sanchuanhehe/HSLink-LP/hardware/design/README.md

# HSLink-LP 硬件设计

打开 `HSLink-LP.kicad_pro`。唯一工作区基于固定 HSLink Pro 1.2.0 原图增改，参考仓库未修改；版本通过 Git 回溯。2026-11-14当前PCB全布线完成，完整DRC为0一般违规/0未连接/0parity；制造审阅数据含185个SMT位号和8个THT件，结构C已做当前模型检查。仍无生产放行或硬件验收；所选排线实际尺寸等缺项见[制造说明](../../docs/manufacturing.md)。

## 本次设计

- SW601 换为 Dailywell 2MD1T1B1M2QES-5；保留手动来源选择与第二极状态输入。
- VIO 改为 TLV75801 + MCP4726，删除第二套 TPS63811 与电感；主目标可调供电现用 TPS63810YFFR + TPS22950CDDCR。
- 仅保留K601一颗HFD2/005-S：COM接DUT、NO接来源、NC经1k及Q902放电。Vref采用DG2012EDL-T1-GE3，删除K901/Q901/D901和DUT_OUT分压/ADC连接；开关由USB供电。见[优化说明](../../docs/sense-discharge.md)。
- 删除 ADG4612 及其 12 V 升压电路；数字信号仍为四颗 FSA2466。
- 删除不再需要的 TCA9543A 及支路上拉，四个不同地址的 I2C 从设备直接共享总线；VIO DAC 使用 MCP4726A0T-E/CH。
- 本轮换用 Sunlord 三颗电感、WUSB3801、TPS7A2036、1206 输出电容及准确连接器；见 [JLC 设计检查](../../docs/jlc-design-review.md)与[物理引脚表](../../docs/jlc-pinmap.md)。
- 当前原理图204个电气位号（193采购件+11裸铜测试焊盘）；采购件沿用2026-11-07核价快照，板上材料¥124.9924/板；加配套排线¥128.8354/套、10套¥1,288.3540。见[成本](../../docs/cost.md)。
- J801改带键ARM20，nTRST第3针、nRESET第15针，删除J802；VTref/所有目标信号的隔离保留，供电走独立J602。见[接口说明](../../docs/arm20-interface.md)。
- 按用户确认采用 12 颗 SN74LVC1T45DBVR，SOT-23-6；24 颗去耦、13 颗偏置，删除旧 OE 与未用通道。40 MHz 保持待实测，见 [实施说明](../../docs/level-translation.md)。

新增供电、检测页按功能重新分组，器件位号／数值置于主体外，全局标签接短支线，检查两种字体下的实际图面。主控、晶振、启动／复位、主控电源与去耦仍沿用上游布局；34 个符号单元（33 个物理位号）位置和旋转与已记录的上游映射一致。

## 阅读顺序

| 页 | 文件 | 电路 |
|---|---|---|
| 1 | HSLink-LP | 主控、晶振、恢复接口和子页入口 |
| 2 | Power | 上游主控电源、USB 辅助 3.3/3.6 V |
| 3 | Interface | USB-C、CC、ESD、输入限流 |
| 4 | LogicTranslation | 电平转换与开漏复位 |
| 5 | Control | I2C GPIO、共享总线与默认下拉 |
| 6 | Safety | 硬件禁能与放电驱动互锁 |
| 7 | TargetPower | 内置可调输出、DAC/LDO VIO、来源选择、输出继电器 |
| 8 | Disconnect | FSA2466、调试和双串口目标接口 |
| 9 | Sense | 单通道模拟开关隔离Vref检测、受控放电 |

## 测试点

2026-11-12新增TP2～TP11，服务VIO外部校准、电源/故障和互锁时序；TP1保留。高速与目标侧敏感网络复用现有焊盘/接口，不增加长探测支线。原有连接保持，ERC 0错误/0告警；PCB已同步并手工连接10个新增点的局部端点；拆盖后D2mm探测包络无器件干涉，实际探头/装配公差仍待验证。详见[测试点规划](../../docs/test-points.md)和[板上特征表](../bom/pcb-features.csv)。

## 文件验证

2026-11-07 已原地统一为 **KiCad 10**：9 页原理图、2 个本地符号库、6 个本地封装完成原生格式检查/升级。转换前后完整网表一致，ERC 均为 **0 错误、0 告警**；九页图形、文字位置及样式不变。BOM、连接意图和上游参考未改。详见[格式转换记录](../../docs/kicad-integration.md#kicad-10-原生格式统一2026-11-07)及[验证摘要](../validation.json)。以下保留此前电路修改的检查记录；格式转换不关闭既有电气与实板验证问题。

2026-11-07：MCP最终ERC **0错误、0告警**，未增加忽略项。194物理位号、117连接网络、675连接引脚、45个独立NC与预先定义意图一致；58行BOM的位号、MPN、封装与10套阶梯金额已查。

基线8fb837e逐项变换：删除K901/Q901/D901/R55/R56/C62及ADC_VOUT/VOUT_SENSE_IN/SENSE_COIL_LO；U1.26标NC；新增U901和C901。DUT_VREF仅J801.1→U901.5，NO→整个68k/68k/1n采样；NC悬空。DUT_OUT仅J602.1/K601.4。K601/Q902、FSA、ARM20及互锁其余引脚集合完全不变，非实板验收。

双字体PDF各九页；本轮人工查看主控根页和Sense页，修正新电源符号文字与线重叠；其余七张源图与基线字节一致。摘要/哈希见[validation.json](../validation.json)，证据在忽略目录`reports/vref-only-2026-11-07/`。无DUT_OUT实测回读，输出精度、掉压和放电完成只能由外部仪器验证。

器件、连接、库和字段通过已安装 MCP 修改。标准工具对项目库封装临时放置/回读和自由文字编辑的支持缺口由一次性 MCP 适配器补齐；客户端、适配器和缓存用后删除，常驻 MCP 服务未修改。

## 尚未完成

- U501已绑定按原厂图建立的15球YFF封装，0.4mm逃线/钢网/DFM仍待完成；L4 已绑定更大的 MWSA0603S 封装；原有 MCU、FSA、连接器等仍须完整物理映射与 PCB/DFM 审查。
- 来源开关FAQ支持BBM、系列Q触点3A/28VDC覆盖需求；完整-5料号时序与首板双极转换/浪涌仍待确认。P1→P2和第二极改线是未批准建议，本轮保留型号/接线。
- 继电器微小电流、2A温升、浪涌及含续流的释放/抖动待测；Q902栅极掉电瞬态与OFF漏电未验收，50ms仅切换待测初值。MEASURE由K601 NC机械隔离放电，OFF仅MOS关断。
- U901 COM掉电保护不等于零漏电：数据表最大1µA；中间供电斜坡与20/25/30°C实际状态待测。
- 140 nA整夹具目标（20～30°C）未闭合；FSA的25°C上限和已140 nA、全温表值保守和700 nA，另有U901/线束/PCB。USB掉电而目标仍供电的FSA保护不在首版支持范围，连接目标信号期间须保持USB供电。
- VIO电流预算、精度、启动过冲及热待测；TPS63810启动3.3V需隔离编程；R42已改806Ω±0.1%低成本打样方案，典型限流约1.487A，无该档厂家保证上下限；逐板持续1A/过载/短路/温升投用前必验。
- 20cm配套排线的手册绝缘下限5MΩ不足以保证0.14µA；40MHz与漏电待实测，失败须换线束。
- 独立板型、双 CDC、WUSB3801 驱动、真实 HID、DAC 时序及 MEASURE 锁定尚未实现。

MEASURE 保持目标供电，同时断开调试、复位、双 UART 握手、Vref、采样与放电支路；默认保持共地。ERC 通过不等于允许投板。

## 许可

上游 HPM5301 及晶体缓存符号保留在 `libraries/UpstreamCache.kicad_sym`，原 Apache-2.0 许可保留为 `libraries/HSLink-upstream-LICENSE`。未修改 `hardware/reference/`。

2026-11-07边界同步：修正Power/Control/Disconnect三处旧说明，并补充连接目标信号时保持USB供电。重新导出网表/ERC及图面，电气连接未变；140nA、R42和VIO余量仍未验收。见[设计说明](../../docs/electrical-margins.md)。

VIO当前使用USB_5V→TLV75801，反馈10k/2.15k/15.4k；保持DAC和封装，逐板外部校准、±1%目标待验收。见[余量说明](../../docs/electrical-margins.md)。

## 2026-11-12布局重整

183个封装移动/旋转，保留全部逻辑焊盘网络；原生PCB/原理图一致性为0问题。完成关键电源与USB手工路径、安装孔禁布区、接口针序/极性丝印及结构装配模型。原理图ERC为0；PCB一般违规项列表为空，但另有399条未连接报告项，仍不可投板。见[布局约束](../../docs/pcb-layout.md)和[结构样件](mechanical/README.md)。

## 接口与测试点PCB继续整理

在上述布局基线上再调整96个已有封装，前沿从左至右为ARM20、UART A、UART B、DUT电源；调试和两组串口转换器按功能分组、去耦对齐。新增TP2～TP11及局部手工走线，当前211个封装（204个电气位号、4安装孔、3基准点）。一般几何违规0项、原理图parity0项，另有399条未连接，仍不可投板。该阶段源哈希和实际模型证据见`hardware/validation.json`的`layout_testpoint_continuation`，不把旧阶段记录当成当前整板通过结论。
