sanchuanhehe/HSLink-LP/docs/requirements.md

# 需求基线

更新日期：2026-11-12。来源：本项目对话中用户已选择的方案。

## 已确认

| 项目 | 要求 |
| --- | --- |
| 基础 | HSLink Pro 1.2.0 / HPM5301 |
| 形态 | 重新设计整板；用户选择结构 C：开放调试底座＋可拆透明盖。尺寸、材料及新增按键/指示灯未确认 |
| 串口 | 两路独立 CDC，均有 TX/RX、DTR/RTS |
| 电平 | 首版 1.8～3.3 V；用户为降低成本选择参考 Nordic FSA2466 |
| 电平转换实施 | 12 颗 SN74LVC1T45DBVR；按打样方案落实，40 MHz 保留为待实测验收目标 |
| 调试 | SWD/JTAG，40 MHz 为验收目标 |
| 目标调试接口 | J801 为带防反插结构的标准 ARM 20 针、配套排线；nTRST 第3针、nRESET 第15针；删除 J802，目标供电使用独立接口，保留所有目标信号断开链路 |
| VIO精度与校准 | 1.8～3.3 V 可调；优先低成本，接受逐板外部校准，精度目标 ±1%；未实测验收 |
| 内置供电 | 1.8～5.0 V，最高持续 1 A，可调压及开关 |
| 内置限流打样方案 | 用户接受保留TPS22950C、R42改806 Ω±0.1%的低成本方案；逐板持续1 A、过载、短路及温升为投用前必验项；806 Ω档无厂家直接保证的限流上下限 |
| 外部供电 | 1.8～5.5 V，最高 2 A，支持独立电源 |
| USB | 单 USB-C，供电不足时限制内置输出功率 |
| 首版支持边界 | 目标信号连接期间调试器保持 USB 供电；不支持调试器 USB 掉电而目标板仍供电的 FSA 保护工况，不为此单独增保护或换 FSA；不是电路已具备掉电保护 |
| 测量 | 外部供电测量一体仪器；具体型号未指定 |
| 断开器件 | 信号优先参考 Nordic 同款 FSA2466；Vref/采样/放电另做电压与漏电审查 |
| 漏电目标 | 25±5°C 时，测量状态的整夹具附加电流 ≤140 nA（0.14 µA），未实测验收 |
| 主机工具 | Mac 命令行工具＋Python 库 |
| 电源来源选择 | 板上手动切换；内置／外部两路均保留电脑控制输出通断 |
| 机械继电器 | 接受轻微声音与毫秒级切换；保留供电继电器K601并复用NC隔离放电，优先降低成本 |
| 检测/放电优化 | 用户确认保留Vref 1.8～3.3V检测，用模拟开关隔离完整分压；取消DUT_OUT电压回读。供电范围不缩小，内/外来源选择、电脑通断和显式放电保留；启动/复位/USB掉电不得主动放电 |
| 成本口径 | 人民币，10 套打样；元器件、PCB、贴装与其他费用分别列出 |

当前原理图仅保留K601一颗继电器；Vref由U901 DG2012EDL-T1-GE3隔离，删除K901/Q901/D901及DUT_OUT专属分压/ADC连接。供电与放电原拓扑保持。只完成资料、文件和图面检查，整夹具140nA等目标仍未验收；见 [优化说明](sense-discharge.md)。本板不提供DUT_OUT实测电压，设定值、寄存器回读与Power Good均不得冒充实测值。

## 默认假设与待确认项

- 保留共地；本项目不构成电气隔离设备。
- 两路串口连接同一目标板，默认共用 Vref。多电压域需求尚未确认。
- 原理图中所有供电、检测、保护支路均需纳入漏电检查。
- 外部仪器型号、控制接口和负载瞬态条件仍需在仪器适配阶段确定。
- PCB 当前工作尺寸110×80mm、四层、名义1.6mm；原90×60mm假设已由接口/布局工作尺寸替代，仍是待装配/布线确认的工程方案。≤10 cm 短线保留为时序基准；本轮选用的现货 ARM20 排线为 20 cm，属于打样选型，并非用户确认线长。增加该配套排线的 40 MHz 与总夹具漏电验收，未通过则重选线束；不降低指标。
- VIO 100 mA 为首版负载预算假设，热与动态负载待验证。
- 双串口同时 3 Mbaud / 8N1 是建议的首版性能验收基线。
- 40 MHz 是目标，不是已实现能力；测试目标本身必须支持该时钟。

## 指标定义

“≤140 nA（0.14 µA）”指目标板保持供电、夹具正常上电、全部信号和检测支路断开时，相比物理拔掉相应信号连接的附加电流。比较时保持相同目标端电压，记录温度、湿度、仪器量程与测量不确定度。

电源关闭漏电和高温漏电分别记录，不套用正常测量状态的指标。首版不支持目标信号仍连接且目标板仍供电时调试器 USB 掉电的 FSA 保护工况；这是用户接受的使用限制，非保护已实现。启动、复位与继电器/放电默认关闭约束仍保留。

用户确认USB支持边界、140nA目标，以及VIO优先低成本、逐板外部校准、±1%精度目标；未缩窄20～30°C温区，未同意700nA目标。VIO具体电阻选择属于工程方案，不等同于用户逐个指定料号或硬件验收；R42的806Ω低成本打样与投用前实测门槛已获用户接受，1.10～1.90A具体筛选窗口仍是工程建议。SW601识别极改线未实施。

## 第一版交付

KiCad 工程、BOM 和生产文件；独立板型的固件与 Bootloader；Mac 构建说明；CLI/Python 库；外部仪器适配接口；验收报告。当前已有基于上游布局的降本原理图审阅稿与候选 BOM，仍未进入投板、固件联调或硬件验收。

VIO精度目标±1%、逐板外部校准已确认；限流保证窗口和负载瞬态/电容条件仍待闭合。不能用校准承诺覆盖硬件调节范围不足。现状、计算候选和证据缺项见[余量与边界说明](electrical-margins.md)。

结构与工具方案见[结构 C 与 PCB](structure-and-pcb.md)。第一轮分模块SPICE结果见[功能仿真记录](spice-validation.md)，不替代40MHz、140nA、1A与VIO±1%实板验收。

## 2026-11-12 分析状态（不新增用户确认）

投板前VIO启动/异常、Vref采样保持、供电/放电时序及软件测量锁参考模型分析见[专项记录](prefab-analysis.md)。本文既有1.8～3.3V/逐板外部校准±1%、内置持续1A、40MHz和140nA/20～30°C目标均保持。10ms/100µs/5ms、ADC400µs及1ms等为工程试验初值，不是已验证要求；实际固件/HID、PCB和结构仍未完成验收。

## 2026-11-14 CAD交付状态（不新增用户确认）

PCB布线、完整DRC/网表一致性和当前结构C尺寸模型检查已完成；已生成并独立回读制造审阅数据。资料缺少CBL801实际插头外形与弯曲参数，材料/完整紧固件选型、工厂DFM/贴装方向及实板性能尚未验收。40MHz、持续1A、140nA/20～30°C、VIO±1%与使用支持边界不变；详见[制造与装配记录](manufacturing.md)。本节仅同步工程状态，不将模型/参数或包络写作用户确认或硬件验证。
