sanchuanhehe/HSLink-LP/docs/jlc-design-review.md

# 嘉立创换料设计检查

> 本文保留采购阶段的分析。当前VIO已在2026-11-07改为10k/2.15k/15.4k反馈、USB_5V输入；R42随后按用户接受的低成本打样方案改806Ω±0.1%。旧200k/P3V6_SW及R42=1.15k说明仅为历史基线，当前投用前实测门槛保持。最新选择、成本与待实测项见[余量说明](electrical-margins.md)。

2026-11-07。已落实到同一份 `hardware/design`，历史在 Git；本轮为数据手册、库映射和原理图软件检查，没有投板或性能验收。成本采用 [本次 JLC 记录](cost.md)，逐脚证据见 [jlc-pinmap.md](jlc-pinmap.md)。

## 实际采用

|位号|原方案 → 本轮型号|改动和边界|
|---|---|---|
|L1|SRN4018-4R7M → SPH4018H4R7MT，C98400|保持 4.7 µH，改用按厂家 land 建立的 SPH4018 封装|
|L2|SRN4018-2R2M → SPH4018H2R2MT，C370436|保持 2.2 µH，同系列新封装|
|L4|XFL4015-471MEC → MWSA0603S-R47MT，C408439|保持 470 nH，绑定标准 Sunlord MWSA0603S 封装，体积增大|
|U101|TUSB320LAIRWBR → WUSB3801Q-12/TR，C2931342|新符号和 QFN1616-12L land；pin5 从 GND 改接 P3V3；R9 从 900k 改为 0 Ω|
|U402|未核实可订购的 TLV75536PDBVR → TPS7A2036PDBVR，C2873626|改正为可采购 3.6 V / 300 mA 型号；五个物理脚映射一致，连接不变|
|C40/C41|未指定 47 µF / 10 V / 0805 → Samsung CL31A476MPHNNNE，C96123|改为 1206 / X5R；不能只改 BOM 名称|
|J601/J602|未指定型号的 Phoenix land → KF128-5.08-2P-AA，C474952|按 KEFA 图建立通孔封装，保持正/地脚号|
|J1/J803/J804|通用排针 → XFCN PZ254V-11-06P / -05P|标准 2.54 mm land 保留；具体针长和额定值已核对|
|J802/J801（历史）|当轮B-2100S02P-A110 / ZX-PZ1.27-2-5PZZ，现已替换|当前J802删除、J801为带键ARM20；见[接口说明](arm20-interface.md)|
|普通阻容|落实准确 MPN、容差、额定和 JLC 编号|100 nF 35 颗；普通 100k 31 颗；10k 7 颗；0.1% 反馈/采样电阻另计，未混入普通电阻|

R9 为有意元件值变更。R57 从原泛化的 0.125 W 规格落实为 0603WAF1001T5E 的实际 0.1 W：5.5 V、1% 低阻端 990 Ω 时峰值约 30.56 mW，在厂商额定功率适用温度内有余量；高温降额和异常状态仍需验证，不能继续将采购件写成 0.125 W。精密电阻仍为 ±0.1%、±25 ppm/°C，未改为普通 1%。唯一跨网的物理脚移动为 U101.5：GND→P3V3；U101.4 的自动网名从 VBUS_DET 变为 VBUSD，R9.2 与 U101.4 的物理连接不变。其余纯换料保持连接。芯片可见字段仍采用简短值与原布局，完整 MPN/LCSC/规格/验证状态放入隐藏属性。

## 电感计算与局限

[Sunlord SPH 系列](https://www.sunlordinc.com/uploads/files/20221122/SPH%C2%A0series%C2%A0of%C2%A0SMD%C2%A0Power%C2%A0Inductor.pdf) 2022/05/15，p2～3：4R7 的 DCR 最大 84 mΩ、典型 70 mΩ，表列饱和电流 2 A/典型 2.2 A，温升电流 1.7 A/典型 2.1 A；2R2 为最大 50 mΩ、典型 42 mΩ，饱和 3 A/典型 3.4 A、温升 2.2 A/典型 2.9 A。厂家表的 Max/Typ 条件不等同整机温升或故障保证。

与原 [Bourns SRN4018](https://www.bourns.com/docs/product-datasheets/srn4018.pdf) 比较，L1 的 DCR 与饱和值相当，但温升电流 1.7 A 低于原 1.9 A。HPM5300 数据表建议核心电感 2.2～10 µH、典型 4.7 µH；没有足够的核心峰值限流资料可证明全部异常工况，因此需要实测上电、最大运算/USB 负载及短路恢复电流。不得拿 DUT 的 1 A 指标当作主控电感负载。

L2 用于 [TLV62568](https://www.ti.com/lit/ds/symlink/tlv62568.pdf) 的 3.3 V / 1 A buck。按 Vin=5.5 V、Lmin=1.76 µH、典型 fs=1.5 MHz：

```
ΔIL ≈ Vout × (1−Vout/Vin)/(L×fs) ≈ 0.50 A
ILpeak ≈ 1 A + ΔIL/2 ≈ 1.25 A
PCu(1 A) ≤ I²×DCRmax ≈ 50 mW（未含热增阻及纹波项）
```

手册只给典型开关频率/限流值，因此这是选型初算，不是保证最坏值。2R2 的饱和与温升额定留有余量，仍需验证启动、限流、布局和热。SY8089AAAC 的 JLC 报价反而高于现用 TLV62568 的 ¥0.457，撤回该换料建议。

[Sunlord MWSA 资料](https://atta.szlcsc.com/upload/public/pdf/source/20250613/CEE4AE5EC9F7EB97495A767C9ECB8960.pdf) 2025/05/29，p2/p6：L4 为 470 nH±20%，DCR 最大 4.1 mΩ，表列饱和电流 16 A/典型 20 A、温升电流 16.5 A/典型 18 A；不能把这些典型/测试条件数值写成 PCB 保证。[TPS63811](https://www.ti.com/lit/ds/symlink/tps63811.pdf) 开关限流最高可达 6.5 A，选型按开关电流审查，而非只按输出 1 A。6.5 A 下仅名义 DCR 的 I²R 估算约 0.173 W，正常 1.6 A 时约 0.0105 W；尚未含磁芯 AC 损耗、DCR 热漂及实际 RMS 波形。约 2 MHz 下的磁芯损耗与启动/短路/输入下降时峰值，需波形和温升验证。

新 L4 为约 7×6.6×2.8 mm，原约 4×4×1.5；PCB 尚未设计，必须让电感靠近开关脚、缩小 LX 高 dv/dt 环路、保证地与输入/输出去耦，不能称直接贴换。

## 输出电容

[Samsung CL31A476MPHNNN 产品页](https://product.samsungsem.com/mlcc/CL31A476MPHNNN.do) 的对应型号为 CL31A476MPHNNNE：47 µF±20%、10 V、X5R、1206，额定温区 −55～85°C。TPS63811 对 >3.6 V 输出建议 2×47 µF / 10 V，最小有效输出容量要求 16 µF。

厂家 25°C 典型 DC-bias 曲线在 5 V 约下降 60.99%，两颗剩约 `2×47×0.3900732=36.67 µF`。再作容差 ×0.8、温度 ×0.85 的示例下界估算约 24.93 µF；5.5 V 点同样估算约 22.56 µF。**曲线是典型值，乘容差不是厂家的全条件保证**，老化、测量 AC 电平和温度叠加尚未闭合。首板测实际有效容量、纹波、负载阶跃、起停和全输出范围稳定性，未通过则改容值/数量后重新核价。

其余 22 µF、10 µF 从未指定的 6.3 V 器件落实为 10 V Samsung 0603；4.7 µF 为 CCTC TCC0603X7R475K100CT、10 V、±10%、X7R，依据 DRAAW108N/0（2025/01/16）命名、容量表及尺寸图。没有把 X7T 替代 X7R。各电源节点仍需要 DC 偏压有效容量校核，不能认为“耐压升级”自动证明稳定性。Y1 的 12 pF 采购候选配两颗 15 pF 时等效 7.5 pF 加寄生，匹配要求寄生约 4.5 pF；起振和频偏尚待验证，不更改晶振电容来迎合未经实测的寄生估计。

## 3.6 V 轨与 VIO

[TPS7A20](https://www.ti.com/lit/ds/symlink/tps7a20.pdf) 的 DBV 脚号 1=IN、2=GND、3=EN、4=NC、5=OUT，与此处原功能布局一致。3.6 V±1.5% 为约 3.546～3.654 V；高于 3.3 V 信号，低于 FSA2466 推荐最高供电 4.45 V。TLV758 在 500 mA 的最大压差规格约 130 mV，3.546−3.3=246 mV 的静态余量可用，但仍要纳入瞬态和走线压降。

U402 能力为 300 mA，VIO 100 mA 仍是设计假设；Vin=5.5 V、100 mA 时 U402 约 0.19 W，满 300 mA 约 0.57 W，后者不在未经热设计的 SOT23 板上默认批准。现有输入 1 µF、输出 10 µF 名义值满足手册起点，实际有效容量需大于最低稳定要求并复核 ESR。器件及 FSA/VIO 的辅助耗电始终在 USB 侧。

MCP4726 暂不换 PWM。两级各 10k/100n 的无缓冲滤波器在不加载时 `H(s)=1/(s²τ²+3sτ+1)`、τ=1 ms，100 kHz 高频抑制很好，但直流戴维宁电阻为 20k。经 R60=200k 接到约 0.55 V 的 FB 后：

```
Vinject ≈ (200k×VPWM_avg + 20k×0.55)/(220k)
```

相对原 DAC 改变增益约 9.09%，带偏置，不能用“两电阻两电容 ¥0.1438”直接替换。还需校核 PWM 电源误差/量化、启动高阻状态、缓冲运放的轨到轨/失调、纹波及建立时间，重新设计标定和故障状态。完整净收益未验证，保留 ¥6.87 DAC。现有拓扑和测量锁要求见 [cost-down.md](cost-down.md)。

## USB-C 控制与固件变化

[WUSB3801 Rev1.1](https://atta.szlcsc.com/upload/public/pdf/source/20220218/358FA27FD5CA391EB61300BD5A69029B.pdf) p3～4/p11～13：ROLE=GND 选择 Sink，ENB=GND 使能；CTRL=P3V3 选择 7 位地址 **0x68**。CTRL=GND 则为 0x60，会与 MCP4726A0 冲突，不能照搬原 TUSB 的接地地址脚。VBUSD 有高压容限且需直接检测 VBUS，原 TUSB 的 900k 串阻不适用，本轮 R9 改 0 Ω。

保留 CC1/CC2 接口和原 USB 侧保护，没有额外并联 Rd；不实现 USB PD，也不意味着默认能从任何 USB 口取 3 A。

|寄存器|适配要点|
|---|---|
|0x01 Device ID|版本位与 vendor 位组合示例 0x16；驱动须核对实际版本，而非无条件继续|
|0x02 Control|bit2:1=00 Sink；bit0 中断控制；bit7 附件支持；读改写保留保留位，不沿用 TUSB 寄存器值|
|0x03 Interruption|读/清除 attach/detach 状态；读取、清中断与再次读取状态配合，避免丢事件|
|0x04 CC Status|bit7 VBUS；bit6:5=00待机/01默认/10为1.5 A/11为3 A；bit4:2 对端状态；bit1:0 朝向|

固件必须替换 TUSB 驱动并重新建立 CC 可用电流、USB 枚举/挂起许可、板载辅助功耗和目标电源效率的联合预算；通信失败/未附着/状态不可信时禁止 DUT 供电并退回安全输入限制。继电器线圈、双 UART、VIO 和 MCU 的功耗不得漏计。CC 电流广告只表示上游能力，不能绕过 USB 的枚举和挂起限制。MEASURE 不能被 CC 更新自动解除。

这些是待实现的独立板型固件要求；本轮不冒充驱动已经实现。原理图硬件和地址说明已更新，主机仍无真实 HID 传输。

## 未采用与未关闭

- 电平转换：按用户确认落实 12 颗 SN74LVC1T45DBVR、24 颗去耦和 13 颗偏置；删除 U305/C32 与旧未用通道。40 MHz 保持待实测目标，详见 [实施说明](level-translation.md)与[上游时序依据](upstream-swd-timing.md)。
- 更廉价来源开关：无通过 DC 电流、接触电阻和 BBM 校核的准确型号，不计收益。
- 当轮FSA四颗¥8.64、继电器三颗¥17.49属于历史核价；随后利用K601常闭触点删除K902，该阶段两颗继电器¥11.86；本轮仅保留K601一颗¥5.93，Vref改DG2012E，见[检测与放电优化](sense-discharge.md)，不重复计算历史预算修正收益。
- TCA9543A 已在基线删除，本轮没有重复计算删除收益。
- 原11位号采购缺口已通过现货替代补齐：见 [采购补齐](procurement-completion.md)。U501已改TPS63810并绑定YFF，U502改DRV，U503纠正为C版；并未因此关闭实板验收。
- 手动选择、独立/内置供电、电脑通断、全部信号/检测/放电隔离均保留。40 MHz、140 nA（20～30°C）、1 A/2 A、来源转换确认、继电器释放与低负载可靠性仍待验收。首版不支持USB掉电而目标仍供电的FSA保护；不再仅为该工况加保护或换FSA，放电默认关闭约束不变。

本文前述换料为历史阶段记录；当前完整采购型号、数量和成本以BOM与 [cost.md](cost.md)为准，当前100nF共50颗、普通100k共41颗。
