sanchuanhehe/HSLink-LP/docs/arm20-interface.md

# ARM20 接口与配套排线

2026-11-07，按用户要求以带键传统 ARM 20 针替换 J801，删除 J802；目标供电继续使用独立 J602，不经调试排线。

## 定义与隔离

采用 **2×10、2.54 mm** 的传统 ARM JTAG20 接口，不是 1.27 mm Cortex Debug+ETM20。标准定义参考 [Arm CoreSight IHI0029D D3.2](https://documentation-service.arm.com/static/5f9009d5f86e16515cdc0417)，探针侧供电/保留脚兼容边界参考 [SEGGER 20-pin 接口](https://www.segger.com/products/debug-probes/j-link/technology/interface-description/)。本工程没有实现 RTCK 自适应时钟、DBGRQ/DBGACK。

- 1脚 VTref → DUT_VREF → U901.COM(5)→NO(6) → VREF_SENSE_IN → 原分压/ADC。不接 P3V3、VIO_LOCAL、DUT_OUT 或任何供电输出；NC(4)悬空，开关前没有分压/保护支路；检测仍由 SENSE_ON 控制，在 MEASURE 状态断开。VTref 是目标逻辑电压参考，1.8～3.3 V；独立DUT电源可能更高，不能将5V板端电源误当3.3V逻辑参考。
- 3脚 nTRST → DUT_NTRST → U804的3/4脚开关通道 → F_NTRST → Q702开漏；15脚 nRESET → DUT_NRST → U804的15/1脚 → F_NRST → Q701开漏。两个复位不短接，不新增目标侧上拉；低电平由开漏拉低，高电平由目标侧形成。RESET_ON断开覆盖保留。
- 5/7/9/13脚分别为TDI、TMS/SWDIO、TCK/SWCLK、TDO/SWO，仍通过U801的原FSA通道；DEBUG_ON断开覆盖保留。
- 2脚NC，不与1脚短接，也不接USB/VIO/目标电源。11脚RTCK未实现，保持NC而非接地，避免对目标输出形成负载。17脚DBGRQ与19脚DBGACK/厂商可选供电脚均NC，无下拉、ESD或供电支路。
- 4、6、8、10、12、14、16、18、20共九个GND脚接现有共地；不能用这些地脚传递独立低侧电流测量而忽略USB共地旁路。保持项目原来的共地假设。
- 不新增UART或复位控制命令。调压、打开CDC、DTR/RTS、DAP均不得解除测量锁，真实控制协议/固件仍未实现。

## J801 型号与逐脚封装映射

采用 BOOMELE `2.54-2*10P简牛`，嘉立创 [C3405](https://www.jlc-smt.com/lcsc/detail/C3405.html)，黑色护套、中心防反插键槽、直插20针。厂家图 [BX2.54-2xNA，单页，未标修订日期](https://atta.szlcsc.com/upload/public/pdf/source/20220902/F4C4645E59EE38C0F12B225613E1076A.pdf)：N=10，外长33.02±0.3、宽8.9±0.2、内长30.72±0.3、内宽6.35±0.2、键槽4.5±0.1、针距/行距2.54、方针0.64、焊脚3.0±0.2、建议孔1.0 mm。

符号 `Connector_Generic:Conn_02x10_Odd_Even`；封装 `Connector_IDC:IDC-Header_2x10_P2.54mm_Vertical`。20物理针=20符号脚=20PTH焊盘，无额外机械孔、重复焊盘或金属屏蔽。厂家图用三角标记起始端，没有逐一印出全部针号；此表按ARM20插合面定义编号，先将厂家键槽朝下、三角起始端在左的顶视图旋转90°到库坐标：键槽朝左、1脚在左上。奇数列向下、偶数列向下。不要用插头母座的正视图直接套到PCB顶视；母座插合面要镜像对合。

已通过安装的MCP查询符号与20焊盘列表，再由一次性MCP适配器逐焊盘读回、临时放置/导出检查。标准库本体33.56×8.9 mm，长于厂家标称0.54 mm；courtyard34.06×9.9 mm对厂家最大外形保留余量，最终外壳与排线插拔空间仍要DFM。电流额定值不用于证明本接口可给DUT供电。

|物理针/符号脚/焊盘|功能|局部X/Y mm|焊盘/孔径 mm|角度/层|观察方向|
|---|---|---|---|---|---|
|1/1/1|VTref / DUT_VREF|0.0/0.0|1.7×1.7 / 1.0|0.0°；*.Cu + F/B.Mask|元件顶视，键槽左、1脚左上|
|2/2/2|NC / VSupply保留|2.54/0.0|1.7×1.7 / 1.0|0.0°；*.Cu + F/B.Mask|元件顶视，键槽左、1脚左上|
|3/3/3|nTRST / DUT_NTRST|0.0/2.54|1.7×1.7 / 1.0|0.0°；*.Cu + F/B.Mask|元件顶视，键槽左、1脚左上|
|4/4/4|GND|2.54/2.54|1.7×1.7 / 1.0|0.0°；*.Cu + F/B.Mask|元件顶视，键槽左、1脚左上|
|5/5/5|TDI / DUT_TDI|0.0/5.08|1.7×1.7 / 1.0|0.0°；*.Cu + F/B.Mask|元件顶视，键槽左、1脚左上|
|6/6/6|GND|2.54/5.08|1.7×1.7 / 1.0|0.0°；*.Cu + F/B.Mask|元件顶视，键槽左、1脚左上|
|7/7/7|TMS/SWDIO / DUT_SWDIO|0.0/7.62|1.7×1.7 / 1.0|0.0°；*.Cu + F/B.Mask|元件顶视，键槽左、1脚左上|
|8/8/8|GND|2.54/7.62|1.7×1.7 / 1.0|0.0°；*.Cu + F/B.Mask|元件顶视，键槽左、1脚左上|
|9/9/9|TCK/SWCLK / DUT_TCK|0.0/10.16|1.7×1.7 / 1.0|0.0°；*.Cu + F/B.Mask|元件顶视，键槽左、1脚左上|
|10/10/10|GND|2.54/10.16|1.7×1.7 / 1.0|0.0°；*.Cu + F/B.Mask|元件顶视，键槽左、1脚左上|
|11/11/11|NC / RTCK未实现|0.0/12.7|1.7×1.7 / 1.0|0.0°；*.Cu + F/B.Mask|元件顶视，键槽左、1脚左上|
|12/12/12|GND|2.54/12.7|1.7×1.7 / 1.0|0.0°；*.Cu + F/B.Mask|元件顶视，键槽左、1脚左上|
|13/13/13|TDO/SWO / DUT_TDO|0.0/15.24|1.7×1.7 / 1.0|0.0°；*.Cu + F/B.Mask|元件顶视，键槽左、1脚左上|
|14/14/14|GND|2.54/15.24|1.7×1.7 / 1.0|0.0°；*.Cu + F/B.Mask|元件顶视，键槽左、1脚左上|
|15/15/15|nRESET / DUT_NRST|0.0/17.78|1.7×1.7 / 1.0|0.0°；*.Cu + F/B.Mask|元件顶视，键槽左、1脚左上|
|16/16/16|GND|2.54/17.78|1.7×1.7 / 1.0|0.0°；*.Cu + F/B.Mask|元件顶视，键槽左、1脚左上|
|17/17/17|NC / DBGRQ保留|0.0/20.32|1.7×1.7 / 1.0|0.0°；*.Cu + F/B.Mask|元件顶视，键槽左、1脚左上|
|18/18/18|GND|2.54/20.32|1.7×1.7 / 1.0|0.0°；*.Cu + F/B.Mask|元件顶视，键槽左、1脚左上|
|19/19/19|NC / DBGACK或厂商5V保留|0.0/22.86|1.7×1.7 / 1.0|0.0°；*.Cu + F/B.Mask|元件顶视，键槽左、1脚左上|
|20/20/20|GND|2.54/22.86|1.7×1.7 / 1.0|0.0°；*.Cu + F/B.Mask|元件顶视，键槽左、1脚左上|

## 配套排线

配件 `CBL801`：XFCN `CL2542320200BC10E`，嘉立创 [C7496759](https://www.jlc-smt.com/lcsc/detail/C7496759.html)。两端均为2.54 mm、2×10P三件式IDC母头，带极化凸键和折返压线卡扣；20芯UL2651/28AWG、导体间距1.27 mm。**母头接点间距2.54 mm与线芯间距1.27 mm不能混为一谈。** 配件单独计入 `hardware/bom/accessories.csv`，不是板上焊接位号或SMT换料项目。

[厂家图，2023-07-05，单页](https://atta.szlcsc.com/upload/public/pdf/source/20240110/976CA9EBFC80C4582DD9358FE4D13126.pdf)列出2个IDC插头和2个压线卡扣；标题“L=200mm不含插头”指线段长度不计连接器，不能解释为不带接头。尺寸200±10 mm，两端同向，红边指1号导体，P1的1～20逐根直通P2同号，无交叉/并接。图中的母座插合面1在右上、2在左上；与板端公针顶视相对插合后同号接触，防反插凸键进入J801中心槽。

规格资料接受其针数、直通关系及名义IDC插合形式；跨厂家键槽配合公差、插拔力、接触可靠性须来料实物确认。逐根1↔1至20↔20导通测试，并检查任意不同针间无短路，再接目标板。

这条现货排线为20 cm，长于此前≤10 cm的默认试验假设。保持40 MHz目标，必须增加20 cm配套排线的SWD读回/换向、JTAG、眼图/过冲/串扰实测；未证明20 cm在40 MHz下可用，不将其供货状态当时序保证。

**低功耗采购门槛：** 排线手册只承诺绝缘电阻≥5 MΩ。以3.3 V/5 MΩ作保守示例为0.66 µA，已高于整板0.14 µA目标，且实际多导体泄漏不由这一个比值完整描述。因此这条线属于打样配套、尚未通过低漏电验收，不作合格量产线束放行。必须在25±5°C、记录湿度/清洁度下，比对排线接入与物理拔线的附加电流；覆盖VTref及目标高电平到全部接地芯线，确认总夹具≤0.14 µA。若不满足，需更高绝缘规格的短线或定制线束，并重新核价，不能降低漏电要求。J801手册绝缘≥1000 MΩ同样不等于整板保证。

## 核价与待测

J801按10个用量，1+档¥0.893，页面库存46203；CBL801按10条用量，10+档¥3.843，库存623。2026-11-07读取嘉立创自营含税阶梯价，库存未预留。连接器+排线¥4.736/套，10套¥47.36。删除原J801¥0.466及J802¥0.17后，板上材料净增加¥0.257/板；加配套排线后套件材料比之前无排线基线增加¥4.10/套。不是降本收益。

2026-11-14已有当前PCB和结构C装配文件，CAD布线及制造数据检查见[制造说明](manufacturing.md)。原始配套排线图缺少插头外形尺寸；工程包络不能当作所选插头通过。此处封装映射/网表/图面检查不等于生产DFM。两种字体实际导出、ERC和新增NC/接地网络比较结果见 `hardware/validation.json`。接口上没有新增供电连接，但排线绝缘、正常上电FSA漏电及40 MHz仍须分别验证。连接目标信号期间保持调试器USB供电；USB掉电而目标仍供电的FSA保护属于首版已接受使用限制，不是已经实现保护。

- 证据 `C3405.pdf` SHA256：`ce3f2a7666262e53fa9d4739e312256712b0c50f0d5c5b11ee67a205f7b23967`。
- 证据 `C7496759.pdf` SHA256：`9b780485ebca104df799a4d33b55eb23fdf0c07f0917127e247751053e05de3b`。
- 证据 `arm20-pads.json` SHA256：`03ea52d2d2132c58507c5bd803e7168dec1cbaca00932b8f3c1c352d7dd970df`。

## 2026-11-14 排线机械资料与替代复查

用户反馈目前没有实物；这是样件可用性信息，不是同意省略装配检查、换线束或接受假设尺寸。当前CBL801与PCB/结构均保持。

|调查对象|采购资料状态|机械/完整方案缺项|采用结果|
|---|---|---|---|
|BOOMELE 2.54-2*10P压线头，C20346|公开页面显示缺货，仅预订参考价；未在浏览器确认当前现货|裸压线头，不是成品排线|未采用|
|ZHOURI FC-2.54-20P，C2977597|公开页面显示缺货，仅预订参考价；未在浏览器确认当前现货|裸压线头，不是成品排线|未采用|
|LX XDFH-0258-2*10P，C53309339|本次浏览器看到SMT库217个；1+档含税¥1.224/个，20个仍属该档|有零件尺寸图，缺成缆整体/插合总高、线规接受范围、线材与压接报价及非焊接配件交付确认|候选，未采用|

LX图A0的2×10尺寸为A30.00mm，主体A±0.20、盖/应力释放件A±0.30，B22.86±0.15、C24.13±0.15；主体深6.0、凸键伸出0.90、主体高7.0、IDC齿高2.40、压盖高3.50及应力条厚1.30mm。它给的是三个未装配零件视图，不能简单把这些尺寸相加就声称已经得到正确的压接后/插合高度，也不能将别家的尺寸套给现用XFCN成品线。1.27mm排线导体间距与2.54mm插合针距仍分别核对。

若自行压线，两端接头裸料小计¥2.448/套、¥24.48/10套；**不是完整排线成本**，不含未核齐的线材、损耗、压接、检验或交付费用，不计降本收益、不改现有BOM总价。商品页标注SMT库用途，尚未确认这些非板上焊接件是否可以作为随单配件交付；不要把目录库存当成已完成采购。接触/绝缘的手册测试条件也不能替代20～30°C整夹具140nA及40MHz验收。

来源：[C20346](https://www.jlc-smt.com/lcsc/detail/C20346.html)、[C2977597](https://www.jlc-smt.com/lcsc/detail/C2977597.html)、[C53309339](https://www.jlc-smt.com/lcsc/detail/C53309339.html)。官方商品页给出的厂家PDF、截图与时间/哈希保存于忽略的`reports/cable-mechanical-review-2026-11-14`。未对缺货件参考价作10套现货报价。本轮网页PDF下载接口没有返回可用文件，随后从已观察到的公开厂家PDF链接取得并渲染，未上传文件、联系供应商或采购。

装配检查仍缺可靠的成品排线最大外形及插合/出线参数，或可测量样件。当前34×12mm试探包络不能替代这些证据；当前结构C的孔位/模型干涉检查仍有效，完整实物插拔检查仍未完成。
