sanchuanhehe/HSLink-LP/docs/pcb-layout.md

# PCB 布局与布线约束

2026-11-14。当前PCB布线完成：一般DRC违规0、未连接0、原理图一致性错误0；759个焊盘网络保持，211个封装保留。当前CAD结果不代表生产放行或硬件性能验收。最新范围、较长Vref/控制路线及检查边界见[控制与模拟布线](control-analog-routing.md)；下文历史数量仅适用于其日期和源哈希。

2026-11-14制造数据复核：U501补SMD属性、SW601/K601补THT属性，几何/焊盘网络及约束保持；最终坐标覆盖185个SMT，另列8个THT。当前制造数据与结构检查边界见[制造审阅](manufacturing.md)。

## 分区与结构

工作板框110×80mm、四层、名义1.6mm，R2圆角；四个M3孔位为(4,4)、(106,4)、(4,76)、(106,76)mm。尺寸为当前工程方案，不是用户新增确认。底座/盖板共用相同孔位和PCB原点，源参数见`hardware/design/mechanical/parameters.json`。

- 后侧：USB-C、CC识别及输入保护；外部供电端子和手动来源开关。
- 中部：HPM5301及晶振/去耦；右上为3.3V、VIO和目标电源，电感及输入/输出电容靠近相应芯片。
- 前侧：ARM20、UART A、UART B和独立DUT供电。两组串口的转换器/去耦成组放置；FSA靠近接口侧。复位及Vref隔离仍保留。
- Vref的U901靠近接口，R53/R54/C61靠近MCU ADC；采样网络与开关电源分区。布局本身不证明140nA指标。
- 四个螺柱周围半径3.75mm为四层铜箔、走线和过孔禁布区；安装孔及其机械封装保留。插头插拔、拨杆操作和线缆弯曲仍需实物确认。

## 手工布线与规则

信号线按水平/垂直与45°转折整理，尽量合并碎线段并保持同组线条一致。2026-11-13已整理23段不规则信号斜线；不能为美观破坏关键回路、间距、参考面或连接。局部正交拐角和进焊盘方式仍随最终布线人工收尾，详见控制布线记录。

已撤销原宽范围自动布线试跑的结果，未导入其SES。本轮保留的走线为明确坐标和网络的手工路径。USB、电源、晶振、调试、双串口和模拟检测不得交给全板自动布线；若后续使用自动布线，只能显式选择普通低速Control网络，并重新做完整DRC和关键回路审查。

当前已手工连接：USB D+/D−及ESD路径，USB输入保护/5V主干，U501/L4/C39/C40/C41/C42/U503局部电源，外部/来源/DUT干线，K601 NC放电路径，U401局部开关电源，U502局部反馈/去耦，12颗转换器的本地去耦及ADC分压/滤波局部连线。清单不表示上述模块全部引脚已经布完。

- F.Cu/B.Cu用于信号及电源；In1.Cu、In2.Cu保留GND参考铜面，自定义规则禁止内层走线。通孔焊盘/过孔的反焊盘仍会占用参考面，不能把“禁止内层走线”称为绝对完整平面。
- 全局最小间距/线宽0.127mm；普通通孔过孔0.60/0.30mm，最小孔径0.30mm；铜到板边0.25mm。细间距封装逃线和厂家DFM仍需复核。
- `EXT_INPUT`、`SOURCE_POWER`、`DUT_OUT`干线自定义最小线宽1.2mm，当前主段采用1.5mm；USB_5V主干1.2mm。芯片引脚局部收窄按实际焊盘安排，不能仅凭主段宽度保证整条路径1A/2A。
- Debug/UART/Analog/SwitchPower/Crystal等分类已保存；分类不是布线验收。
- 密集处部分被动件位号隐藏于顶层丝印，以免压焊盘；所有封装保留装配层位号。接口针序、供电极性和保持USB供电的使用限制已标注。拨杆INT/EXT实际方向仍需样品导通核对，当前仅标来源选择名称。

## USB 专项

原试跑存在D+两次换层、D−不换层的不对称路径。现两条信号均为F.Cu、0个信号过孔；ESD直接置于信号路径，短接地支路设地过孔。

USB-C两种插向分别计算至MCU焊盘中心，计入重复焊盘分支。2026-11-13复查发现一种插向长度差约1.88mm，已在接口/ESD短区调整D−路径，主干保持不变：

|插向焊盘|D+路径|D−路径|差值|
|---|---:|---:|---:|
|A6/A7|29.424mm|29.428mm|约0.004mm|
|B6/B7|26.714mm|26.714mm|小于0.001mm|

这是以铜线中心线和焊盘中心定义的几何结果，微米级显示值不代表实际电气精度。两网全程F.Cu、零信号过孔；20mm平行主段线宽0.2474mm、边缘间距0.1524mm，按下述JLC04161H-7628非共面90Ω方案选择。连接器及MCU细间距焊盘仍有0.127mm短出口和不耦合区，不能把这些区域声称为恒定90Ω。主段规则改为按两端Y差筛选，避免整板平移或长线跨越范围使旧位置条件失效；不依赖USB_DP/USB_DM名称自动识别差分对。

以不大于0.1mm间隔检查两条信号中心线下方In1.Cu，638个取样点均落在GND填充铜中。这是几何覆盖检查，不是回流场、阻抗或眼图仿真。最终全板走线后重查参考铜、相邻铜和短分支，并核对制造公差及包含连接器/ESD/封装的实测信号完整性。参考[KiCad自定义规则](https://docs.kicad.org/10.0/en/pcbnew/pcbnew.html#custom-design-rules)、[TI USB布局指南](https://www.ti.com/lit/an/spraar7j/spraar7j.pdf)。

## 检查与后续门槛

- KiCad10.0.7 ERC：0错误、0警告。独立测试点提交增加10个被动引脚，其余原理图连接分组保持；后续布局未再改原理图。
- 与Git布局基线的逻辑焊盘网络比较：无连接变化；原有194个电路封装、4孔和3基准点均保留；新增10个TP后共211个封装。
- 原生PCB/原理图parity：0问题。修复旧导入遗漏的采购字段、TP1物料清单属性及3个自动网名的斜杠转义；无电路拓扑变更。
- 全走线、填充与parity检查：`violations`列表为空，但另有**399条未连接报告项**。这是未完成PCB，不是DRC全部通过；没有排除这些未连接项。
- 原生SVG布局人工检查；模型与底座、盖板、螺柱、垫圈、螺钉无体积干涉。完整型号装配公差与插头尚未闭合。
- 待完成：其余供电/去耦分配、晶振、40MHz链路、串口和低速控制布线；最终叠层/阻抗、参考面连续性、线缆模型、散热铜箔/热和DFM。140nA/20～30°C、VIO±1%、持续1A及40MHz均未硬件验收。

原布局阶段证据在忽略目录`hardware/design/reports/pcb-structure-2026-11-12`，本轮接口/测试点证据在`hardware/design/reports/layout-ux-2026-11-12`；源文件哈希及摘要见`hardware/validation.json`。临时MCP客户端/适配脚本不保留在工程。

## 前沿接口及测试点落实

J801位于(16,73)、J803位于(51,73)、J804位于(70.5,73)、J602位于(91,74)mm，依次为ARM20、UART A、UART B、DUT电源。名义器件外形间隙约5.67/6.70/6.43mm，配套插头和手指操作空间仍待实物验证。U701～U704为调试组，U705～U708为UART A，U709～U712为UART B；FSA靠近各接口，局部去耦与偏置按同组对齐，未为整齐而改变原理图连接。

新增TP局部走线和地返回均为手工指定路径；见[测试点坐标及端点表](test-points.md#pcb落实与拆盖探测2026-11-12)。USB几何与旧阶段相同，仍是0信号过孔；测试点未进入高速、FSA后或U901目标侧网络。已布走线共280段、92个过孔。R/C密集处顶层位号隐藏但装配层保留，VIO/GND校准点及底面测试点对照表可读；两处初始丝印与L2/U504重叠已移开，复查无丝印违规。

原生网表校验确认原有PCB焊盘网络分组未变、新增仅10个TP；标准MCP同步过程的自动网名解析异常已按原生XML与同步前记录修复。没有靠豁免DRC或新增ERC忽略项处理。几何及parity为0项，但399条未连接仍然存在；接下来先完成电源/地分配与晶振，再完成40MHz路径和双串口，最后完成低速控制与全板复查。

## 叠层与地返回检查点（2026-11-12，继续布线中）

本阶段采用JLC04161H-7628：名义1.6mm，F.Cu/B.Cu各35µm，In1/In2各15.2µm，外层到相邻地层各0.2104mm的7628，中央core1.065mm。铜+介质合计1.5862mm，厂家计算器显示成品1.59mm±10%；结构仍按名义1.6mm并保留厚度公差。7628介电常数4.4、core4.6；KiCad中的损耗角0.02为记录占位，不用于SI保证。ENIG为本轮制造方案，价格未重新报价。

来源：[厂家叠层](https://jlcpcb.com/impedance)、[厂家阻抗计算器](https://jlcpcb.com/pcb-impedance-calculator)，读取于2026-11-12。国内下单仍需确认同一结构和阻抗公差，不能用较旧国内网页中的不同介电常数混算。本轮选定工程叠层不表示工厂已接受订单。

USB计算输入：4层、1.6mm、外1oz/内0.5oz、非共面差分、L1信号/L2参考、90Ω、间距6mil；标准7628结果为线宽9.74mil，即0.247396mm，工程取0.2474mm；间距0.1524mm。原0.127/0.173mm主干已替换；0.127mm只用于短焊盘出口，不能当作90Ω。布线完成后对主段、焊盘收窄、不耦合区分别核查；USB_DP/USB_DM的实际配对几何还须独立检查，不仅依赖DRC的差分名称识别。

规则在`.kicad_dru`，网类在`.kicad_pro`：外层信号/电源、两内层GND禁止走线；普通线0.15mm/最小0.127mm间距；过孔0.6/0.3mm；铜到板边0.25mm；2A三条干线1.5mm、最小1.2mm；本地电源0.3mm，细间距引脚出口另外核查；晶振顶层无过孔，单网8mm布线预算；40MHz链路0.15mm且单网络最多2个过孔，必要换层必须复查回流。电源铜区颈宽1.2mm，地连接0.2mm；这些是几何约束，非电流/时序保证。实际高电流引脚、过孔并联和铜颈逐项审查，不能用统一线宽掩盖BGA/小焊盘限制。

接收工作区已有整板(+88,+61)mm平移及USB D−局部编辑，未撤销。辅助原点设为(88,61)mm；本文件旧坐标均为板局部坐标，输出装配必须减去辅助原点。发现工作区网类已被清空后按本轮授权恢复已审阅网类并更新USB/晶振参数，没有扩大DRC忽略范围。

原生API补充104处短地扇出及4个主控EP地过孔，主控14脚接EP；地扇出先作异网铜碰撞、孔距和安装孔净空检查，再原生填铜/DRC。EP过孔位于3×3锡膏开口之间，后续制造检查需核对背面盖油及焊接吸锡，不宣称热性能已验收。U501一段地线由0.15加宽至0.20mm。固定接口、开关、安装孔与TP位置已锁定。

检查：原有焊盘网络保持；KiCad原生DRC 0条一般违规、293条未连接、0条原理图一致性问题；已查看实际顶层铜/丝印图。源文件仍是未完成设计，USB加宽、电源主分配、晶振、40MHz及其余控制布线继续实施。新增均为PCB铜和过孔，采购BOM增加¥0；工艺/PCB费用尚未重新报价。40MHz、持续1A、140nA/20～30°C和VIO±1%均待实板验收。

## 主控、辅助电源与晶振检查点（2026-11-13）

在c395bfc基础上增加3.3V/VIO分配主干及12颗转换器电源、主控SOC开关节点和片内稳压/去耦连接、FSA的3.6V分配、U901与K601辅助5V。路径为手工指定坐标后通过pcbnew原生对象模型写入；没有把这些网络交给普通自动布线器。每批写入前检查异网铜碰撞，写入后再作完整DRC。主控30脚改为直接连接EP地；保留全部原器件逻辑网络。

Y1/C1/C2移近MCU右上晶振引脚，信号全在F.Cu且无过孔，XTALI总铜线7.570mm、XTALO7.592mm；负载电容地各有短返回。此长度与局部布局检查不等于起振裕量、频偏和EMI验证。C56/C58/C59为FSA去耦重新定向/落位；C56与C53、J801的courtyard留有约0.015/0.025mm正间隙，封装courtyard已有装配留量，但仍须在最终模型与厂家装配要求中复核，不能只凭DRC代替插头外形检查。

本阶段原生DRC：0条一般违规，209条未连接，原理图一致性0问题；没有新增忽略项。查看了正反面铜与丝印。现有211个封装，633段线、258个过孔；数量仅为本检查点。报告：`hardware/design/reports/full-board-2026-11-12/power-stage-drc.json`及`power-stage-geometry.json`（目录沿用本阶段起始日期）。

未完成：外围3.3V与U402输入连接、40MHz/SWD方向控制、双串口、VIO/ADC和互锁控制的跨模块连接，其余低速网络；最终铜面/回流、机械装配、制造输出。结构旁支的新底座/透明盖/标识改动予以保留，未混入本次布线提交；最终装配必须用最新PCB重新导出。只有既有器件的移动和铜连接变化，采购BOM增量¥0；PCB、过孔与表面处理费用未重新报价。

## U1 两排交错扇出检查点（2026-11-13）

已完成 27 个已用普通/调试 I/O 引脚的局部扇出，新增 U1Signal 类限定区域内 0.50/0.25 mm 信号孔；没有采用 0.45/0.20 mm，电源/地/热及回流孔保持 0.60/0.30 mm。USB/晶振维持顶层零信号过孔；两内层为连通 GND，无内层信号走线。逐引脚坐标、地返回、组合规则正反例及限制见 [U1 扇出记录](u1-fanout.md)。

同时保留并完成此前外围供电、F_TDO/F_TDI 局部连接及 MCU 的两条 SWD 收发支路到 R1/R2。本阶段完整 DRC 一般违规 0、未连接 164、原理图一致性 0；原焊盘网络不变。该数量替代上文各历史检查点的未连接数量，仍不代表整板完成。剩余跨模块高速、方向控制、双串口、模拟/互锁等连接继续布线；随后复查电源去耦回路、参考面及结构装配。采购 BOM 增量 0，孔加工费待最终报价。

## 调试链路与复位驱动检查点（2026-11-13）

U1→转换器→U801→ARM20的SWD/JTAG数据和时钟铜连接、SWD_DIR及NRST驱动侧已完成，仍不代表使能/目标复位等控制已全部接通。新增11个回流地孔；FSA周边C56/R713/TP1小范围整理。TDO保持2孔，NRST_DRIVE作为低速复位控制单独允许4孔；其余Debug上限和全局制造约束不变。见[详细连接、规则验证与参考面记录](debug-routing.md)。

最新完整DRC一般违规0、未连接146、parity0；759个原焊盘对象的逻辑连接不变，211个封装保留。两内层GND各一个连通铜区、零内层信号线；当前33个0.50/0.25mm信号孔及322个0.60/0.30mm孔，没有0.45/0.20mm。前沿接口与结构C不变，TP1新位置(44.8,46.8)mm。40MHz/1A/140nA/VIO±1%和最终实物装配仍待验收，采购BOM变化为0。

## 复位与双串口目标链路检查点（2026-11-13）

在6670e83后完成F_NRST/F_NTRST、ARM20目标复位、两组串口转换器至FSA和目标接口的四路信号，以及输入偏置和FSA使能局部连接。C59移到(43,64.8)mm；U801电源由C56直接顶层接入；P3V3局部跨接给UART A TX让路。增加19个地回流孔，U1扇出、USB/晶振、全部固定接口与测试点保持。详见[连接范围、回流及限制](reset-uart-routing.md)。

当前完整DRC一般违规0、未连接113、parity0，759个原焊盘网络不变；两内层地铜各一个连通轮廓，零内层信号线。1218段走线、408个过孔，其中33个0.50/0.25mm、375个0.60/0.30mm；未修改规则或忽略项。跨模块UART/使能/互锁/模拟/低速控制仍未完成，整板和最新3D装配待继续检查；采购BOM变化0。

## USB 控制与 I²C 检查点（2026-11-13）

在7437510后完成USB-C CC/VBUSD/中断、eFuse局部控制及主控/U101/U201/U504之间I²C。未连接113→90，一般DRC违规0、parity0；USB数据、晶振、SWD/JTAG/DIR原有铜路径及759个焊盘网络保持。C25右移0.2mm，其余布局保持；新增13个地回流孔，U1新增三颗区域限定0.50/0.25mm信号孔。两内层仍为GND且零信号走线；地铜颈缩通过调整孔距修复，没有放宽规则。具体检查、剩余支路及限制见[USB控制布线记录](usb-control-routing.md)。

## 启动、复位与模拟控制检查点（2026-11-13）

补齐TPS63810的I²C、VIO DAC、MCU侧ADC、ARM20到U901的Vref、BOOT0/1、系统复位及备用GPIO测试点。原759个焊盘网络和关键高速路径不变；U1附近五个无源器件落位及局部地出口整理。完整DRC一般违规0、未连接70、parity0；两内层连续GND、无内层信号线。详细连接边界、35个小信号孔/436个普通孔、去耦调整与剩余源端连接见[专项记录](control-analog-routing.md)。整板仍未完成，采购BOM变化0。

## 主控控制源端检查点（2026-11-13）

POWER_REQ、SPI_CS、VIO_EN 完整连接，ADC 顶层短连整理；新增地回流及一颗位置限定的 VIO_EN 小信号孔规则。完整 DRC 一般违规0、未连接47、parity0，759个焊盘网络和关键高速路径保持。详细规则反例、几何检查与剩余工作见[控制布线记录](control-analog-routing.md)。当前不是投板完成稿。

## UART A 源端检查点（2026-11-13）

完成 U1 到 UART A 转换器的 TX/RX，保留关键高速铜形状，整理 C17/C18 及局部地返回。新增 UARTSource 精确网类和 5 个标准回流孔；一般 DRC 0、未连接 45、parity 0，连接尚未清零。详见[UART 源端记录](uart-source-routing.md)。

## UART B 源端检查点（2026-11-13）

完成 U1 到 UART B 转换器的 TX/RX，整理西侧 C17/C18、OTP 连接和局部回流，消除两处实际地铜窄颈，未放宽规则。U1 31 个已用信号引脚均有连续铜到后续端点；维护口及其他多分支网络仍待接通。当前一般 DRC 0、未连接 43、parity 0；PCB/结构尚未完成验收。详情见[UART 源端记录](uart-source-routing.md)。

## 维护口与供电互锁阶段（2026-11-13）

UART B RX 维护分支、POWER_SAFE 全网、局部放电逻辑及继电器线圈连接完成；手工规划继电器回路，其他低速线经受限路径辅助和实际铜形状检查。器件、接口、板框和结构未改。当前一般 DRC 0、未连接 34、parity 0；详见[控制布线记录](control-analog-routing.md)。

## 2026-11-14 国内阻抗计算器复核

已实际操作[国内计算器](https://tools.jlc.com/jlcTools/index.html#/impedanceCalculatenew)：4层、名义1.6mm、外1oz/内0.5oz、外层非共面差分、L1/L2参考、90Ω、6mil线距。通用`JLC04161H-7628`结果为成品1.59mm±10%，两侧7628各0.2104mm、core1.065mm、外铜0.035/内铜0.0152mm，与本PCB导出的Gerber Job逐层相同。不是工厂已经接受订单。

线宽显示9.7mil；9.7和9.8mil反算分别约90.126Ω和89.916Ω。当前0.2474mm=9.74015748mil位于两者之间，因此保留现有主段，不为页面显示精度重布USB。输入精确值时页面仍显示9.7、反算仍90.126，不能把它记为精确线宽的计算结果；这里只用相邻显示值做局部敏感性检查，不作为整板或制造公差界限。动态页面没有列Er/损耗角，既有4.4/4.6/0.02记录未改，尤其不把2018年网页参数混用。

本次仅补资料及哈希，PCB/叠层/规则文件未变，当前完整DRC结果仍适用。输入、结果DOM与截图、实际Job叠层比对放在当前reports的`domestic-stack/`。下单指定同一结构、阻抗公差及工厂CAM/贴装预览仍待确认；细焊盘出口、实物线宽和USB性能均未由该计算验收。

## 2026-11-14 Vref局部简化复查（未改铜）

以`b3bd320`的磁盘PCB和当前完整DRC为准：工作树无未提交源修改，PCB哈希`d619f93146bb…`，DRC仍为0一般违规/0未连接/0原理图parity。本轮没有写PCB、移动器件、改网表、修改约束或重布其他网络，因此沿用该完整DRC，不把只读复查说成新增DRC结果。

U901.6位于板局部(10.6625,64.15)mm，R53.1位于(54.825,40.2)mm；直接距离约50.24mm。当前0.15mm线宽、82.585mm铜长、8个0.60/0.30mm换层孔，采样拓扑、无额外负载、U901断开边界保持。它仍不是全顶层短线，不因全板零未连接而关闭这一布局局限。

根据当前原生几何画出F/B局部图，再手工指定5组替代控制点，用KiCad原生形状按0.127mm铜间距做只读筛查：

|候选|检测到的碰撞数|阻挡例子|结论|
|---|---|---|---|
|R53入口全顶层|5|SYS_RESETn、POWER_REQ、VIO_LOCAL|不采用|
|R53入口提前换回顶层|4|P3V3、POWER_REQ|不采用|
|删除中段顶层跨越所用的两孔|2|VIO_EN、VIO_LOCAL|不采用|
|中段更短顶层路径|34|F_SWDIO、F_TDI、复位与UART/FSA链路|不采用|
|底层斜向捷径|20|VDD_SOC、VIO、RESET及控制/串口|不采用|

碰撞数为候选段与原有物件相交次数，不是唯一违规数或正式DRC数。扫描只覆盖这5条手工路径的焊盘/走线/过孔铜形状；未搜索所有路径，未检查候选覆铜、禁布或全部制造规则，不能声称全顶层或更少过孔在数学上不可能。所有候选已因实际铜冲突被拒绝，未写入工程；保持USB、晶振、40MHz/FSA、VIO反馈、ADC局部、器件和接口位置。

原生导出、控制点/阻挡UUID/网名、顶底层人工审图在忽略的`reports/vref-layout-review-2026-11-14`；图中不含覆铜，不用于证明连续地参考。已有整板填铜/回流与装配证据仍由未变PCB哈希关联。采样扰动、耦合、RC建立及140nA/20～30°C等目标继续待实测。若进一步优化涉及控制或模拟局部重新布局，应单独规划完整影响，不能静默扩大本轮只读局部优化范围。

## 2026-11-14 网类模式持久化修复

本轮调查期间发现`.pro`出现外部保存差异：网类按名称排序以及`1`/`1.0`变化没有改变数值/网类定义，予以保留；原PA28/PA29的4条含`{slash}`完整名称分配却变成了Debug与U1Signal各一条`slash`，分配总数146→144。外部保存的具体来源未确认，不直接归因用户或其他线程。

`slash`不是无效语法：原生查询仍把PA28/PA29解析为`Debug,U1Signal`，但还意外匹配了明确NC的U1.PB09。已将两条宽泛模式替换为Debug/U1Signal各自的`Net-(U1B-PA28*`、`Net-(U1B-PA29*`，恢复13类/146条分配。前缀在当前所有原生网名中只对应这两条连接网络，不含`{slash}`转义串，避免再次按转义词扩大范围。两条目标网络仍为`Debug,U1Signal`；比较所有网络，仅PB09 NC回到Default。没有接铜或取消其NC。

所有网类按名称比较与修复前HEAD数值完全相同，未放宽线宽、间距、板边、过孔或孔距，DRU文件未改。PCB文件SHA仍为`d619f93146bb…`，器件、铜、网表和结构几何没有变化。

实际KiCad工程管理器曾持有项目锁，独立原生SaveProject因只读而正确拒绝写入。未绕过锁；在临时的单独参数文件上完成KiCad10.0.7原生Load/Save，内容/哈希保持、四条前缀模式仍在，随后删除临时文件。关闭GUI的首次自动审批被拒绝；只读进程/窗口检查确认没有pcbnew或eeschema编辑器后，同一关闭操作获准并重新打开当前唯一工程，磁盘设置哈希保持。没有通过其他方式强制结束进程。

重新加载、重铺铜后的完整DRC（all-track-errors＋schematic-parity）为0一般违规、0未连接、0原理图parity，与此前相同的忽略检查集合，无新增忽略项。原生全部网类映射、前后差异、隔离读写、GUI重载记录及完整DRC在忽略的`reports/netclass-roundtrip-2026-11-14`。不将网类/DRC检查当作40MHz、1A、140nA或VIO±1%硬件验收。
