sanchuanhehe/HSLink-LP/docs/control-analog-routing.md

# 启动、复位及模拟控制布线记录

当前检查点（2026-11-14）：**PCB 布线完成；一般 DRC 违规 0、未连接 0、原理图一致性错误 0**。这是文件与几何检查通过，不是性能验收或生产放行。以下历史阶段只对应各自日期和源哈希。

## 2026-11-14：Vref 与剩余白名单连接完成

以磁盘工作树和完整 DRC 为准接续 `8548baa`：保留进入本轮时已经存在的来源识别和放电局部连接，没有重放旧路线或重布全板。收到的项目网类/规则回退先按 HEAD 恢复；最终 `.pro/.dru` 与该基线一致，13 个网类、146 条分配、既有局部小孔例外保持，未增加忽略项。

### VREF_SENSE_IN

实际连接为 U901.6 → R53.1，0.15mm F/B 外层走线，总铜中心线长度约 **82.585mm，8 个 0.60/0.30mm 换层孔**。从 U901 顶层向右离开，经转换器下方通道，再沿控制区右边通向 R53 的右侧输入端；最后一段在顶层。具体折点/层/过孔坐标保存在 `stage-audit.json`，坐标相对 PCB 辅助原点（绝对偏移88,61mm）。

为保持既有 USB、晶振、40MHz、VIO 反馈和 ADC RC 局部，在拥堵通道采用了受控换层；**它不是全顶层、最短路线或理想高阻布局**。未接近开关节点、电感和继电器线圈区域，未增加测试点、保护、分压或分支。R53/R54/C61 到 ADC 的局部铜几何未改，U901 前端隔离完整采样支路的拓扑保持；未恢复 DUT_OUT ADC。分压/滤波名义时间常数及既有 ADC 配置初值仍来自此前分析，不能将本次连通结果当作采样精度、建立时间、寄生电容或漏电验收。长线的噪声拾取、耦合和建立时间需实测，不能用固定等待覆盖未知寄生。

### 低速白名单与局部整理

已接通 UART_B_TX 的 J1 维护分支、UART_A/B 的 DTR/RTS、四路 DEBUG/UART_A/UART_B/DISCH 请求、DEBUG/UART_A/UART_B/RESET/SENSE/DISCH 使能、FAULTn、SOURCE_EXT、INT_EN 和 USB_TIER1/2。辅助路径只作用于明确指定的普通网络；实际铜形状碰撞预检、45°路径整理和每批完整 DRC 后保存，没有运行全板自动布线器。

- R23 仅移到(16.0,20.8)mm/180°，整理 GPIO 下拉出口；R34 移到(73.0,44.0)mm/0°，接通 UART_B_ON 并保持默认下拉。U302 位号竖排至(67.5,40.0)mm。其他封装位置、接口、安装孔和测试点不变。
- 为给 Vref 留出通道，受控调整 POWER_REQ、POWER_SAFE、SYS_RESETn、VIO_EN 的普通控制局部，以及 SIG_ARM 的 U302 公共输入接线。不是 VIO 模拟反馈或 SWDIO DIR 变更。
- SOURCE_EXT、USB_TIER1/2、FAULTn、INT_EN 在 USB 投影区使用明确选定的 **B.Cu 横向跨越**，两内层 GND 夹在它们与顶层 USB 之间；辅助路由器仍禁止进入该区。USB 差分信号本身未改。这是几何/参考层检查，不是串扰或场求解验证。
- 手工核对 DISCH_ON 的 U303.3/TP6/R37/Q902.1/R62.1；RESET_ON 的 U302.6/R35/U804.2；INT_EN 的 U201.15/R29/U501.A1/U503.1；FAULTn 的 U1.18/U102.6/R16/U503.6/U201.19/TP9，均只有一个实际铜连通分组。下拉、互锁器件和原理图功能不变；测量锁软件和真实 HID/固件实现状态未改变。
- 保留关键区域后，部分低速路线较长：DISCH_REQ 总铜长176.002mm、UART_A_RTS 177.137mm；VIO_EN 为126.196mm/17孔（包含先前出口）。这些是网络全部分支铜长，非统一端到端电长度，不能称为最优布线。较长控制线的耦合、毛刺、边沿和 EMC 需首板检查。

### 回流、平面与检查

最终2525段走线、778个过孔：65个既有0.50/0.25mm，713个0.60/0.30mm；没有0.45/0.20mm，新孔全部采用0.60/0.30mm。移除了一颗被替代的旧小信号孔及不再使用的握手源孔/短支线，没有为消除未连接强接 NC。为新控制换层补充52个标准GND孔；此前 Vref 阶段另补8孔。TX通道旁两颗无外层线/焊盘连接的地孔分别移0.4mm与约1.208mm，未移动具有外层实际接线的地孔。

新增信号孔到最近 GND **过孔**中心距0.728～2.633mm（该统计不包含可复用的GND通孔焊盘）；UART_A_ON、SOURCE_EXT、UART_A_REQ、INT_EN 的4处约2.06～2.63mm，属于低速/静态控制的拥堵局部。2mm仅是本轮筛查值，不是新增需求；未为追求该数值侵犯晶振/USB/模拟/电源区。并未据此保证低回流电感。

In1.Cu、In2.Cu 各一个连通GND填充轮廓，内层信号线为0；既有地连接最小颈宽0.2mm、主电源铜区1.2mm约束未放宽。按≤0.2mm中心线间隔检查全部非地外层走线（33865点）：三处既有线位于相邻同网过孔的局部合并避空中，分别 USB_5V 的(81.275,29.000)/(81.275,29.008)及 SPI_CS 的(48.725,38.325)mm；保留原始报告，不冒称每一点下方都有铜。USB_DP/DM、晶振和40MHz网络没有未解释的缺参考采样点。新增路线单独筛查未发现同网开窗之外的缺参考点；这仍不是电磁场/阻抗或回流阻抗分析。

从磁盘重新载入、重铺铜、完整DRC包含全部走线错误和原理图parity：**0 / 0 / 0**。759个焊盘的(位号、引脚号、UUID、网络)逐项及归一化网表完全一致，211个封装保留；USB、晶振、40MHz、SWDIO DIR、FSA调试、主电源、开关电源、VIO反馈和既有ADC局部信号铜几何与`8548baa`一致（比较几何而非UUID）。保留原理图NC，没有用铜线接NC消项。原理图及采购BOM未改。

已人工查看F.Cu、B.Cu、两内层、正面丝印、整板和控制/检测局部；DUT PWR与极性标识保留原有间距，没有为丝印移动接口。结构C使用当前PCB重新导出装配，见结构README。四类缺失标准STEP改用有出处的尺寸包络，仅修改板上3D关联，不改变封装焊盘/采购型号；不是厂家精细模型。

证据：忽略目录`hardware/design/reports/final-control-routing-2026-11-13`（目录名沿用开工日期；最终检查在11月14日），含完整DRC、前后焊盘网表、实际铜分组、回流距离、参考面采样、各层SVG/PNG、STEP/装配及探测包络。摘要和源/证据哈希在`hardware/validation.json`的`control_whitelist_routing`。

采购BOM增量 **¥0/板，¥0/10套**。过孔/制板/贴装/结构没有重新报价，不将其费用写作零。40MHz、持续1A、140nA/20～30°C和逐板校准VIO±1%仍待实板验收；当前无生产放行。尤其漏电预算原有FSA温区上限缺口仍未关闭。

## 2026-11-13：局部下拉、请求通道与 45° 整理

相对 `9ae3269`，未连接 **34→27**，一般 DRC 违规和原理图一致性错误均为 0。当前仍不能投板。

- R32/R33 对调位置，使 DEBUG_ON、UART_A_ON 的本地下拉按逻辑输出顺序直接接入；R61 移到 U901 控制脚附近，与 C901 并排，避开 ARM20 的 courtyard。器件型号和逻辑网络不变。
- 接通 U302→R36、U901→R61 的 SENSE_ON 局部支路，以及 Q902→R62 的 DISCH_ON 下拉。SENSE_ON 和 DISCH_ON 的跨区主干仍未全部完成。
- SENSE_REQ、RESET_REQ 从 U201/本地下拉接到互锁逻辑。采用普通控制线的受限通道辅助和逐段整理；在 USB 投影区只由 B.Cu 横向跨越，中间保持 In1/In2 两层 GND，USB 顶层差分线不改。绕开晶振和 VIO 反馈器件区；不是串扰/SI 验收。
- 按用户新增的美观要求，将 **23 段不规则信号斜线**改为水平、垂直或 45° 线段，UART B 接口四路按一致折线整理。包括手工处理 DUT_TDO、TDO_MCU、SWD_DIR，以及两段短电源模拟控制信号；保留原端点、层、线宽和信号孔数。三个关键调试网局部中心线增加约 0.061/0.087/0.026mm，不据此宣称时序通过。
- 复位出口的一颗 0.60/0.30mm GND 孔沿 Y 移动 0.15mm，给 45° 转折留间距；为新控制换层另补 7 个标准地孔。新增请求线孔仍按现有 Control 规则用 0.60/0.30mm，没有扩大 U1 小孔例外。

检查：759 个焊盘网络保持，211 个封装保留，仅 R32/R33/R61 移位；接口、安装孔、开关、测试点和结构 C 参数不变。现有信号线方向检查未发现水平/垂直/45° 之外的直线段（坐标容差 0.00001mm）；电源/GND 的 15 段原短斜接保留。该检查只约束直线方向，不能替代对所有拐角、进焊盘方式和最终图面美观的人工审查。

完整 DRC（重铺铜、全部走线错误、parity）为 **0 一般违规、27 未连接、0 parity**；角度整理前后未连接项数量与网络分布保持，无新增忽略项。13 个网类/146 条分配及 `.pro/.dru` 哈希保持。当前 1987 段线、579 个过孔：66 个 0.50/0.25mm、513 个 0.60/0.30mm，无 0.45/0.20mm。

In1/In2 各一个连通 GND 填充轮廓，无内层信号走线。新控制孔到最近地孔中心距 0.800～1.831mm；新线中心按 ≤0.2mm 步距检查相邻参考面，除同网孔开窗外无未解释缺地。已查看 U1/UART B/检测/控制局部、整板正反铜、两内层及丝印。DUT PWR 与极性字样的最终间距仍需收尾；最新 STEP 整机装配未在本阶段重验。

剩余：J1 TX、4 路握手、FAULTn 远端、4 路请求、各使能/放电/INT_EN、USB 档位、来源识别及 VREF_SENSE_IN 等 27 个未连接报告项；之后完成全板 SI/PDN/DFM、图面收尾及结构 C 装配。采购 BOM 增量 ¥0/板、¥0/10套；制造未重报价。40MHz、持续1A、140nA/20～30°C、校准VIO±1%仍待实板验收。

证据在忽略目录 `hardware/design/reports/u1-uart-source-2026-11-13/control-angle-*`；摘要及源哈希见 `hardware/validation.json` 的 `control_angle_routing`。

## 2026-11-13：维护口 RX、POWER_SAFE 与局部放电互锁

相对 `df60f4a`，未连接 43→34。以下为铜连接完成范围，不是控制时序或硬件互锁的实板验收：

|网络|实际完成|
|---|---|
|UART_B_RX|J1.4 维护分支接入已有 U1→U710 路径；复用连接器通孔换层，未在焊盘内重复打孔。UART_B_TX 的 J1.3 分支仍未接通。|
|POWER_SAFE|U301.6、U304.2、Q601.1、R44.1、R31.1 和 TP5 已全部连接；复用已有 R31↔TP5 路径，驱动下拉在 Q601 旁绕行接入。|
|DISCH_ARM|U302.11→U303.1 顶层短路径接通。|
|U303.1B 互锁输入|U304.4→U303.2 顶层接通，保持原理图反相/互锁关系。|
|POWER_COIL_LO|Q601.3、D601.2、K601.16 接通；手工指定 0.30mm 顶层路径，沿继电器侧边走线，无信号换层孔。|

本阶段未移动器件，759 个焊盘网络、211 个封装、USB/晶振/40MHz数据与 SWD_DIR 几何不变。控制路径辅助仅限普通控制线，经实际铜形状检查和折线整理；继电器驱动回路使用明确手工路径。未新增 SMD 焊盘内通孔，未修改原理图、BOM、结构、接口位置或低功耗断开边界。

J1 旁和新 RX 换层点旁补 2 个 0.60/0.30mm 地孔。新增信号/控制换层孔到最近地孔中心距 0.739～1.883mm。两内层各一个连通 GND 填充轮廓，无内层信号走线；新增线中心以 ≤0.2mm 步距取样，除同网过孔/PTH 开窗外无未解释缺地。没有放宽地铜颈宽、间距、孔径或板边规则。

完整 DRC（重铺铜、全部走线错误、原理图一致性）：一般违规 0、未连接 34、parity 0。全板 1905 段走线、559 个过孔，其中 66 个 0.50/0.25mm、493 个 0.60/0.30mm，没有 0.45/0.20mm。13 类/146 条分配及 `.pro/.dru` 哈希保持，无新增忽略项。

已人工查看维护口正反铜、互锁主干、继电器回路、两内层及局部丝印。尚未完成 J1 TX、FAULTn 远端、各请求/使能/握手、DISCH_ON、INT_EN、USB 档位、来源识别和 VREF_SENSE_IN 等连接；未连接项以报告为准。最终 SI/PDN、丝印、结构 C 装配与实板验收仍待完成，不能投板。

采购 BOM 增量 ¥0/板、¥0/10套；制造/贴装未重新报价。40MHz、持续1A、140nA/20～30°C、VIO±1%等性能不由本次 DRC 证明。证据在忽略目录 `hardware/design/reports/u1-uart-source-2026-11-13/peripheral-*`；源哈希与摘要见 `hardware/validation.json` 的 `peripheral_control`。

## 2026-11-13：POWER_REQ、SPI_CS、VIO_EN 完整连接

以 `429eeef` 为基线，未连接由 50 降至 47。POWER_REQ 已由 U1 接至 U301；SPI_CS 已连接 U1 的 42/25 脚；VIO_EN 已连接 U1/R8 与 U502/R63/TP10 两组。ADC_VREF 删除绕行，改为短顶层接入现有分压/滤波网络。原理图、759 个焊盘网络、211 个封装位置及采购 BOM 保持；未恢复 DUT_OUT 回读。

VIO_EN 在板局部 (54.8625,44.9)mm 需要一颗 0.50/0.25mm 孔，穿过 NRST_DRIVE 与 VIO_LOCAL 之间的空隙。新增规则仅匹配该网络、U1Signal 类和该坐标 ±0.01mm；没有扩大原 U1 区域或放宽全局制造下限。一次性诊断证明：该点正确尺寸通过；改为 GND、移出区域或改成 0.45/0.20mm 均触发孔径/直径违规。GND 反例先移除邻接 VIO 铜，避免 KiCad 连接重建将网络归回 VIO_EN；诊断副本已删除。

本阶段新增 6 个标准地回流孔，调整 3 个原地孔并补短地连接，消除铜连接窄颈。新增信号换层孔到最近地孔中心距为 0.781～2.236mm；最远为拥堵处的低速 POWER_REQ。所有地/电源/热孔保持 0.60/0.30mm。全板 1686 段走线、510 个孔，其中 36 个 0.50/0.25mm、474 个 0.60/0.30mm，没有 0.45/0.20mm 孔。

重新加载 KiCad 10 规则、重铺铜、完整 DRC：一般违规 0、未连接 47、原理图一致性错误 0。两内层各一个连续 GND 填充轮廓，内层信号线 0；新增线段相邻参考面以 ≤0.2mm 步距采样，除同网换层/PTH 开窗外无未解释缺地。USB、晶振、40MHz 数据/时钟及 SWD_DIR 几何逐对象保持。

已人工查看 U1 顶底层细节、整板顶底铜、内层 GND 及丝印导出。最终丝印仍需整理 DUT PWR/极性标记之间的间隔；当前 DRC 不等于全部文字已达到最佳可读性。UART 四个源端和其他控制连接仍未完成，不能把局部扇出视为全板布通；完整装配、SI/PDN/DFM及40MHz/1A/140nA/VIO±1%均未验收。采购 BOM 增量为 ¥0/板、¥0/10套，孔加工费用未重报价。

证据：`hardware/design/reports/u1-final-exits-2026-11-13`（忽略目录）；摘要及源哈希见 `hardware/validation.json`。

## 2026-11-13：互锁控制与出口整理

以 `2a854b9` 为基线，未连接从 70 降为 50。仅修改 PCB、复位驱动的命名规则及本记录；原理图、器件型号、采购 BOM 和 759 个焊盘对象的位号/引脚/UUID/网络保持。

| 网络或区域 | 实际完成 | 仍存在的边界 |
| --- | --- | --- |
| NTRST_DRIVE | U1 经 R50、Q702 栅极完整连接；删除南侧原未用小孔，绕开电源主干 | 复位时序和实物电平未验收 |
| SIG_ARM_REQ | U1、R6、U301.1 完整连接 | 不是固件测量锁验证 |
| VIO_EN | 补齐 U1→R8、本地 U502→R63/TP10 两组连接 | 两组间仍未布通，不代表 VIO 控制已完成 |
| U201 下拉电阻 | R23～R29 按功能出口重新排列，信号端朝芯片、地端朝外；7 个输入/下拉连接完成 | 到远端控制逻辑的连接仍待布线 |
| FAULTn | U201 旁局部换层，给 INT_EN、DISCH_REQ、SENSE_REQ 腾出通道；保留 U1↔U201 连通 | USB 保护及目标电源故障端尚未汇接 |
| SIG_ARM | U301、U302 的全部同网输入/输出、R30 和 TP11 接通；R30 移至总线旁 | 其他互锁请求、输出和执行器仍有未连接 |
| ADC_VREF | 主控末端改为短顶层走线，移除两个 0.50/0.25mm 跨接孔 | U901→R53 的 VREF_SENSE_IN 仍未接通 |
| SYS_RESETn | U301 接入点改到同网的第5脚，保留第2脚同网连接 | 未改变复位电气定义 |

NTRST_DRIVE 是开漏复位级的低速栅极驱动，使用 4 个 0.60/0.30mm 孔跨越已布网络；将其加入已有 NRST_DRIVE 专名规则的四孔上限。没有放宽整个 Debug 类。独立临时诊断板使用正式 `.pro/.dru` 原样核验：NTRST 4 孔通过、5 孔触发 `too_many_vias`，NRST 4 孔通过，TCK_MCU/SWD_DIR 各 3 孔仍触发原 2 孔限制。临时诊断板已删除。这是规则引擎检查，不是电气性能证明。

12 个网类、142 条分配、全局制造下限以及 U1 小孔适用区域保持。当前全板 1602 段线、487 个孔，其中 33 个 0.50/0.25mm 信号孔、454 个 0.60/0.30mm 孔；没有使用 0.45/0.20mm，也没有扩大局部小孔规则。电源、GND、热及回流孔保持 0.60/0.30mm。

新增 7 个邻近 GND 孔，本阶段新增换层点到最近地孔中心距 0.781～1.6441mm。In1/In2 各为一个连通 GND 填充轮廓、内层信号走线为 0；新线段相邻参考面以不大于 0.2mm 步距检查，同网通孔开窗单列，没有其他未解释的缺地采样点。USB、晶振、SWD/JTAG 数据/时钟及 SWD_DIR 的对象与几何相对基线保持。

KiCad10 从磁盘重载、重铺铜并启用全部走线错误和原理图一致性检查，最终一般违规 0、未连接 50、parity 0，无新增忽略项。已人工查看 U1 正反面、U201/互锁局部、整板正反铜、两内层及局部丝印；调整后的电阻排列和线段未见重叠。不是最新整机 STEP 装配验收，隐藏的密集被动件位号继续保留在装配层。

下一步仍包括 U1 的 UART TX/RX、VIO_EN、POWER_REQ、SPI_CS，以及 FAULTn 远端汇接、各控制请求/使能/执行器、VREF_SENSE_IN。已尝试但未通过间距预检的走线未保存，不能将局部焊盘引出判为全部信号完整布通。完成后还需 SI/PDN/DFM 和最新 PCB 的结构 C 装配核验。接口、安装孔、测试点及结构 C 参数未改。

采购物料增量 ¥0/板、¥0/10套；PCB 加工费用未重新核价。40MHz、持续1A、140nA/20～30°C、校准VIO±1%均仍待实板验收。原始证据在忽略目录 `hardware/design/reports/u1-control-routing-2026-11-13`，摘要/哈希见 `hardware/validation.json` 的 `u1_control_routing`。

## 历史阶段：2a854b9 的启动、复位及模拟连接

2026-11-13，在 `9239ef0` 后继续现有工程。状态为 **INCOMPLETE**：未连接从90降为70；只完成本阶段铜连接与几何检查，整板尚不能投板。

## 本阶段连接

| 网络 | 已完成范围 | 边界 |
| --- | --- | --- |
| I2C_SCL / I2C_SDA | 补齐U501支路，原MCU、U101、U201、U504连接保留 | 已无该网络未连接项；不是I²C实机验证 |
| VIO_DAC | U504.1到R60.1；手工指定路径 | VIO_EN尚未闭合，不代表VIO控制已完成 |
| ADC_VREF | U1出口到R54.1，保留原分压/滤波连接 | U901输出VREF_SENSE_IN到R53仍未连接 |
| DUT_VREF | ARM20第1针到U901.5，顶层直接走线 | 没有新增测试点、保护或跨断开边界支路 |
| BOOT0 / BOOT1 | 配置电阻、U1、SW1及J1相关引脚 | U1局部改为顶层直连，删除两颗无用途的0.50/0.25mm孔 |
| SYS_RESETn | U1、U2、C21、R5、SW2、J1、U201及U301两个输入 | 长跨模块走线绕开USB、晶振、L1/SOC_SW及VIO反馈区域；未验证噪声免疫 |
| SPARE_GPIO | U1到TP1 | 保留TP1位置，删除U1原未使用换层孔；在跨已布网络处用两个普通通孔 |

## U1附近布局

C17/C18在原OTP去耦区域内并排旋转，电源焊盘在同一侧，完整保留原网络，释放其下方SYS_RESETn通道。R4上移0.5mm；C11/R4地出口整理到侧边。C43地孔改到电容旁，给I²C留出通道。

PMC区域的100nF C20移到原C19近端位置；4.7µF C19移到相邻左下侧。100nF路径较原位置缩短，较大电容接入同一节点；没有通过切断VDD_SOC配电或依靠MCU内部同名电源脚互通来消除障碍。L1丝印移到焊盘之间的空白处。以上为几何调整，去耦/片内稳压器稳定性、回流及电源完整性仍须最终专项审查和实测。

BOOT0/1与SPARE_GPIO不再保留无用途的局部过孔，不能继续把历史出口表中的每个孔都视为当前有效。其余两排交错扇出和已完成的40MHz链路保持；**仍有U1相关UART、VIO_EN、SIG_ARM_REQ、FAULTn、POWER_REQ、NTRST_DRIVE和SPI_CS跨模块连接待完成**。焊盘到局部出口不等于全链路已完成。

## 规则、连接与回流检查

- 12个网类、142条分配及`.kicad_dru`哈希均保持。0.50/0.25mm仅用于已有局部U1Signal范围；外部新信号孔仍为0.60/0.30mm，没有使用0.45/0.20mm。电源、GND、热及回流孔保持0.60/0.30mm。
- 全局0.127mm线宽/间距、0.25mm板边、0.60/0.30mm普通通孔及0.254mm孔距未放宽，没有新增DRC忽略项。
- 相对9239ef0，759个原焊盘对象的位号/引脚/UUID/网络保持，211个封装保留；USB、晶振、SWD/JTAG数据/时钟及SWD_DIR几何逐对象保持。
- 最终1510段线、471个通孔：35个0.50/0.25mm信号孔、436个0.60/0.30mm孔。数量包含所有历史阶段，不是本轮新增数量。
- 两内层均仅为GND，各一个连通填充轮廓，内层信号走线0。新增线段下方相邻参考面以≤0.2mm步距采样；同网过孔/PTH开窗单独识别，没有其余未解释的缺地采样点。这不是阻抗或电磁场验证。
- 新换层孔到最近GND孔中心距0.7814～2.8435mm；最远是低速SYS_RESETn局部换层。新增/调整地孔均未占用高速铜路径；SPARE_GPIO靠TP1处另补(44,48)mm地孔。坐标为辅助原点(88,61)mm下的板局部坐标。
- KiCad10重新加载磁盘工程、重铺铜、全部走线错误及原理图一致性检查：**一般违规0，未连接70，parity0**。阶段中发现的孔距、courtyard、悬空冗余线和丝印遮挡均在最终DRC前修正。
- 已人工查看U1正反面、启动/控制、模拟局部、整板正反面及两层内铜实际导出图；没有做本阶段最新STEP整机装配验收。

## 剩余与成本

继续完成上述U1源端、复位驱动、各使能/互锁、继电器线圈及VREF_SENSE_IN；再完成全板SI/PDN/DFM与最新PCB的结构C装配检查。前沿ARM20→UART A→UART B→DUT供电、安装孔、测试点位置和开放底座/可拆透明盖不变；局部电容位置改变后仍需刷新最终装配模型。

原理图、采购BOM与器件型号未改：采购物料增量¥0/板、¥0/10套；孔/PCB加工费用未重新报价。40MHz、持续1A、140nA/20～30°C、VIO±1%仍为待实板验收目标；DUT_OUT实测回读未恢复，固件测量锁及USB供电边界不变。

报告位于忽略目录`hardware/design/reports/control-analog-routing-2026-11-13`；摘要和源文件哈希见`hardware/validation.json`。临时布线工具不作为工程源文件提交。
