sanchuanhehe/HSLink-LP/docs/structure-and-pcb.md

# 结构 C 与 PCB 设计工具

2026-11-11。用户选择 **C：开放调试底座＋可拆透明盖**。仅该形态已确认；效果图中的尺寸、材质、颜色、按钮、灯数均不构成已确认硬件需求。

## 结构与使用方式

底座固定 PCB 并提供防滑支撑，透明盖保护器件，同时允许观察状态和拆盖调试。优先采用通用紧固件、平板盖和可打印底座验证装配；透明盖可在 PC、PETG、亚克力等方案中按韧性、加工方式和成本再选，尚未选材或报价。

PCB 板框先服从接口、安装孔和插拔空间。原90×60mm只是布局假设；不能根据效果图直接定型。先用连接器厂家尺寸/STEP建立占位装配，计入配套插头、排线弯曲和手指拔插空间，再决定底座外形与盖板高度。模型精度取决于厂家资料，不把效果图当加工图。

建议的布局顺序（待机械/PCB联审）：

1. 使用者一侧放带防反插的ARM20、双UART及独立目标供电接口；不要把目标供电混入调试排线。
2. USB和外部电源入口尽量布置于另一侧。来源拨动开关保留清楚的内置/外部标识，避免排线遮挡或插拔时误碰。
3. 先放连接器、开关、安装孔，再围绕MCU、电平转换器、FSA安排最短调试信号路径。机械方便不能替代40MHz时序/信号完整性检查。
4. Vref入口、U901及断开后的高阻区域远离开关电源、线圈驱动、脏污易积聚处；螺柱/盖板不压线、不遮挡测试点。PCB清洁度和结构材料的表面漏电纳入140nA实测。
5. 为U501、电感、U503和VIO LDO留散热铜箔及测温/探测空间。底座和盖板不能妨碍这些检查；本轮完成简化尺寸模型的装配体积干涉检查；热与实物装配未验证。

## UX约束

界面必须分别显示“电源来源”“输出开关请求/控制状态”“信号连接/测量锁状态”。MEASURE时目标保持供电，信号和检测断开；不能把“断开信号”显示成“目标已断电”。

没有DUT_OUT或VIO电压ADC，显示的是设定值或校准预测值，不能显示为实际电压。无真实HID协议、无已实现测量锁固件，不以原型界面暗示功能已经完成。

新增实体MEASURE键和额外状态灯仍为建议，未修改原理图/BOM。透明盖与底座本身即可先围绕现有开关、接口及器件布局设计。

## 工具及当前状态

| 工具 | 用途 | 状态 |
| --- | --- | --- |
| KiCad 10.0.7＋现有KiCad MCP | 唯一原理图、封装、板框、布局布线、ERC/DRC、STEP与生产文件 | 已可用；已重整原有器件并增加10个测试点，当前204电气位号；关键路径手工布线；2026-11-14完整DRC为0一般违规/0未连接/0parity；当前CAD/结构包络检查见[PCB说明](pcb-layout.md)，性能与制造放行待完成 |
| KiCad自带ngspice 45.2 | 电源与模拟支路功能测试 | 本轮已实际运行；MCP负责网表/ERC，求解器经uv临时适配调用，未宣称MCP自带仿真控制 |
| CadQuery | 参数化底座、螺柱、盖板开孔；输出STEP/STL/DXF，源参数用Git管理 | 已用uv安装CadQuery 2.8.0、Python 3.12.14；建模与STEP/STL/SVG导出检查通过，见[接入记录](cadquery-integration.md) |
| FreeCAD | 查看装配、尺寸、干涉、工程图；对接PCB STEP | 已安装1.1.4，可打开本轮STEP；体积干涉检查由CadQuery完成，未实物验收 |
| 厂家STEP/封装图、PCB叠层资料 | 验证插接空间、板厚、阻抗及装配公差 | 后续逐件核对，不能用通用3D外形替代精确连接器模型 |
| 40MHz专项IBIS/互连模型及示波器 | 排线/走线/串阻/FSA的时序和信号完整性验证 | 模型与实测待补；本轮SPICE未覆盖 |

[CadQuery文档](https://cadquery.readthedocs.io/en/latest/intro.html)、[FreeCAD官方功能说明](https://freecad.github.io/Website/features/)、[KiCad SPICE说明](https://www.kicad.org/discover/spice/)。

实施顺序：原理图与仿真缺项审查 → 真实接口/螺孔占位装配 → 同一原点的PCB与结构模型 → 关键电源及调试通道布局布线 → DRC/装配复查 → 低成本结构样件和电气首板。当前采用110×80mm、四层1.6mm作为布局工作尺寸，仍需布线、叠层和装配联审；尺寸为工程暂定，不是新增用户确认。结构单件STEP/STL、盖板DXF及装配已生成，未启动生产下单。用户追加的投板前仿真优先执行，保留现有PCB工作，不把部分布线当作完整PCB。

2026-11-12布局重整、USB与布线约束见[PCB说明](pcb-layout.md)，结构源和检查边界见[结构目录](../hardware/design/mechanical/README.md)。材料和紧固件报价未取得，未计为零成本。

2026-11-12接口继续重整：前沿改为ARM20→UART A→UART B→DUT电源，与结构C的使用顺序一致；沿用当前板框/孔位/结构开口，未因本轮测试点改变结构单件尺寸。新增点需要拆透明盖探测；按D2mm竖直包络检查无器件体积干涉，具体探头/夹具和实物可达性待验收，详见[测试点规划](test-points.md)。

2026-11-14：已完成当前整板布线并用当前PCB重新导出结构C装配；四层及接口顺序保持。器件与底座/盖板/紧固件体积检查、拆盖后10个测试点D2mm竖直探针包络检查未发现模型干涉。已有单件结构尺寸未变，新增四类包络补全缺失标准STEP；详见[结构记录](../hardware/design/mechanical/README.md)。实际线缆插头/排线弯曲、螺丝刀、材料/打印/紧固件公差、温升和实板电气验收仍未完成，不作生产放行。
