sanchuanhehe/HSLink-LP/docs/u1-fanout.md

# U1 I/O 扇出与回流记录

2026-11-14。当前整板一般DRC违规0、未连接0、parity0；U1既有扇出及关键链路保持。本文表格记录`47bae55`局部扇出历史，当前759焊盘及远端连通核对见[控制与模拟布线](control-analog-routing.md)。CAD连通不代替实板40MHz/电源/漏电验收。

本轮按用户要求采用 0.50/0.25 mm（外径/钻孔）的普通信号过孔。共 27 个已用普通/调试 I/O 引脚、25 条不同网络，逐一从 U1 焊盘沿实际 F.Cu 铜形状检查到扇出过孔，全部有连续路径。TCK_MCU、SPI_CS 各占两个 MCU 引脚，不能把它们当成两个独立网络。U1.26 在原理图中为 NC，继续不布；USB 43/44 脚和晶振 35/36 脚保持原有顶层、零信号过孔路径。

## 出口与布局

- 西侧：双串口 TX/RX、BOOT0/1、SIG_ARM_REQ、VIO_EN；两列交错，列 X=36.9/37.7 mm。同侧电源/OTP 使用大孔，不套用信号孔尺寸。
- 北侧：SWD 独立收发、SWD_DIR、时钟与 SPI、POWER_REQ；USB 两条直达走线保留中间通道，I²C/CC_INTn 在 USB 左侧。调试组两排 Y=29.4/30.5 mm，避免密集反焊盘连成横向空隙。I²C 组按独立走廊处理。
- 南侧：TDI/TDO/TCK、复位驱动及故障/备用控制，两排 Y=39.65/40.60 mm。SYS_RESETn 单独从左下引出，避开 SOC_SW。两排过孔按需要留出地铜通道，不为整齐合并不同网络。
- 东侧：ADC_VREF 与 SPI_CS 走独立短出口；USB/晶振、电源反馈和开关回路没有用作普通信号通道。
- C6/C7/C11/C17/C18、C10、C19/C20及R7调整位置，让出逃线走廊；保持原焊盘网络。C19/C20下移后、左侧去耦通过外层/大孔连接的回路并非最小可能长度，后续电源完整性/布线收尾仍须复核，不能由 DRC 推导去耦性能已通过。

坐标均为板局部坐标，辅助原点为 (88,61) mm。以下为 `47bae55` 历史出口；已移动或删除的孔不能再作为当前坐标使用，最新证据见 UART 源端记录。

|U1脚|网络/用途|信号过孔中心 X,Y（mm）|邻近地孔中心 X,Y（mm）|中心距（mm）|
|---|---|---|---|---:|
|1|SIG_ARM_REQ|37.7,31.4|36,31.2|1.712|
|2|UART_A_TX|36.9,32.05|36,31.2|1.238|
|3|UART_A_RX|37.7,32.7|36,31.2|2.267|
|4|VIO_EN|36.9,33.35|36,31.2|2.331|
|7|BOOT1|37.7,35.3|36,35.65|1.736|
|8|BOOT0|36.9,35.95|36,35.65|0.949|
|11|UART_B_RX|37.7,37.9|38.3,39.2|1.432|
|12|UART_B_TX|36.9,38.55|36,39.5|1.309|
|13|SYS_RESETn|39.2,38.2|38.3,39.2|1.345|
|18|FAULTn|42.8,39.65|44.8,41.1|2.470|
|19|SPARE_GPIO|43.3,40.6|44.8,41.1|1.581|
|20|NRST_DRIVE|43.8,39.65|44.8,41.1|1.761|
|21|NTRST_DRIVE|44.3,40.6|44.8,41.1|0.707|
|22|TDI_MCU|44.8,39.65|44.8,41.1|1.450|
|23|TDO_MCU|45.3,40.6|46,40.6|0.700|
|24|TCK_MCU|45.8,39.65|46,40.6|0.971|
|25|SPI_CS|46.8,38.6|48.5,37.6|1.972|
|27|ADC_VREF|46.79,36.92|48.5,37.6|1.840|
|37|POWER_REQ|45.9,30.5|47.4,30.8|1.530|
|38|SWD_DIR|45.4,29.4|46.3,28.8|1.082|
|39|PA29 / SPI1.MOSI → R1.2|44.9,30.5|44.4,28.4|2.159|
|40|PA28 / SPI1.MISO → R2.2|44.4,29.4|44.4,28.4|1.000|
|41|TCK_MCU|43.9,30.5|44.4,28.4|2.159|
|42|SPI_CS|43.4,29.4|44.4,28.4|1.414|
|46|I2C_SCL|41.2,29.9|39.5,31|2.025|
|47|I2C_SDA|40.65,30.7|39.5,31|1.188|
|48|CC_INTn|40.1,29.9|39.5,31|1.253|

SWD 的两条独立收发支路已分别连接 R1.2/R2.2，保留原 22Ω 支路及网络，不短接 MOSI/MISO。各支路使用两个 0.50/0.25 mm 过孔；其余局部 GPIO 出口主要仍是后续跨模块布线的起点。SWD_DIR、TDI/TDO/TCK 与转换器/FSA/目标接口的完整链路尚未闭合，40 MHz 未验收。

## 规则与制造边界

`.kicad_pro` 保留 8c146c4 的 11 个网类和 117 条表达式，新增 `U1Signal` 类及 25 条精确网络表达式；总计 12 类、142 条。`.kicad_dru` 仅在 U1 局部 X=35～50、Y=27～41 mm 对该类启用 0.50/0.25 mm 通孔。Debug/Analog 等原有类别继续参与规则匹配，不因新类失效。

全局线宽/间距下限仍为 0.127 mm，板边间距 0.25 mm，通孔默认/电源/GND/热与回流孔仍为 0.60/0.30 mm；孔到孔 0.254 mm。当前全板 30 个 0.50/0.25 mm 信号孔、294 个 0.60/0.30 mm 孔，没有 0.45/0.20 mm 孔，也未为其增加常开规则。若后续确需 0.45/0.20 mm，只能单独指定拥堵点、检查孔距和参考面，再增加局部规则；不能降低全局制造下限。

用当前生产 `.pro/.dru` 原样复制到一次性诊断板进行正反例检查：25 条 U1Signal 网络在区域内均允许 0.50/0.25 mm；GND/P3V3/VDD_SOC 小孔、区域外小信号孔及 0.45/0.20 mm 均产生尺寸错误；正常地孔通过。0.14 mm 的 TCK_MCU/SWD_DIR 和 ADC_VREF 分别触发原 Debug/Analog 规则，确认组合网类仍工作。诊断板已删除，正式工程没有增加测试违规或忽略项。

## 地参考与检查结果

In1.Cu、In2.Cu 各为一个连通的 GND 填充区域，内部信号走线均为 0，没有非 GND 铜区。安装孔禁布区不是电源分割区。两排孔之间保留地铜通道，允许局部电源孔反焊盘相连，但没有把整个地层切成孤岛。新增/调整的回流地孔均为 0.60/0.30 mm，四个 EP 地/热孔保留。

检查本地 F/B I/O 走线下方相邻地层，以不超过 0.1 mm 步距取样：F.Cu 637 点、B.Cu 174 点均有 GND 铜；距离同网换层孔小于 0.5 mm 的过孔过渡区单独排除并检查邻近地孔。U1 出口到最近地孔中心距为 0.700～2.470 mm。这是几何覆盖与连通检查，不是高频回流场、阻抗或 40 MHz 时序验证；完整链路走通后还要复核全路径、参考面、串阻、探头及排线。

KiCad 10 完整 DRC（全部走线错误、重铺铜、原理图一致性）：一般违规 0，未连接 164，原理图一致性 0。与 8c146c4 比较，759 个焊盘对象的位号/引脚号/UUID/网络保持一致，211 个封装保留；原理图与采购 BOM 未修改。当前 886 段走线、324 个过孔。已人工查看顶层、底层丝印/铜层，以及两内层 GND 的实际导出图。

本阶段还收纳此前未提交的外围供电和 F_TDO/F_TDI 局部走线，未重复建立工程。检查过程保留外部删除的旧 C10 冗余线段，确认 U1.45 经新路径仍接通；没有恢复这段冗余铜。

本轮再次发现工程设置被回写为 Default-only，写入前断言阻止继续布线。已恢复到已核验的 12 类/142 条表达式及制造下限，保存前后检查项目/规则哈希。发生时间与 MCP 读入及 GUI 活跃重叠，尚未定位具体写入进程，不能归因于某个工具。GUI/服务持有旧状态时不得反向覆盖磁盘工程。

采购 BOM 增量：¥0/板、¥0/10套。0.25 mm 钻孔的加工费用/工艺确认仍需嘉立创按最终整板报价，不在这里给出未核实的价格。40 MHz、持续 1 A、140 nA/20～30°C、VIO±1% 仍待实板验收；当前板不得作为可制造完成稿。

原始证据在已忽略的 `hardware/design/reports/u1-fanout-2026-11-13`，摘要及源哈希记录于 `hardware/validation.json`。前沿接口和结构 C 的底座/可拆透明盖保持，最终装配仍须使用后续完成布线的 PCB 重新导出核验。

后续已删除原TDO(45.3,40.6)mm冗余孔，以F.Cu延伸到下游两处换层；UART_B_TX邻近的旧(36,39.5)mm地孔移到(37.5,39.2)mm。其余历史表格不作为远端已连通证明；当前逐网连通证据和过孔统计见上述调试记录。

## 后续控制出口调整（2026-11-13）

在9239ef0之后，BOOT0/1直接在F.Cu连接配置电阻，删除历史表中(36.9,35.95)/(37.7,35.3)mm两颗未用孔；SPARE_GPIO延伸顶层并删除(43.3,40.6)mm未用孔，跨已布网络后接TP1。SYS_RESETn补齐到监督器、按钮、维护接口和互锁逻辑，局部新增(38.8,38.6)mm的0.50/0.25mm孔；ADC出口增加同尺寸短换层。C17/C18和C19/C20局部整理以腾出通道，未改变焊盘网络。仍有UART、VIO_EN、SIG_ARM_REQ、FAULTn、POWER_REQ、NTRST_DRIVE和SPI_CS等跨模块未连，不能把局部扇出判为全链路完成。最新一般DRC0、未连接70、parity0；细节见[控制与模拟布线](control-analog-routing.md)。

## 最新出口变化：互锁控制阶段

在 `2a854b9` 后，NTRST_DRIVE 删除历史表中 (44.3,40.6)mm 小孔并继续顶层至外围换层，完成到 R50/Q702 的路径；SIG_ARM_REQ 已接 U301。ADC_VREF 删除前阶段新增的两个小孔，改为短顶层连接。VIO_EN 两端局部已接，远端仍未闭合。全板 33 个 0.50/0.25mm、454 个 0.60/0.30mm 孔，无 0.45/0.20mm 孔；没有扩大 U1 小孔范围。USB/晶振/40MHz数据和 SWD_DIR 几何保持。完整信号扇出及远端连接仍以未连接清零为门槛，当前 50 条不能视为任务完成。

## 最新源端连接检查点

POWER_REQ、SPI_CS 和 VIO_EN 已跨模块接通；ADC_VREF 为顶层短连接。历史表中 SPI_CS 两端出口已调整，不再采用 (46.8,38.6)/(43.4,29.4)mm 孔。当前 36 个 0.50/0.25mm 信号孔、474 个标准孔；VIO_EN 仅在局部 (54.8625,44.9)mm 新增专名坐标规则，详见[检查记录](control-analog-routing.md)。UART 四个源端仍待继续布线；当前一般 DRC 0、未连接 47、parity 0，尚未达到完整连接门槛。

## UART A 源端检查点

UART_A_TX/RX 已接通。新增四个 MCU 侧 UART 源端的精确网类，13 类/146 条分配；全局和电源地孔约束保持，未使用 0.45/0.20mm。原表 (36,31.2)mm 地孔已调整，历史距离不代表最新实际值；当前回流、检查与未完成项见[UART 源端记录](uart-source-routing.md)。一般 DRC 0、未连接 45、parity 0。

## UART B 与逐脚铜连通检查点

UART_B_TX/RX 源端已完成；当前 65 个小信号孔、487 个标准孔，未用 0.45/0.20mm。U1.12 不再使用历史表的 (36.9,38.55)mm 孔，经顶层延伸到 (33.85,38.72)mm 后换层。31 个已用普通/调试/USB/晶振引脚的原生铜接触图均到达后续端点；SPI_CS 为同芯片两脚互连。J1 维护分支、FAULTn 其他分支及外围控制仍待完成，整板一般 DRC 0、未连接 43、parity 0；不把已扇出等同于整板布完。详见[UART 源端记录](uart-source-routing.md)。
