sanchuanhehe/HSLink-LP/docs/uart-source-routing.md

# MCU 侧双串口布线检查

2026-11-13。本文 UART B 源端检查点为 **INCOMPLETE：一般 DRC 0、未连接 43、原理图一致性错误 0**。这是布线检查点，不是投板或串口性能验收；后续维护口与控制进度见[控制布线记录](control-analog-routing.md)。

## UART B 源端落实与当前状态

相对 `dcccf66`，U1.12→R709/U709 的 UART_B_TX 与 U1.11→U710 的 UART_B_RX 已完成，未连接 45→43。C17/C18 再左移 1.85mm；调整左侧 UART 出口、OTP 电容连接及 SYS_RESETn 局部绕行，保持所有引脚网络不变。B_RX 从左侧向下绕过已有关键走线，在转换器区域的主控侧通过，未跨越 FSA/U901 断开边界增加支路；其绕行、孔数及串口速度仍需后续 SI/实板检查。

新增六个走廊回流地孔并恢复 C7 邻近地孔；孔径均为 0.60/0.30mm，其他旧孔按局部通道重排。C7 的 GND 焊盘重新获得短连接，不再仅靠向左的地线返回。VDD_SOC 孔调整至 (36.15,36.70)mm，B_RX 孔调整至 (27.40,40.80)mm，消除重铺铜后发现的地铜窄颈；未降低 0.20mm 地连接宽度规则。调整后的 OTP 电容距离和负载回路仍需 PDN/启动实测复核。

新增或调整的信号换层孔距最近 GND 孔中心 0.716～2.125mm；包含电源/OTP 孔后最大 2.607mm。两内层各一个连通 GND 填充轮廓、内层信号走线 0。新增线中心按 ≤0.2mm 步距检查相邻地层，除同网换层/PTH 开窗外无未解释缺地。已人工查看 U1/双串口 F/B 铜层、两内层实际填充及局部丝印，未观察到该阶段的新文字重叠；最终整板丝印和装配仍待收尾。

全板当前 1856 段走线、552 个过孔：65 个 0.50/0.25mm、487 个 0.60/0.30mm，没有 0.45/0.20mm。759 个焊盘网络对象、211 个封装及 USB/晶振/SWD/JTAG/SWD_DIR 铜形状保持。13 个网类、146 条分配和全局制造下限未改。

另以 KiCad 原生铜形状接触图逐脚检查 27 个普通/调试 I/O 加 4 个 USB/晶振引脚，31/31 均已连接到规划的后续端点；SPI_CS 是 U1.25↔U1.42 同芯片互连，不误计为外接器件。U1.26 仍为 NC。此项证明出口有连续铜，**不表示每个多分支网络已经全部闭合**：J1 的 UART B 两个维护分支、FAULTn 其他分支、外围互锁等仍在 43 条未连接中。

KiCad 10 完整 DRC：一般违规 0、未连接 43、parity 0。原始证据为本目录报告中的 `b-final-drc.json`、`b-routing-audit.json`、`b-u1-copper.json` 及 `b-final-*.png`。结构 C、接口位置和测试点未改；本阶段采购 BOM 增量 ¥0/板、¥0/10套。尚不可投板，40MHz、持续1A、140nA/20～30°C、VIO±1%与串口性能未验收。

## UART A 源端落实（历史检查点）

相对 `f94d2d7`，接通 U1→R705/U705 的 UART_A_TX，以及 U1→U706 的 UART_A_RX，未连接 47→45。保留西侧 U1 两排交错出口，沿去耦区域外侧向下引出；与 SWD_DIR 交叉处换层，未移动或切断高速走线。规划辅助程序仅用于普通 UART 通道的障碍可达性调查，最终分段路径经逐段原生铜形状检查；未将 USB、晶振、反馈、开关电源或 40MHz 信号交给自动布线。

C17/C18 各左移 0.35mm，保留方位和焊盘网络。R3/R4 地焊盘改接相邻 C6/C11 地铜，补齐 C11→C6 地孔连接；R8 地接已有回流孔。原 (36,31.2)mm 独立地孔移至 (39.3,31.8)mm。VIO_EN 在 U705 附近局部换层，让出 UART 交叉位置，其余功能与原理图保持。布局仍需在全部连接完成后复查去耦回路；本阶段 DRC 不能证明 PDN 性能。

## 小信号孔的明确范围

新增 `UARTSource` 网类，仅精确分配 UART_A_TX、UART_A_RX、UART_B_TX、UART_B_RX；共 13 个网类、146 条分配，原 12 类/142 条未删除。该类允许 0.50/0.25mm，保留已审查的 0.60/0.30mm 孔，新增优先小孔。它是有意扩展 MCU 侧普通串口路径的专用规则，不包括目标侧、握手线、电源或 GND，也不是 Default-only 约束回退。

全局最小线宽/间距 0.127mm、板边 0.25mm、普通通孔 0.60/0.30mm、孔间距 0.254mm 保持。没有启用或使用 0.45/0.20mm。一次性诊断板验证 `hasNetclass('UARTSource')`：指定源端信号的 0.50/0.25mm 通过；同位置改 GND、改未列入的 UART_A_DTR 均触发默认孔径/直径违规；0.45/0.20mm 触发新规则下限。诊断网络切换产生的悬空仅属于反例夹具，未写入正式工程。诊断副本已删除。

## 地参考与完整检查

本阶段另补 5 个 0.60/0.30mm 地回流孔。新增/调整信号换层处最近地孔中心距 0.781～2.690mm；最远两处为 U1 左侧拥堵区域的 UART A，不能把中心距当作高频回流保证。两内层各一个连通 GND 填充轮廓、内层信号走线 0；新增线中心以 ≤0.2mm 步距检查相邻参考面，除同网换层/PTH 开窗外无未解释缺地。局部孔开窗存在，未形成跨区地平面分割。

当前 1758 段走线、530 个过孔：48 个 0.50/0.25mm、482 个 0.60/0.30mm。759 个焊盘网络对象不变，211 个封装保留，USB/晶振/SWD/JTAG/SWD_DIR 几何逐对象不变。KiCad 10 重新加载、重铺铜及完整 DRC 结果为 0 一般违规、45 未连接、0 parity。已人工查看 UART/U1 顶底铜、两内层局部实际地铜及整板丝印。DUT PWR/极性丝印间隔仍列最终整理项。

在该历史检查点，UART B 两条源端、维护接口分支及其他控制网络仍待完成；最新进度以上文 UART B 检查点为准。最新结构装配尚未重新验收。40MHz、持续1A、140nA/20～30°C、VIO±1%及双串口实际速度均待实板验证。

采购 BOM 增量 ¥0/板、¥0/10套；加工费用需整板完成后实际报价。原始证据位于忽略目录 `hardware/design/reports/u1-uart-source-2026-11-13`，摘要和源哈希见 `hardware/validation.json`。
