sanchuanhehe/HSLink-LP/docs/electrical-margins.md

# 使用边界与电气余量

2026-11-11补充：发现当前图中四颗电阻和VIO输入回退后，已恢复下文已采用方案；完成首轮分模块SPICE，新增瞬态与模型限制见[仿真记录](spice-validation.md)。下文2026-11-07结果保留历史日期，不等同新硬件验收。

2026-11-07。VIO修改基线Git `cad895d`，R42落地基线Git `4a619c1`，以[需求基线](requirements.md)为准。VIO反馈电阻及LDO输入已修改，用户已确认低成本、逐板外部校准与±1%目标。资料分析、文件检查和实板验收分开记录；计算不构成硬件保证。VIO证据位于已忽略的 `hardware/design/reports/margins-2026-11-07/`，R42落地检查位于 `hardware/design/reports/r42-2026-11-07/`，摘要和源文件哈希见[validation.json](../hardware/validation.json)。

2026-11-12新增：[投板前专项分析](prefab-analysis.md)补充了总VIO去耦、启动顺序、ADC采样保持、供电/放电异常和1A预算；原先的标称宏模型不得作为动态调压保证。

## 已确认的边界

- 整夹具附加电流目标为 **≤140 nA（0.14 µA），20～30°C**。保持目标供电、夹具正常上电、全部信号与检测支路断开，与物理断开相同信号连接作差；目标端电压保持一致。不是FSA单独预算，不是实测结果，也未同意700 nA或仅25°C。
- 首版不支持调试器USB掉电而目标仍供电时的FSA保护。目标信号连接期间须保持USB供电；不单为此工况加保护或换FSA。关闭FSA控制脚并不能证明掉电保护；移除USB前应先断开目标信号连接。启动/复位默认关闭、不得主动放电和测量锁约束仍保留。
- 内置1.8～5.0V、最高1A和外部1.8～5.5V、最高2A保持；VIO设置范围保持1.8～3.3V。U901保留Vref检测，DUT_OUT回读、K901/K902均不恢复。

## 断开状态与漏电预算

网表核对了实际隔离边界，而不是按器件个数直接承诺总电流：

| 路径 | 正常测量状态 | 电压/预算依据与剩余缺项 |
| --- | --- | --- |
| U801～U804，14条使用通道 | 目标接B1；SEL=0时A接悬空B0，目标B1被隔离。调试4路、UART A/B各4路、复位2路；U804另2路未用 | P3V6_SW由USB侧TPS7A2036提供，静态±1.5%示例为3.546～3.654V；目标端可能为0/1.8/3.3V，夹具A端随VIO、DIR和默认偏置改变 |
| U901 | IN=SENSE_ON=0，COM(5)=DUT_VREF转到浮置NC(4)，NO(6)后的整个68k/68k/1n/ADC支路断开 | DUT_VREF仅J801.1/U901.5；V+=USB_5V，源自夹具。20～30°C、实际COM电平及浮置NC状态仍需测试 |
| 放电 | K601吸合供电，NC机械隔开R57/Q902；Q902默认关 | DUT_OUT仅J602.1/K601.4；不把OFF时MOS关断电流混入MEASURE，也不能把触点/PCB绝缘视为零漏电 |
| 线束/连接器/PCB | 保留共同地，信号仍物理连接 | 20cm线束最低绝缘5MΩ；3.3V/5MΩ=660nA只是单路径示例，非实际线束电流。J801的1GΩ对应3.3nA/路径的示例也不是多导体总保证。湿度/焊剂/清洁度/爬电路径待核 |

[FSA2466原厂手册](https://www.onsemi.com/download/data-sheet/pdf/fsa2466-d.pdf) Rev.3第5页规定条件下，B0/B1关断电流25°C最大±10nA，−40～85°C最大±50nA；14路绝对值简单相加分别为140nA和700nA。后者覆盖需求温区，只作为保守筛选，不意味着每块板都会超标。25°C上限已经占满目标，没有给其他支路留下预算。

该表测试端电压是0.3V或VCC−0.3V等组合，并非所有真实逻辑电平的独立保证。这里实际VCC−0.3V约3.246～3.354V，目标端0/1.8/3.3V、A端高低/浮置和VIO关闭都须逐项核对，不能把“模拟范围覆盖”推导为“漏电上限已覆盖每个状态”。

[DG2012E原厂手册](https://www.vishay.com/docs/75834/dg2012e.pdf)的5V表在规定测试点下给出25°C 5nA、全温20nA等级；现设计对COM/未选NO暂留40nA，只是工程预留，不是厂家对实际COM=1.8～3.3V且NC浮置状态的合计保证。与FSA筛选值相加为180/740nA，仍未含连接器、线束、PCB；**这不是新的验收阈值，也不是实测值**。USB=0时U901单器件最大1µA特性另记，不代表整板/FSA具有掉电保护。

样机必须覆盖20/25/30°C、1.8/2.5/3.3V目标域、目标输出高/低/高阻、复位高低、夹具A端默认及允许状态、USB/P3V6容差；分别测单支路与完整夹具，再与物理拔线比较。记录湿度、清洁工艺、样板/线束批次、仪器量程与不确定度。若失败，重新分配支路预算/改器件或线束后复测；本轮未获准进一步放宽目标。

## 来源开关

SW601仍为Dailywell **2MD1T1B1M2QES-5**，不换料、不改线。

| 证据层级 | 能支持的判断 | 不能推出的结论 |
| --- | --- | --- |
| [Dailywell官方FAQ](https://www.dailywell.com.tw/en/faq/Dailywell-FAQ-09.html) | SPDT说明为break-before-make，DPDT为两组SPDT，支持BBM判断 | 不是完整-5料号的专门时序保证 |
| [2M系列页面](https://www.dailywell.com.tw/en/product/Sub-miniature-toggle-switches_2M-Series.html)及[厂家系列手册镜像，第6页](https://lv.mouser.com/datasheet/2/979/dailywell_10012019_2M_Series-1660477.pdf) | Q银触点3A/28VDC、阻性负载，在电压/电流额定上覆盖5.5V/2A | 不保证容性浪涌、热插拔、两极同步或长期接触表现 |
| [完整-5厂家图纸，DWG 2MDP0428 Rev.A第1页](https://www.thonk.co.uk/wp-content/uploads/2017/05/DW3-DPDT-ON-ON-2MD1T1B1M2QES.pdf) | 两个稳定档位、DPDT、接点图与外形；银触点交流额定 | 未单列转换时序/DC额定；ON-NONE-ON中的NONE不是BBM证明 |

助手建议把原P1调整为P2“完整料号资料与样品确认”，依据是新增FAQ和系列额定。该建议未作为用户确认或已实施优先级调整；当前审查保留P1并单列建议P2。不能因缺项直接认定开关短接电源。首板需测两极转换、接触重叠/抖动、带电来源差压与浪涌；先关闭K601输出再切来源仍需遵守，但不能代替主电源触点确认。

第二极当前SW601.4=GND、.5=SOURCE_EXT、.6=P3V3，R45下拉。可选改法为：.4继续接地、.6悬空、R45改上拉到P3V3；内置为低、外部为高的极性保持。这样识别支路即便有短暂重叠，也只经上拉电阻取电，不在该极直接桥接P3V3/GND。此方案**未实施/未批准**，不改善主电源极的转换保证；还需核对GPIO输入门限、漏电及上电读取时机。

## R42：已采用的低成本打样方案与条件

U503继续采用TPS22950CDDCR（嘉立创C7587833，10颗档¥3.22）。R42已从1.15kΩ替换为**RT0603BRD07806RL，806Ω±0.1%、25ppm/°C、0603，[C861567](https://www.jlc-smt.com/lcsc/detail/C861567.html)**。2026-11-07 14:01:50（UTC+8）详情读取现货1731颗，10颗使用1+档¥0.213；原C22834同日本地日期快照¥0.0311，差额+¥0.1819/板、+¥1.819/10套。用户已接受该低成本打样方案及投用前实测门槛，现已写入原理图/BOM，0603封装及连接不变；持续1A要求保持。库存和价格沿用所列本轮读取快照，未预留/锁价。通过样机测试只代表被测样板与条件下验收，不能转化为该阻值的厂家保证窗口。新旧均扩展库SMT，种类与焊点不变；换料费情景增量¥0，额外10%备损增加¥0.1819/订单，材料加该备损共增加¥2.0009/10套。

[TI TPS22950 Rev.B](https://www.ti.com/lit/ds/symlink/tps22950.pdf)第6/16页：1.15kΩ表列0.75/1.00/1.25A，不能保证正常1A。典型公式 `I[A]=1.18×R[kΩ]^(-1.072)` 下，806Ω约1.48693A；假设±25%包络，加电阻0.1%和25ppm×5°C，得到**1.11385～1.86091A筛选范围**。±25%不是厂家对806Ω档的保证，温漂只计20～30°C环境示例，结温/电阻自热另查。精密电阻不能消除芯片阈值误差。正常1A相对筛选下限约11.4%余量，但不据此关闭持续电流或短路风险。

| 路线 | 判断 | 状态 |
| --- | --- | --- |
| 保留U503，806Ω精密电阻 | 成本/面积最小；正常1A、过载窗口及浪涌需逐板验收 | 用户已接受并落实打样；投用前逐板实测，尚未验收 |
| 610Ω表列档 | 1.54/2.00/2.46A（电阻误差另计），静态故障电流较高 | 不采用；不能仅用较高下限决定 |
| TPS2553、GLF231x、JW7112等USB开关 | 最低输入分别2.5V、2.5V、2.8V，无法保持1.8V范围 | 不采用；不以便宜替代降低需求 |
| FPF2123 | 有1.8V能力，导通损耗较高；查到的嘉立创C457650为停产/零库存参考页 | 不作为现货低成本替代，不计节省 |
| 独立电流检测/锁存保护 | 可研究更明确窗口，但需新增器件、故障复位逻辑和成本 | 尚未选型、未核齐完整方案，不伪造价差 |

GLF最低输入依据[厂家选型表](https://glfipower.com/currentlimitpowerswitch.html)。未找出同时满足1.8V输入、明确限流窗口、现货和低成本的直接替换。

**保护协调仍待验收：**

- 外部2A支路绕过U503。U503只保护内置支路，不提升外部源保护能力。
- 重新读[宏发HFD2厂家资料](https://source.hongfa.com/Uploads/Product/PDF/HFD2_en.pdf)发现系列列出2A/30VDC、3A/30VDC及最大切换3A，电气寿命示例为2A。撤回“610Ω必然超过整个系列最大切换电流”的过强判断；但完整HFD2/005-S实际采购变体的额定/寿命、容性浪涌和触点温升仍须确认，不能据系列3A直接批准2.46A自动重试。
- 假设USB_5V=4.5V、效率85%、板载辅助0.25A，5V/1A约需1.557A输入；1.861A故障输出约需2.683A。这些是预算例，不是效率保证。U102输入eFuse、CC/枚举许可、MCU/VIO/线圈耗电和线缆压降必须联合管理；供电不足按既有需求限制功率，不降低最高1A能力。
- U503全温RON上限1.8V为116mΩ、5V为54mΩ；1A时约0.116/0.054W。短路按压差×限流估算，不能用I²RON；5V×1.861A约9.3W为瞬时线性耗散示例，必须依赖并验证热保护/重试，不能作为连续可耗散值。约5µs响应是典型值，不是浪涌峰值上界。
- U501/L4峰值与RMS、电源转换效率、USB输入保护、接点在短路时的开断能力、目标电容热接入均待实测。增加R42余量不能保证DUT端电压：U503、SW601、K601、线缆会产生压降；没有DUT_OUT ADC，不能软件冒充闭环补偿或输出确认。

用户接受的投用前必验项为逐板持续1A、过载、短路及温升。具体测试矩阵如下（工程制定，非已执行结果）：每板在20/25/30°C、内置1.8/3.3/5.0V与批准USB条件下，1A持续至热稳态且不进入限流；记录DUT实际电压和所有热点。逐板扫过载、测硬短路与目标电容插入波形。推荐把1.10～1.90A作为**样机静态限流筛选窗口**，它不是用户确认的新规格、也不是微秒浪涌上限；超出窗口或热/恢复不通过则改保护方案，不能降低1A要求。

## VIO：已落地的反馈与输入余量修改

保留U504 MCP4726A0T-E/CH及U502 TLV75801PDRVR。采用下表阻值，均0603、0.1%、25ppm/°C；不增加元件或焊点。U502.6与输入电容C43.1从P3V6_SW改接**受U102保护的USB_5V**。P3V6_SW继续独立供FSA；两轨均来自夹具USB，VIO不会从DUT_VREF取电。C43仍4.7µF/10V，电压额定覆盖5.5V，实际直流偏压下有效容量及布线瞬态还需核对。

| 位号 | 旧值/旧金额 | 新型号、嘉立创编号 | 新值 | 10套单价 | 详情库存 |
| --- | --- | --- | --- | ---: | ---: |
| R58 | 100k / ¥0.167 | RT0603BRD0710KL，[C95204](https://www.jlc-smt.com/lcsc/detail/C95204.html) | 10k | ¥0.184 | 1947210 |
| R59 | 21.5k / ¥0.112 | RT0603BRD072K15L，[C861292](https://www.jlc-smt.com/lcsc/detail/C861292.html) | 2.15k | ¥0.359 | 6301 |
| R60 | 200k / ¥0.342 | RT0603BRD0715K4L，[C861142](https://www.jlc-smt.com/lcsc/detail/C861142.html) | 15.4k | ¥0.359 | 1464 |

新合计¥0.902，旧¥0.621，**增加¥0.281/板、¥2.81/10套**。新旧均3种扩展库SMT电阻，换料种类、0603占地和焊点不变；无券¥20/种/订单情景的增量为0。额外10%备损示例增加¥0.281/订单；校准工时/仪器成本待实际流程报价，不按0元处理。新3种及旧R58/R59详情本轮复核；旧R60重读触发访问验证，沿用原同日已记录¥0.342，不冒充刷新库存。原R59仅19颗，不利于追加批次，新料库存较充足但未锁库。

设Rt=R58、Rb=R59、Ri=R60，IFB正向为流入芯片：

```text
VIO = VFB × (1 + Rt/Rb + Rt/Ri) − (Rt/Ri) × VDAC + IFB × Rt
标称：VIO = 3.465282 − 0.649351 × VDAC
VDAC ≈ P3V3 × code / 4096
1.8V 标称码3183；3.3V 标称码316；约0.523mV/码
```

相较原3930/206码，低端有明显的继续降压空间；软件仍只提供1.8～3.3V，不开放硬件全部可达范围。反馈输入电流0.1µA造成的Rt压差由10mV降至1mV；反馈上臂在1.8V时约125µA，3.3V约275µA，来自USB侧。相对旧方案增加约112.5～247.5µA稳态VIO负担，最坏电阻耗散远低于100mW。DAC支路负载为15.4k量级、最大约0.19mA，重于旧200k但轻于手册5k测试负载；负载方向/动态仍实测。

**容差筛选**：TLV62568参考0.588～0.612V及450k/100k±1%给P3V3静态3.181604～3.421636V；VFB取±1.5%覆盖TLV758规定结温范围，反馈电阻取0.1%+25ppm×5°C，IFB取±0.1µA，线性调整率额外取±7.5mV。DAC取增益±2%、失调±0.75%FSR、INL±14.5LSB进行条件筛选，未双算满量程误差。

| 网络 | code100输出范围 | code4000输出范围 | 可达范围筛选 |
| --- | --- | --- | --- |
| 原100k/21.5k/200k | 3.24728～3.43733V | 1.58622～1.95236V | 部分角点不能达到两端 |
| 新10k/2.15k/15.4k | 3.31867～3.50575V | 1.16145～1.57722V | 条件模型高端约18.7mV、低端约222.8mV调节余量 |

VDAC=0的静态模型为3.39835～3.53243V，低于P3V6_SW静态低端3.546V，差约13.6mV。**这不是故障钳位或启动过冲保证**；不作为允许零码连接目标的理由。若DAC高阻，Ri不再形成下拉，VIO静态趋向0.55×(1+10/2.15)≈3.108V；掉电模式的不同输出电阻和EEPROM召回值均须测。故障默认先隔离、关闭VIO，不尝试沿用校准码继续通信。

**模型限制及电源条件**：

- [MCP4726 DS22272C](https://ww1.microchip.com/downloads/aemDocuments/documents/OTH/ProductDocuments/DataSheets/22272C.pdf)的±14.5LSB INL脚注在5.5V参考下，不能当本板约3.3V的保证。新模型证明设计方向和名义余量，不能宣称全生产容差已保证或校准后±1%必然成立。
- [TLV758P Rev.D](https://www.ti.com/lit/ds/symlink/tlv758p.pdf)精度条件要求VIN≥VOUT+0.5V。改USB_5V后，以该轨4.5V示例，3.3V端有1.2V压差；相比原3.546V低端仅246mV，改善了压差。实际USB_5V不是理想5V，必须在负载/线损/输入eFuse压降后仍满足≥VIO+0.5V，跌破时不承诺±1%。
- LDO100mA预算下，VIN5.5V/VIO1.8V约0.37W；按WSON厂家测试板80.3°C/W约升温29.7°C，仅供布局筛选。新板EP/铜箔/热过孔未设计；串联两级LDO的总体理想损耗基本不变，但热量从U402转移到U502。VIO100mA仍是预算假设，不能把500mA芯片规格当整板能力。
- 负载调整率0.030V/A仅典型；P3V3纹波/温漂、LDO动态、地偏移、电阻温升、C43/C44偏压后有效容量/ESR均未闭合。C44稳定有效容量须满足手册≥0.47µF；输入有效电容按厂家建议和实际瞬态复核。±1%仍需逐板验证，不能仅用这张范围表验收。

### 外部校准与安全过程（设计约束，尚未实现）

1. K601按测试目的保持隔离，所有FSA、复位和U901断开；目标不参与VIO校准负载。外部校准优先探测TP2/VIO_LOCAL与TP3/GND，启动/调压波形仍可在C44.1/2就地探测，TP10记录EN顺序；位置与探头可达性尚待PCB阶段核验。外部仪器记录不确定度，见[测试点规划](test-points.md)。确认样板序列号、BOM和软件版本。
2. 在25°C、实际USB供电和明确负载下，用外部仪器逐点求校准码。建议1.8～3.3V每0.1V一结点（16点），保存单调分段校准表、CRC和温度/供电/负载条件；两点直线不足以自动覆盖DAC非线性。细扫码或加密中间点证明插值误差，不能只测16点就保证连续范围。
3. 复验20/25/30°C、USB_5V实测低/标称/高、VIO静态及调试/双串口动态负载。建议将`|平均电压−设定值| + 纹波峰峰值/2 + 仪器不确定度 ≤ 1%×设定值`作为稳态验收门槛；连接瞬态/过冲另记录，不能把±1%目标偷换成单一室温空载读数。100mA预算与实际12路负载取较严条件，最终测试负载需实测确定。
4. 上电R63保持EN低，停止通信并保持隔离；校验校准表，配置DAC为VDD参考/1x/正常模式，写入并回读后使能VIO，按实测等待再显式恢复端口。缺失/损坏校准记录、I²C异常、USB不足或码值越界时保持隔离。不得以默认标称公式输出冒充已校准±1%。
5. MEASURE锁不能被调压、校准、读取Vref、串口/DTR/RTS或DAP隐式解除。没有VIO ADC或DUT_OUT ADC；数值只可标为设定值/校准预测值，不能生成虚构实测字段。寄存器回读不等于模拟电压验证。

## VIO阶段检查状态（4a619c1）

原理图由标准KiCad MCP修改，TargetPower局部排版沿用上游；分开R60位号/数值，反馈回线改用同页VIO_FB标签，避免穿过VIO_LOCAL标签和C44接地符号。其他页、器件封装及上游参考不变。文件检查见hardware/validation.json；完整连接变化应仅为U502.6与C43.1从P3V6_SW移到USB_5V，反馈电阻只是值/物料变化，其他引脚网络不变。无新增硬件测试记录；140nA、40MHz、持续1A、VIO±1%、启动和温升继续作为验收任务。

最终文件检查：ERC 0错误/0告警；194物理位号、117连接网络、675连接引脚、45独立NC。实际网表与连接意图的引脚分组相符，只有U502.6/C43.1两引脚换电源网，其余连接不变。改动页无悬空标签、孤立线段和穿越符号的导线；人工查看KiCad Stroke与Arial Unicode MS最终图，另外8页原生渲染像素不变。原理图仍为KiCad10，封装及上游未变；这些不是实板验收。

## R42落地检查

仅R42数值/采购字段及U503的限流说明更新，同时同步项目符号库和嵌入缓存中的旧1A描述；器件数量、0603封装、引脚和导线不变。以4a619c1为基线比较实际导出的全工程网表：117网、675连接引脚、45独立NC全部不变，194个物理位号与BOM/连接意图相符。完整9页ERC为0错误/0告警；人工查看KiCad Stroke与Arial Unicode MS的R42/U503区域，没有新增文字/连线重叠，其余8页原生渲染像素不变。修改页无孤立线段、悬空标签或穿越符号的导线；证据与哈希见hardware/validation.json。硬件测试尚未执行；内置持续1A、过载/短路、热保护重试及上下游保护协调仍是投用前必验项。外部2A支路不经过U503；没有恢复DUT_OUT回读。
