sanchuanhehe/HSLink-LP/docs/prefab-analysis.md

# 投板前功能与电气专项分析

2026-11-11开始、2026-11-12完成本轮分析。基线Git `8da89cd`，需求以 [requirements.md](requirements.md) 为准。**结论 INCOMPLETE：可继续工程设计，不能据此投板放行或宣称硬件指标通过。** 本轮没有改器件、电气连接、封装或用户需求。保留正在进行的PCB布局/布线，不覆盖上游或其他线程文件。

## 范围与证据

沿用上一轮20个用例和已完成的容差/上游采样相位审查，没有把它们重复计为本轮新增结果。新建3份可复用测试台，新增27份场景/复查波形：VIO13份、ADC6份、放电8份。初次两个极轻载22ms测试在19.0008ms关机附近数值停滞；保留失败日志，截到18ms只评估调压，**关机段没有通过**。成功积分也不等于模型适用性通过，尤其VIO动态模型存在下述限制。

KiCad MCP重新导出正式XML并运行ERC：0错误、0告警。194物理器件、117连接网络和45独立NC分组，与上次 `spice-2026-11-11/final.xml` 逐引脚网络分区及名称相同。本轮原理图源文件未变，沿用上次有效图面检查；不声称重新修改了排版。检查摘要、模型/源文件SHA256在 `hardware/validation.json`；原始输入、波形、数值失败和图表在忽略目录 `hardware/design/reports/prefab-2026-11-11`。

软件增加的是**离线参考状态机**，不是固件板型、真实HID协议或设备控制。12项单元测试通过，其中一项执行固定种子的10000步事件序列；不能据此声称实板测量锁已实现。

## 1. VIO：启动、调压与异常

### 真实网络和模型边界

- U502为TLV75801PDRVR；原厂TLV75801P_TRANS Final1.00端口EN/FB/GND/VIN/VOUT映射4/2/3+7/6/1，5不接。VIN为受U102保护的USB_5V。模型文件未改；出处 [TI SBVM926](https://www.ti.com/lit/zip/SBVM926)。
- R58/R59/R60=10k/2.15k/15.4k，0.1%/25ppm，R63下拉EN。U504为MCP4726A0T-E/CH：OUT1、GND2、VDD3=P3V3、SDA4、SCL5、VREF6接地，必须选择VDD参考，不能错误选择外部VREF。
- 除C44=4.7µF外，VIO还有C49/51/53/55、C702/704/706/708/710/712/714/716，共12×100nF。此前只看C44的测试不是完整输出电容。标称总量5.9µF；本轮补充了这些电容的低频集中等效，不包含PCB分布ESL。
- C44准确料号TCC0603X7R475K100CT。现有资料没有该料号可据以保证的DC-bias/ESR曲线。[TLV758手册](https://www.ti.com/lit/ds/symlink/tlv758p.pdf)要求有效输出容量至少0.47µF，推荐陶瓷；没有提供可直接套用的完整ESR稳定边界。0.47/2.2/5.17/5.9455µF、5/20/200mΩ属于参数筛选，不能当作C44已合格，也不能借远端去耦替代LDO引脚附近的有效电容要求。C43在5～5.5V下的容量/输入阻抗也待测。

12颗转换器、复位上拉、反馈网络均由USB侧VIO供电，不能从目标Vref取电。全部FSA断开时仍有芯片静态/内部翻转负载；100mA是预算压力点，不是已测最大值。例如9路都按50pF、40MHz、3.3V充放电约59.4mA，仅为外部电容项，尚缺内部动态功耗、实际活动率和负载；两UART不能无依据按40MHz连续翻转。反馈支路约125～275µA，两个10k复位上拉同时拉低另约0.36～0.66mA。

### 发现：动态反馈注入超出了当前宏模型可信范围

常规模型在1.8↔3.3V跳变时给出微秒级建立，但检查输出电流后发现：加入12颗去耦的用例出现约−1.18A吸收电流；EN分段配置且大容量用例出现约7.73A瞬时正电流、−0.32A吸收电流，明显不适合拿来给实际器件定界。宏模型内部由受控源和 `0.55×VOUT/FB` 推算输出目标，没有证明支持这种宽范围外部DAC动态反馈调节。

零码启动峰值在reltol=1e-4/0.5µs时约3.669V，细化到1e-5/0.25µs变为4.037V；稳态仍约3.463V。这些峰值**不被采纳为真实过冲或保护上界**。常规调压峰值细化差约30µV虽然数值稳定，仍不能消除非物理吸收路径；数值收敛与电路模型适用性是两件事。原厂模型没有温度、噪声和完整生产误差，因此本轮不提供环路相位裕量结论。

本轮保留的确定分析是直流关系、异常方向和被动放电估算：

`VIO = VFB × (1 + Rt/Rb + Rt/Ri) − Rt/Ri × VDAC + IFB×Rt`。

零码标称约3.465V；DAC输出开路时约3.108V，均不是1.8V安全默认值。MCP4726上电恢复EEPROM；出厂零码不能代表经使用后的EEPROM内容。PD模式也不是开路：命令定义为1k/100k/500k下拉，资料另有125k/640k典型物理电阻，均不能视作精密电阻。1k等效时VIO约3.44V；POR/BOR、错误参考、错误PD、未初始化/总线失败均需保持EN低。数字回读正常也不能发现DAC模拟输出开路等故障。

无额外负载、假定LDO关闭源电流且不吸收电流，降压阶段反馈网络等效约11.887kΩ、0.314V。3.3V降至1.818V，在总5.9µF时约48.1ms，按7.4635µF筛选约60.85ms；这是简化被动路径计算，不是完整调节过程或保证等待。它足以说明不能照搬宏模型的约10µs降压值。

### 建议控制流程和等待初值

以下是工程建议，不是新需求或硬件合格时序；参考状态机要求调用者提供验证后的时间，没有内置这些默认数：

1. 停止DAP/UART事务，FSA各组和U901保持断开；保留测量锁，不保存任何自动恢复连接的待执行动作。
2. VIO_EN拉低。重调时先等输出放电；以手册95Ω典型和额外200Ω压力假设、总7.4635µF算，降到0.1V约2.48/5.22ms。可用**10ms作为首板试验初值**，包括初始电压、注入残余、电容及温度复测；无VIO ADC，不能据计时声称已经降到0.1V。
3. USB与P3V3稳定后，确认DAC ACK、POR/RDY状态；写VDD参考、正常工作、已校准码，读回完整配置。不要在日常调压中反复写EEPROM。读回失败、校准表CRC/板号错误或复位则保持EN低及隔离。MCP资料启动约60µs、建立约6µs均是典型，可先留**100µs试验间隔**，不是最大值保证。
4. VIO_EN拉高，首板可先留**5ms试验观察窗**；手册启动到95%为500µs典型而非全条件最大。必须以20/25/30°C、输入压降、真实开关负载和两端电压波形确定最终等待。超时仅表示流程等待结束，不表示已测±1%。
5. 只有专门的显式连接请求、测量锁已退出、目标接口电压已匹配，才按组接通。调压完成、串口打开、DTR/RTS、DAP、读取Vref都不解锁。

USB下降时即便LDO尚未UVLO，3.3V输出也可能已失去精度余量。资料精度条件要求输入至少高于输出约0.5V；不能等1.3V量级LDO UVLO才认为电平不可靠。复位/USB恢复必须重新配置和外部校准策略校验，不能自动复用旧连接。

±1%仍是20～30°C、逐板外部校准后的稳态验收目标。上一轮反馈/参考/DAC容差计算保留为条件筛选；100mA负载变化、参考漂移、DAC在3.3V下未完全保证的INL、实际温升和线调整率不能由单点校准全部消除。按已约定的多点校准表，另测中间点、两端、输入/负载/温度，记录仪器不确定度；暂不增BOM。

## 2. 供电/放电异常

正式网表确认K601 COM4=DUT_OUT、NO8=SOURCE_POWER、NC6=DISCH_FEED；R57=1k串接Q902漏极3，源极2=GND，栅极1=DISCH_ON；体二极管阳极在GND、阴极在漏极，正目标电压不会经体二极管主动放电。R62与Safety页R37都是100k下拉，直流等效50k。仿真别名DISCH_DRAIN对应自动网络 `Net-(Q902-D)`，未为了命名改线。

硬件稳定逻辑为 `DISCH_ON = DISCH_REQ & SIG_ARM_REQ & SYS_RESETn & !POWER_SAFE`。软件必须另外保证时间顺序：先关MOS并清除旧请求，再等保护间隔再合闸；先断电并等待接点释放/抖动稳定，再显式放电。供电后再次关电不得恢复旧DISCH_REQ。

[HFD2官方资料](https://source.hongfa.com/Uploads/Product/PDF/HFD2_en.pdf)2026Rev1.00，005-S线圈167Ω±10%，额定5V，吸合4.0V max，释放0.5V min；系列动作/释放4.5/3.5ms是在列出的额定条件下。不能把3.5ms直接用于带D601续流的实际释放上限。线圈电感、磁滞和抖动范围未取得；本轮触点电导0.1Ω、1µs转换、7ms释放、2ms抖动及延迟到54ms的压力例均显式假设。

|场景|本轮观察/分析|适用边界|
|---|---|---|
|放电中复位|100µF由5.5V放电约30ms后取消，仍约4.075V；关MOS后保持残压|控制电平按场景正确撤销；不是放电完成|
|旧放电请求尚高时恢复供电|POWER_SAFE上升后MOS栅极有短暂RC尾巴，但假设NO/NC先断后通且毫秒级合闸时，没有电源经NO、NC同时接入放电支路|逻辑与MOS不是零延迟；实测触点重叠/驱动欠压仍必需|
|其他来源持续5.5V|串10Ω外部源用例中DUT约5.4456V，仍持续耗电约5.45mA|不是100ms或任何固定时长能完成的放电；必须先移除持续能源|
|释放/抖动跨越50ms|同一100µF电压高于正常延迟例，实际有效放电窗变短|50ms只可作为待测初值，不能证明接点稳定|
|USB下降/恢复|正常撤销与假设驱动高阻两类用例均停止放电；恢复不自动授权|LVC在低于工作电压期间的输出状态、MCU复位门限不由理想逻辑模型保证|

假设掉电驱动真正高阻，50k与1～3nF栅电容的关断为几十到数百µs量级，仍须实测米勒耦合、门输出和VGS；不能把此参数扫描视为AO3400A掉电保证。GPIO内部复位不应假定外部SYS_RESETn也被拉低；启动保持ARM=0，先写TCA9539输出锁存0、再改方向、最后才允许ARM，防止扩展器旧锁存/默认输出值恢复放电。

R57最小990Ω时，5.5V连续放电功耗约30.56mW，低于其0.1W标称额定；1000µF、5.5V储能15.125mJ。1/100/1000µF仅是试验电容范围，不是用户确认的最大目标电容。正常供电/测量时NO接通、NC机械隔离放电支路；关闭供电但不放电时Q902关。无DUT_OUT采样、无触点反馈，软件只报告“计时结束，残余电压未知”，不自动声称目标已断电/放电完成。

## 3. Vref与ADC

[HPM5300 DS Rev0.11](https://www.hpmicro.com/Public/Uploads/uploadfile/files/20250205/HPM5300DSV011.pdf)表35/PDF58给出Cs=4pF、Ron=300Ω，只有典型值，没有独立可保证的最大源阻抗或Cs/Ron上限。按[官方ADC设计指南](https://www.hpmicro.com/Public/Uploads/uploadfile/files/20240620/HPMxilieMCUgaojingduADCzhiwuchafenxiheshejizhinan.pdf)§3.2，应联合源阻抗、外部电容和采样时间计算，不能直接使用2MSPS宣传指标。

当前U901 NO后的68k/68k与1nF完整分压保留。U901 Ron用5Ω典型等效，Rth约34.001kΩ、初始τ约34µs。ADC采样电容每次按0V或3.3V前通道残留重新预充是压力激励，不是对真实SAR内部重置方式的断言。

|测试|ADC端采样末误差（相对同一分压的理想值）|
|---|---:|
|Cs4pF/Ron300Ω，采样0.2µs、1ksps|约−6.54mV|
|Cs4pF，前通道3.3V，5µs、10ksps|约+5.99mV最大残留|
|Cs4pF/Ron300Ω，400µs、1ksps|约−0.054µV|
|Cs16pF/Ron2kΩ/C61=1.265nF压力点，400µs|约−2.119µV|
|同压力点步长0.5→0.25µs、reltol1e-6→1e-7|约−2.120µV，差约0.00065µV|

短窗时即使接通后已等1ms，采样瞬间的电荷共享仍能重新拉低ADC节点；“先等RC稳定”不能代替足够的采样窗。4pF与1nF共享1.65V满幅差，跳变量约6.57mV，与仿真量级一致，排除把ADC复位激励直接接到滤波电容的测试台伪影。长窗结果只说明给定RC模型可恢复，不代表16位整机精度。

建议首板配置：U901显式接通后等待**1ms**，ADC初始化执行SDK校准，16位单端；每次采样窗至少**400µs**，转换间隔至少1ms，通道切换/首次接通先丢弃2次，再取8点平均。示例实际ADC时钟10MHz时，`sample_cycle=256, sample_cycle_shift=4`对应409.6µs；必须先读回时钟/分频和寄存器确认，不能照抄200MHz母时钟当采样时钟。锁定SDK的SAMPLE_CFG为9bit周期、3bit移位；16位转换21个ADC周期。该建议未加入真实固件。

误差预算还包括：两颗0.1%电阻最坏比例约±0.1%，25ppm/°C反向漂移按距25°C±5°C另约±0.0125%；开关Ron及温漂；ADC输入漏电每1nA约造成目标端68µV误差；参考源P3V3未校准可达此前筛选的3.1816～3.4216V；ADC偏移/增益/INL、参考噪声/通道串扰只有部分典型数据。量化步长在3.3V参考下约50.35µV/ADC码，目标端翻倍，不能当作准确度。未取得ADC输入最大漏电和Cs/Ron上限，因此不报告全容差总误差保证；需外部校准并扫真实输入及采样率。

U901接通时分压从目标取13.235～24.264µA，测量锁期间不接通，返回不可用/带时间戳的过期值。1ms和400µs均不会改变这条锁约束。

## 4. 40MHz与初步布局

沿用已复核的 [上游实际时序](upstream-swd-timing.md)：SWD SPI Mode0连续读回按下一上升沿取上一位、周期25ns；JTAG TDO通常只有12.5ns半周期。首ACK前有turnaround，但DIR的目标端释放与MCU端接管都需单独检查，不能用源码行数估计纳秒间隔。读结束提前DIR=1、WAIT/FAULT和重新写出路径仍需编译后/示波器证据。

资料上界已在未加目标输出/FSA/线缆时出现缺口：LVC1T45在1.8V的SWD时钟+返回+HPM建立为33.8ns，大于25ns；3.3V约21.6ns只余3.4ns。JTAG1.8V约30.9ns大于12.5ns。此为保守筛选失败，不等于实板必然失败，不降低40MHz验收目标。

本轮初步布局时钟路径经U1.24→U701.3/4→U801.4/3→J801.9，曼哈顿分段尺度约58mm，属于布局走线通道估算，未包含最终绕线/过孔，不是实际铜线长度。20cm排线在假设传播速度1.5～2.0×10^8m/s时单程约1～1.33ns，双程2～2.67ns；FR4板上每60mm按150mm/ns假设另约0.4ns/程。剩余时间还需目标tCO和开关/负载，不能由这个估算宣布40MHz可行。

**实际串阻位置**：R1/R2各22Ω在MCU的SWD MOSI/MISO分支；TCK、TDI、TDO到FSA/接口没有独立源端串阻。不能把22Ω错误套到所有通道，也不能把两个SWD电阻当单个44Ω。按Rdriver=20Ω、FSA=5Ω假设，30/60/100pF及0/22/47Ω扫描，RC到70%阈值约0.9～8.7ns；只是负载敏感性，不与手册已包含15pF负载的传播延迟直接相加，以免重复计算。没有使用最高Mbps证明时序。

后续须在完成布线/实际叠层后提取走线、过孔、连接器与20cm排线模型，使用准确LVC1T45 DBVR的IBIS/阈值和FSA寄生；缺模型时测TDR/边沿/负载后定界。串阻是否增配要依波形和完整成本决定，本轮未增加。必须选本身支持40MHz的目标分别验收SWD/JTAG、三电压、DIR、OK/WAIT/FAULT，自动降速不是40MHz通过。

## 5. 内置持续1A与保护协调

保留TPS63810YFFR、MWSA0603S-R47MT、TPS22950CDDCR/R42=806Ω，不用TPS63811或旧TPS22950/YBH模型替代。TPS22950C阈值1.114～1.861A仍是先前±25%假设筛选，不是806Ω厂家保证，逐板1A/过载/短路/温升门槛不变。

TPS63810准确手册的buck测试条件限流最小3.8A、最大5.2A，boost列最大6.5A；不能把这些不同条件的表值当作任意输入下输出电流保证。L4 0.47µH±20%、DCRmax4.1mΩ、表列饱和16A/典型20A，6.5A×1.2=7.8A低于表列16A，支持静态选型余量；磁芯损耗、热降额、浪涌和实际布局不由此保证。

下表是VIN=4.5V、η=85%、USB侧辅助电流0.25A、L=0.376µH、f=2MHz的工程筛选，效率/频率均不是保证下限。1A栏不含DUT端接点/线缆损耗补偿：

|输出|USB总输入估算|L4峰值估算|转换器损耗估算|
|---|---:|---:|---:|
|1.8V/1A|0.721A|1.718A|0.318W|
|3.3V/1A|1.113A|1.585A|0.582W|
|5V/1A|1.557A|1.606A|0.882W|
|5V/1.861A筛选故障点|2.683A|2.732A|1.642W|

5V/1A不能在上述条件下靠1.5A USB预算保证，应在获准3A来源和验证后的预算下验收最高能力；不改变1A目标。U102的R11/R12/R14控制档位按TI公式 `ILIM≈2000/R+0.04` 得默认约0.441A、只开T1约1.346A、只开T2约1.774A、两者约2.679A，均未计器差/电阻/NMOS。满功率与U503故障上沿相近时U102可能先限流，不能声称选择性保护已配合。R11=4.99k±1%的高角5039.9Ω还略超U102推荐5000Ω上沿，作为采购/边界待办记录；本轮未在缺少核价时换成4.87k。

U102 FLT在资料中**不报告普通限流、欠压及过压钳位的全部事件**，不能只靠FAULTn实现电源状态确认；本板仍没有USB_5V/DUT_OUT/VIO连续电压回读。USB下降及自动恢复过程中需验证CC预算、MCU复位、I/O扩展器和继电器，欠压高阻门行为尚未硬件闭合。

U503正常1A按1.8/5V条件RONmax116/54mΩ，损耗约0.116/0.054W；短路必须按压差×电流，5V×1.861A约9.3W瞬时，不能套I²RON或依赖无限自动重试。TPS63810按80.5°C/W测试板热阻，0.882W约71°C温升、1.642W约132°C，只是筛选，不能代替本PCB/透明盖环境温升。外部2A不经U503，应由外部源另行限流。

K601闭合到已带电电源时，DUT电容热接入不受U501最初软启动的自动保护。1000µF充到5V需5mC；若同时拉1A、仅余约0.114A筛选限流余量，理想充电已约44ms，且USB可能先限流。C40/C41的DC偏压有效容量、C39输入至少5µF有效值、U102 dVdt、触点抖动与所有辅助负载必须联合实测。无DUT_OUT采样，不能用设定5V证明端子在1A时仍5V；接点/限流开关/线缆压降分别记录。

## 6. 实施、成本与投板门槛

本轮落实了测试台、可执行安全策略及接口/审查说明；未改变原理图或BOM，材料差额 **¥0/板、¥0/10套**，未刷新或假称锁定嘉立创库存。完整材料快照仍见 [成本说明](cost.md)，实测/校准工时及仪器不按0元计算。

软件参考模型修复了“连接中收到配置失败时，仅关闭VIO却未隔离信号”的策略漏洞：现先隔离，并有专门测试。该修复仅作用于本次新增参考模型，不表示此前已发布固件存在该实现。复位/掉电清旧请求、旧异步回调代号校验、定时结束电压未知等均已有测试。

未解决、不能从仿真删除的门槛：

- VIO全容差动态、真正关机/启动过冲、DAC异常、有效容量/ESR、外部校准±1%；缺可信模型时以示波器和外部表实测。
- USB慢降/反复恢复、SYS_RESETn与内部复位差异、LVC欠压输出、Q902栅极、继电器带续流释放/抖动与插入电容。
- ADC最大Cs/Ron/输入漏电、内部参考关联与通道切换、板上噪声；400µs方案为首板建议。
- 40MHz联合时序/信号完整性、持续1A/过载/短路热、实际线束及机械装配。
- ≤140nA、20～30°C整夹具附加电流仍未闭合；14路FSA的25°C上限和已占满140nA，覆盖温区的筛选700nA再加U901/线束/PCB，均不是实测值或放宽后的目标。USB掉电而目标仍供电的FSA保护仍在支持范围之外。
- PCB当前仍有未布线和DRC问题，结构件未完成，不能生成“已可下单”的制造包。

本轮不需要用户新增需求取舍，保持既有低成本打样/外部校准/实测门槛。若后续要求无外部仪器也能确认VIO稳定、输出正确或放电完成，则必须另立检测硬件/接口方案，核价和隔离预算后再决定；本轮没有偷偷恢复已删除的DUT_OUT采样。
