sanchuanhehe/HSLink-LP/docs/procurement-completion.md

# 缺价物料补齐与现货替代设计说明

> 本文保留采购阶段的分析。当前VIO已在2026-11-07改为10k/2.15k/15.4k反馈、USB_5V输入；R42随后按用户接受的低成本打样方案改806Ω±0.1%。旧200k/P3V6_SW及R42=1.15k说明仅为历史基线，当前投用前实测门槛保持。最新选择、成本与待实测项见[余量说明](electrical-margins.md)。

2026-11-07，基线Git `a75267e9c664a8c5521df49eb9d99e4ea88dc895`。沿用唯一 `hardware/design`，上游参考未修改。价格、资料分析、软件检查和硬件验收分别记录；本轮没有板卡、真实设备控制或实测性能结果。

## U501：TPS63810YFFR

[TI SLVSEK4C](https://www.ti.com/lit/ds/symlink/tps63810.pdf) p2～3、p13～17、p22～24：63810与63811为相同15球YFF脚图，输入2.2～5.5V、可调输出1.8～5.2V、25mV步进、7位I²C地址0x75。工程仍限制内置输出1.8～5.0V，并受USB预算限制；没有用产品最大电流替代整板1A验收。

关键差别是63810上电寄存器ENABLE默认为1、VSEL=0默认3.3V；63811默认为禁用输出。硬件EN低仍关闭63810。现有R29=100k将INT_EN拉低，TCA9539复位高阻；K601为独立的常开输出继电器，POWER_REQ与SYS_RESETn互锁保留。U501、U503共享INT_EN，不能声称两者可分别使能。

独立板型固件必须采用以下顺序（**尚未实现**）：

1. 复位/上电先保持POWER_REQ=0、SIG_ARM=0、DISCH_REQ=0；设置GPIO输出寄存器为安全值后再切输出方向。测量锁状态不能由调压或I²C初始化解除。
2. 在K601保持断开时置INT_EN=1；允许内部INT_RAW先到默认3.3V，此时不得给DUT接通。
3. 根据手册配置Control/VOUT1（VSEL硬接GND），必要时先以寄存器ENABLE=0关闭转换输出，再写RANGE和目标码、读回核对后使能。不要假设硬件EN低时可以完成所有I²C操作。1.8～4.975V用RANGE=0；5.0V需RANGE=1、码119。不能全范围沿用同一RANGE。
4. 等待软启动/调压斜坡结束，检查寄存器状态及Power Good。没有在K601前新增独立ADC，因此寄存器回读/PG不等同独立的输出精度测量；首板必须用仪器验证全部启动、负载和调压条件。
5. 只有显式供电命令、测量锁允许、USB预算满足并完成检查时才置POWER_REQ；任何通信错误、欠压/复位恢复均保持断开，不沿用掉电前缓存电压自动恢复。

I²C配置恢复或运行中掉电可能回到默认3.3V，必须纳入故障测试。FSA信号先断开、VIO匹配并稳定后才允许显式恢复信号；串口打开/DTR/RTS/DAP均不得解除测量锁。

电感L4=470nH、输入/输出电容沿用同系列手册起点，数据手册与名义计算不替代损耗、有效电容、稳定性和温升验证。新增YFF封装按厂家顶视图15球、0.4mm间距，详见[逐脚记录](procurement-pinmap.md)。

## U502：同系列DRV封装

[TLV758P SBVS351D](https://www.ti.com/lit/ds/symlink/tlv758p.pdf) p3：DBV的IN1/GND2/EN3/FB4/OUT5分别映射到DRV的6/3/4/2/1；新5为DNC、新7为EP并接GND。使用KiCad标准DRV符号，EP与GND符号脚堆叠，实际网表检查两者均接地。WSON标准land与TI建议的尺寸差异已明列，生产DFM仍未完成。

电路及DAC反馈不变：VIO≈0.55×(1+100/21.5+100/200)−(100/200)×VDAC，即3.38314−0.5×VDAC。R58/R59/R60保持0.1%；VIO继续由USB侧3.6V轨供电，外部测量路径不承担其电流。3.6V轨最小约3.546V，至3.3V有246mV静态余量；仍需检查瞬态、线损、温升和有效输出电容。100mA只是VIO设计预算假设。

## U503：纠正可订购型号

[TI TPS22950x SLVSFJ2B](https://www.ti.com/lit/ds/symlink/tps22950.pdf)器件比较表、p4及订购表支持`TPS22950CDDCR`六脚DDC；此前`TPS22950DDCR`未在表中列出。C版与普通版同为自动重试、具有反向电流阻断；L版才是锁存关断。不能依据JLC商品参数里混杂的“锁存保护”标签推断故障行为。

1=ON、2=VIN、3=GND、4=ILIM、5=VOUT、6=FLTn，与当前工程功能映射一致。C版限流可调范围0.5～3.5A。保留R42=1.15k时，公式ILIM≈1.18×R[kΩ]^−1.072约1.016A；手册表列典型1A、0.75～1.25A（另考虑电阻误差）。**这不能保证向1A负载持续供电，是既有电路待关闭问题，不降低1A需求。** 更改阈值还要同时检查USB预算、启动浪涌及热，未在本次采购核价中擅自调高。

输出短路时可限流而FLT仍为高阻；FLT主要报告热关断/反向电压故障。不能声称现有FAULTn能够直接报告每次过流。过流、热循环、反向阈值/延迟和输出放电均待实测；U503处于内部支路，最终测量隔离仍由来源选择和K601完成。

## ESD、按钮、二极管与反馈

- D101/D102采用[同系列TPD2E2U06DRLR](https://www.ti.com/lit/ds/symlink/tpd2e2u06.pdf)，5.5V VRWM、1.5pF典型、10nA器件漏电上限；不是把典型电容/器件漏电写成整板USB眼图或低功耗保证。原DCK 1/2/3→DRL 3/5/4，两个新增NC保持不接。USB侧保护位置不变，保留数据对与VBUS保护；ESD、USB480Mbps信号完整性待板测。
- SW1/SW2采用XKB TS-1187A-B-A-B，160gf/1.5mm；A/B同电气节点、C/D同节点，使用匹配四land封装，电气仍为两脚常开按钮。功能不变，手感和外壳配合待实测。
- 该阶段D601/D901/D902采用先科/ST 1N4148W（后续已删D902，保留D601/D901），原同类SOD123；1K/2A，75V、150mA，承受USB侧5V继电器线圈约30mA。按5.5V与167Ω−10%示例为36.6mA，低温电阻和动态条件另验。常开触点隔离路径未改变；续流压降影响释放时间，不能沿用未经实测的固定等待时间当保证。
- R38改为300k/1%，新增R401=150k/1%串联；标称和=450k，最坏相关容差仍±1%。R39仍100k，TLV62568标称0.6V基准下输出仍3.3V。仅电阻比带来的输出示例范围约3.2465～3.3545V，另叠加基准、温漂和负载误差；不得说串联组合提升了精度。保持反馈取样点在两颗串联电阻之后，没有分压中点误接。

## 本轮有意网表变化与检查范围

1. 新增R401和BUCK3_RTOP_MID一个网络；原上臂450k拆为300k+150k。
2. ESD与VIO LDO按物理封装重编号，增加4个ESD NC、1个LDO DNC和1个接地EP。
3. U501/U503、按钮、续流二极管仅型号/封装变化，原电气节点关系保留；12颗电平转换器、FSA、Vref/采样/放电/复位/双串口与握手隔离未改。

最终软件检查、实际图面检查及源文件哈希以[validation.json](../hardware/validation.json)为准。硬件仍未验证，PCB未设计，固件/主机真实传输仍未实现。完整材料价仅说明采购位号已核齐，不关闭40MHz、0.14µA、内置1A/外部2A、源开关DC/BBM和其他验收目标。

## 同轮 ARM20 变更

J801换带键ARM20，nTRST移至3、nRESET移至15，删除独立J802；2/11/17/19不接。逐针定义、连接器/排线型号与物理映射见 [ARM20接口说明](arm20-interface.md)。连接器变化属于明确的网表重分配，七路目标信号仍只连接原隔离器件，其他网络按基线变换后比较。该采购补齐/ARM20阶段为200位号、57行BOM；之后[检测/放电优化](sense-discharge.md)删除K902/D902，当时198位号、57行；本轮单Vref修改后为194位号、58行，配件单列。

2026-11-07复核：3.3V VIO距3.6V前级的压差虽大于表列dropout上限，但小于TLV758精度测试的0.5V条件，不能直接套用其精度界限。该采购阶段未改物料或金额；后续R42及VIO已修改，最新状态见[余量说明](electrical-margins.md)。
