sanchuanhehe/HSLink-LP/docs/costdown-pinmap.md

# 降本器件物理引脚核对

日期：2026-11-07。范围仅为原理图符号与封装引脚映射；不代表 PCB、额定负载、寿命或漏电验证通过。

通过 MCP 创建／查询符号和封装，临时工程放置后回读全部焊盘并导出原理图与 PCB 图面检查。项目库查询存在缓存缺陷，验证时临时注册全局库，完成后删除；正式工程仅引用项目库。坐标为元件面顶视图，X 向右、Y 向下，以封装原点为基准。定制封装以方形 1 脚焊盘和其外侧丝印短条标记方向，主体在 F.Fab，院落留 ≥0.25 mm。

## HFD2/005-S

来源：[宏发 HFD2 2026 Rev.1.00](https://source.hongfa.com/Uploads/Product/PDF/HFD2_en.pdf)，PDF 第 4 页；底视图沿水平中轴翻转为顶视图，定位标记在左，顶视 1 脚左下。

符号 `HSLinkLP:HFD2_005_S`；封装 `HSLinkLP:Relay_Hongfa_HFD2`。引脚／符号脚／电气焊盘均为 8，无重复焊盘、散热焊盘或机械孔。映射核对：通过；非整板硬件签核。

| 实物端子 | 功能 | 符号脚／类型 | 焊盘 | 顶视 X / Y（mm） | 孔径 / 尺寸（mm） |
|---|---|---|---|---|---|
| 1 | COIL+ | 1 / passive | 1 | -8.8900 / 3.8100 | 1 / 1.8×1.8 |
| 4 | COM1 | 4 / passive | 4 | -1.2700 / 3.8100 | 1 / 1.8×1.8 |
| 6 | NC1 | 6 / passive | 6 | 3.8100 / 3.8100 | 1 / 1.8×1.8 |
| 8 | NO1 | 8 / passive | 8 | 8.8900 / 3.8100 | 1 / 1.8×1.8 |
| 16 | COIL− | 16 / passive | 16 | -8.8900 / -3.8100 | 1 / 1.8×1.8 |
| 13 | COM2 | 13 / passive | 13 | -1.2700 / -3.8100 | 1 / 1.8×1.8 |
| 11 | NC2 | 11 / passive | 11 | 3.8100 / -3.8100 | 1 / 1.8×1.8 |
| 9 | NO2 | 9 / passive | 9 | 8.8900 / -3.8100 | 1 / 1.8×1.8 |

## 2MD1T1B1M2QES-5

来源：[Dailywell 图号 2MDP0428 Rev.A](https://www.thonk.co.uk/wp-content/uploads/2017/05/DW3-DPDT-ON-ON-2MD1T1B1M2QES.pdf)，第 1 页 PC MOUNTING 元件面，与端子视图左右镜像；1 脚左下。

符号 `HSLinkLP:Dailywell_2MD1T1B1M2QES_5`；封装 `HSLinkLP:SW_Dailywell_2MD1T1B1M2QES_5`。引脚／符号脚／电气焊盘均为 6，无重复焊盘、散热焊盘或机械孔。映射核对：通过；非整板硬件签核。

| 实物端子 | 功能 | 符号脚／类型 | 焊盘 | 顶视 X / Y（mm） | 孔径 / 尺寸（mm） |
|---|---|---|---|---|---|
| 1 | INT | 1 / passive | 1 | -2.5400 / 2.5400 | 1.1 / 1.9×1.9 |
| 2 | COM | 2 / passive | 2 | -2.5400 / 0.0000 | 1.1 / 1.9×1.9 |
| 3 | EXT | 3 / passive | 3 | -2.5400 / -2.5400 | 1.1 / 1.9×1.9 |
| 4 | INT_ID | 4 / passive | 4 | 2.5400 / 2.5400 | 1.1 / 1.9×1.9 |
| 5 | ID_COM | 5 / passive | 5 | 2.5400 / 0.0000 | 1.1 / 1.9×1.9 |
| 6 | EXT_ID | 6 / passive | 6 | 2.5400 / -2.5400 | 1.1 / 1.9×1.9 |

## TLV75801PDBVR

来源：[TI SBVS351D](https://www.ti.com/lit/ds/symlink/tlv758p.pdf)，第 3 页图 4-2，DBV 顶视图，1 脚左上，左列向下编号。

符号 `Regulator_Linear:TLV75801PDBV`；封装 `Package_TO_SOT_SMD:SOT-23-5`。引脚／符号脚／电气焊盘均为 5，无重复焊盘、散热焊盘或机械孔。映射核对：通过；非整板硬件签核。

| 实物端子 | 功能 | 符号脚／类型 | 焊盘 | 顶视 X / Y（mm） | 孔径 / 尺寸（mm） |
|---|---|---|---|---|---|
| 1 | IN | 1 / power_in | 1 | -1.1375 / -0.9500 | None / 1.325×0.6 |
| 2 | GND | 2 / power_in | 2 | -1.1375 / 0.0000 | None / 1.325×0.6 |
| 3 | EN | 3 / input | 3 | -1.1375 / 0.9500 | None / 1.325×0.6 |
| 4 | FB | 4 / input | 4 | 1.1375 / 0.9500 | None / 1.325×0.6 |
| 5 | OUT | 5 / power_out | 5 | 1.1375 / -0.9500 | None / 1.325×0.6 |

## MCP4726A0T-E/CH

来源：[Microchip DS22272C](https://ww1.microchip.com/downloads/aemDocuments/documents/OTH/ProductDocuments/DataSheets/22272C.pdf)，第 1 页 CH/SOT-23-6 引脚图、第 33 页表 3-1、第 76～77 页封装及推荐焊盘；器件面顶视，定位点所在 1 脚左上，左列向下为 1/2/3，右列向上为 4/5/6。不是 DFN 图，第 6 脚为 VREF，不是旧 MCP4725 的 A0。

符号 `HSLinkLP:MCP4726A0T_E_CH`；标准封装 `Package_TO_SOT_SMD:SOT-23-6`。数据手册实物脚、符号电气脚和封装电气焊盘均为 6，无重复、散热或机械焊盘。已通过 MCP 查询及临时工程放置、焊盘回读和实际渲染检查；未代表 PCB/硬件验收。标准封装有 1 脚外侧三角丝印及 F.Fab 倒角，六个焊盘均为顶层 SMD roundrect、无孔，验证时器件置于 F.Cu、旋转 0°；库查询包含 F.Cu/F.Paste/F.Mask。院落中心线尺寸 4.1×3.4 mm。MCP 焊盘接口未返回逐焊盘层集及旋转字段，不将这些字段记为已独立回读通过。

| 实物端子 | 功能 | 符号脚／类型 | 焊盘 | 顶视 X / Y（mm） | 孔径 / 尺寸（mm） | 图示依据 |
|---|---|---|---|---|---|---|
| 1 | VOUT | 1 / output | 1 | -1.1375 / -0.9500 | 无孔 / 1.325×0.6 | p.1/33，顶视左上 |
| 2 | VSS | 2 / power_in | 2 | -1.1375 / 0.0000 | 无孔 / 1.325×0.6 | p.1/33，顶视左中 |
| 3 | VDD | 3 / power_in | 3 | -1.1375 / 0.9500 | 无孔 / 1.325×0.6 | p.1/33，顶视左下 |
| 4 | SDA | 4 / bidirectional | 4 | 1.1375 / 0.9500 | 无孔 / 1.325×0.6 | p.1/33，顶视右下 |
| 5 | SCL | 5 / input | 5 | 1.1375 / 0.0000 | 无孔 / 1.325×0.6 | p.1/33，顶视右中 |
| 6 | VREF | 6 / input | 6 | 1.1375 / -0.9500 | 无孔 / 1.325×0.6 | p.1/33，顶视右上 |

采用 KiCad 通用 SOT-23-6 焊盘：0.95 mm 节距、左右焊盘中心距 2.275 mm、单焊盘 1.325×0.6 mm。原厂第 77 页推荐中心距为 2.8 mm、单焊盘 1.1×0.6 mm；本工程没有逐尺寸复制原厂推荐图。引脚顺序和节距已核对，最终焊盘可制造性仍须结合装配工艺进行 DFM。

VREF 接 GND；使用 VDD 参考（VREF1:VREF0=00）、1x 增益和正常模式。内部参考选 VDD 时，第 6 脚与内部电阻梯隔离（手册第 34 页）。地址 A0 订货版本为固定 0x60，不能再将第 6 脚视作地址设置。初始化和错误处理要求见 [降本设计](cost-down.md)。

## AO3400A

来源：[AOS AO3400A Rev.3.1](https://www.aosmd.com/sites/default/files/res/datasheets/AO3400A.pdf)，第 1 页 SOT-23 Top View，点标所在 G 端为 1；旋转到库顶视图为左上 G、左下 S、右侧 D。

符号 `Transistor_FET:AO3400A`；封装 `Package_TO_SOT_SMD:SOT-23`。引脚／符号脚／电气焊盘均为 3，无重复焊盘、散热焊盘或机械孔。映射核对：通过；非整板硬件签核。

| 实物端子 | 功能 | 符号脚／类型 | 焊盘 | 顶视 X / Y（mm） | 孔径 / 尺寸（mm） |
|---|---|---|---|---|---|
| 1 | G | 1 / input | 1 | -0.9375 / -0.9500 | None / 1.475×0.6 |
| 2 | S | 2 / passive | 2 | -0.9375 / 0.9500 | None / 1.475×0.6 |
| 3 | D | 3 / passive | 3 | 0.9375 / 0.0000 | None / 1.475×0.6 |

## 1N4148W-7-F

来源：[Diodes DS30086 Rev.32-2](https://www.diodes.com/assets/Datasheets/ds30086.pdf)，第 1 页 SOD123 顶视及阴极条纹，第 4 页封装；厂家未标数字，工程明确规定条纹 K 为焊盘 1，A 为焊盘 2。

符号 `Device:D`；封装 `Diode_SMD:D_SOD-123`。引脚／符号脚／电气焊盘均为 2，无重复焊盘、散热焊盘或机械孔。映射核对：通过；非整板硬件签核。

| 实物端子 | 功能 | 符号脚／类型 | 焊盘 | 顶视 X / Y（mm） | 孔径 / 尺寸（mm） |
|---|---|---|---|---|---|
| 1 | K | 1 / passive | 1 | -1.6500 / 0.0000 | None / 0.9×1.2 |
| 2 | A | 2 / passive | 2 | 1.6500 / 0.0000 | None / 0.9×1.2 |

## 需实板／供应商确认

- 来源开关Q银触点的3A/28VDC来自2M系列手册，官方FAQ另支持SPDT先断后通/DPDT两组SPDT；准确-5图纸未专列转换保证。保留型号/接线，首板测双极转换和浪涌；不能由ON-NONE-ON的NONE推导BBM，也不因资料缺项认定会短接。详见[原厂依据与待确认建议](electrical-margins.md#来源开关)。
- HFD2 的最小负载 10 mV / 10 µA 为厂家参考值，需按实际负载确认。检测分压改为 68k + 68k；供电触点低电流接触可靠性、2 A 压降、寿命、浪涌与温升均待测。
- 元件封装已提供，PCB 尚未设计，焊盘可制造性与板级间距仍需 DRC／DFM。
