sanchuanhehe/HSLink-LP/docs/level-translation.md

# 电平转换：12 颗 SN74LVC1T45DBVR

2026-11-07，按用户确认落实到唯一的 `hardware/design` 工作区。U701～U712 采用 **SN74LVC1T45DBVR / C7843 / SOT-23-6**；40 MHz SWD/JTAG 保留为验收目标，**待实测，未通过硬件验收**。采用的是打样电路方案，不是全条件时序保证。基线为 Git `996f6b8`，原理图、BOM、采购快照与成本摘要同步更新。

上游固件的 SWD 连续读回是上升沿到下一上升沿、接近一个周期的窗口；先前误用半周期排除 LVC 的理由已经撤回。源码、换向及 HPM 输入建立时间见 [上游时序复核](upstream-swd-timing.md)。独立改版固件与真实 HID 控制协议仍未实现。

## 通道和电压

|位号|A 端（主控侧）|B 端（FSA 夹具侧）|DIR|
|---|---|---|---|
|U701|TCK_MCU|F_TCK|P3V3，A→B|
|U702|SWD_MCU|F_SWDIO|SWD_DIR 动态控制|
|U703|TDI_MCU|F_TDI|P3V3，A→B|
|U704|TDO_MCU|F_TDO|GND，B→A|
|U705|UART_A_TX|F_UART_A_TX|P3V3，A→B|
|U706|UART_A_RX|F_UART_A_RX|GND，B→A|
|U707|UART_A_DTR|F_UART_A_DTR|P3V3，A→B|
|U708|UART_A_RTS|F_UART_A_RTS|P3V3，A→B|
|U709|UART_B_TX|F_UART_B_TX|P3V3，A→B|
|U710|UART_B_RX|F_UART_B_RX|GND，B→A|
|U711|UART_B_DTR|F_UART_B_DTR|P3V3，A→B|
|U712|UART_B_RTS|F_UART_B_RTS|P3V3，A→B|

全部物理脚号固定为 1=VCCA/P3V3、2=GND、3=A、4=B、5=DIR、6=VCCB/VIO_LOCAL。DIR 只控制方向，没有 I²C 地址、寄存器或独立 OE。VIO_LOCAL 由 USB 辅助供电域独立生成，调节范围仍为 1.8～3.3 V；不从 DUT 或外部仪器的电流测量路径取电。

VIO 电源 U502 TLV75801＋U504 MCP4726 保留。外部 DUT 电源接入不代表数字接口电压已经匹配；DUT 可用 5 V 供电，但本板数字接口仍只接受 1.8～3.3 V。nRESET/nTRST 继续使用 Q701/Q702 开漏电路及 U804 FSA 通道，不混入这 12 路计数。四颗FSA与接口、复位、Vref和放电断开链路保留；后续用户确认取消DUT_OUT回读，Vref改U901，供电范围不变。

## 实际电路变更与默认状态

- 原 U701 LXC8 与 U702～U704 LXC2 改成 12 颗单路；原双路未用通道及 R46/R47/R48 删除。
- 每颗分别对 VCCA/VCCB 放置 100 nF。保留 C48～C55，增加 C701～C716，共 24 颗；采购仍为 50 V X7R 0603 C14663，图面简写 100n。
- 删除原八路芯片专用的 U305 /OE 反相器、C32 及 XLAT_OEn 网络；**U304 放电互锁反相器保留**。SIG_ARM 及分组硬件互锁仍控制 FSA，不能再把 SIG_ARM=0 描述为关闭转换器输出。
- R701/R703 将 TCK/TDI 的主控侧输入以 100k 下拉。R705/R707/R708/R709/R711/R712 将 UART TX/DTR/RTS 的主控侧输入以 100k 上拉，给出物理高电平默认值；DTR/RTS 的逻辑有效极性需在独立固件协议中明确，不能假定开串口即可连接目标。
- R702/R704/R706/R710 将四个返回通道的 B 端以 100k 上拉到 VIO_LOCAL，全部位于 FSA **夹具侧**。断开后给接收输入确定电平；闭合并由目标拉低时会增加 18～33 µA 的通信态负担，不把这一状态混入测量断开漏电验收。
- R713 将 SWD_DIR 以 100k 下拉，复位默认 B→A。MCU 必须先把共享 SWD 输入支路设为安全状态，再切换 DIR、启用 SPI/MOSI；原 R1/R2 的 22 Ω 支路保留。弱偏置和 Ioff 不等于无争用或整板掉电隔离证明。

无 OE 的 LVC1 输入级始终活动。调压流程须先停传输、断开所有 FSA（含复位）、把 MCU 输出和 SWD_DIR 置为已定义状态，再调整 VIO；不能继续调用并不存在的 XLAT_OEn 来禁能。数据手册的隔离条件是某电源脚达到 GND，不能推导悬浮或斜坡电压下也已高阻。

正常恢复连接前，在允许检测的显式流程里读取目标 Vref、配置 VIO 并等待稳定。当前没有独立 VIO ADC，DAC 写入/读回正确不等于模拟电压正确；稳定等待时间、精度、过冲和降压残余电压必须实测定界。MEASURE 锁定时可拒绝调压，或保持断开后执行；完成后不得自动解除锁，也不能为了读取 Vref 暗中置高SENSE_ON接通U901。串口打开、DTR/RTS、DAP 命令均无隐式解锁权限。

## 符号、封装与排版

采用 KiCad 标准符号 `Logic_LevelTranslator:SN74LVC1T45DBV` 和 `Package_TO_SOT_SMD:SOT-23-6`；按 TI SCES515N 的 DBV **顶视图**逐脚比对，不能混用上游 DCK/SC70。暂存测试工程中已放置符号和封装、回读 6 个焊盘并查看导出图，记录见 [物理引脚检查](jlc-pinmap.md)。正式板尚无 PCB，因此这里只完成封装分配，不宣称 PCB 布局、DRC 或生产 DFM 通过。

电平转换页改为 A3，按调试、串口 A、串口 B 三行四列分组，底部保留开漏复位与 DIR 默认状态。沿用上游短引线、全局标签和电源符号风格；实际查看默认字体和 Arial 导出图，电源、位号、数值与标签分开放置。

## 1.8 V 最坏时序

依据 TI 原厂数据手册：

- [SN74LVC8T245](https://www.ti.com/lit/ds/symlink/sn74lvc8t245.pdf)，SCES584D，May 2026，p4 脚号、p11 §5.9、p12 测试负载图。
- [SN74LVC1T45](https://www.ti.com/lit/ds/symlink/sn74lvc1t45.pdf)，SCES515N，June 2024，p2 DBV 顶视脚号、p8 §5.8、p12 测试图及 Enable Times 计算说明。
- [SN74LXC8T245-Q1](https://www.ti.com/lit/ds/symlink/sn74lxc8t245-q1.pdf)，SCES920B，March 2023，p13。
- [SN74LXC2T45](https://www.ti.com/lit/ds/symlink/sn74lxc2t45.pdf)，SCES938B，May 2022，p14。

LVC 表为 VCCA=3.3±0.3 V、VCCB=1.8±0.15 V、推荐工作温度范围和数据手册规定负载；不是 25°C 典型数值。LXC 下表采用 −40～85°C 列，125°C 列更慢。没有把产品首页的 Mbps 换算成 SWD 频率。

|通路|最大延迟 ns|影响|
|---|---:|---|
|LVC8 A→B|21.2|固定输出 TCK 的最坏传播延迟|
|LVC1 A→B|15.5（低→高）；12.6（高→低）|SWDIO 写出或全单路方案的时钟|
|LVC1 B→A|8.3 / 7.1|SWDIO、TDO 读回|
|LVC1 DIR→B 关闭|20.5|主控放弃总线后，目标开始驱动前需要保证释放|
|LVC1 DIR→A 开启|27.6|读方向建立；该开启时间为手册计算值，不能忽略|
|LVC1 DIR→B 开启|21.1|恢复写方向|
|LVC8 /OE→B 关闭 / 开启|29 / 27.7|只用于分组启停，不是在每个数据位切 OE|
|原 LXC8 A→B|15（125°C 为 16）|原时钟路径|
|原 LXC2 B→A|16（125°C 为 17）|原返回路径|
|原 LXC2 A→B|17（125°C 为 18）|把时钟挪到空余双路并不能直接解决延迟|
|原 LXC2 DIR→A 开启|37（125°C 为 39）|原方案换向本身也需要时序验证|

40 MHz 周期为 25 ns。上游 SPI 的 CPOL=0、CPHA=0，SWD 目标在上升沿更新、探针在下一上升沿采样；因此连续 SWD 返回应按整周期核算。此前“目标下降沿更新→主控上升沿”的 12.5 ns 模型误用于 SWD，现予纠正；该半周期关系适用于通常的 JTAG TDO，须分开评估。

仅转换器部分：混合候选最坏和为 29.5 ns，全单路为 23.8 ns。但 HPM5300 Rev0.11 表 39 另要求 SPI 主模式输入建立时间 10 ns；加上后分别为 39.5 ns 和 33.8 ns，尚未含目标、FSA、线缆、负载及抖动。原 LXC 对应 41 ns，也没有最坏时序证明。全 LVC1 在 3.3 V 的两转换器＋HPM 建立时间为 21.6 ns，剩余 3.4 ns 仍要覆盖其余通路。这些是手册上界筛选，不是实物失败判定，也没有把手册全温条件添加为用户已确认验收要求。

DIR→A 的 27.6 ns 不能直接与 25 ns 比较并据此否定换向。源码在请求段结束后才改 DIR，随后配置接收，并丢弃 n 个 turnaround 采样；首个有效 ACK 约在 DIR 改变后的 `g+nT`。B 端关闭、目标开始驱动、MCU MOSI 接管和返回输出须分别检查；段间的软件等待不能增加连续 32 位数据段内的采样预算。详见 [逐段源码与计算](upstream-swd-timing.md)。

## FSA、串阻和负载

FSA 通信期间保持导通；其开合时间不是每位传播延迟。导通电阻、器件电容、22 Ω 的 SWD 分支、双 MCU 引脚负载、走线、连接器、线缆和目标延迟都要计入波形预算。≤10 cm 短线只是初版假设，不是已实测的允许线长。不得引用产品最高 Mbps 直接证明 40 MHz SWD/JTAG。

LVC1 的 µA 级 Ioff 不是 ≤0.14 µA 的夹具保证。低功耗隔离由FSA、U901与K601常闭触点分别承担。14路FSA在25°C的上限和140 nA已占满新目标，覆盖20～30°C的全温表值和为700 nA，尚未含其他支路，问题仍开放。连接目标信号期间保持USB供电；USB掉电而目标仍供电的FSA保护不在首版支持范围。

## 十套同平台费用

嘉立创 SMT 自营、人民币含税，2026-11-07 本次重新读取 C7843、C14663、C25803、C2868232、C5217891、C7827 的渲染页面。其余物料沿用同日已记录快照，非订单锁价。C7843 库存快照 254,502，120 颗档单价 **¥0.408**（此前 ¥0.410），12 颗 **¥4.896/板，十套 ¥48.96**。

|受影响物料组（按全板合并用量）|旧方案/板|新方案/板|变化|
|---|---:|---:|---|
|转换器|¥19.1900|¥4.8960|4 颗 LXC → 12 颗 DBVR|
|全板 100nF C14663|35×¥0.0566 = ¥1.9810|50×¥0.044 = ¥2.2000|增加 16 颗去耦、删除 C32；十套从 350 跨到 500 颗档|
|普通 100k C25803|31×¥0.0176 = ¥0.5456|41×¥0.0176 = ¥0.7216|删除 3 颗未用通道偏置，增加 13 颗默认偏置|
|SN74LVC1G04 C7827|2×¥0.395 = ¥0.7900|1×¥0.395 = ¥0.3950|删除 U305；保留 U304，所以该种换料费不减少|
|上述物料合计|¥22.5066|¥8.2126|**材料省 ¥14.294/板、十套 ¥142.94**|

转换芯片种类由 2 种变 1 种。按 ¥20/种/订单、无券情景，另省 ¥20/十套；材料＋该换料费情景合计省 **¥162.94/十套**。若各 MPN 额外备 10%（DBVR 132 颗仍在 50+ 档），相同口径的材料差额加换料费为 ¥177.234/十套；这不是平台实际备损要求。

原已核价整板子集 ¥127.0051/板，经本次价格刷新重算旧设计为 ¥126.9666/板，价格变动 ¥0.0385/板单列，不能算换料收益。该轮新设计已核价子集 **¥112.6726/板、十套 ¥1,126.726**，当时另有11个位号缺价。后续采购补齐与ARM20升级已完成，当前完整金额见成本文档；此处保留历史同口径降本计算，不作为当前整板总价。全部拆分见 [成本](cost.md)与 [机器摘要](../hardware/bom/cost-summary.json)。

本次变更相关 SMT 焊点：旧转换器 48＋去耦 16＋未用偏置 6＋U305 5＋C32 2 = 77；新转换器 72＋去耦 48＋偏置 26 = 146，净增 **69 焊点/板**。PCB 面积、布线、真实备损/MOQ、焊点费用及实际换料优惠尚未定价，**整板最终净节省未知**。12 个 SOT-23-6 的 courtyard 简单面积和约 167.28 mm²，仅芯片占位量级，不含去耦、间距和布线，不作为板面积增量。

未采用混合 LVC8＋4×LVC1：用户选定全单路，且 LVC8 在 1.8 V 的时钟最大延迟更大。未采用上游 DCKR：封装较小但此前同平台 120 颗报价 ¥1.10/颗更高；本轮没有刷新该候选报价，不计其收益。原 LXC 组合只作同口径成本/时序基线，不能当作已经满足 40 MHz。

报价：[C7843](https://www.jlc-smt.com/lcsc/detail/C7843.html)、[C14663](https://www.jlc-smt.com/lcsc/detail/C14663.html)、[C25803](https://www.jlc-smt.com/lcsc/detail/C25803.html)、[C2868232](https://www.jlc-smt.com/lcsc/detail/C2868232.html)、[C5217891](https://www.jlc-smt.com/lcsc/detail/C5217891.html)、[C7827](https://www.jlc-smt.com/lcsc/detail/C7827.html)。

## 检查状态与实测门槛

资料与软件层：逐脚/封装核对、MCP 换料、独立意图网表比较、原有其他引脚连接比较、ERC 和真实导出图检查，结果及源文件哈希记入 [validation.json](../hardware/validation.json)。这些检查不证明时序和漏电。

硬件层全部待实测：1.8/2.5/3.3 V 的 SWD/JTAG 40 MHz（包括长连续移位）；双 UART 并发和 DTR/RTS；DIR 交接、OK/WAIT/FAULT、读写切换与复位；VIO 上下电/调压/恢复；FSA断开、USB保持供电时的目标连接及≤0.14 µA指标。USB掉电而目标仍供电的FSA保护不列为首版必须通过项；复位/启动默认断开和禁止自动解锁仍须验证。实测需记录实际目标允许频率、芯片批次、固件提交、温度、线缆、负载、示波器探头、采样建立/保持余量和错误计数。

若 1.8 V 或 JTAG 不通过，保留 40 MHz 验收目标，评估有依据的采样相位调整或必要的调试通道器件升级；不得用隐式自动降速记作通过。真实控制协议和测量锁未实现前，不把原理图硬件写成已可由主机完整控制。

VIO硬件双端可调余量、精度条件缺口和启动顺序详见[电源余量](electrical-margins.md#vio调节余量)。软件设置仍限制1.8～3.3V，计算候选不进入现行固件常数。
