sanchuanhehe/HSLink-LP/docs/sense-discharge.md

# Vref检测与受控放电：仅保留一颗继电器

2026-11-07；本轮基线Git `8fb837e`。按用户确认：**保留Vref 1.8～3.3V检测，取消DUT_OUT实测电压回读；供电范围及内/外手动选择、电脑通断、放电不变。** 当前原理图仅K601一颗继电器。采用U901 DG2012EDL-T1-GE3单通道SPDT作可断开的Vref采样开关，删除K901/Q901/D901、R55/R56/C62及ADC_VOUT连接。不是整板漏电或实板验收通过。

## 器件与完整成本比较

嘉立创国内SMT，人民币含税、10套总用量，非单买一套价格，库存未预留。新开关[DG2012EDL-T1-GE3 / C2673178](https://www.jlc-smt.com/lcsc/detail/C2673178.html)扩展库，SC-70-6，库存117，10颗档¥3.80。HFD2/005-S [C42415145](https://www.jlc-smt.com/lcsc/detail/C42415145.html)库存109、10/20颗均¥5.93；AO3400A [C20917](https://www.jlc-smt.com/lcsc/detail/C20917.html)库存1074072、20/30颗均¥0.543；该页报价显示后再次出现验证，证据保留。1N4148W [C81598](https://www.jlc-smt.com/lcsc/detail/C81598.html)沿用同日有效快照，10/20颗均1+档¥0.0754。

|完整检测支路物料|旧两路检测/板|新Vref单路/板|
|---|---:|---:|
|K901+Q901+D901|¥6.5484|删除|
|U901+新增C901|无|¥3.8478|
|R61默认下拉（复用）|¥0.0176|¥0.0176|
|68k/0.1% R53～R56 → R53/R54|¥0.8520|¥0.4260|
|1nF C61/C62 → C61|¥0.1000|¥0.0500|
|完整支路合计|¥7.5180|¥4.3414|

现有USB_5V供电，无新增辅助稳压或目标侧保护支路；公共互锁/U1 ADC保持，不重复计费。R53/R54用[RT0603BRD0768KL / C705793](https://www.jlc-smt.com/lcsc/detail/C705793.html)，20颗1+档¥0.213；C61用[C1588](https://www.jlc-smt.com/lcsc/detail/C1588.html)，10颗¥0.05。C901与全板100nF合并51颗/板、510颗，采用[C14663](https://www.jlc-smt.com/lcsc/detail/C14663.html)的500+档¥0.0478；较旧¥0.044刷新上涨，旧50颗/板基线调整+¥0.1900。R61不增加采购数量；普通下拉与精密分压不混用。

- 同一批价格下的设计节省：**¥3.1766/板、10套¥31.7660**；包括取消DUT采样的功能取舍，不能说完全相同检测功能的无损替换。
- 新增一种扩展库SMT，¥20/种/订单无券情景：10套材料＋换料净省**¥11.7660**（每板分摊¥1.1766）。加入额外10%备损情景后净省¥14.9426/订单。
- 旧完整快照¥127.5161 → 同平台刷新基线¥127.7061 → 当前¥124.5295。直接对旧快照差¥2.9866/板，含价格刷新，不等于纯设计收益。
- 每板删除8个通孔焊点，SMT净少3个焊点；减少约206mm²继电器本体投影但增加小开关/去耦，实际PCB面积与装配费尚不能报价。检测开启时节省约30mA的USB侧线圈电流，非目标电流。

|完整成本|单板/套或分摊|10套|
|---|---:|---:|
|193采购位号＋1测试焊盘，58行板上BOM|¥124.5295|¥1245.2950|
|ARM20配套排线|¥3.8430|¥38.4300|
|实用材料合计|¥128.3725|¥1283.7250|
|板上额外10%备损情景|¥12.45295|¥124.5295|
|额外1条排线|¥0.3843|¥3.8430|
|材料含上述备损|¥141.20975|¥1412.0975|
|32种扩展库SMT×¥20换料情景|¥64.00|¥640.00|
|上述情景小计|¥205.20975|¥2052.0975|
|MOQ余料、PCB、SMT贴装、通孔焊接、钢网/工艺、运输|分别待订单|分别待订单|

未含未知费用的情景小计不是成品总价，制造后完整净节省未知。全板其他物料沿用同日已记录报价；备损按加入后数量重选档，相关档位不变。见[成本](cost.md)及BOM/quotes JSON。

## 选型、连接与电气边界

依据[Vishay DG2012E 75834 RevB](https://www.vishay.com/docs/75834/dg2012e.pdf) p1～3；[逐脚映射](vref-pinmap.md)已完成资料、MCP实例和临时图面检查。不是沿用旧继电器脚号。

`J801.1 DUT_VREF → U901.COM(5) → NO(6) → R53(68k) → ADC_VREF → U1.27`；R54(68k)和C61(1nF)均在开关后接地。U901.NC(4)悬空并标NC；IN(1)=SENSE_ON，V+(2)=USB_5V，GND(3)=GND，C901=100nF去耦。IN低时COM只接悬空NC，NO与整个分压隔离。**NC绝不能接地；目标必须接COM，而不是调换COM/NO。** COM前没有分压、电源取样或额外钳位。J801/PCB/线缆绝缘仍算目标负担。

供电由USB辅助域提供，不接DUT_OUT/Vref/VIO。工作范围1.65～5.5V、模拟输入0～V+；正常5V±10%即4.5～5.5V覆盖Vref最高3.3V。USB最低电压、走线压降和纹波需实测；低于数据表5V表适用范围不能直接沿用其界限。正常采样必须在USB与P3V3稳定后显式允许。P3V3不选作开关电源，因为其负容差无法覆盖3.3V Vref。

5V表控制VIH≥2.4V、VIL≤0.8V；3.3V逻辑U302输出有正常供电余量（量产前还须核对完整VOH/VOL和供电容差）。R61与R36均100k，等效50k下拉；输入漏电最大1µA的简单估算压升0.05V，支持默认低设计意图，不覆盖失电逻辑异常驱动。`SENSE_ON=SENSE_REQ & SIG_ARM`，SIG_ARM受SYS_RESETn约束；MEASURE锁在独立固件中待实现，读Vref/串口/DAP不准自行使能。

USB=0时器件明确提供COM→V+掉电保护；p2在V+=0、COM=4.5V、IN=GND、全温下ICOM(PD)最大±1µA。这说明保护功能，不是零电流，也不对USB掉电套用正常MEASURE的140nA指标。模拟端绝对额定为-0.3～6V而不是V++0.3V，3.3V稳态目标不越限。**USB下降中间区间、反灌实际值、复位和电源斜坡仍待测**；稳态0V规格不能证明整个掉电瞬态。FSA数字信号的既有掉电风险没有因此消失；用户已将USB掉电而目标仍供电的FSA保护排除在首版支持范围。U901器件特性及放电默认关闭要求仍分别保留，不承诺整板掉电隔离。

导通时标称目标负载1.8/136k=13.24µA、3.3/136k=24.26µA；ADC范围约0.9～1.65V。表列4.5V供电的RON最大2Ω（规定COM点与10mA条件），对136k是约15ppm量级估算，不能当整路精度保证。两电阻0.1%最坏分压比例约0.4995～0.5005；34k等效源阻、1nF形成约34µs标称RC，0.1%RC稳定约235µs只是估算，ADC采样电容/输入偏置、误差、开关注入及温度需加入，未定义已验收的固定等待。

## 漏电预算与未闭合项

需求0.14µA适用于夹具正常上电、目标仍供电、MEASURE、25±5°C；USB掉电/OFF/高温另记，绝不以此放宽正常测量指标。

|路径/状态|可引用的边界与缺项|
|---|---|
|U901正常断开NO，NC悬空|5V表NO/NC/COM关断和COM导通电流分别列25°C±5nA、-40～85°C±20nA；测试模拟端为0.5/4.5V。20～30°C审查不能套25°C单点5nA。对实际COM=1.8～3.3V、NC浮置，暂为COM/未选NO合计预留40nA设计预算，**这不是厂家对该状态的总漏电保证**，需测量/厂家确认。|
|FSA2466十四条数字线|25°C的14×10nA=140nA已占满总目标；覆盖20～30°C的−40～85°C表值为14×50nA=700nA。两者是规定测试条件下的预算筛选，不是实测；实际端口/电压组合仍须验证。|
|ARM20线束、连接器、PCB表面|排线最低绝缘5MΩ在3.3V下举例0.66µA，不能支持140nA保证；湿度/污染/焊剂/表面路径必须实测和改进。|
|分压、ADC保护及新增去耦|分压/滤波/ADC在NO之后，去耦由USB供电；没有直接跨到目标前端。器件内部泄漏、耦合和PCB仍须计入。|
|放电与供电|MEASURE中K601吸合，NC机械隔离R57/Q902；接点绝缘不是整板零漏电。OFF时Q902漏电另测，不套MEASURE界限。|
|USB=0|DG2012E表列最大1µA，单列且不套用MEASURE指标；FSA掉电保护属已接受的首版使用限制，不能写成已具备保护。|

用户已将整夹具目标从100nA调整为140nA，20～30°C与测量定义不变。FSA加U901暂定40nA预留的筛选合计为25°C约180nA、覆盖温区约740nA，尚未含PCB/线束；这不是保证值或实测值。因此本次**没有证明满足整板漏电要求**，没有批准700nA或允许投板。只落实用户确认的单Vref打样结构；数字开关、线束、实际供电及PCB预算仍需收敛，失败则继续换料/改连接，而不是用典型值验收。

## 未采用的器件

- TMUX1101/1112：极低漏电，但数字控制fail-safe不等于模拟端掉电保护，目标仍上电时不能仅由USB5V直接供电后宣称满足隔离；若加保护应重新核完整成本，本次不采用。
- TS5A3166：虽然列有powered-down leakage，[TI SCDS186E](https://www.ti.com/lit/ds/symlink/ts5a3166.pdf)修订记录明确移除了掉电隔离特性，模拟端绝对额定受V+限制；不能凭漏电表一行采用。
- TMUX1511：四通道，正常关断全温最大值及器件规模不优于当前单路目标；0V时小漏电单点也不足以保证3.3V/全温。本次不作为已核价替代，不计假设收益。
- 先前为双路5.5V检测筛选的高压方案与K901保留理由属于8fb837e历史；用户已取消DUT采样后不继续要求检测开关承担5.5V或2A。DUT供电本身仍保留外部5.5V/2A、内部5V/1A目标。

## K601触点与Q902连接核对

依据 [宏发HFD2 2026 Rev1.00](https://source.hongfa.com/Uploads/Product/PDF/HFD2_en.pdf) p4 **底视**单稳态图：1/16为线圈，4/13为COM，6/11为NC，8/9为NO。准确型号005-S为5V单稳态敏感线圈，不是自保持。

|引脚|8fb837e之前连接|当前连接（本轮保持）|
|---|---|---|
|K601.4 COM1|SOURCE_POWER|DUT_OUT|
|K601.8 NO1|DUT_OUT|SOURCE_POWER|
|K601.6 NC1|不接|DISCH_FEED → R57.1|
|R57.2|GND|DISCH_DRAIN → Q902.3 D|
|Q902.1 G / .2 S|DISCH_ON / GND|不变；R62=100k栅源下拉保留|
|K601.1 / .16|USB_5V / POWER_COIL_LO|不变，Q601/D601保留|
|K601.13/.11/.9|不接|不接，不并联宣称更高电流|
|K902、D902|独立放电继电器及续流|删除；DISCH_COIL_LO与DISCH_RES网络删除|

[AOS AO3400A Rev3.1](https://www.aosmd.com/sites/default/files/res/datasheets/AO3400A.pdf) p1–2：SOT-23顶视1=G、2=S、3=D。源极接地，体二极管阳极S、阴极D；正电压目标在MOS关闭时不会经体二极管正向放电。负电压可能经体二极管及R57导通，不支持反接；外部持续给DUT供电时，显式放电只形成约5.5mA负载，不能确保把仍在驱动的电源拉到0V。

R57仍为1kΩ±1%、0.1W。5.5V和990Ω时初始电流5.556mA、电阻功耗30.56mW；仅在额定功率适用温度及正确供电范围内有余量，PCB温升/异常条件待测。VGS=2.5V、25°C下48mΩ最大导通电阻对此毫安支路可忽略，MOS/逻辑低电压瞬态仍需测量。关断漏电表在VDS=30V为1µA最大（25°C）、5µA（55°C），不能据此推导5.5V下的实际关断电流；OFF状态单列，不套MEASURE的140nA目标。

放电时间由目标总电容及残余供电决定：`t=R×C×ln(Vstart/Vend)`，储能`E=0.5×C×Vstart²`。例如标称470µF、1k、5.5→0.1V约1.88秒，尚未含触点等待、容差和外部供电；**50ms是待测切换等待初值，不是放电完成时间**。

## 状态、互锁与掉电

|稳定状态|K601|Q902|实际连接|
|---|---|---|---|
|正常供电|吸合|关|NO供电，NC机械隔开放电支路|
|MEASURE|保持吸合|关|供电保留；NC隔离，U901采样NO通道/全部FSA关闭，测量锁保留|
|关闭供电、不放电|释放|关|NC接R57，MOS关断；无主动放电，但存在MOS漏电|
|显式放电|释放并稳定|开|DUT_OUT→NC→1k→NMOS→GND|
|USB掉电后的稳定状态/未初始化|释放|下拉关|不请求主动放电；掉电瞬态仍须验证|
|吸合时Q902异常开（单故障模型）|吸合|开|稳定NO状态下NC仍隔离；不替代触点故障分析|

原硬件逻辑不变：`POWER_SAFE=POWER_REQ & SYS_RESETn`；`SIG_ARM=SIG_ARM_REQ & SYS_RESETn`；`DISCH_ARM=DISCH_REQ & SIG_ARM`；`POWER_OFF=!POWER_SAFE`；`DISCH_ON=DISCH_ARM & POWER_OFF`。U301/U302/U303/U304与R37/R62均保留。16种稳定输入组合检查未出现供电和放电命令同时有效，复位低时两者关；该真值表不是门延时、供电斜坡或机械动作证明。

必须实施且尚未实现的固件顺序：

1. 显式退出测量/进入放电流程；停止DAP/UART，全部数字、复位及检测REQ清零。不得由读Vref、串口/DTR/RTS/DAP自动解除MEASURE锁。
2. POWER_REQ清零，保持DISCH_REQ=0；等待K601实际释放及转换抖动稳定。50ms仅待测初值。
3. 仅为显式放电置SIG_ARM_REQ与DISCH_REQ；其他REQ必须保持0，避免总ARM同时恢复信号。超时/复位关闭放电，不自动重放命令。
4. 恢复供电先清DISCH_REQ，确认Q902栅极放电完成，再吸合K601；先配置/回读内置电源寄存器并按实测界限等待；本板无DUT_OUT回读，不能自行确认模拟电压稳定。接通调试/串口另需VIO匹配和显式连接流程。

HFD2标注额定电压下吸合≤4.5ms、释放≤3.5ms；不能套作本板带D601续流、实际电压/温度、触点抖动的最坏界限。低边MOS改作放电后不需要D902线圈续流，D601继续存在。USB下降时逻辑电源失效区、MOS栅电荷、米勒耦合及继电器先后动作均需示波器验证：启动/复位/未初始化不应形成未经请求的主动放电；R62硬件下拉只支持默认设计意图，并非瞬态已验收。

## 验证状态

本轮导出的网表核对Vref目标网络仅J801.1/U901.5、完整分压在NO后；DUT_OUT仅J602.1/K601.4，ADC_VOUT/VOUT_SENSE_IN/SENSE_COIL_LO消失，U1.26与U901.4独立NC。K601/Q902、所有FSA/复位/双串口及互锁保持。全量意图、基线逐项变换、ERC和图面最终结果记录在[validation.json](../hardware/validation.json)，不以ERC代替硬件验证。

硬件仍待：20/25/30°C与实际端口电平扫描的整夹具漏电；U901单支路电源斜坡特性（仅诊断，不是新增FSA掉电验收）；ADC误差/校准与稳定时间；VIO匹配与40MHz；K601释放/抖动、Q902掉电默认态、放电时间与电阻温升；1A/2A供电、来源BBM与热。DUT_OUT模拟电压/掉压/放电结束只能由外部仪器验证，当前无真实设备协议或仪器适配。见[控制接口约束](control-interface.md)。

文件证据放忽略目录 `hardware/design/reports/vref-only-2026-11-07/`；源文件与资料哈希记入validation.json；上游参考不修改，正式PCB未建立，无DRC/DFM或实板PASS。
