sanchuanhehe/HSLink-LP/docs/vref-pinmap.md

# Vref 开关物理引脚接受记录

2026-11-07。器件 Vishay DG2012EDL-T1-GE3，DL=SC-70-6；[原厂文档75834 RevB](https://www.vishay.com/docs/75834/dg2012e.pdf) p1顶视引脚图、p2电气表，合订PDF p11为外形71154/5550 RevB。符号 `HSLinkLP:DG2012EDL-T1-GE3`，封装 `Package_TO_SOT_SMD:SOT-363_SC-70-6`。

|实物脚|功能/符号脚/类型|封装焊盘|局部坐标mm|视图与证据|
|---|---|---|---|---|
|1|1 IN input|1|-0.8375,-0.65|顶视，p1圆点侧左上起，沿左侧向下1→2→3|
|2|2 V+ power_in|2|-0.8375,0|同上|
|3|3 GND power_in|3|-0.8375,0.65|同上|
|4|4 NC passive|4|0.8375,0.65|顶视右侧向上4→5→6|
|5|5 COM passive|5|0.8375,0|同上；目标必须接此掉电保护端|
|6|6 NO passive|6|0.8375,-0.65|同上|

封装外形图与p1顶视旋转90°后吻合，不做镜像。6实物引脚=6符号脚=6电气焊盘，无重复、EP或机械焊盘。所有焊盘1.025×0.35mm、无孔、F.Cu/F.Paste/F.Mask，间距0.65mm；引脚宽0.15～0.30mm、器件跨脚宽1.8～2.4mm，标准封装院落2.9×2.2mm。1脚丝印三角与F.Fab倒角位于左上。

已通过MCP创建/回读符号，临时原理图和PCB实际放置、读取实例和六焊盘并渲染核对；初始字段碰撞已在临时图中移到器件上方。标准服务库缓存未及时刷新，使用新的MCP进程回读成功，不把旧进程“找不到符号”视为已查。证据存于忽略目录 `hardware/design/reports/vref-only-2026-11-07`；接受范围为资料与映射，正式PCB/可焊性/DFM/实板未验收。

连接意图：5→DUT_VREF，6→完整分压前端，4悬空且标NC，1→SENSE_ON，2→USB_5V，3→GND。输入低时COM接浮置NC，采样NO断开；不得把NC接地。电源/分压/保护不得放在目标侧开关前。
