sanchuanhehe/HSLink-LP/docs/procurement-pinmap.md

# 缺价物料补齐：引脚与封装接受记录

2026-11-07。本轮已对照下列原厂图纸并经 MCP 回读、临时符号/PCB 放置及实际导出图检查。接受范围仅为资料与库映射；不是PCB、可焊性、性能或生产DFM验收。报告位于忽略目录 `hardware/design/reports/bom-completion-2026-11-07`。

## U501：TI TPS63810YFFR / YFF0015

资料：[SLVSEK4C Feb2020 p3、p40～42；机械图4219378/B May2020](https://www.ti.com/lit/ds/symlink/tps63810.pdf)。符号 `HSLinkLP:TPS63810YFFR`；封装 `Texas_YFF0015_1.344x2.255mm_P0.4mm`。

15物理球/15符号脚/15焊盘，无EP。p3/p41顶视，A1左上；行A→E向下、列1→3向右。p40底面图上下翻转对应顶视。

下列坐标均为器件顶视、封装局部，单位mm；每一行对应实际物理焊盘。

|物理端子/焊盘|功能及符号脚|X|Y|宽×高|角度|层/钻孔|
|---|---|---:|---:|---|---:|---|
|A1 → A1|A1: EN|-0.4|-0.8|0.23×0.23|0.0|F.Cu,F.Mask,F.Paste；无钻孔|
|A2 → A2|A2: VIN|0.0|-0.8|0.23×0.23|0.0|F.Cu,F.Mask,F.Paste；无钻孔|
|A3 → A3|A3: VIN|0.4|-0.8|0.23×0.23|0.0|F.Cu,F.Mask,F.Paste；无钻孔|
|B1 → B1|B1: VSEL|-0.4|-0.4|0.23×0.23|0.0|F.Cu,F.Mask,F.Paste；无钻孔|
|B2 → B2|B2: LX1|0.0|-0.4|0.23×0.23|0.0|F.Cu,F.Mask,F.Paste；无钻孔|
|B3 → B3|B3: LX1|0.4|-0.4|0.23×0.23|0.0|F.Cu,F.Mask,F.Paste；无钻孔|
|C1 → C1|C1: AGND|-0.4|0.0|0.23×0.23|0.0|F.Cu,F.Mask,F.Paste；无钻孔|
|C2 → C2|C2: PGND|0.0|0.0|0.23×0.23|0.0|F.Cu,F.Mask,F.Paste；无钻孔|
|C3 → C3|C3: PGND|0.4|0.0|0.23×0.23|0.0|F.Cu,F.Mask,F.Paste；无钻孔|
|D1 → D1|D1: SCL|-0.4|0.4|0.23×0.23|0.0|F.Cu,F.Mask,F.Paste；无钻孔|
|D2 → D2|D2: LX2|0.0|0.4|0.23×0.23|0.0|F.Cu,F.Mask,F.Paste；无钻孔|
|D3 → D3|D3: LX2|0.4|0.4|0.23×0.23|0.0|F.Cu,F.Mask,F.Paste；无钻孔|
|E1 → E1|E1: SDA|-0.4|0.8|0.23×0.23|0.0|F.Cu,F.Mask,F.Paste；无钻孔|
|E2 → E2|E2: VOUT|0.0|0.8|0.23×0.23|0.0|F.Cu,F.Mask,F.Paste；无钻孔|
|E3 → E3|E3: VOUT|0.4|0.8|0.23×0.23|0.0|F.Cu,F.Mask,F.Paste；无钻孔|

## U502：TI TLV75801PDRVR / DRV0006A

资料：[SBVS351D Oct2023 p3、p34～36](https://www.ti.com/lit/ds/symlink/tlv758p.pdf)。符号 `Regulator_Linear:TLV75801PDRV`；封装 `WSON-6-1EP_2x2mm_P0.65mm_EP1x1.6mm`。

6物理周边端子+EP/7符号脚/7铜焊盘，另有2个无电气编号、仅F.Paste层的EP钢网分窗（不是额外引脚）；EP工程编号7。顶视1左上，左侧1/2/3向下，右侧4/5/6向上。符号3/7堆叠接GND，5为无连接类型且隐藏，不把EP当可悬空NC。

下列坐标均为器件顶视、封装局部，单位mm；每一行对应实际物理焊盘。

|物理端子/焊盘|功能及符号脚|X|Y|宽×高|角度|层/钻孔|
|---|---|---:|---:|---|---:|---|
|无编号钢网窗|EP钢网分窗(无电气号)|0.0|-0.4|0.81×0.64|0.0|F.Paste；无钻孔|
|无编号钢网窗|EP钢网分窗(无电气号)|0.0|0.4|0.81×0.64|0.0|F.Paste；无钻孔|
|1 → 1|1: OUT|-0.8875|-0.65|0.375×0.4|0.0|F.Cu,F.Mask,F.Paste；无钻孔|
|2 → 2|2: FB|-0.8875|0.0|0.375×0.4|0.0|F.Cu,F.Mask,F.Paste；无钻孔|
|3 → 3|3: GND|-0.8875|0.65|0.375×0.4|0.0|F.Cu,F.Mask,F.Paste；无钻孔|
|4 → 4|4: EN|0.8875|0.65|0.375×0.4|0.0|F.Cu,F.Mask,F.Paste；无钻孔|
|5 → 5|5: DNC|0.8875|0.0|0.375×0.4|0.0|F.Cu,F.Mask,F.Paste；无钻孔|
|6 → 6|6: IN|0.8875|-0.65|0.375×0.4|0.0|F.Cu,F.Mask,F.Paste；无钻孔|
|EP → 7|7: GND(EP)|0.0|0.0|1.0×1.6|0.0|F.Cu,F.Mask；无钻孔|

## U503：TI TPS22950CDDCR / DDC0006A

资料：[SLVSFJ2B Feb2023 p4、p28～30](https://www.ti.com/lit/ds/symlink/tps22950.pdf)。符号 `HSLinkLP:TPS22950CDDCR`；封装 `SOT-23-6`。

6物理端子/6符号脚/6焊盘。顶视1左上，1/2/3向下，4/5/6沿右侧向上。

下列坐标均为器件顶视、封装局部，单位mm；每一行对应实际物理焊盘。

|物理端子/焊盘|功能及符号脚|X|Y|宽×高|角度|层/钻孔|
|---|---|---:|---:|---|---:|---|
|1 → 1|1: ON|-1.1375|-0.95|1.325×0.6|0.0|F.Cu,F.Mask,F.Paste；无钻孔|
|2 → 2|2: VIN|-1.1375|0.0|1.325×0.6|0.0|F.Cu,F.Mask,F.Paste；无钻孔|
|3 → 3|3: GND|-1.1375|0.95|1.325×0.6|0.0|F.Cu,F.Mask,F.Paste；无钻孔|
|4 → 4|4: ILIM|1.1375|0.95|1.325×0.6|0.0|F.Cu,F.Mask,F.Paste；无钻孔|
|5 → 5|5: VOUT|1.1375|0.0|1.325×0.6|0.0|F.Cu,F.Mask,F.Paste；无钻孔|
|6 → 6|6: FLTn|1.1375|-0.95|1.325×0.6|0.0|F.Cu,F.Mask,F.Paste；无钻孔|

## D101：TI TPD2E2U06DRLR / DRL0005A；D102同件

资料：[SLLSEG9C Dec2019 p3、p17～19](https://www.ti.com/lit/ds/symlink/tpd2e2u06.pdf)。符号 `HSLinkLP:TPD2E2U06DRLR`；封装 `SOT-553`。

5物理端子/5符号脚/5焊盘。顶视1左上，左侧1/2/3，右下4、右上5。1/2不接；D101另将未用IO2(5)标NC。原DCK的1/2/3映射至DRL的3/5/4，不能原脚号直换。

下列坐标均为器件顶视、封装局部，单位mm；每一行对应实际物理焊盘。

|物理端子/焊盘|功能及符号脚|X|Y|宽×高|角度|层/钻孔|
|---|---|---:|---:|---|---:|---|
|1 → 1|1: NC|-0.7125|-0.5|0.675×0.35|0.0|F.Cu,F.Mask,F.Paste；无钻孔|
|2 → 2|2: NC|-0.7125|0.0|0.675×0.35|0.0|F.Cu,F.Mask,F.Paste；无钻孔|
|3 → 3|3: IO1|-0.7125|0.5|0.675×0.35|0.0|F.Cu,F.Mask,F.Paste；无钻孔|
|4 → 4|4: GND|0.7125|0.5|0.675×0.35|0.0|F.Cu,F.Mask,F.Paste；无钻孔|
|5 → 5|5: IO2|0.7125|-0.5|0.675×0.35|0.0|F.Cu,F.Mask,F.Paste；无钻孔|

## SW1：XKB TS-1187A-B-A-B；SW2同件

资料：[TS-1187A-X-X-X RevA0 p1，TOP VIEW及内部接点图](https://atta.szlcsc.com/upload/public/pdf/source/20200227/C318890_053E50208A88A7BA1965D8746000774E.pdf)。符号 `Switch:SW_Push`；封装 `SW_Push_1P1T_XKB_TS-1187A`。

4物理端子/2电气符号脚/4物理焊盘、2重复电气编号。顶视A左上/B右上→1；C左下/D右下→2。每行内部相连，按下连接两行。

下列坐标均为器件顶视、封装局部，单位mm；每一行对应实际物理焊盘。

|物理端子/焊盘|功能及符号脚|X|Y|宽×高|角度|层/钻孔|
|---|---|---:|---:|---|---:|---|
|A → 1|1: A/B公共节点|-3.0|-1.875|1.0×0.75|0.0|F.Cu,F.Mask,F.Paste；无钻孔|
|B → 1|1: A/B公共节点|3.0|-1.875|1.0×0.75|0.0|F.Cu,F.Mask,F.Paste；无钻孔|
|C → 2|2: C/D公共节点|-3.0|1.875|1.0×0.75|0.0|F.Cu,F.Mask,F.Paste；无钻孔|
|D → 2|2: C/D公共节点|3.0|1.875|1.0×0.75|0.0|F.Cu,F.Mask,F.Paste；无钻孔|

## D601：先科/ST (SEMTECH ELECTRONICS LTD.) 1N4148W；D901同件

原D902也用此映射，随后检测/放电优化已删除，见 [优化说明](sense-discharge.md)。

资料：[1N4148W Rev05 2016-09-20 p1、p3](https://atta.szlcsc.com/upload/public/pdf/source/20161024/1477288446905.pdf)。符号 `Device:D`；封装 `D_SOD-123`。

2物理端子/2符号脚/2焊盘。数据手册顶视带色条端为左侧1/K，右侧2/A。不是STMicroelectronics的料号承诺。

下列坐标均为器件顶视、封装局部，单位mm；每一行对应实际物理焊盘。

|物理端子/焊盘|功能及符号脚|X|Y|宽×高|角度|层/钻孔|
|---|---|---:|---:|---|---:|---|
|1 → 1|1: K|-1.65|0.0|0.9×1.2|0.0|F.Cu,F.Mask,F.Paste；无钻孔|
|2 → 2|2: A|1.65|0.0|0.9×1.2|0.0|F.Cu,F.Mask,F.Paste；无钻孔|

## 尺寸和检查边界

- YFF新建封装：本体标称1.344×2.255mm，最大1.374×2.285mm；球距0.4mm、15颗直径0.23mm铜盘；NSMD单边阻焊扩展0.035mm、开窗直径0.30mm。A1标记左上。钢网开口、阻焊桥、逃线和加工能力仍需生产DFM，未宣称普通低价板工艺必然可做。
- DRV采用标准2×2mm WSON，EP=1×1.6mm；引脚/EP位置匹配，标准周边land为0.375×0.4mm、中心±0.8875mm，与TI示例0.45×0.3mm、中心±0.975mm不同：前者长度较短、宽度较大，覆盖器件端子但不能宣称是TI原图。EP必须接地；现有两个0.81×0.64mm钢网分窗和周边land均待生产DFM，必要时按贴装厂意见调整。
- DRL标准SOT-553焊盘0.675×0.35mm、列中心±0.7125mm，比TI示例0.67×0.30mm略宽；0.5mm脚距匹配。属于工程land选择，需钢网/DFM确认。
- DDC使用SOT23-6标准land，脚距0.95mm。现有焊盘比TI最小推荐更长，不声称完全同图；最终装配DFM待办。
- XKB四land中心x=±3mm、y=±1.875mm，尺寸1×0.75mm，与厂家7/5mm和4.5/3mm推荐外/内间距对应。B=160gf、A=1.5mm、末尾B=Brass；原260gf按钮手感改变，BOOT/RESET电气功能不变。
- 先科SOD123极性及本体对应；线圈最大初算电流5.5V/(167Ω×0.9)=36.6mA（按25°C线圈阻差示例），低于150mA额定；低温电阻、释放时间和热仍待验证。

## 源数据哈希

- `tps63810.pdf`: `0f96fceae24087f6c6c696aeab27876c0479d3bf968b813d998d6a8ab5271559`
- `tlv758p.pdf`: `4a86306d6734f1f4212e897c29787a93b56724c06adf87d926cc7b603a694d12`
- `tps22950.pdf`: `e0f4f5766ba30309af96287e20345b34b38986da59bb0e644bf5401e009c0c66`
- `tpd2e2u06.pdf`: `a133b86ea3d3c3d34667339b92d3b5e98d541d10e9775d63e7cdfa153794f4ed`
- `ts1187.pdf`: `64b75233cadaceb75ab3f3e33b532af8d04de98821c910ea13eb76c5fd1eed34`
- `1n4148w.pdf`: `54de8e4089bb8221cf6cf191ee3acc2bdb20c9933cf59e7b5de3ef4ee291ce3f`
