sanchuanhehe/HSLink-LP/docs/jlc-pinmap.md

# 本轮换料的物理引脚与封装核对

2026-11-07。此记录在实际原理图替换前完成；接受范围为资料/库映射，不是 PCB 装配、可焊性或实板验证。所有 CAD 改动经过 MCP。已安装 MCP 的项目库封装放置和引脚枚举有支持缺口，使用一次性 MCP 适配器调用 KiCad pcbnew/CLI 补齐；未改装常驻服务，脚本用后删除。

焊盘坐标为封装局部、器件顶视，单位 mm。SMD 层集为 F.Cu/F.Mask/F.Paste；通孔为全部铜层及 F.Mask/B.Mask，钻孔为成品设计名义孔径，工艺补偿待厂家 DFM。以下数字从 MCP 回读结果生成；符号功能另外与厂家脚号逐个核对。自定义三种封装与标准七种封装均已实际放入临时 PCB，导出并查看几何/方向；真实工程尚无 PCB。

## U101：WUSB3801Q-12/TR

来源：WillSemi WUSB3801Q-12/TR，QFN1616-12L；Rev1.1 Jul2016，p3 顶视编号、p15 底视机械图、p16 焊盘。[资料](https://atta.szlcsc.com//upload/public/pdf/source/20220218/358FA27FD5CA391EB61300BD5A69029B.pdf)。

符号 `HSLinkLP:WUSB3801Q_12_TR`；封装 `HSLinkLP:WillSemi_QFN1616_12L`。

物理端子／符号电气脚／封装电气焊盘：12/12/12；无重复焊盘、EP 或机械孔。

|物理脚|功能 / 符号脚名 / 类型|焊盘号|X / Y|宽 × 高|钻孔|旋转|层|视图与证据|
|---|---|---|---|---|---|---|---|---|
|1|CC1 / 1:CC1 / bidirectional|1|-0.7 / -0.2|0.8 × 0.2|[0.0, 0.0]|0.0°|F.Cu/F.Mask/F.Paste|p15 底视沿水平轴镜像为器件顶视；1 脚左上，沿左边向下；上述页图|
|2|CC2 / 2:CC2 / bidirectional|2|-0.7 / 0.2|0.8 × 0.2|[0.0, 0.0]|0.0°|F.Cu/F.Mask/F.Paste|p15 底视沿水平轴镜像为器件顶视；1 脚左上，沿左边向下；上述页图|
|3|ROLE / 3:ROLE / input|3|-0.6 / 0.8|0.2 × 0.6|[0.0, 0.0]|0.0°|F.Cu/F.Mask/F.Paste|p15 底视沿水平轴镜像为器件顶视；1 脚左上，沿左边向下；上述页图|
|4|VBUSD / 4:VBUSD / input|4|-0.2 / 0.8|0.2 × 0.6|[0.0, 0.0]|0.0°|F.Cu/F.Mask/F.Paste|p15 底视沿水平轴镜像为器件顶视；1 脚左上，沿左边向下；上述页图|
|5|CTRL / 5:CTRL / input|5|0.2 / 0.8|0.2 × 0.6|[0.0, 0.0]|0.0°|F.Cu/F.Mask/F.Paste|p15 底视沿水平轴镜像为器件顶视；1 脚左上，沿左边向下；上述页图|
|6|INTB / 6:INTB / open_collector|6|0.6 / 0.8|0.2 × 0.6|[0.0, 0.0]|0.0°|F.Cu/F.Mask/F.Paste|p15 底视沿水平轴镜像为器件顶视；1 脚左上，沿左边向下；上述页图|
|7|SDA / 7:SDA / bidirectional|7|0.7 / 0.2|0.8 × 0.2|[0.0, 0.0]|0.0°|F.Cu/F.Mask/F.Paste|p15 底视沿水平轴镜像为器件顶视；1 脚左上，沿左边向下；上述页图|
|8|SCL / 8:SCL / input|8|0.7 / -0.2|0.8 × 0.2|[0.0, 0.0]|0.0°|F.Cu/F.Mask/F.Paste|p15 底视沿水平轴镜像为器件顶视；1 脚左上，沿左边向下；上述页图|
|9|ID / 9:ID / open_collector|9|0.6 / -0.8|0.2 × 0.6|[0.0, 0.0]|0.0°|F.Cu/F.Mask/F.Paste|p15 底视沿水平轴镜像为器件顶视；1 脚左上，沿左边向下；上述页图|
|10|GND / 10:GND / power_in|10|0.2 / -0.8|0.2 × 0.6|[0.0, 0.0]|0.0°|F.Cu/F.Mask/F.Paste|p15 底视沿水平轴镜像为器件顶视；1 脚左上，沿左边向下；上述页图|
|11|ENB / 11:ENB / input|11|-0.2 / -0.8|0.2 × 0.6|[0.0, 0.0]|0.0°|F.Cu/F.Mask/F.Paste|p15 底视沿水平轴镜像为器件顶视；1 脚左上，沿左边向下；上述页图|
|12|VDD / 12:VDD / power_in|12|-0.6 / -0.8|0.2 × 0.6|[0.0, 0.0]|0.0°|F.Cu/F.Mask/F.Paste|p15 底视沿水平轴镜像为器件顶视；1 脚左上，沿左边向下；上述页图|

## U402：TPS7A2036PDBVR

来源：TI TPS7A2036PDBVR，DBV；SBVS338H Jul2024，p4 顶视编号及末尾 DBV0005A 包装图。[资料](https://www.ti.com/cn/lit/ds/symlink/tps7a20.pdf)。

符号 `HSLinkLP:TPS7A2036PDBVR`；封装 `Package_TO_SOT_SMD:SOT-23-5`。

物理端子／符号电气脚／封装电气焊盘：5/5/5；无重复焊盘、EP 或机械孔。

|物理脚|功能 / 符号脚名 / 类型|焊盘号|X / Y|宽 × 高|钻孔|旋转|层|视图与证据|
|---|---|---|---|---|---|---|---|---|
|1|IN / 1:IN / power_in|1|-1.1375 / -0.95|1.325 × 0.6|[0.0, 0.0]|0.0°|F.Cu/F.Mask/F.Paste|器件顶视，1 脚左上，左侧向下至 3，再右下 4、右上 5；上述页图|
|2|GND / 2:GND / power_in|2|-1.1375 / 0.0|1.325 × 0.6|[0.0, 0.0]|0.0°|F.Cu/F.Mask/F.Paste|器件顶视，1 脚左上，左侧向下至 3，再右下 4、右上 5；上述页图|
|3|EN / 3:EN / input|3|-1.1375 / 0.95|1.325 × 0.6|[0.0, 0.0]|0.0°|F.Cu/F.Mask/F.Paste|器件顶视，1 脚左上，左侧向下至 3，再右下 4、右上 5；上述页图|
|4|NC / 4:NC / no_connect|4|1.1375 / 0.95|1.325 × 0.6|[0.0, 0.0]|0.0°|F.Cu/F.Mask/F.Paste|器件顶视，1 脚左上，左侧向下至 3，再右下 4、右上 5；上述页图|
|5|OUT / 5:OUT / power_out|5|1.1375 / -0.95|1.325 × 0.6|[0.0, 0.0]|0.0°|F.Cu/F.Mask/F.Paste|器件顶视，1 脚左上，左侧向下至 3，再右下 4、右上 5；上述页图|

## L1：SPH4018H4R7MT

来源：Sunlord SPH4018H4R7MT / SPH4018H2R2MT；SPH series 2022/05/15，p2 Fig3、p3 参数表。[资料](https://atta.szlcsc.com//upload/public/pdf/source/20250613/ACB2314ED53D2527A89366A49163B0F0.pdf)。

符号 `Device:L`；封装 `HSLinkLP:L_Sunlord_SPH4018`。

物理端子／符号电气脚／封装电气焊盘：2/2/2；无重复焊盘、EP 或机械孔。

|物理脚|功能 / 符号脚名 / 类型|焊盘号|X / Y|宽 × 高|钻孔|旋转|层|视图与证据|
|---|---|---|---|---|---|---|---|---|
|1|VDD_SOC / 1:VDD_SOC / passive|1|-1.5 / 0.0|1.1 × 3.7|[0.0, 0.0]|0.0°|F.Cu/F.Mask/F.Paste|底面无极性端子，映射到 PCB 顶视：工程编号 1 左、2 右；上述页图|
|2|SOC_SW / 2:SOC_SW / passive|2|1.5 / 0.0|1.1 × 3.7|[0.0, 0.0]|0.0°|F.Cu/F.Mask/F.Paste|底面无极性端子，映射到 PCB 顶视：工程编号 1 左、2 右；上述页图|

## L4：MWSA0603S-R47MT

来源：Sunlord MWSA0603S-R47MT；MWSA series 2025/05/29，p2 机械/焊盘、p6 参数表。[资料](https://atta.szlcsc.com//upload/public/pdf/source/20250613/CEE4AE5EC9F7EB97495A767C9ECB8960.pdf)。

符号 `Device:L`；封装 `Inductor_SMD:L_Sunlord_MWSA0603S`。

物理端子／符号电气脚／封装电气焊盘：2/2/2；无重复焊盘、EP 或机械孔。

|物理脚|功能 / 符号脚名 / 类型|焊盘号|X / Y|宽 × 高|钻孔|旋转|层|视图与证据|
|---|---|---|---|---|---|---|---|---|
|1|INT_LX1 / 1:INT_LX1 / passive|1|-3.025 / 0.0|2.35 × 3.5|[0.0, 0.0]|0.0°|F.Cu/F.Mask/F.Paste|无极性；PCB 顶视工程编号 1 左、2 右；上述页图|
|2|INT_LX2 / 2:INT_LX2 / passive|2|3.025 / 0.0|2.35 × 3.5|[0.0, 0.0]|0.0°|F.Cu/F.Mask/F.Paste|无极性；PCB 顶视工程编号 1 左、2 右；上述页图|

## C40：CL31A476MPHNNNE

来源：Samsung CL31A476MPHNNNE；CL31 产品尺寸图：3216；两端无极性，C41 同件。[资料](https://atta.szlcsc.com//upload/public/pdf/source/20160218/1457707763339.pdf)。

符号 `Device:C`；封装 `Capacitor_SMD:C_1206_3216Metric`。

物理端子／符号电气脚／封装电气焊盘：2/2/2；无重复焊盘、EP 或机械孔。

|物理脚|功能 / 符号脚名 / 类型|焊盘号|X / Y|宽 × 高|钻孔|旋转|层|视图与证据|
|---|---|---|---|---|---|---|---|---|
|1|INT_RAW / 1:INT_RAW / passive|1|-1.475 / 0.0|1.15 × 1.8|[0.0, 0.0]|0.0°|F.Cu/F.Mask/F.Paste|无极性；PCB 顶视工程编号 1 左、2 右；上述页图|
|2|GND / 2:GND / passive|2|1.475 / 0.0|1.15 × 1.8|[0.0, 0.0]|0.0°|F.Cu/F.Mask/F.Paste|无极性；PCB 顶视工程编号 1 左、2 右；上述页图|

## J601：KF128-5.08-2P-AA

来源：KEFA KF128-5.08-2P-AA；Rev A 21.03.13，p1 尺寸/建议孔图；J602 同件。[资料](https://atta.szlcsc.com//upload/public/pdf/source/20240821/65781D2669BFD48A107CF288CD3FBA7A.pdf)。

符号 `Connector_Generic:Conn_01x02`；封装 `HSLinkLP:TerminalBlock_KEFA_KF128_5.08_1x02`。

物理端子／符号电气脚／封装电气焊盘：2/2/2；无重复焊盘、EP 或机械孔。

|物理脚|功能 / 符号脚名 / 类型|焊盘号|X / Y|宽 × 高|钻孔|旋转|层|视图与证据|
|---|---|---|---|---|---|---|---|---|
|1|EXT_INPUT / 1:EXT_INPUT / passive|1|0.0 / 0.0|2.4 × 2.4|[1.4, 1.4]|0.0°|*.Cu + F/B.Mask|器件顶视，工程定义左 1 右 2，进线 +Y；底视需镜像；上述页图|
|2|GND / 2:GND / passive|2|5.08 / 0.0|2.4 × 2.4|[1.4, 1.4]|0.0°|*.Cu + F/B.Mask|器件顶视，工程定义左 1 右 2，进线 +Y；底视需镜像；上述页图|

## J1：PZ254V-11-06P

来源：XFCN PZ254V-11-06P，p1 部件图/建议孔图。[资料](https://atta.szlcsc.com//upload/public/pdf/source/20260728/FCDE680580DD89D896389311C7AED201.pdf)。

符号 `Connector_Generic:Conn_01x06`；封装 `Connector_PinHeader_2.54mm:PinHeader_1x06_P2.54mm_Vertical`。

物理端子／符号电气脚／封装电气焊盘：6/6/6；无重复焊盘、EP 或机械孔。

|物理脚|功能 / 符号脚名 / 类型|焊盘号|X / Y|宽 × 高|钻孔|旋转|层|视图与证据|
|---|---|---|---|---|---|---|---|---|
|1|P3V3 / 1:P3V3 / passive|1|0.0 / 0.0|1.7 × 1.7|[1.0, 1.0]|0.0°|*.Cu + F/B.Mask|器件顶视；图中横向端子行旋转 90°，1 脚起沿 +Y；上述页图|
|2|GND / 2:GND / passive|2|0.0 / 2.54|1.7 × 1.7|[1.0, 1.0]|0.0°|*.Cu + F/B.Mask|器件顶视；图中横向端子行旋转 90°，1 脚起沿 +Y；上述页图|
|3|UART_B_TX / 3:UART_B_TX / passive|3|0.0 / 5.08|1.7 × 1.7|[1.0, 1.0]|0.0°|*.Cu + F/B.Mask|器件顶视；图中横向端子行旋转 90°，1 脚起沿 +Y；上述页图|
|4|UART_B_RX / 4:UART_B_RX / passive|4|0.0 / 7.62|1.7 × 1.7|[1.0, 1.0]|0.0°|*.Cu + F/B.Mask|器件顶视；图中横向端子行旋转 90°，1 脚起沿 +Y；上述页图|
|5|BOOT1 / 5:BOOT1 / passive|5|0.0 / 10.16|1.7 × 1.7|[1.0, 1.0]|0.0°|*.Cu + F/B.Mask|器件顶视；图中横向端子行旋转 90°，1 脚起沿 +Y；上述页图|
|6|SYS_RESETn / 6:SYS_RESETn / passive|6|0.0 / 12.7|1.7 × 1.7|[1.0, 1.0]|0.0°|*.Cu + F/B.Mask|器件顶视；图中横向端子行旋转 90°，1 脚起沿 +Y；上述页图|

## J803：PZ254V-11-05P

来源：XFCN PZ254V-11-05P，p1 部件图/建议孔图；J804 同件。[资料](https://atta.szlcsc.com//upload/public/pdf/source/20260728/FCDE680580DD89D896389311C7AED201.pdf)。

符号 `Connector_Generic:Conn_01x05`；封装 `Connector_PinHeader_2.54mm:PinHeader_1x05_P2.54mm_Vertical`。

物理端子／符号电气脚／封装电气焊盘：5/5/5；无重复焊盘、EP 或机械孔。

|物理脚|功能 / 符号脚名 / 类型|焊盘号|X / Y|宽 × 高|钻孔|旋转|层|视图与证据|
|---|---|---|---|---|---|---|---|---|
|1|DUT_UART_A_TX / 1:DUT_UART_A_TX / passive|1|0.0 / 0.0|1.7 × 1.7|[1.0, 1.0]|0.0°|*.Cu + F/B.Mask|器件顶视；图中横向端子行旋转 90°，1 脚起沿 +Y；上述页图|
|2|DUT_UART_A_RX / 2:DUT_UART_A_RX / passive|2|0.0 / 2.54|1.7 × 1.7|[1.0, 1.0]|0.0°|*.Cu + F/B.Mask|器件顶视；图中横向端子行旋转 90°，1 脚起沿 +Y；上述页图|
|3|DUT_UART_A_DTR / 3:DUT_UART_A_DTR / passive|3|0.0 / 5.08|1.7 × 1.7|[1.0, 1.0]|0.0°|*.Cu + F/B.Mask|器件顶视；图中横向端子行旋转 90°，1 脚起沿 +Y；上述页图|
|4|DUT_UART_A_RTS / 4:DUT_UART_A_RTS / passive|4|0.0 / 7.62|1.7 × 1.7|[1.0, 1.0]|0.0°|*.Cu + F/B.Mask|器件顶视；图中横向端子行旋转 90°，1 脚起沿 +Y；上述页图|
|5|GND / 5:GND / passive|5|0.0 / 10.16|1.7 × 1.7|[1.0, 1.0]|0.0°|*.Cu + F/B.Mask|器件顶视；图中横向端子行旋转 90°，1 脚起沿 +Y；上述页图|

## J802：B-2100S02P-A110（历史，现已删除）

来源：Ckmtw B-2100S02P-A110，p1 部件图/建议孔图。[资料](https://atta.szlcsc.com//upload/public/pdf/source/20221019/2EE72DAC61CAA62C0A53546E211F9C15.pdf)。

符号 `Connector_Generic:Conn_01x02`；封装 `Connector_PinHeader_2.54mm:PinHeader_1x02_P2.54mm_Vertical`。

物理端子／符号电气脚／封装电气焊盘：2/2/2；无重复焊盘、EP 或机械孔。

|物理脚|功能 / 符号脚名 / 类型|焊盘号|X / Y|宽 × 高|钻孔|旋转|层|视图与证据|
|---|---|---|---|---|---|---|---|---|
|1|DUT_NTRST / 1:DUT_NTRST / passive|1|0.0 / 0.0|1.7 × 1.7|[1.0, 1.0]|0.0°|*.Cu + F/B.Mask|器件顶视，工程编号 1 起沿 +Y；裸排针无键；上述页图|
|2|GND / 2:GND / passive|2|0.0 / 2.54|1.7 × 1.7|[1.0, 1.0]|0.0°|*.Cu + F/B.Mask|器件顶视，工程编号 1 起沿 +Y；裸排针无键；上述页图|

## J801：ZX-PZ1.27-2-5PZZ（历史，现已换ARM20）

来源：ZX ZX-PZ1.27-2-5PZZ，p1 部件图/建议孔图。[资料](https://atta.szlcsc.com//upload/public/pdf/source/20231122/F17CBFE608F16BCCADFE6957B6D7BD2D.pdf)。

符号 `Connector_Generic:Conn_02x05_Odd_Even`；封装 `Connector_PinHeader_1.27mm:PinHeader_2x05_P1.27mm_Vertical`。

物理端子／符号电气脚／封装电气焊盘：10/10/10；无重复焊盘、EP 或机械孔。

|物理脚|功能 / 符号脚名 / 类型|焊盘号|X / Y|宽 × 高|钻孔|旋转|层|视图与证据|
|---|---|---|---|---|---|---|---|---|
|1|DUT_VREF / 1:DUT_VREF / passive|1|0.0 / 0.0|1.0 × 1.0|[0.65, 0.65]|0.0°|*.Cu + F/B.Mask|器件顶视，1 左上、2 右上；两列沿 +Y；对插视图相对镜像；上述页图|
|2|DUT_SWDIO / 2:DUT_SWDIO / passive|2|1.27 / 0.0|1.0 × 1.0|[0.65, 0.65]|0.0°|*.Cu + F/B.Mask|器件顶视，1 左上、2 右上；两列沿 +Y；对插视图相对镜像；上述页图|
|3|GND / 3:GND / passive|3|0.0 / 1.27|1.0 × 1.0|[0.65, 0.65]|0.0°|*.Cu + F/B.Mask|器件顶视，1 左上、2 右上；两列沿 +Y；对插视图相对镜像；上述页图|
|4|DUT_TCK / 4:DUT_TCK / passive|4|1.27 / 1.27|1.0 × 1.0|[0.65, 0.65]|0.0°|*.Cu + F/B.Mask|器件顶视，1 左上、2 右上；两列沿 +Y；对插视图相对镜像；上述页图|
|5|GND / 5:GND / passive|5|0.0 / 2.54|1.0 × 1.0|[0.65, 0.65]|0.0°|*.Cu + F/B.Mask|器件顶视，1 左上、2 右上；两列沿 +Y；对插视图相对镜像；上述页图|
|6|DUT_TDO / 6:DUT_TDO / passive|6|1.27 / 2.54|1.0 × 1.0|[0.65, 0.65]|0.0°|*.Cu + F/B.Mask|器件顶视，1 左上、2 右上；两列沿 +Y；对插视图相对镜像；上述页图|
|7|None / 7:None / passive|7|0.0 / 3.81|1.0 × 1.0|[0.65, 0.65]|0.0°|*.Cu + F/B.Mask|器件顶视，1 左上、2 右上；两列沿 +Y；对插视图相对镜像；上述页图|
|8|DUT_TDI / 8:DUT_TDI / passive|8|1.27 / 3.81|1.0 × 1.0|[0.65, 0.65]|0.0°|*.Cu + F/B.Mask|器件顶视，1 左上、2 右上；两列沿 +Y；对插视图相对镜像；上述页图|
|9|GND / 9:GND / passive|9|0.0 / 5.08|1.0 × 1.0|[0.65, 0.65]|0.0°|*.Cu + F/B.Mask|器件顶视，1 左上、2 右上；两列沿 +Y；对插视图相对镜像；上述页图|
|10|DUT_NRST / 10:DUT_NRST / passive|10|1.27 / 5.08|1.0 × 1.0|[0.65, 0.65]|0.0°|*.Cu + F/B.Mask|器件顶视，1 左上、2 右上；两列沿 +Y；对插视图相对镜像；上述页图|

## 尺寸、插接与接受边界

- WUSB 顶面本体 1.6×1.6，建议铜焊盘外包络 2.2×2.2，院界 2.8×2.8。外侧左上标记对应 1 脚；无中心裸露焊盘，不能借用 TI 封装而假设兼容。
- SPH 推荐 land 间隙 1.9，单 pad 1.1×3.7；本体 4×4，高 1.8。L1/L2 同一封装、无极性。
- MWSA 本体 7.0±0.3×6.6±0.2，高 2.8±0.2；pad 2.35×3.5，内间隙 3.7。较原 XFL4015 显著变大，需要重新布局，没有承诺整板面积不变。
- TPS7A20 的 SOT-23-5 标准焊盘比 TI 最小推荐示例更长，脚位/间距匹配；量产钢网及装配工艺须 DFM 确认，不能等同原厂推荐 land 完全相同。
- C40/C41 从 0805 改为 1206，名义本体 3.2×1.6，最大尺寸及焊端长度已对照三星尺寸图。通用 KiCad land 是装配选择，不是电容量保证。
- KF128 本体 10.16×10.70，高 14.1；5.08 pitch，1.4 孔，2.4 pad，端子 0.9×0.8；侧面拼接突起计入院界。不是可拔插插头，线入口置于 +Y。工程指定 1 为正、2 为地，PCB 必须标极性；原厂未标极性的螺钉端子不存在厂家端子号依赖。
- PZ254 0.64 方针、1 mm 孔、额定 3 A；1×5/1×6 针距 2.54，针端 6.1/焊脚 3 mm。B-2100 0.64 方针、1 mm 孔，针端 6/焊脚 3 mm，额定 3 A。额定值不代表系统 2 A 热验收。
- 历史J801（当前已替换，见[ARM20](arm20-interface.md)）两列行距/列距均 1.27，0.4 方针、0.65 孔，本体 6.35×3.4，针端 3.3/焊脚 2.3 mm，额定 1 A。为无护套、无防反插键裸排针；检查实际排线插头配合及 1 脚朝向，不能声称是有键 ARM 插座。本接口仅信号和地，不承担 2 A DUT 电源。
- Y1 与 SW1/SW2 仅落实采购候选；按钮力/高度和晶体负载匹配尚待签核，未计为本文件的已接受替换。

回读和临时放置证据存放于忽略目录 `hardware/design/reports/jlc-2026-11-07/`，总摘要和文件哈希见 `hardware/validation.json`。

## U701～U712：SN74LVC1T45DBVR（本次新增接受）

来源：[TI SCES515N，June 2024](https://www.ti.com/lit/ds/symlink/sn74lvc1t45.pdf)，p2 Figure 4-1 DBV SOT-23-6 **Top View**，附录 DBV0006A 外形及推荐 land（本地快照 PDF 第 31、32 页）。完整采购后缀 DBVR，嘉立创 C7843；不能套用 DCK/SC70 或 YZP 底视图。下列映射在正式放置前用临时工程放置/回读及渲染确认，后续正式导出网表再次逐脚匹配。

标准符号 `Logic_LevelTranslator:SN74LVC1T45DBV`；标准封装 `Package_TO_SOT_SMD:SOT-23-6`。6 个物理端子、6 个符号电气脚、6 个唯一电气焊盘，无 EP、机械脚或重复焊盘。器件顶视：1 左上、2 左中、3 左下、4 右下、5 右中、6 右上；无需镜像。

|物理脚 / 焊盘号|功能 / 符号电气类型|局部 X / Y (mm)|尺寸 mm|旋转 / 钻孔|层|
|---|---|---|---|---|---|
|1|VCCA / power_in|-1.1375 / -0.95|1.325 × 0.6|0° / 无|F.Cu/F.Mask/F.Paste|
|2|GND / power_in|-1.1375 / 0|1.325 × 0.6|0° / 无|F.Cu/F.Mask/F.Paste|
|3|A / bidirectional|-1.1375 / 0.95|1.325 × 0.6|0° / 无|F.Cu/F.Mask/F.Paste|
|4|B / bidirectional|1.1375 / 0.95|1.325 × 0.6|0° / 无|F.Cu/F.Mask/F.Paste|
|5|DIR / input|1.1375 / 0|1.325 × 0.6|0° / 无|F.Cu/F.Mask/F.Paste|
|6|VCCB / power_in|1.1375 / -0.95|1.325 × 0.6|0° / 无|F.Cu/F.Mask/F.Paste|

MCP 暂放器件原点为 (50,50)，上表已减去原点；均为 SMD roundrect，courtyard 4.1×3.4 mm。标准库按 JEDEC MO-178 AB 定义；与 TI 示例 1.1×0.6 mm、横向中心距 2.6 mm 的 land 并非逐尺寸相同。本库横向中心距 2.275 mm、外沿跨度 3.6 mm，覆盖 DBV 2.6～3.0 mm 引脚跨度及 0.95 mm 节距；焊盘更向内延伸。接受作为当前 SOT-23-6 分配，钢网、焊膏与最终工艺仍须 PCB/DFM 签核，未把示例 land 当成唯一合法焊盘。

证据：`hardware/design/reports/lvc12-2026-11-07/` 下的 DBV 顶视页图、封装几何图、符号图、MCP pin/pad 回读及标准库文件哈希。正式项目没有 PCB，本次没有虚构 12 个 PCB 实例或 DRC 结果。
