sanchuanhehe/HSLink-LP/docs/control-interface.md

# 控制接口与电压语义约束

2026-11-07。此处是固件/主机共同实现前的设计约束，不是已实现报文协议。host仅本地info骨架，改版固件尚无板型，不新增虚构传输成功结果。

- 能力应明确 `dut_voltage_readback_supported=false`、`target_vref_sensing_supported=true`。实际报文格式、版本及操作码仍待共同冻结。
- `output_voltage_setpoint_v`仅表示内置电源要求值；寄存器回读仅说明数字配置，不是实测。外部来源的电压由外部仪器决定，不伪造对应本板设定值。
- `target_vref_measured_v`仅对应J801.1的1.8～3.3V逻辑参考，经U901/R53/R54/C61/U1.27采样；与DUT供电电压、VIO实际电压分别处理。应带有效标志、时间戳与状态，断开时返回不可用或标记过期的历史值。
- 不提供 `dut_voltage_measured_v` 数字。输出通断状态只可表示控制命令/时序阶段，本板无接点反馈，不能表示目标必然有电或已为0V。PG或I²C读回不能代替DUT电压。
- 不承诺基于DUT_ADC的输出确认、掉压检测、放电到阈值自动停止。保护仍有既有硬件限流/故障输入；电源实际值和放电完成需外部仪器，适配未实现。未接仪器时只能报告“放电定时结束、残余电压未知”，不得报告“放电完成已验证”。

默认上电、复位、FAULT：SIG_ARM_REQ/SENSE_REQ/所有信号REQ=0，R61及R36下拉SENSE_ON；U901.IN低→COM接浮置NC，NO分压断开。主控空闲U1.26配置为无上下拉高阻；不得重新命名ADC_VOUT并继续发送模拟数值。

MEASURE保持K601供电、Q902关闭、所有FSA与U901断开。串口打开、DTR/RTS、DAP、Vref读命令和调压均不能解除锁；需专用显式退出操作。连接流程：停止事务→保持隔离→显式允许Vref采样→等待稳定/ADC校准采样→设置独立VIO→按实测界限等待→核对方向→按组连接。不得从目标Vref供给VIO电源。

内置供电恢复：K601断开、Q902关闭→配置/回读TPS63810寄存器及状态→按验证后的稳定时间等待→显式接通K601。此过程不能由本板确认输出模拟电压正确。放电：显式请求→信号/检测REQ清零→POWER_REQ清零→等待释放及抖动稳定→只启用DISCH_REQ所需ARM→打开Q902→有界定时/取消/故障关闭。恢复先关MOS再吸合K601。50ms仅既有待测转换初值；不能当作残余电压验收。实际USB掉电、栅极和继电器动态仍待实测。

首版使用边界：在目标信号连接前保持调试器USB供电，移除USB前先断开目标信号连接；不能把FSA软件断开理解为掉电保护。掉电恢复仍默认关闭，不复用旧测量锁/电压缓存自动连接。当前VIO无独立ADC，电压匹配、校准精度和等待时间须外部测量定界；VIO已采用10k/2.15k/15.4k反馈和USB_5V输入，逐板外部校准，±1%目标待验收；不新增已实现协议或实测电压字段。校准表须绑定板号/硬件版本并校验CRC，缺失/损坏时保持隔离，不得使用标称公式冒充已校准输出。详见[余量与校准说明](electrical-margins.md)。

## 启动与异常顺序增补（2026-11-12）

- MCU启动/复位保持SIG_ARM_REQ、POWER_REQ、VIO_EN为低；先把TCA9539输出锁存写0，再配置输出方向，最后才允许显式ARM。内部MCU复位不应假定会把外部SYS_RESETn拉低，须验证GPIO恢复高阻和下拉以及I/O扩展器复位/旧锁存值。禁止先恢复ARM再清除旧DISCH_REQ。
- VIO调整先取消当前事务、关闭所有FSA/U901并保持测量锁值；EN低时配置DAC的VDD参考、正常模式、码值，核对ACK/POR/RDY及数字回读，校准表校验通过后再EN高。任何失败保持隔离；等待结束也不自动恢复信号。详见[专项分析](prefab-analysis.md)的待测10ms/100µs/5ms流程预算，非硬件保证。
- 复位、USB失效/恢复、FAULT清除放电及待执行的供电请求，生成新的操作代号；旧异步完成回调作废。恢复供电先清DISCH_REQ并关MOS，过保护间隔再吸合K601；之后再次断电也不能复用旧放电请求。
- `host/src/hslink_lp/safety_model.py`和单元测试实现了离线参考状态机；不表示固件/传输协议已实现。所有硬件等待值必须由样机验证，模型无默认等待常数。超时只表示定时结束/电压未知。
- U102的FLT不报告所有欠压、过流和钳位事件，不能只靠FAULTn确认USB或DUT电压正常。1A功率许可须独立核对CC状态、有效预算和器件/板温；现有无实测电压回读语义保持。
