sanchuanhehe/HSLink-LP/docs/cost.md

# 嘉立创 BOM 核价与降本

文档更新：2026-11-12；价格快照：2026-11-07；人民币含税、10套打样。单板金额按10套采购用量选阶梯后分摊，**不是单独买1套的价格**。[完整板上BOM](../hardware/bom/candidates.csv)、[配件BOM](../hardware/bom/accessories.csv)、[逐料阶梯/库存/时间](../hardware/bom/jlc-quotes.json)、[机器摘要](../hardware/bom/cost-summary.json)。

**完整板上BOM为 ¥124.9924/板，10套 ¥1,249.9240；加配套排线为 ¥128.8354/套，10套 ¥1,288.3540。** 当前原理图共204个板上电气位号：193个采购件、11个裸铜测试焊盘（不含PCB机械孔/基准点）。采购BOM为57个合并行；测试焊盘单列[板上特征清单](../hardware/bom/pcb-features.csv)，不作为采购器件或贴装点。所有采购行均有既有嘉立创含税阶梯报价快照，本轮没有刷新价格或库存。排线为单独配件CBL801，不计入板上位号或SMT费用。原11个缺价位号已补齐，新增R401以保持450k反馈值；J801换ARM20并删除J802；随后删除放电继电器K902/D902，利用K601常闭触点与Q902，此前已删除K901/Q901/D901及DUT_OUT采样，Vref采用U901 DG2012E，实际仅K601一颗继电器。

本轮VIO/R42核价已取得三种VIO新电阻、R42新料及旧R58/R59的详情快照；R42采用2026-11-07 14:01:50（UTC+8）读取的C861567快照，本次落地未重新查询。旧R60重读触发访问验证，保持原同日已记录报价。其他现用物料沿用2026-11-07本地日期的既有快照。库存未预留、价格未锁单，完整核价不等于硬件验证。

## 完整成本拆分

|项目|单板/套或分摊金额|10套|性质|
|---|---:|---:|---|
|板上实用元器件完整BOM|¥124.9924|¥1,249.9240|193个采购位号，既有现货阶梯快照|
|配套排线CBL801|¥3.8430|¥38.4300|1条/套；打样配套、未通过漏电与时序验收|
|实用材料合计|¥128.8354|¥1,288.3540|板上与配件合计，不含备损|
|板上额外10%备损情景|¥12.49924|¥124.9924|逐MPN合并10套用量后加10%并向上取整，非平台规定|
|排线备损情景|¥0.3843分摊|¥3.8430|十套额外1条|
|材料加上述备损|¥141.71894|¥1,417.1894|按加入备损后的数量重选档，本轮档位未变|
|最低采购量/采购增量余料|待订单|待订单|阶梯起点不是MOQ；未按0补齐|
|换料费情景|¥64.00分摊|¥640.00|32种扩展库SMT×¥20/种/订单、无券；不是正式订单价|
|PCB|待定|待定|工作板框110×80mm四层；未布完，尚无制造报价|
|SMT贴装|待定|待定|焊点、单双面、工艺和可贴性未确认|
|通孔焊接|待定|待定|继电器、来源开关、端子及连接器单列|
|钢网/其他工艺|待定|待定|含YFF 0.4mm与WSON工艺核对|
|运输|待定|待定|未形成采购/制造订单|
|材料＋10%备损＋换料费情景小计|¥205.71894|¥2,057.1894|**未含MOQ余料、PCB、贴装、通孔、其他工艺及运输；不是成品总成本**|

现用SMT为19种基础库、32种扩展库；通孔件不按贴片机换料费直接计数。基础库不等于所有装配服务免费，USB-C混合工序仍待厂家订单确认。未下单、未付款，没有向厂家承诺库存。

## 采购补齐阶段与替代（历史快照）

以下记录Git `0f89de3`阶段，尚含D902；当前已删除D902并减少一颗继电器，以顶部完整成本与下文检测/放电增量为准。

|位号|实际采用|嘉立创编号|10套用量|单价|每板金额|查询库存|
|---|---|---|---:|---:|---:|---:|
|SW1 SW2|TS-1187A-B-A-B|[C318884](https://www.jlc-smt.com/lcsc/detail/C318884.html)|20|¥0.126|¥0.252|967759|
|D101 D102|TPD2E2U06DRLR|[C1972959](https://www.jlc-smt.com/lcsc/detail/C1972959.html)|20|¥1.984|¥3.968|7498|
|R38|0603WAF3003T5E|[C23024](https://www.jlc-smt.com/lcsc/detail/C23024.html)|10|¥0.0229|¥0.0229|493912|
|R401|0603WAF1503T5E|[C22807](https://www.jlc-smt.com/lcsc/detail/C22807.html)|10|¥0.0098|¥0.0098|716498|
|U501|TPS63810YFFR|[C1852139](https://www.jlc-smt.com/lcsc/detail/C1852139.html)|10|¥10.82|¥10.82|253|
|U502|TLV75801PDRVR|[C2876308](https://www.jlc-smt.com/lcsc/detail/C2876308.html)|10|¥1.773|¥1.773|3075|
|U503|TPS22950CDDCR|[C7587833](https://www.jlc-smt.com/lcsc/detail/C7587833.html)|10|¥3.22|¥3.22|1931|
|D601 D901 D902|1N4148W|[C81598](https://www.jlc-smt.com/lcsc/detail/C81598.html)|30|¥0.0754|¥0.2262|3564092|

这部分合计 **¥20.2919/板、10套 ¥202.919**。加到此前的部分小计¥112.6726后得到ARM20变更前的完整板上材料快照¥132.9645，**不能将补齐前后之差说成涨价，也不能把缺货预订价当作替换前现货基线计算降本**。

- SW1/SW2：TL3342F260QG → TS-1187A-B-A-B。改用XKB准确封装；1.5mm、160gf，手感不同，BOOT/RESET功能保留。
- D101/D102：TPD2E2U06DCKR → TPD2E2U06DRLR。同系列不同封装，原3脚映射为3/5/4；新增1/2脚不接，USB保护和5.5V工作范围保留。车规DCK版虽显示库存63，也只有预订参考，未采用。
- R38：原450k未落实准确商品，改300k+新增R401的150k串联，均1%、0603，保持450k标称值及上臂1%最坏容差。
- U501：TPS63811YFFR → TPS63810YFFR，补齐15球0.4mm YFF封装；启动默认为3.3V，必须保持K601断开，设置并回读配置寄存器、按实测界限等待后再显式接通DUT；本板无DUT_OUT实测回读。
- U502：TLV75801PDBVR → TLV75801PDRVR。同系列WSON变体，脚号全部重映射、EP接地；VIO调压反馈不变。
- U503：`TPS22950DDCR`未列于TI可订购表，纠正为`TPS22950CDDCR`。C版同样为自动重试，原先“故障行为不同不能替换”的说明撤回；保持1.15k电阻时只是典型1A限流，不能保证1A连续负载。
- D601/D901/D902：DIODES 1N4148W-7-F → 先科/ST 1N4148W基础库，SOD123极性和线圈续流功能不变；释放时间待实测。

详细资料分析、启动约束和未通过项目见[采购补齐设计说明](procurement-completion.md)，逐脚与封装读回见[映射记录](procurement-pinmap.md)。

## 没有采用的原件与候选

|器件|原因|如何计价|
|---|---|---|
|TPS63811YFFR|库存0，仅预订参考¥22.21|不计现货、不用其与新件差额宣称节省|
|TPD2E2U06DCKR|库存0，仅预订参考¥0.733|同上|
|TPD2E2U06QDCKRQ1|显示库存63，但仅预订参考¥0.94|未采用|
|TLV75801PDBVR|显示库存57，但仅预订参考¥0.297|改用有明确阶梯价的DRV|
|TL3342F260QG|显示库存28，但仅预订参考¥3.11|改用基础库按钮|
|1N4148W-7-F|显示库存3214，但仅预订参考¥0.0936|改用基础库先科件|
|TPS22950DDCR|准确可订购料号不存在于所查TI订购表|不填其他后缀价格冒充|
|450k通用电阻|没有落实准确可采购MPN|采用准确串联组合，未近似为453k|

## 原预算修正与同口径节省

旧¥254.78/板混合预算以及旁支¥80.50部分合计均不能作为整板报价。主控C49451864按JLC十件档¥17.71，其他渠道¥11.90不沿用。C40/C41、连接器的通用预算下降只属于预算修正。TCA9543A早已删除，不重复计收益。

|此前已落实换料|同一JLC口径材料节省/板|10套|边界|
|---|---:|---:|---|
|L1/L2/L4/U101四种替换|¥29.9692|¥299.692|原/新均有同平台报价|
|扣除新增R9=0Ω且不计原R9价值|¥29.9562|¥299.562|原R9基线未齐，非整板最终净节省|
|12颗单路LVC方案及相关去耦/偏置/OE电路变更|¥14.2940|¥142.940|基线996f6b8，已将价格刷新与设计节省分开|
|K601常闭触点替代K902，删D902并重选继电器档位|¥5.7054|¥57.0540|基线0f89de3，同平台完整材料净节省；制造费待定|
|本次11位号补齐的完整同口径净节省|无法计算|无法计算|原11位号没有完整有效现货基线|
|整板制造后最终净节省|待定|待定|MOQ、备损、面积、贴装与订单费用未齐|

电平转换旧已核价子集¥127.0051，按当轮页面刷新为¥126.9666，价格刷新差¥0.0385；新12颗方案子集¥112.6726。当轮转换芯片¥4.896/板，去耦35→50颗/板触发500颗档；13颗偏置替换旧3颗未用通道下拉，删除U305/C32。已知材料节省¥14.294不等同仅芯片差额。原77焊点→146焊点，新增69点/板；换料费仅情景减少1种/¥20。U304保留，所以删除U305不另减一种换料费。该历史计算不被本轮补齐数据改写。

## 当前费用较高的项目

|物料|每板数量|每板金额|
|---|---:|---:|
|HPM5301IEG1|1|¥17.710|
|HFD2/005-S|2|¥11.860|
|TPS63810YFFR|1|¥10.820|
|SN74LVC08APWR|3|¥8.859|
|来源开关2MD1T1B1M2QES-5|1|¥8.720|
|FSA2466UMX|4|¥8.640|
|MCP4726A0T-E/CH|1|¥6.870|
|TCA9539PWR|1|¥6.260|

PWM替代DAC的完整净收益、廉价来源开关的DC额定/先断后通均未闭合，继续保留。SY8089AAAC比TLV62568贵，撤回替换建议。12颗SN74LVC1T45DBVR已采用，40MHz仍待实测。

## 数据方法与采购余项

每个MPN合并整板用量后乘10选阶梯，普通100k共410颗、100nF共500颗、DBVR共120颗；0.1%精密电阻单独计数。使用商品主页面渲染后的库存与“阶梯价格(含税价)”，不把初始SSR的stockNum=0或“预订参考价”当现货结论。嵌入式PDF的访问验证文字与主商品的正常报价分开识别。

剩余采购工作是实际BOM订单中的MOQ/备损、库存锁定、可贴性和制造报价，**没有仍缺价的采购位号**。工程工作仍包括晶体负载、来源开关BBM/DC确认、0.4mm BGA与WSON的DFM、1A限流容差、40MHz/低功耗/调压/热等实板验证；没有因此降低需求基线。

## ARM20 与配套排线增量

|项目|采用型号/编号|10套数量|含税单价|10套材料|
|---|---|---:|---:|---:|
|J801带键简牛|BOOMELE 2.54-2*10P简牛 / [C3405](https://www.jlc-smt.com/lcsc/detail/C3405.html)|10|¥0.893|¥8.93|
|CBL801两端IDC母头排线|XFCN CL2542320200BC10E / [C7496759](https://www.jlc-smt.com/lcsc/detail/C7496759.html)|10|¥3.843|¥38.43|

连接器与线共¥4.736/套。去掉原J801 ¥0.466和J802 ¥0.17后，板上增量为¥0.257/板；含排线比原无排线材料快照增加¥4.10/套、10套¥41.00。此为用户要求的接口升级费用，不是降本收益。J801库存46203、排线623，均为查询快照。另一排线候选C7465815未取得有效嘉立创SMT商品价，未采用其他平台报价补齐。

针脚及防反插核对见 [ARM20接口说明](arm20-interface.md)。20cm排线的40MHz性能与整夹具0.14µA均未实测；手册绝缘下限5MΩ不足以保证漏电目标，当前是可报价的打样附件，不是通过性能验收的量产线束。

## 检测与放电优化增量

历史8fb837e阶段保留K601/K901两颗继电器，删除K902/D902；Q902改作低边放电MOS，R57/R62及互锁不变。继电器30颗×¥5.83→20颗×¥5.93，连同少一颗¥0.0754续流二极管，净省¥5.7054/板、¥57.0540/10套。PCB/贴装/通孔成本尚未报价，不计假设节省。半导体检测候选未闭合5.5V/掉电/成本条件，未计入实际BOM。完整器件、辅助电路、制造边界与拒绝原因见 [检测与放电优化](sense-discharge.md)。

## 本轮：单Vref检测，取消DUT_OUT回读

基线Git `8fb837e`；K901/Q901/D901/R55/R56/C62删除，新增U901 DG2012EDL-T1-GE3（C2673178，10颗档¥3.80）与C901 100nF，R61复用。58行全部194物理位号（含1测试焊盘）已核齐。供电范围、K601/Q902、内/外手动来源与电脑通断均保留。

|比较|单板|10套|
|---|---:|---:|
|上轮价格快照基线|¥127.5161|¥1275.1610|
|50颗100nF旧价¥0.044→本轮¥0.0478的价格刷新|+¥0.1900|+¥1.9000|
|同平台同批报价重新计价基线|¥127.7061|¥1277.0610|
|该阶段实用BOM|¥124.5295|¥1245.2950|
|设计净材料节省（含删除DUT回读功能）|¥3.1766|¥31.7660|
|新增1种扩展库换料情景分摊|¥2.00|¥20.00|
|材料＋换料情景净节省|¥1.1766|¥11.7660|

直接与旧快照相差¥2.9866/板，其中混有价格刷新，不作为纯设计收益。加入额外10%备损后材料＋换料情景净省¥14.9426/订单；MOQ、贴装、少8个通孔/净少3个SMT焊点、PCB面积和运输的真实差额未知，不冒充制造后净节省。完整支路成本、原厂条件和拒绝的候选见[检测/放电设计](sense-discharge.md)。整板140nA（20～30°C）、放电默认态及ADC误差仍未验证；USB掉电而目标仍供电的FSA保护已排除在首版支持范围。

## 支持边界同步（历史 cad895d）

Git cad895d阶段仅同步确认的140nA目标/USB使用限制并修正图面文字，没有换料、改数量或刷新报价。板上¥124.5295/板、¥1,245.2950/10套及配套线金额沿用上述报价快照；该阶段材料增减为¥0/板、¥0/10套；当时R42、VIO和SW601第二极改线仅为候选，未计入节省、采购或新性能承诺，选定后按嘉立创10套总用量重新核价。

## VIO余量与校准改版增量（cad895d→4a619c1，仍采用）

保留MCP4726和TLV758，R58/R59/R60从100k/21.5k/200k改为10k/2.15k/15.4k，全部0603、0.1%、25ppm；U502输入改USB_5V。新料C95204/C861292/C861142分别¥0.184/0.359/0.359（10套每种10颗，均1+档），新反馈网络¥0.902，对应旧¥0.621，**增加¥0.281/板、¥2.81/10套**。这是为余量和校准误差作的小幅成本增加，不写作降本收益。

元件个数、封装、3种扩展SMT料、焊点均不变，换料费情景增量¥0。每种多备1颗的10%示例增量¥0.281/订单，材料含该备损共增加¥3.091/10套。逐板外部校准工时、测试治具/仪器、实际MOQ、PCB及贴装增量未报价；不能把上述¥3.091说成制造总成本变化。

## R42打样方案增量（4a619c1之后，已采用）

用户接受保留TPS22950C、R42改806Ω±0.1%，并保留投用前逐板持续1A、过载、短路、温升必验门槛。采用RT0603BRD07806RL，[C861567](https://www.jlc-smt.com/lcsc/detail/C861567.html)，10套用10颗，1+档¥0.213/颗；详情快照现货1731颗。原C22834为¥0.0311，**增加¥0.1819/板、¥1.819/10套**，已计入顶部完整BOM；不是降本收益，也没有采购付款。

新旧均0603扩展库SMT电阻，换料种类、焊点和占地不变，换料费情景增量¥0；10%示例多备1颗，增量¥0.1819/订单，材料含该备损共增加¥2.0009/10套。实际MOQ、贴装和测试工时未报价。与cad895d相比，VIO及R42材料累计增加¥0.4629/板、¥4.629/10套，含10%备损示例增加¥5.0919/订单。

约1.49A是典型计算，约1.11～1.86A仅筛选估算，未成为厂家保证或整板规格。连续1A、限流窗口、VIO±1%与热/时序均未硬件验收，详见[余量说明](electrical-margins.md)。

## 2026-11-12 功能分析增补

本轮仅新增功能测试台、离线安全策略参考及文档，未换器件或改变BOM，材料增量¥0/板、¥0/10套；报价时间仍沿用原快照，未刷新库存。VIO校准、仪器及样机验收工时未核价，不能按0元计入完整制造成本。详见[专项分析](prefab-analysis.md)。

## 2026-11-12布局与结构增补

本轮未改变板上器件MPN或数量，电子BOM材料差额为¥0；没有重新核实时价或锁定库存，以上仍为2026-11-07报价快照。新增[结构件数量表](../hardware/bom/mechanical.csv)单列底座、盖板和紧固件，单板与10套价格均待核定。PCB扩大至当前110×80mm工作尺寸的制造差额、结构加工、安装和运输未报价，不能把电子材料合计称为整机成本。

## 2026-11-12 测试点增量

新增TP2～TP11，共10个D1.5mm裸铜点，保留TP1/D1.0mm；无采购测试环、连接器或贴装元件。采购材料、备损、SMT贴装点数与换料种类增量均为0，材料增量 **¥0/板、¥0/10套**。板上采购材料仍为¥124.9924/板、¥1249.924/10套，价格日期不变；PCB铜面/工艺、探针治具、校准工时和仪器成本未报价，不能记作零。详见[测试点规划](test-points.md)。
