sanchuanhehe/HSLink-LP/hardware/bom/pcb-features.csv

reference | net | symbol | footprint | qty_per_board | qty_10_boards | procurement | smt_placement | pcb_status
TP1 | SPARE_GPIO | Connector:TestPoint | TestPoint:TestPoint_Pad_D1.0mm | 1 | 10 | PCB裸铜焊盘，无独立采购 | 排除贴装坐标 | 已有焊盘，完整走线及实物可达性待验收
TP2 | VIO_LOCAL | Connector:TestPoint | TestPoint:TestPoint_Pad_D1.5mm | 1 | 10 | PCB裸铜焊盘，无独立采购 | 排除贴装坐标 | 已布置并连通局部节点；拆盖D2mm探测包络检查通过，实物探头待验收
TP3 | GND | Connector:TestPoint | TestPoint:TestPoint_Pad_D1.5mm | 1 | 10 | PCB裸铜焊盘，无独立采购 | 排除贴装坐标 | 已布置并连通局部节点；拆盖D2mm探测包络检查通过，实物探头待验收
TP4 | P3V6_SW | Connector:TestPoint | TestPoint:TestPoint_Pad_D1.5mm | 1 | 10 | PCB裸铜焊盘，无独立采购 | 排除贴装坐标 | 已布置并连通局部节点；拆盖D2mm探测包络检查通过，实物探头待验收
TP5 | POWER_SAFE | Connector:TestPoint | TestPoint:TestPoint_Pad_D1.5mm | 1 | 10 | PCB裸铜焊盘，无独立采购 | 排除贴装坐标 | 已布置并连通局部节点；拆盖D2mm探测包络检查通过，实物探头待验收
TP6 | DISCH_ON | Connector:TestPoint | TestPoint:TestPoint_Pad_D1.5mm | 1 | 10 | PCB裸铜焊盘，无独立采购 | 排除贴装坐标 | 已布置并连通局部节点；拆盖D2mm探测包络检查通过，实物探头待验收
TP7 | SENSE_ON | Connector:TestPoint | TestPoint:TestPoint_Pad_D1.5mm | 1 | 10 | PCB裸铜焊盘，无独立采购 | 排除贴装坐标 | 已布置并连通局部节点；拆盖D2mm探测包络检查通过，实物探头待验收
TP8 | SIG_ARM | Connector:TestPoint | TestPoint:TestPoint_Pad_D1.5mm | 1 | 10 | PCB裸铜焊盘，无独立采购 | 排除贴装坐标 | 已布置并连通局部节点；拆盖D2mm探测包络检查通过，实物探头待验收
TP9 | FAULTn | Connector:TestPoint | TestPoint:TestPoint_Pad_D1.5mm | 1 | 10 | PCB裸铜焊盘，无独立采购 | 排除贴装坐标 | 已布置并连通局部节点；拆盖D2mm探测包络检查通过，实物探头待验收
TP10 | VIO_EN | Connector:TestPoint | TestPoint:TestPoint_Pad_D1.5mm | 1 | 10 | PCB裸铜焊盘，无独立采购 | 排除贴装坐标 | 已布置并连通局部节点；拆盖D2mm探测包络检查通过，实物探头待验收
TP11 | GND | Connector:TestPoint | TestPoint:TestPoint_Pad_D1.5mm | 1 | 10 | PCB裸铜焊盘，无独立采购 | 排除贴装坐标 | 已布置并连通局部节点；拆盖D2mm探测包络检查通过，实物探头待验收
