sanchuanhehe/HSLink-LP/hardware/bom/candidates.csv

references | mpn | lcsc | specification | footprint | qty_per_board | qty_10_boards | unit_price_cny | board_material_cny | batch_material_cny | price_status | stock_snapshot | library | mounting | spares_scenario_qty | moq | purchase_increment | moq_leftover_qty | source_url | retrieved_at | engineering_status
U1 | HPM5301IEG1 | C49451864 | HPM5301IEG1 | Package_DFN_QFN:QFN-48-1EP_6x6mm_P0.4mm_EP4.2x4.2mm | 1 | 10 | 17.71 | 17.71 | 177.10 | 现货阶梯含税价 | 528 | expand | SMT | 1 |  |  |  | https://www.jlc-smt.com/lcsc/detail/C49451864.html | 2026-11-06T19:35:19.456Z | 资料选型/价格核对；未硬件验证
Y1 | X322524MOB4SI | C70590 | 24MHz / CL待配 | Crystal:Crystal_SMD_3225-4Pin_3.2x2.5mm | 1 | 10 | 0.578 | 0.578 | 5.780 | 现货阶梯含税价 | 194283 | expand | SMT | 1 |  |  |  | https://www.jlc-smt.com/lcsc/detail/C70590.html | 2026-11-06T19:42:57.021Z | 采购候选；12pF 负载与现有 15pF 电容及寄生的匹配、起振和频偏待实测
C1 C2 | CL10C150JB8NNNC | C1644 | 容值:15pF,温度系数:C0G,精度:±5%,额定电压:50V | Capacitor_SMD:C_0603_1608Metric | 2 | 20 | 0.0675 | 0.1350 | 1.3500 | 现货阶梯含税价 | 908352 | base | SMT | 2 |  |  |  | https://www.jlc-smt.com/lcsc/detail/C1644.html | 2026-11-06T19:42:29.081Z | 资料选型/价格核对；未硬件验证
R1 R2 | 0603WAF220JT5E | C23345 | 功率:0.1W,工作温度:-55℃~+155℃,工作电压:75V,温度系数:±100ppm/℃,电阻类型:厚膜电阻,精度:±1%,阻值:22000mΩ | Resistor_SMD:R_0603_1608Metric | 2 | 20 | 0.0101 | 0.0202 | 0.2020 | 现货阶梯含税价 | 6065059 | base | SMT | 2 |  |  |  | https://www.jlc-smt.com/lcsc/detail/C23345.html | 2026-11-06T19:42:37.727Z | 资料选型/价格核对；未硬件验证
R3 R4 R5 R10 R16 R51 R52 | 0603WAF1002T5E | C25804 | 功率:0.1W,工作温度:-55℃~+155℃,工作电压:75V,温度系数:±100ppm/℃,电阻类型:厚膜电阻,精度:±1%,阻值:10000Ω | Resistor_SMD:R_0603_1608Metric | 7 | 70 | 0.0142 | 0.0994 | 0.9940 | 现货阶梯含税价 | 42901571 | base | SMT | 7 |  |  |  | https://www.jlc-smt.com/lcsc/detail/C25804.html | 2026-11-06T19:35:56.173Z | 资料选型/价格核对；未硬件验证
SW1 SW2 | TS-1187A-B-A-B | C318884 | 12V/50mA SPST-NO; H=1.5mm; 160gf | Button_Switch_SMD:SW_Push_1P1T_XKB_TS-1187A | 2 | 20 | 0.126 | 0.252 | 2.520 | 现货阶梯含税价 | 967759 | base | SMT | 2 |  |  |  | https://www.jlc-smt.com/lcsc/detail/C318884.html | 2026-11-07T03:43:18.562Z | 功能及四端子/两电气节点映射已核对；操作力/整机机构待实测
J1 | PZ254V-11-06P | C492405 | 服务接口 / ISP | Connector_PinHeader_2.54mm:PinHeader_1x06_P2.54mm_Vertical | 1 | 10 | 0.25 | 0.25 | 2.50 | 现货阶梯含税价 | 97077 | expand | THT | 1 |  |  |  | https://www.jlc-smt.com/lcsc/detail/C492405.html | 2026-11-06T19:35:48.110Z | 资料选型/价格核对；未硬件验证
L1 | SPH4018H4R7MT | C98400 | SPH4018H4R7MT / 4.7uH | HSLinkLP:L_Sunlord_SPH4018 | 1 | 10 | 0.474 | 0.474 | 4.740 | 现货阶梯含税价 | 6025 | expand | SMT | 1 |  |  |  | https://www.jlc-smt.com/lcsc/detail/C98400.html | 2026-11-06T19:35:38.390Z | 资料选型已落实；与原件相同 2A 饱和表值，温升电流较原件低，主控启动/温升待验证
C3 C4 C25 C34 | CL10A226MP8NUNE | C86295 | 容值:22uF,温度系数:X5R,精度:±20%,额定电压:10V | Capacitor_SMD:C_0603_1608Metric | 4 | 40 | 0.199 | 0.796 | 7.960 | 现货阶梯含税价 | 643687 | expand | SMT | 4 |  |  |  | https://www.jlc-smt.com/lcsc/detail/C86295.html | 2026-11-06T19:42:27.249Z | 资料选型/价格核对；未硬件验证
C5 C33 C36 C39 | CL10A106KP8NNNC | C19702 | 容值:10uF,温度系数:X5R,精度:±10%,额定电压:10V | Capacitor_SMD:C_0603_1608Metric | 4 | 40 | 0.124 | 0.496 | 4.960 | 现货阶梯含税价 | 10462071 | base | SMT | 4 |  |  |  | https://www.jlc-smt.com/lcsc/detail/C19702.html | 2026-11-06T19:42:25.439Z | 资料选型/价格核对；未硬件验证
C6 C7 C8 C9 C10 C11 C12 C13 C14 C15 C16 C18 C20 C21 C22 C26 C28 C29 C30 C31 C42 C46 C56 C57 C58 C59 C48 C49 C50 C51 C52 C53 C54 C55 C701 C702 C703 C704 C705 C706 C707 C708 C709 C710 C711 C712 C713 C714 C715 C716 C901 | CC0603KRX7R9BB104 | C14663 | 容值:100nF,温度系数:X7R,精度:±10%,额定电压:50V | Capacitor_SMD:C_0603_1608Metric | 51 | 510 | 0.0478 | 2.4378 | 24.3780 | 现货阶梯含税价 | 34559856 | base | SMT | 51 |  |  |  | https://www.jlc-smt.com/lcsc/detail/C14663.html | 2026-11-07T04:45:39.276Z | 资料选型/价格核对；未硬件验证
C17 C19 C43 C44 | TCC0603X7R475K100CT | C18185770 | 容值:4.7uF,温度系数:X7R,精度:±10%,额定电压:10V | Capacitor_SMD:C_0603_1608Metric | 4 | 40 | 0.106 | 0.424 | 4.240 | 现货阶梯含税价 | 331813 | expand | SMT | 4 |  |  |  | https://www.jlc-smt.com/lcsc/detail/C18185770.html | 2026-11-06T19:50:00.191Z | 资料选型/价格核对；未硬件验证
U2 | TLV803EA30DBZR | C5218924 | TLV803EA30DBZR | Package_TO_SOT_SMD:SOT-23 | 1 | 10 | 1.94 | 1.94 | 19.40 | 现货阶梯含税价 | 7245 | expand | SMT | 1 |  |  |  | https://www.jlc-smt.com/lcsc/detail/C5218924.html | 2026-11-06T19:42:09.745Z | 资料选型/价格核对；未硬件验证
R6 R7 R8 R13 R15 R23 R24 R25 R26 R27 R28 R29 R30 R31 R32 R33 R34 R35 R36 R37 R39 R44 R45 R49 R50 R63 R61 R62 R701 R702 R703 R704 R705 R706 R707 R708 R709 R710 R711 R712 R713 | 0603WAF1003T5E | C25803 | 功率:0.1W,工作温度:-55℃~+155℃,工作电压:75V,温度系数:±100ppm/℃,电阻类型:厚膜电阻,精度:±1%,阻值:100000Ω | Resistor_SMD:R_0603_1608Metric | 41 | 410 | 0.0176 | 0.7216 | 7.2160 | 现货阶梯含税价 | 16259040 | base | SMT | 41 |  |  |  | https://www.jlc-smt.com/lcsc/detail/C25803.html | 2026-11-07T03:23:06.690979+00:00 | 资料选型/价格核对；未硬件验证
J101 | USB4105-GF-A | C3020560 | USB4105-GF-A | Connector_USB:USB_C_Receptacle_GCT_USB4105-xx-A_16P_TopMnt_Horizontal | 1 | 10 | 5.06 | 5.06 | 50.60 | 现货阶梯含税价 | 19437 | expand | SMT | 1 |  |  |  | https://www.jlc-smt.com/lcsc/detail/C3020560.html | 2026-11-06T19:42:16.893Z | 资料选型/价格核对；未硬件验证
U101 | WUSB3801Q-12/TR | C2931342 | WUSB3801Q-12/TR | HSLinkLP:WillSemi_QFN1616_12L | 1 | 10 | 2.0968 | 2.0968 | 20.9680 | 现货阶梯含税价 | 1760 | expand | SMT | 1 |  |  |  | https://www.jlc-smt.com/lcsc/detail/C2931342.html | 2026-11-06T19:35:41.660Z | 硬件资料选型已落实；I2C 地址 0x68，驱动/CC 预算/USB 掛起联调未实现
R9 | 0603WAF0000T5E | C21189 | 功率:0.1W,工作温度:-55℃~+155℃,工作电压:75V,温度系数:-,电阻类型:厚膜电阻,精度:±1%,阻值:0Ω | Resistor_SMD:R_0603_1608Metric | 1 | 10 | 0.013 | 0.013 | 0.130 | 现货阶梯含税价 | 19226181 | base | SMT | 1 |  |  |  | https://www.jlc-smt.com/lcsc/detail/C21189.html | 2026-11-06T19:43:00.428Z | 资料选型/价格核对；未硬件验证
U102 | TPS259531DSGR | C2155674 | TPS259531DSGR | Package_SON:Texas_DSG0008A_WSON-8-1EP_2x2mm_P0.5mm_EP0.9x1.6mm | 1 | 10 | 4.37 | 4.37 | 43.70 | 现货阶梯含税价 | 1273 | expand | SMT | 1 |  |  |  | https://www.jlc-smt.com/lcsc/detail/C2155674.html | 2026-11-06T19:42:08.049Z | 资料选型/价格核对；未硬件验证
C23 | CL10B472KB8NNNC | C1621 | 容值:4.7nF,温度系数:X7R,精度:±10%,额定电压:50V | Capacitor_SMD:C_0603_1608Metric | 1 | 10 | 0.0588 | 0.0588 | 0.5880 | 现货阶梯含税价 | 366687 | expand | SMT | 1 |  |  |  | https://www.jlc-smt.com/lcsc/detail/C1621.html | 2026-11-06T19:42:32.698Z | 资料选型/价格核对；未硬件验证
C24 C35 C47 | CL10B105KP8NNNC | C95843 | 容值:1uF,温度系数:X7R,精度:±10%,额定电压:10V | Capacitor_SMD:C_0603_1608Metric | 3 | 30 | 0.109 | 0.327 | 3.270 | 现货阶梯含税价 | 454134 | expand | SMT | 3 |  |  |  | https://www.jlc-smt.com/lcsc/detail/C95843.html | 2026-11-06T19:42:30.917Z | 资料选型/价格核对；未硬件验证
R11 | 0603WAF4991T5E | C23046 | 功率:0.1W,工作温度:-55℃~+155℃,工作电压:75V,温度系数:±100ppm/℃,电阻类型:厚膜电阻,精度:±1%,阻值:4990Ω | Resistor_SMD:R_0603_1608Metric | 1 | 10 | 0.0125 | 0.0125 | 0.1250 | 现货阶梯含税价 | 1640996 | base | SMT | 1 |  |  |  | https://www.jlc-smt.com/lcsc/detail/C23046.html | 2026-11-06T19:42:41.269Z | 资料选型/价格核对；未硬件验证
R12 | 0603WAF2211T5E | C22903 | 功率:0.1W,工作温度:-55℃~+155℃,工作电压:75V,温度系数:±100ppm/℃,电阻类型:厚膜电阻,精度:±1%,阻值:2210Ω | Resistor_SMD:R_0603_1608Metric | 1 | 10 | 0.0172 | 0.0172 | 0.1720 | 现货阶梯含税价 | 10826 | expand | SMT | 1 |  |  |  | https://www.jlc-smt.com/lcsc/detail/C22903.html | 2026-11-06T19:42:43.121Z | 资料选型/价格核对；未硬件验证
Q101 Q102 Q701 Q702 | 2N7002 | C8545 | 2N7002 | Package_TO_SOT_SMD:SOT-23 | 4 | 40 | 0.104 | 0.416 | 4.160 | 现货阶梯含税价 | 4182194 | base | SMT | 4 |  |  |  | https://www.jlc-smt.com/lcsc/detail/C8545.html | 2026-11-06T19:42:20.414Z | 资料选型/价格核对；未硬件验证
R14 | 0603WAF1501T5E | C22843 | 功率:0.1W,工作温度:-55℃~+155℃,工作电压:75V,温度系数:±100ppm/℃,电阻类型:厚膜电阻,精度:±1%,阻值:1500Ω | Resistor_SMD:R_0603_1608Metric | 1 | 10 | 0.0117 | 0.0117 | 0.1170 | 现货阶梯含税价 | 3282944 | base | SMT | 1 |  |  |  | https://www.jlc-smt.com/lcsc/detail/C22843.html | 2026-11-06T19:42:45.056Z | 资料选型/价格核对；未硬件验证
D101 D102 | TPD2E2U06DRLR | C1972959 | 双路ESD; 5.5V VRWM; 1.5pF典型 | Package_TO_SOT_SMD:SOT-553 | 2 | 20 | 1.984 | 3.968 | 39.680 | 现货阶梯含税价 | 7498 | expand | SMT | 2 |  |  |  | https://www.jlc-smt.com/lcsc/detail/C1972959.html | 2026-11-07T03:48:48.211Z | 同系列DRL封装替换；3=IO1/5=IO2/4=GND/1,2=NC；USB眼图与ESD待实测
U201 | TCA9539PWR | C131972 | TCA9539PWR / 0x74 | Package_SO:TSSOP-24_4.4x7.8mm_P0.65mm | 1 | 10 | 6.26 | 6.26 | 62.60 | 现货阶梯含税价 | 7419 | expand | SMT | 1 |  |  |  | https://www.jlc-smt.com/lcsc/detail/C131972.html | 2026-11-06T19:36:02.878Z | 资料选型/价格核对；未硬件验证
R17 R18 | 0603WAF4701T5E | C23162 | 功率:0.1W,工作温度:-55℃~+155℃,工作电压:75V,温度系数:±100ppm/℃,电阻类型:厚膜电阻,精度:±1%,阻值:4700Ω | Resistor_SMD:R_0603_1608Metric | 2 | 20 | 0.0169 | 0.0338 | 0.3380 | 现货阶梯含税价 | 16199126 | base | SMT | 2 |  |  |  | https://www.jlc-smt.com/lcsc/detail/C23162.html | 2026-11-06T19:42:39.452Z | 资料选型/价格核对；未硬件验证
U301 U302 U303 | SN74LVC08APWR | C465737 | SN74LVC08APWR | Package_SO:TSSOP-14_4.4x5mm_P0.65mm | 3 | 30 | 2.953 | 8.859 | 88.590 | 现货阶梯含税价 | 376 | expand | SMT | 3 |  |  |  | https://www.jlc-smt.com/lcsc/detail/C465737.html | 2026-11-06T19:42:13.363Z | 资料选型/价格核对；未硬件验证
U304 | SN74LVC1G04DBVR | C7827 | SN74LVC1G04DBVR | Package_TO_SOT_SMD:SOT-23-5 | 1 | 10 | 0.395 | 0.395 | 3.950 | 现货阶梯含税价 | 70043 | expand | SMT | 1 |  |  |  | https://www.jlc-smt.com/lcsc/detail/C7827.html | 2026-11-07T03:23:45.826020+00:00 | 资料选型/价格核对；未硬件验证
U401 | TLV62568DBVR | C163219 | TLV62568DBVR | Package_TO_SOT_SMD:SOT-23-5 | 1 | 10 | 0.457 | 0.457 | 4.570 | 现货阶梯含税价 | 51255 | expand | SMT | 1 |  |  |  | https://www.jlc-smt.com/lcsc/detail/C163219.html | 2026-11-06T19:35:28.375Z | 资料选型/价格核对；未硬件验证
L2 | SPH4018H2R2MT | C370436 | SPH4018H2R2MT / 2.2uH | HSLinkLP:L_Sunlord_SPH4018 | 1 | 10 | 0.488 | 0.488 | 4.880 | 现货阶梯含税价 | 22557 | expand | SMT | 1 |  |  |  | https://www.jlc-smt.com/lcsc/detail/C370436.html | 2026-11-06T19:35:40.163Z | 资料选型已落实；1A buck 假设下电流余量可用，异常限流与温升待验证
R38 | 0603WAF3003T5E | C23024 | 300k/1%/100mW; 与R401串联构成450k | Resistor_SMD:R_0603_1608Metric | 1 | 10 | 0.0229 | 0.0229 | 0.2290 | 现货阶梯含税价 | 493912 | base | SMT | 1 |  |  |  | https://www.jlc-smt.com/lcsc/detail/C23024.html | 2026-11-07T03:48:40.868Z | 串联300k+150k维持450k标称值及1%最坏容差；电源精度/稳定性待实测
R401 | 0603WAF1503T5E | C22807 | 150k/1%/100mW; 与R38串联构成450k | Resistor_SMD:R_0603_1608Metric | 1 | 10 | 0.0098 | 0.0098 | 0.0980 | 现货阶梯含税价 | 716498 | base | SMT | 1 |  |  |  | https://www.jlc-smt.com/lcsc/detail/C22807.html | 2026-11-07T03:48:33.501Z | 串联反馈新增；同R38技术边界
U402 | TPS7A2036PDBVR | C2873626 | TPS7A2036PDBVR | Package_TO_SOT_SMD:SOT-23-5 | 1 | 10 | 1.779 | 1.779 | 17.790 | 现货阶梯含税价 | 2792 | expand | SMT | 1 |  |  |  | https://www.jlc-smt.com/lcsc/detail/C2873626.html | 2026-11-06T19:42:18.662Z | 纠正不可确认料号；3.6V/300mA，100mA VIO 预算和热待验证
U501 | TPS63810YFFR | C1852139 | I2C升降压; 1.8-5.2V器件范围，工程限制1.8-5.0V | HSLinkLP:Texas_YFF0015_1.344x2.255mm_P0.4mm | 1 | 10 | 10.82 | 10.82 | 108.20 | 现货阶梯含税价 | 253 | expand | SMT | 1 |  |  |  | https://www.jlc-smt.com/lcsc/detail/C1852139.html | 2026-11-07T03:41:11.015Z | 启动默认3.3V；INT_EN下拉和K601常开保持；先隔离/编程/回读/稳定再闭合；固件及实板待验证
L4 | MWSA0603S-R47MT | C408439 | MWSA0603S-R47MT / 470nH | Inductor_SMD:L_Sunlord_MWSA0603S | 1 | 10 | 0.852 | 0.852 | 8.520 | 现货阶梯含税价 | 2408 | expand | SMT | 1 |  |  |  | https://www.jlc-smt.com/lcsc/detail/C408439.html | 2026-11-06T19:35:17.416Z | 资料选型已落实；封装增大，AC 损耗、开关波形与热待实测
C40 C41 | CL31A476MPHNNNE | C96123 | 容值:47uF,温度系数:X5R,精度:±20%,额定电压:10V | Capacitor_SMD:C_1206_3216Metric | 2 | 20 | 1.0442 | 2.0884 | 20.8840 | 现货阶梯含税价 | 468799 | base | SMT | 2 |  |  |  | https://www.jlc-smt.com/lcsc/detail/C96123.html | 2026-11-06T19:35:43.158Z | 1206 已绑定；DC bias 典型曲线初算通过，最小有效容量/纹波/稳定性待验证
U502 | TLV75801PDRVR | C2876308 | 可调LDO 0.55V参考; WSON-6+EP | Package_SON:WSON-6-1EP_2x2mm_P0.65mm_EP1x1.6mm | 1 | 10 | 1.773 | 1.773 | 17.730 | 现货阶梯含税价 | 3075 | expand | SMT | 1 |  |  |  | https://www.jlc-smt.com/lcsc/detail/C2876308.html | 2026-11-07T03:48:26.149Z | 同系列DRV换封装；功能映射及EP接地核对；VIO反馈/调压功能保留；实测待办
U503 | TPS22950CDDCR | C7587833 | SOT23-6限流开关; 自动重试/反向阻断 | Package_TO_SOT_SMD:SOT-23-6 | 1 | 10 | 3.22 | 3.22 | 32.20 | 现货阶梯含税价 | 1931 | expand | SMT | 1 |  |  |  | https://www.jlc-smt.com/lcsc/detail/C7587833.html | 2026-11-07T03:48:18.833Z | R42=806Ω±0.1%打样方案；无该档厂家限流窗口保证；逐板持续1A/过载/短路/温升投用前必验；外部2A支路不经过U503
R42 | RT0603BRD07806RL | C861567 | 806Ω;±0.1%;±25ppm/°C;100mW;75V;薄膜;0603 | Resistor_SMD:R_0603_1608Metric | 1 | 10 | 0.213 | 0.213 | 2.130 | 现货阶梯含税价 | 1731 | expand | SMT | 1 |  |  |  | https://www.jlc-smt.com/lcsc/detail/C861567.html | 2026-11-07T06:01:50.207Z | 用户接受低成本打样；典型限流约1.487A；806Ω档无厂家保证上下限；逐板持续1A/过载/短路/温升投用前必验
J601 J602 | KF128-5.08-2P-AA | C474952 | EXT 1.8-5.5V; DUT POWER | HSLinkLP:TerminalBlock_KEFA_KF128_5.08_1x02 | 2 | 20 | 1.177 | 2.354 | 23.540 | 现货阶梯含税价 | 74200 | expand | THT | 2 |  |  |  | https://www.jlc-smt.com/lcsc/detail/C474952.html | 2026-11-06T19:35:44.656Z | 资料选型/价格核对；未硬件验证
SW601 | 2MD1T1B1M2QES-5 | C908282 | 2MD1T1B1M2QES-5 | HSLinkLP:SW_Dailywell_2MD1T1B1M2QES_5 | 1 | 10 | 8.72 | 8.72 | 87.20 | 现货阶梯含税价 | 36 | expand | THT | 1 |  |  |  | https://www.jlc-smt.com/lcsc/detail/C908282.html | 2026-11-06T19:35:31.372Z | 现有选型保留；精确后缀 DC 额定与 BBM 待厂商确认
Q601 Q902 | AO3400A | C20917 | AO3400A | Package_TO_SOT_SMD:SOT-23 | 2 | 20 | 0.543 | 1.086 | 10.860 | 现货阶梯含税价 | 1074072 | base | SMT | 2 |  |  |  | https://www.jlc-smt.com/lcsc/detail/C20917.html | 2026-11-07T04:45:53.451Z | Q601线圈驱动；Q902改作低边放电开关，G1/S2/D3；正向体二极管方向已核对，OFF泄漏及USB掉电栅极瞬态待测
U801 U802 U803 U804 | FSA2466UMX | C457657 | FSA2466UMX | Package_DFN_QFN:UQFN-16_1.8x2.6mm_P0.4mm | 4 | 40 | 2.16 | 8.64 | 86.40 | 现货阶梯含税价 | 8469 | expand | SMT | 4 |  |  |  | https://www.jlc-smt.com/lcsc/detail/C457657.html | 2026-11-06T19:35:23.010Z | 资料选型/价格核对；未硬件验证
J801 | 2.54-2*10P简牛 | C3405 | ARM20 2x10 2.54mm keyed shrouded header; no target supply | Connector_IDC:IDC-Header_2x10_P2.54mm_Vertical | 1 | 10 | 0.893 | 0.893 | 8.930 | 现货阶梯含税价 | 46203 | expand | THT | 1 |  |  |  | https://www.jlc-smt.com/lcsc/detail/C3405.html | 2026-11-07T04:01:59.717Z | 逐脚/隔离映射核对；40MHz与配套排线漏电待实测
J803 J804 | PZ254V-11-05P | C492404 | UART_A / TX RX DTR RTS GND; UART_B / TX RX DTR RTS GND | Connector_PinHeader_2.54mm:PinHeader_1x05_P2.54mm_Vertical | 2 | 20 | 0.192 | 0.384 | 3.840 | 现货阶梯含税价 | 226460 | expand | THT | 2 |  |  |  | https://www.jlc-smt.com/lcsc/detail/C492404.html | 2026-11-06T19:35:46.431Z | 资料选型/价格核对；未硬件验证
R53 R54 | RT0603BRD0768KL | C705793 | 功率:100mW,工作温度:-55℃~+155℃,工作电压:75V,温度系数:±25ppm/℃,电阻类型:薄膜电阻,精度:±0.1%,阻值:68kΩ | Resistor_SMD:R_0603_1608Metric | 2 | 20 | 0.213 | 0.426 | 4.260 | 现货阶梯含税价 | 14790 | expand | SMT | 2 |  |  |  | https://www.jlc-smt.com/lcsc/detail/C705793.html | 2026-11-07T04:45:25.171Z | 资料选型/价格核对；未硬件验证
C61 | CL10B102KB8NNNC | C1588 | 容值:1nF,工作温度:-55℃~+125℃,温度系数:X7R,精度:±10%,额定电压:50V | Capacitor_SMD:C_0603_1608Metric | 1 | 10 | 0.05 | 0.05 | 0.50 | 现货阶梯含税价 | 5390142 | base | SMT | 1 |  |  |  | https://www.jlc-smt.com/lcsc/detail/C1588.html | 2026-11-07T04:45:32.225Z | 资料选型/价格核对；未硬件验证
R57 | 0603WAF1001T5E | C21190 | 功率:0.1W,工作温度:-55℃~+155℃,工作电压:75V,温度系数:±100ppm/℃,电阻类型:厚膜电阻,精度:±1%,阻值:1000Ω | Resistor_SMD:R_0603_1608Metric | 1 | 10 | 0.0101 | 0.0101 | 0.1010 | 现货阶梯含税价 | 27639359 | base | SMT | 1 |  |  |  | https://www.jlc-smt.com/lcsc/detail/C21190.html | 2026-11-06T19:42:48.276Z | 0.1W 精确料号；5.5V、1%低阻端时放电峰值约30.56mW，额定温度内有余量；热/异常工况待实测
U504 | MCP4726A0T-E/CH | C191581 | MCP4726A0T-E/CH | Package_TO_SOT_SMD:SOT-23-6 | 1 | 10 | 6.87 | 6.87 | 68.70 | 现货阶梯含税价 | 4812 | expand | SMT | 1 |  |  |  | https://www.jlc-smt.com/lcsc/detail/C191581.html | 2026-11-06T19:35:29.873Z | 资料选型/价格核对；未硬件验证
R58 | RT0603BRD0710KL | C95204 | 功率:100mW,工作温度:-55℃~+155℃,工作电压:75V,温度系数:±25ppm/℃,电阻类型:薄膜电阻,精度:±0.1%,阻值:10kΩ | Resistor_SMD:R_0603_1608Metric | 1 | 10 | 0.184 | 0.184 | 1.8400 | 现货阶梯含税价 | 1947210 | expand | SMT | 1 |  |  |  | https://www.jlc-smt.com/lcsc/detail/C95204.html | 2026-11-07T06:01:44.241Z | VIO反馈余量调整；逐板外部校准，±1%目标待实测
R59 | RT0603BRD072K15L | C861292 | 功率:100mW,工作温度:-55℃~+155℃,工作电压:75V,温度系数:±25ppm/℃,电阻类型:薄膜电阻,精度:±0.1%,阻值:2.15kΩ | Resistor_SMD:R_0603_1608Metric | 1 | 10 | 0.359 | 0.359 | 3.5900 | 现货阶梯含税价 | 6301 | expand | SMT | 1 |  |  |  | https://www.jlc-smt.com/lcsc/detail/C861292.html | 2026-11-07T06:01:46.214Z | VIO反馈余量调整；逐板外部校准，±1%目标待实测
R60 | RT0603BRD0715K4L | C861142 | 功率:0.1W,工作温度:-55℃~+155℃,工作电压:75V,温度系数:±25ppm/℃,电阻类型:薄膜电阻,精度:±0.1%,阻值:15.4kΩ | Resistor_SMD:R_0603_1608Metric | 1 | 10 | 0.359 | 0.359 | 3.5900 | 现货阶梯含税价 | 1464 | expand | SMT | 1 |  |  |  | https://www.jlc-smt.com/lcsc/detail/C861142.html | 2026-11-07T06:01:48.214Z | VIO反馈余量调整；逐板外部校准，±1%目标待实测
K601 | HFD2/005-S | C42415145 | HFD2/005-S | HSLinkLP:Relay_Hongfa_HFD2 | 1 | 10 | 5.93 | 5.93 | 59.30 | 现货阶梯含税价 | 109 | expand | THT | 1 |  |  |  | https://www.jlc-smt.com/lcsc/detail/C42415145.html | 2026-11-07T04:45:46.330Z | K601 COM4=DUT、NO8=SOURCE、NC6=放电；Vref改U901，DUT_OUT不再采样；转换抖动、释放与漏电/温升待实测
D601 | 1N4148W | C81598 | 先科/ST; SOD123; 75V/150mA | Diode_SMD:D_SOD-123 | 1 | 10 | 0.0754 | 0.0754 | 0.7540 | 现货阶梯含税价 | 3562382 | base | SMT | 1 |  |  |  | https://www.jlc-smt.com/lcsc/detail/C81598.html | 2026-11-07T04:16:05.783Z | K=1/A=2，USB侧继电器续流；线圈电流余量核对，释放/抖动时间待实测
U701 U702 U703 U704 U705 U706 U707 U708 U709 U710 U711 U712 | SN74LVC1T45DBVR | C7843 | 元件数:1,功能特性:断电保护,功能特性:输出使能高阻,工作温度:-40℃~+85℃,工作电压(VCCA):1.65V~5.5V,工作电压(VCCB):1.65V~5.5V,拉电流(IOH):-,接口类型:-,数据速率:420Mbps,每个电路通道数:1,灌电流(IOL):-,芯片类型:电平转换器,输入信号:-,输出信号:-,输出类型:非反相,输出类型:三态,通道类型:双向 | Package_TO_SOT_SMD:SOT-23-6 | 12 | 120 | 0.408 | 4.896 | 48.960 | 现货阶梯含税价 | 254502 | expand | SMT | 12 |  |  |  | https://www.jlc-smt.com/lcsc/detail/C7843.html | 2026-11-07T03:22:56.006846+00:00 | 用户选定打样；脚号/封装资料核对；40MHz、换向及漏电待实测
U901 | DG2012EDL-T1-GE3 | C2673178 | 单SPDT/SC-70-6；COM掉电保护；NC不接；USB_5V供电；Vref仅1.8～3.3V | Package_TO_SOT_SMD:SOT-363_SC-70-6 | 1 | 10 | 3.8 | 3.8 | 38.0 | 现货阶梯含税价 | 117 | expand | SMT | 1 |  |  |  | https://www.jlc-smt.com/lcsc/detail/C2673178.html | 2026-11-07T04:45:17.800Z | 资料/引脚核对；20～30°C整夹具140nA及ADC误差待实测；FSA带电目标下USB掉电保护不在首版支持范围
