sanchuanhehe/HSLink-LP/hardware/bom/accessories.csv

reference | mpn | lcsc | specification | qty_per_kit | qty_10_kits | unit_price_cny | kit_material_cny | batch_material_cny | price_status | stock_snapshot | mounting | spares_scenario_qty | moq | purchase_increment | source_url | retrieved_at | engineering_status
CBL801 | CL2542320200BC10E | C7496759 | IDC 2.54mm 2x10 female keyed both ends; 20-core 28AWG; 200mm excluding heads; 1:1 | 1 | 10 | 3.843 | 3.843 | 38.430 | 现货阶梯含税价 | 623 | ACCESSORY | 1 |  |  | https://www.jlc-smt.com/lcsc/detail/C7496759.html | 2026-11-07T04:02:38.818Z | 打样配套：≥5MΩ绝缘规格不能保证0.14µA夹具指标；20cm/40MHz及机械插合待测；非量产合格线束
