sanchuanhehe/HSLink-LP/hardware/design/mechanical/hslink_lp_lid.step

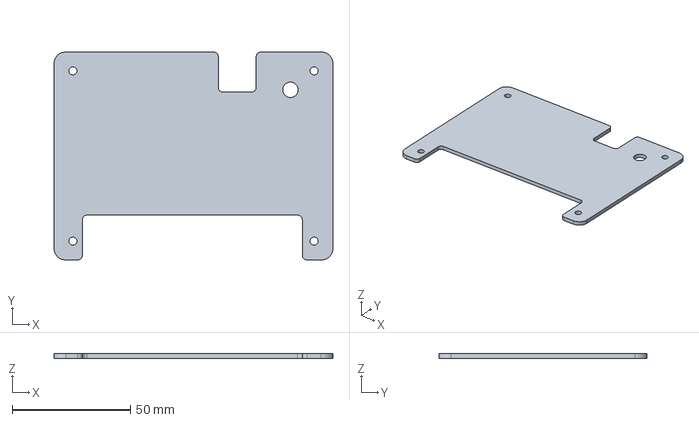
[picture p1: CAD file, 2026-11-12]
hardware/design/mechanical/hslink_lp_lid.step
118.0 x 88.0 x 2.00 mm
