sanchuanhehe/HSLink-LP/hardware/design/mechanical/hslink_lp_base.step

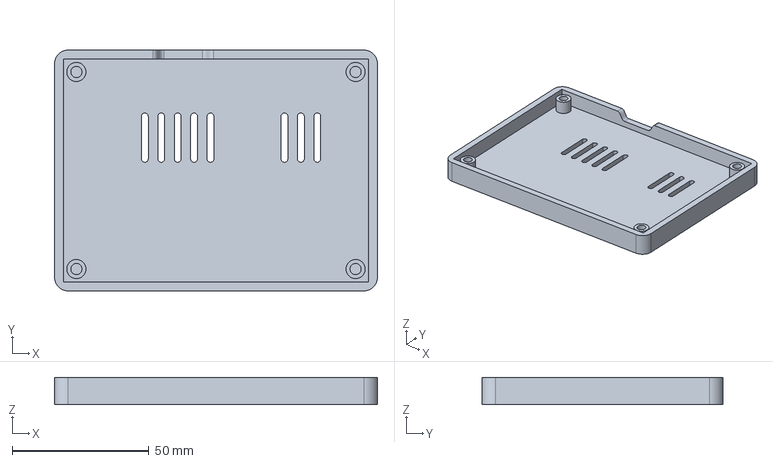
[picture p2: CAD file, 2026-11-12]
hardware/design/mechanical/hslink_lp_base.step
118.0 x 88.0 x 10.0 mm
