sanchuanhehe/HSLink-LP/(list of files, cad)

Other CAD files:
hardware/design/mechanical/hslink_lp_base.stl
hardware/design/mechanical/hslink_lp_lid.dxf
hardware/design/mechanical/hslink_lp_lid.stl
