sanchuanhehe/HSLink-LP/docs/test-points.md

# 首板测试点与外部校准规划

2026-11-12。以当前需求基线和实际网表为准。以下为工程规划；原理图符号、封装选择、PCB 可达性和实板性能分别验收。当前任务不改变电路功能、140 nA／20～30°C、VIO 1.8～3.3 V／逐板外部校准±1%和40 MHz目标。

## 规划表

| 网络 / 位号或复用位置 | 测量目的 | 形态与邻近地 | PCB位置与探测约束 | 本轮处理 |
|---|---|---|---|---|
| VIO_LOCAL / TP2 | 逐板外部校准、启动、1.8↔3.3 V 调压 | D1.5 mm裸铜；TP3 GND | 靠C44输出端，远离FB和开关节点；TP2/TP3中心距暂定3.81 mm，校准夹具和探头确认后冻结；就近引出，不能接到目标侧Vref | 原理图与PCB已落实；实物探测待验收 |
| GND / TP3 | VIO仪器回线 | D1.5 mm裸铜 | 与TP2成对；先接地再接信号；不作1 A负载电流返回点 | 原理图与PCB已落实；实物探测待验收 |
| P3V6_SW / TP4 | 核对FSA供电、启动和负载波形 | D1.5 mm裸铜；就近C36.2或FSA去耦地 | 放在FSA供电分配侧，仍属调试器侧；保留地弹簧接触位置 | 原理图与PCB已落实；实物探测待验收 |
| POWER_SAFE / TP5 | 复位门控、继电器线圈请求时序 | D1.5 mm裸铜；TP11 GND | 靠U301输出至Q601的路径，就近接入既有控制节点，不穿过敏感检测区；实际低速路径见下表 | 原理图与PCB已落实；实物探测待验收 |
| DISCH_ON / TP6 | 放电默认关闭、供电/放电互锁 | D1.5 mm裸铜；TP11或Q902.S GND | 靠U303输出至Q902栅极；这是控制电压，不是触点状态或放电完成反馈 | 原理图与PCB已落实；实物探测待验收 |
| SENSE_ON / TP7 | U901默认断开与测量锁状态 | D1.5 mm裸铜；TP11 GND | 置于控制侧，远离DUT_VREF和U901模拟端；不得跨隔离边界引线 | 原理图与PCB已落实；实物探测待验收 |
| SIG_ARM / TP8 | 总使能及复位撤销使能时序 | D1.5 mm裸铜；TP11 GND | 靠U301、与TP5/6/7按功能成组，避免长探头回路 | 原理图与PCB已落实；实物探测待验收 |
| FAULTn / TP9 | 输入eFuse/内置限流异常诊断 | D1.5 mm裸铜；就近地 | 共享故障网，只能确认有故障，不能单靠此点判断是哪个芯片；高阻探头，禁止外加拉高电压 | 原理图与PCB已落实；实物探测待验收 |
| VIO_EN / TP10 | DAC先配置、LDO后开启及异常关闭顺序 | D1.5 mm裸铜；TP3 GND | 靠U502/R63，与VIO波形同时采集；不可让探头驱动EN | 原理图与PCB已落实；实物探测待验收 |
| GND / TP11 | 控制区探头返回 | D1.5 mm裸铜 | 靠TP5～8，不能以远处鳄鱼夹代替就近短地；多探头实际接地距离待布局复核 | 原理图与PCB已落实；实物探测待验收 |
| P3V3 / J1.1、C34.1 | 主控电源/复位监控 | 复用接口/电容，J1.2、C34.2为GND | 不加重复TP；电源噪声在电容端用短地测，接口处适合直流检查 | 复用 |
| VBUS_RAW / C24.1；USB_5V / C25.1 | 输入保护前后压降、启动及掉电 | 复用电容各自的2脚GND | 首板保留探针接近空间；不用USB-C密集引脚直接夹探头 | 复用 |
| INT_RAW / C40.1或C41.1 | 升降压输出纹波、负载瞬态 | 复用1206电容及其2脚GND | 优先在输出电容两端探测；不在电感SW节点加普通TP | 复用 |
| INT_PROTECTED / C47.1或SW601.1 | U503保护前后压降/限流排查 | 复用电容/开关焊盘，C47.2 GND | SW601下方访问可能需拆底座；不是带电拔插测试夹的承诺 | 复用 |
| SOURCE_POWER / SW601.2或K601.8 | 区分来源选择与继电器输出故障 | 复用通孔焊盘；就近地 | 不增加跨内外电源的负载；底面可达性待机械检查 | 复用 |
| DUT_OUT / J602.1 | 外部电压、负载与放电波形 | 复用端子；J602.2 GND | 目标侧敏感点；不恢复板载电压采样，不提供实测遥测；漏电验收移除电压探头 | 复用 |
| SYS_RESETn / J1.6 | 上电/复位及互锁故障定位 | 复用J1，J1.2 GND | 高阻输入，禁止主动注入电压；与POWER_SAFE/SIG_ARM同时采集 | 复用 |
| ADC_VREF / C61.1 | 建立、采样扰动、转换误差诊断 | 仅复用C61.1/2；不加独立焊盘 | 高阻且在U901之后；只在明确测试模式显式接通，测量锁时不能自动接通 | 复用，受负载影响 |
| SPARE_GPIO / TP1 | 已有备用调试/时序标记 | 保留D1.0 mm裸铜；邻地待PCB复核 | 固件尚未分配时序标记功能，不宣称已实现 | 保留 |

所有新增点均选标准 `Connector:TestPoint`（单一被动引脚1）及 `TestPoint:TestPoint_Pad_D1.5mm`（圆形SMD铜1.5 mm，F.Cu/F.Mask，无F.Paste、无孔，排除BOM和坐标贴装文件）。不采购测试环或排针。当前尺寸为手动探针/打样夹具的工程选择，不冒充嘉立创测试厂探针规范。相邻测试点中心距优先≥2.54 mm，VIO成对点先按3.81 mm；外露铜到板边优先≥2 mm、避开螺柱/插头/盖板支架，最终位置须在PCB/结构阶段逐点检查。

## 高速与低漏电边界

- SWDIO转换器前复用R1.1/R2.1（SWD_MCU）；R1.2/R2.2是MCU两条独立收发路径，不能当成两个相同网络。必要时探测U702的A/B焊盘，B侧仍在FSA之前。
- SWCLK/TCK转换器前后可对照U701的A/B焊盘；TDO可对照U704。小封装焊盘只适合微探针/受控焊接探头，不等于普通夹子可达。具体接触点和邻地由PCB阶段确认。
- FSA之后优先从ARM20现有接点测：7=SWDIO/TMS、9=TCK、13=TDO；邻近8/10/14为GND。SWDIO/TMS、TCK、TDO均不增大裸铜TP、不加排针、不引出长支线，不要求所有中间位置常驻探头。
- 示波器探头输入电容及地线电感会改变波形，应使用低电容主动探头或合适的短地弹簧探测方式；主动探头≤1 pF为选型目标而非现有仪器参数，最终按实物探头规格和实际边沿评估。一次测一个关键位置，必要的同时采样应计入所有探头负载。不能以40 MHz时钟频率或芯片最高Mbps代替边沿、换向、排线验收。[Tektronix探头负载说明](https://www.tek.com/en/documents/application-note/how-oscilloscope-probes-affect-your-measurement)、[Keysight探头选型](https://www.keysight.com/gb/content/lib/resources/selection-guides/oscilloscope-probes.html)。
- 不增加DUT_VREF的目标侧铜点。J801.1为目标Vref入口，U901后C61为检测节点；它们不允许用飞线跨接。FSA输出、DUT_VREF、DUT_OUT及连接器表面均属低漏电敏感区域。
- 漏电验收前移除示波器、电压表、逻辑分析仪、临时负载、飞线、探针夹具及任何跨断开边界的连接；仅保留测试定义所需的外部供电/电流仪器与线束。清洗助焊剂，记录温湿度、污染和接线。3.3 V上的10 MΩ电压表本身约取330 nA，已大于140 nA目标，不能常接后仍声称测得夹具本征附加电流。
- 新增点都在调试器供电/控制侧；不新增目标侧电阻、保护或指示灯。FSA14通道在25°C上限求和140 nA、覆盖20～30°C的全温筛选和700 nA，另有U901、PCB、线束等，预算依旧未闭合。新增测试点不使问题自动关闭。

## ADC探测负载计算

名义R53=R54=68 kΩ、C61=1 nF，忽略开关电阻和ADC动态输入时，等效源阻抗34 kΩ，RC时间常数34 µs。仪器输入电阻Rp并在ADC节点后，相对原分压的增益比为Rp/(Rp+34 kΩ)：10 MΩ约−0.3388%，1 MΩ约−3.2882%，100 MΩ约−0.0340%。不是ADC总误差保证。

探头电容并入C61；例如10 pF只是在这个理想RC模型中把电容量增加1%，实际采样保持、切换残留和接地仍需实测。优先不接探头读ADC基线，再显式接通U901进行受控对照，记录Rp/Cp/仪器误差并去嵌负载，不能用带载表读数直接校正成“无负载真实Vref”。沿用专项文档的接通等待/采样试验初值，不因探测降低实测门槛。

## 校准与互锁测试顺序

1. USB供电，确认所有目标信号/检测断开；校准VIO时目标板不作校准负载。K601按测试目的保持安全状态。
2. TP3接地，TP2接外部高阻电压表，TP10用于EN时序，必要时在C44就地测启动/调压波形。记录仪器量程、输入电阻、校准有效期、精度及环境。测量扩展不确定度建议≤0.2%，属于工程预算，仪器未指定时不能称已满足。
3. 沿用逐板1.8～3.3 V多点校准与插值复核、负载/输入/温度检查；校准数据必须标注板号与CRC。没有VIO/DUT_OUT板载ADC，设定值、预测值、Power Good和FAULTn均不冒充实测电压。
4. 用TP5/6/8、J1.6核对复位、供电与放电互锁；用TP7核对U901控制。控制脚电压不证明继电器触点已经转换，也不证明DUT已经放电完成；DUT波形用J602外部仪器另测。
5. 调压先断开信号，完成DAC配置/电压稳定检查后仅能显式恢复。校准、Vref读取、串口/DTR/RTS或DAP均不得隐式解除测量锁；当前协议/固件实现状态沿用需求记录。

## 成本与验收状态

本轮已新增10个裸铜点、保留TP1；独立采购器件、贴装点、换料种类增量为0，材料增量¥0/板、¥0/10套。PCB面积、夹具、探针、校准工时、表面处理与实际生产报价另算，未报价不记零。采购BOM与板上特征表分开，不能把铜点称作已获得嘉立创现货报价。

已通过MCP添加并回读10个测试点，TP1保留；11点均排除采购BOM与贴装坐标。完整网表对比确认原有194个器件全部引脚连接分组及值/封装/符号不变，仅新增10个被动引脚连接到既有网络。现有117个连接网络、685个连接引脚、45个独立NC；ERC为0错误/0告警，未新增忽略项。人工查看Safety与TargetPower全页导出图，测试点标签与短线分离、未观察到新增文字重叠。摘要及源文件哈希见`hardware/validation.json`。上述为独立原理图提交的检查记录；后续PCB落实状态如下。探针型号/间距、污染漏电、40 MHz及实际校准精度仍需实板验收。

## PCB落实与拆盖探测（2026-11-12）

PCB原点为板框左上角，单位mm，全部新增点在顶面。TP2/TP3中心距3.81mm；TP8/TP11中心距3.81mm。所有新增点保持D1.5mm无焊膏焊盘，11个TP均排除采购BOM/贴装坐标。PCB上增加VIO/GND及底面网络对照丝印。

| 位号 | 坐标X/Y | 已布通的局部端点 | 新增局部铜线长度约mm |
|---|---|---|---:|
| TP2 | 56 / 24.2 | C44.1、U502.1、R58.1 | 3.02 |
| TP3 | 52.19 / 24.2 | 地过孔→内层GND | 1.60 |
| TP4 | 81.5 / 32 | C36.1 | 3.82 |
| TP5 | 62 / 33 | R31.1 | 9.81 |
| TP6 | 88.5 / 35 | U303.3 | 11.72 |
| TP7 | 78 / 35 | U302.8 | 8.92 |
| TP8 | 66 / 33 | U301.13 | 7.40 |
| TP9 | 99.5 / 36 | U503.6 | 12.23 |
| TP10 | 69 / 27 | R63.1 | 9.32 |
| TP11 | 69.81 / 33 | 地过孔→内层GND | 1.61 |

这些是低速控制/电源探测路径，不是40MHz信号支线。初稿“控制支线≤5mm”属于未验证布局建议，本轮为可达性与绕开器件采用上表实际路径；没有放宽高速或低漏电需求。局部端点连通不表示整条控制网已经布完：当前PCB仍有399条未连接报告项，TP1也仍待完整接通。

基于当前真实PCB STEP和结构C模型，10个新增点的直径2mm、竖直向上35mm探针包络均未与器件模型相交，但均被透明盖板覆盖，必须拆盖后测试。该包络是工程假设，不是实物探头验收；探头尖端、绝缘套、夹头、测试针行程与侧向接近尚未选定。上盖仍保持可拆结构，不新增开孔或测试排针。模型不覆盖完整器件公差，夹具生产前必须用选定探头和实物首板复核。

TP3/TP11已接地平面；其余控制点应按实际回路选最近的器件地焊盘或短地弹簧，TP11不能替代所有高频探测的就近地。来源开关/继电器底部焊盘若用于故障检查需拆底座；ARM20微探头和螺丝端子的真实插接、螺丝刀操作空间仍待实物确认。漏电验收前必须移除临时探测连接并清洗。

## 调试布线后的TP1调整（2026-11-13）

为主控复位驱动跨过供电主干留出位置，TP1从(46.8,43.3)移到(44.8,46.8)mm，顶层位号放在(44.8,48.3)mm。裸铜尺寸、SPARE_GPIO网络及排除采购BOM属性不变；原理图未改，TP1到MCU仍待完整连接。其余测试点保持。当前未连接146条，替代历史399条计数；实物探针与透明盖拆卸后的可达性尚未验收。
