sanchuanhehe/HSLink-LP/docs/spice-validation.md

# SPICE功能仿真记录

2026-11-11。以当前原理图和[需求基线](requirements.md)为准。结论：**分模块功能仿真已执行；整板验证 INCOMPLETE，不能投板验收或宣称硬件指标通过。**

2026-11-12增补：新增启动/调压、异常放电、ADC采样保持和软件锁审查见 [投板前专项分析](prefab-analysis.md)。特别是动态反馈注入时TI宏模型出现非物理吸收电流及数值敏感过冲，不能把本页标称模型结果外推为动态等待、容差或硬件保证。下文为第一轮记录。

## 电路核对及修复

开始时Git为`24e5309`，根原理图已有未提交排线改动，另有用户`.history/`目录。本轮保留其他改动和该目录，没有恢复整份旧工程，也没有新建版本副本。

实际导出网表发现R42退回1.15k，R58/R59/R60退回100k/21.5k/200k，U502.6/C43.1退回P3V6_SW，与已接受的余量方案及BOM不一致。经对话澄清，恢复已确定的方案：806Ω、10k/2.15k/15.4k，以及USB_5V输入；同步采购字段。原BOM已是这些型号，**本轮相对已采用BOM无新增物料或价差**，未重新刷新嘉立创报价。

根原理图SWD_MCU标签与R1/R2连接断开，本轮只补标签至现有导线的1.27mm连接段。U503嵌入符号同步现有项目库，R60位号/数值改为水平分行。所有原理图修改通过已安装KiCad MCP执行。

最终9页ERC为0错误/0告警；原有忽略项中含simulation_model_issue，故ERC不用于判断仿真模型是否齐全。最终194物理器件、117连接网络、675连接引脚及45独立NC，与此前已采用余量方案的网表逐引脚分组、数值和封装一致。对本轮开始网表的有意变化仅为SWD_MCU重接、VIO输入两引脚换轨及四颗电阻恢复；没有新增DUT_OUT采样，也没有恢复K901/K902。

根页和TargetPower的悬空标签、孤立导线、穿过器件线条检查均无发现；人工查看导出图的SWD、R42和VIO区域。其他七页源码未动，未冒称重新人工逐项检查其全部排版。

## 求解器与模型

KiCad10.0.7自带ngspice45.2共享库实际执行，MCP导出网表并运行ERC。全板原始SPICE导出仍有大量无模型IC占位，不能直接运行并声称全板通过。测试输入位于`hardware/design/simulation`，原始波形、每个测试用例、日志、PDF在忽略的`hardware/design/reports/spice-2026-11-11`；源码与模型哈希记录于`hardware/validation.json`及`models.json`。

U502采用[TI SBVM926](https://www.ti.com/lit/zip/SBVM926)中**未修改**的TLV75801P_TRANS Final1.00。宏模型端口EN/FB/GND/VIN/VOUT分别对应实物4/2/3+7/6/1；5为DNC。模型头明确不模拟静态电流、噪声或温度效应。DAC用理想电压源`3.3×code/4096`，不包含MCP4726误差、EEPROM、I²C、校准、启动或异常。输入电源也为理想源，不包含上游USB/eFuse/稳压器动态。

Vref开关、逻辑门、继电器触点及Q902均为**显式假设的功能模型**，不是厂家模型。关断电阻取极大值只为验证隔离位置；不能据此计算整板真实漏电。放电接点延迟、先断后通与1µs电导变化均为刺激假设，不能证明真实触点行为。

## 已运行的20个用例

| 模块 | 覆盖 | 结果与限制 |
| --- | --- | --- |
| VIO常规9例 | USB_5V=4.5/5/5.5V；设定1.8/2.5/3.3V；DAC码3183/1845/316；C44理想4.7µF；10→100mA负载阶跃；EN启停 | 全部算到12ms；名义稳态读数在设定±1%内，仅限此模型/理想DAC/标称阻容，不构成校准后精度保证 |
| VIO异常1例＋数值复核2例 | DAC零码；3.3V/5.5V与零码以更严格容差和更小步长重算 | 零码稳态约3.46V，不能当作安全默认工作码；正常3.3V峰值复核约3.313V。零码启动峰值约3.54～3.56V且有数值敏感性，不拿它做上界或保护保证 |
| Vref4例 | 输入1.8/3.3V；完整68k/68k/1n采样开/关；人为注入0/40nA关断电流 | ADC接通约0.89997/1.64994V，1% RC建立约157µs；ADC采样保持负载未建模，该数值不能直接成为固件等待值 |
| 放电3例 | 5.5V目标源，1/100/1000µF目标电容；供电时错误放电请求、关电不放电、显式放电、再供电 | 给定行为模型下互锁正确；100ms放电后100µF约2.024V、1000µF约4.977V；需用目标电容和实测决定时间，不能固定100ms宣称完成 |
| Safety1例 | 从实际引脚连接构建512组稳定输入组合 | 512/512与期望逻辑一致；复位或SIG_ARM=0时端口禁止、POWER_SAFE=1时禁止放电。未模拟真实门延迟、控制器启动或软件锁 |

VIO在USB_5V=5V时的模型输出：

| 设定 | 10mA稳态 | 100mA稳态 | 10→100mA瞬态最低 |
| --- | ---: | ---: | ---: |
| 1.8V | 1.79884V | 1.78943V | 1.77603V |
| 2.5V | 2.49804V | 2.49127V | 2.47927V |
| 3.3V | 3.29746V | 3.29234V | 3.28179V |

1.8V的此负载阶跃短暂超过±1%范围；启动/负载瞬态不能混同稳态校准目标。实际转换器负载是否达到此阶跃、C44直流偏压后容量/ESR及供电线阻均需补测，不因这一假设刺激擅自降低要求或增加硬件。

Vref接通时分压从目标取电约13.235/24.264µA，断开后分压不再直接接目标。人为注入40nA时ADC稳态残留约2.72mV，这是注入电流×68k的结果，**不是DG2012E漏电测量或保证**。关断读数不能冒充有效Vref。

R57在5.5V开始放电时理论功率约30.25mW；电容能量、器件容差、异常电压和真实MOS/触点行为仍需实测。到0.3V的理想RC时间约为2.91RC，100µF需约291ms、1000µF需约2.91s；还需另加触点释放等待，0.3V只是计算示例而非用户确认阈值。图中的50ms等待是既有待测初值。

## 仿真可信度和未覆盖项

TI模型在初始严格求解设置下出现内部锁存器收敛失败；加载所需XSPICE模型、使用Gear与明确最大步长后运行完成，未改厂商模型。波形检查发现理想恒流负载会在LDO尚未建立输出时强拉负压，已给测试负载加入0.5V低压顺从区并重跑；此前负压/较大过冲属于测试台问题，不作为电路结论。两组细化复查已保留日志；零码启动仍对容差设置敏感。

- TPS63810没有取得适用于当前电路的可运行模型，升降压环路、纹波、电感峰值、USB功率预算和持续1A/热未完成SPICE验证。
- [TI SLVMDI3](https://www.ti.com/lit/zip/SLVMDI3)模型标为TPS22950，2020年版、YBH库，未明确支持TPS22950C，ILIM表也非本次C版保证。没有用它替代当前C版验证。R42=806Ω仍是用户接受的逐板实测打样方案。
- 40MHz SWD/JTAG未做合格IBIS/传输线联合验证；FSA、12颗电平转换器、串阻、板上寄生、20cm排线和固件实际采样均不能被这些低速功能仿真覆盖。
- 140nA/20～30°C整夹具目标仍未闭合：14条FSA在25°C规定测试条件的上限求和已140nA，覆盖温区的保守筛选为700nA，还要计U901、线束、PCB。没有放宽要求或声称通过。
- 真实继电器释放/抖动/焊接、续流影响、短路温升、MOS反向异常、上电/掉电、电气保护以及USB外供边界未验收。
- Safety是组合逻辑验证，不包含MCU/主机协议和测量锁状态机。固件须显式维持锁；调压、串口、DAP不得解锁。尚无真实HID控制实现。

后续优先验证：外部校准和VIO动态 → 实际触点释放/放电 → 内置1A及过载热协调 → 漏电与40MHz。当前可以开始接口与结构占位、规划PCB，但不能将此次仿真当作生产放行。
