sanchuanhehe/HSLink-LP/docs/debug-routing.md

# 调试链路布线检查点

2026-11-13，基于 `47bae55` 的后续布线。本检查点为146条未连接报告项，不是投板稿；后续最新状态与U801电源短线调整见[复位与双串口布线](reset-uart-routing.md)。40MHz、持续1A、140nA/20～30°C及VIO±1%均未实板验收。

## 本阶段连接

采用明确坐标的受控路径，经pcbnew原生几何预检查后写入，不使用普通自动布线器处理调试网络。主控已有27个已用普通/调试I/O出口保留；U1.26为NC，USB与晶振维持原顶层路径。

|网络段|连接检查|信号过孔数|铜线长度合计 mm|
|---|---|---:|---:|
|SWD_MCU|R1/R2共用端→U702.3|2|38.471|
|TCK_MCU|U1.24/41→U701.3及R701|2|50.986|
|SWD_DIR|U1.38→U702.5/R713|2|46.391|
|TDI_MCU|U1.22→U703.3/R703|2|51.570|
|TDO_MCU|U1.23→U704.3|2|39.853|
|F_SWDIO|U702/R702→U801.16|2|28.445|
|F_TCK|U701→U801.4|2|27.669|
|F_TDI|U703→U801.8|2|13.863|
|F_TDO|U704/R704→U801.12|0|5.233|
|DUT_SWDIO|U801.15→ARM20第7针|0|9.417|
|DUT_TCK|U801.3→ARM20第9针|0|8.343|
|DUT_TDI|U801.7→ARM20第5针|1|19.337|
|DUT_TDO|U801.11→ARM20第13针|2|23.912|

表中是各网络全部铜段总和，含分支，不是端到端飞行时间或时序余量。SWD的独立MOSI/MISO仍经原22Ω电阻汇合，不短接不同网络。FSA使能、目标复位/复位断开等控制尚未全部接通，不能称整个调试接口已经可用。

NRST_DRIVE已从U1.20连到R49/Q701栅极；FAULTn仅完成U1与U201之间，U102、R16和U503/TP9所在分组仍待互连。NRST_DRIVE绕开供电主干、高速线及器件，需要4孔；只为这个低速开漏驱动控制网增加明确的4孔规则，保留Debug线宽。其他Debug网络仍为2孔上限，全部制造下限不变。临时诊断板的NRST第5孔、TCK第3孔分别触发对应规则；诊断板已删除，正式工程未增加违规或忽略项。

## 局部布局与供电

- TDO在主控侧直接沿F.Cu引出，移除原(45.3,40.6)mm的冗余扇出过孔；在(46.4,45.2)/(46.4,50.7)mm两处换层。其余原U1交错出口保留，新增局部过桥孔仍用0.50/0.25mm。
- R713移到(34.8,50.5)mm；C56移到(23.6,66.025)mm，给FSA信号留出走廊。C53/C56回流孔及U703固定DIR的P3V3接入位置同步整理，所有焊盘网络保持。
- U801电源脚由(27.3,65.0)mm的0.60/0.30mm孔接P3V6_SW，C56经该电源的短底层连接供给。该孔在器件体下、非焊盘内，原生API确认正反面均盖油；仍需工厂核对阻焊覆盖、焊接与完整去耦回路，不能由间距通过推导动态性能。
- P3V3主控局部改用明确顶层跨接，为TCK/SWD_DIR的底层路径让出空间；电源和地孔仍为0.60/0.30mm。此前移动后的C19/C20等去耦回路仍需最终电源完整性复核。
- TP1备用测试点从(46.8,43.3)移到(44.8,46.8)mm，保留原裸铜点、网络和排除采购BOM属性；丝印移到下方。该网仍待接通，实物探针可达性待最终装配确认。
- ARM20→UART A→UART B→DUT电源顺序、USB/端子/来源开关和安装孔未移动；结构C开放底座与可拆透明盖保持。本阶段未更新或宣称最终3D装配通过。

## 回流及检查

新增11个0.60/0.30mm地回流孔；调试数据、时钟和DIR的实际信号过孔到最近地孔中心距离为0.763～2.250mm。F_SWDIO的FSA端为2.250mm，TCK主控北侧为2.159mm，需在最终SI复核中重点检查；距离只是几何指标，不能充当回流阻抗保证。未在目标侧增加测试支线、常接电阻或指示灯；新增地铜/阻焊邻近敏感端口仍须纳入清洁、湿度和整夹具漏电实测。

In1/In2均只有GND铜区，各为一个连通填充轮廓，内层信号走线为0。按不大于0.1mm步距检查已布网络中心线下方地铜，排除同网过孔中心0.6mm内的换层区后：MCU、转换器/FSA之间、DIR、NRST和USB/晶振路径未发现无参考铜取样点；四条目标信号各有10点落在自身ARM20通孔反焊盘内，原始坐标保留。它们属于连接器过渡，不能写成针脚下仍有连续GND；偶数排地针提供连接器返回，连接器/20cm排线及目标板时序仍待验证。

与47bae55逐项比较，759个焊盘对象的位号、引脚号、UUID及网络保持；211个封装保留。当前1041段走线、355个过孔，其中33个0.50/0.25mm、322个0.60/0.30mm，没有0.45/0.20mm。12个网类、142条分配保留，全局线宽/间距0.127mm、板边0.25mm、普通通孔0.60/0.30mm未回退。

当前生产工程由KiCad CLI重新加载，重铺铜并执行全部走线检查和原理图parity：一般违规0，未连接146，parity0；没有新增忽略项。人工查看当前顶层、底层、FSA/ARM20局部及两内层导出图，TP1丝印与焊盘分离、未发现本阶段新增文字遮挡。初次移动C56时发现与旧地孔短接，已移开地孔并通过最终检查。

原始证据位于忽略目录`hardware/design/reports/debug-routing-2026-11-13`，摘要与源哈希见`hardware/validation.json`。资料、文件连通性、DRC和图面检查不代替实板验收。采购BOM增量¥0/板、¥0/10套；PCB工艺费用尚未重新报价。

后续：完成FSA使能/复位目标侧、双串口、ADC/VIO/互锁、FAULTn其余分组及其他低速网络；继续检查去耦、回流、探针可达性；未连接清零后再作整板DRC、最新PCB结构装配和制造输出。
