sanchuanhehe/HSLink-LP/hardware/design/HSLink-LP.kicad_pcb

## KiCad design hardware/design/HSLink-LP.kicad_pcb (2026-11-13)

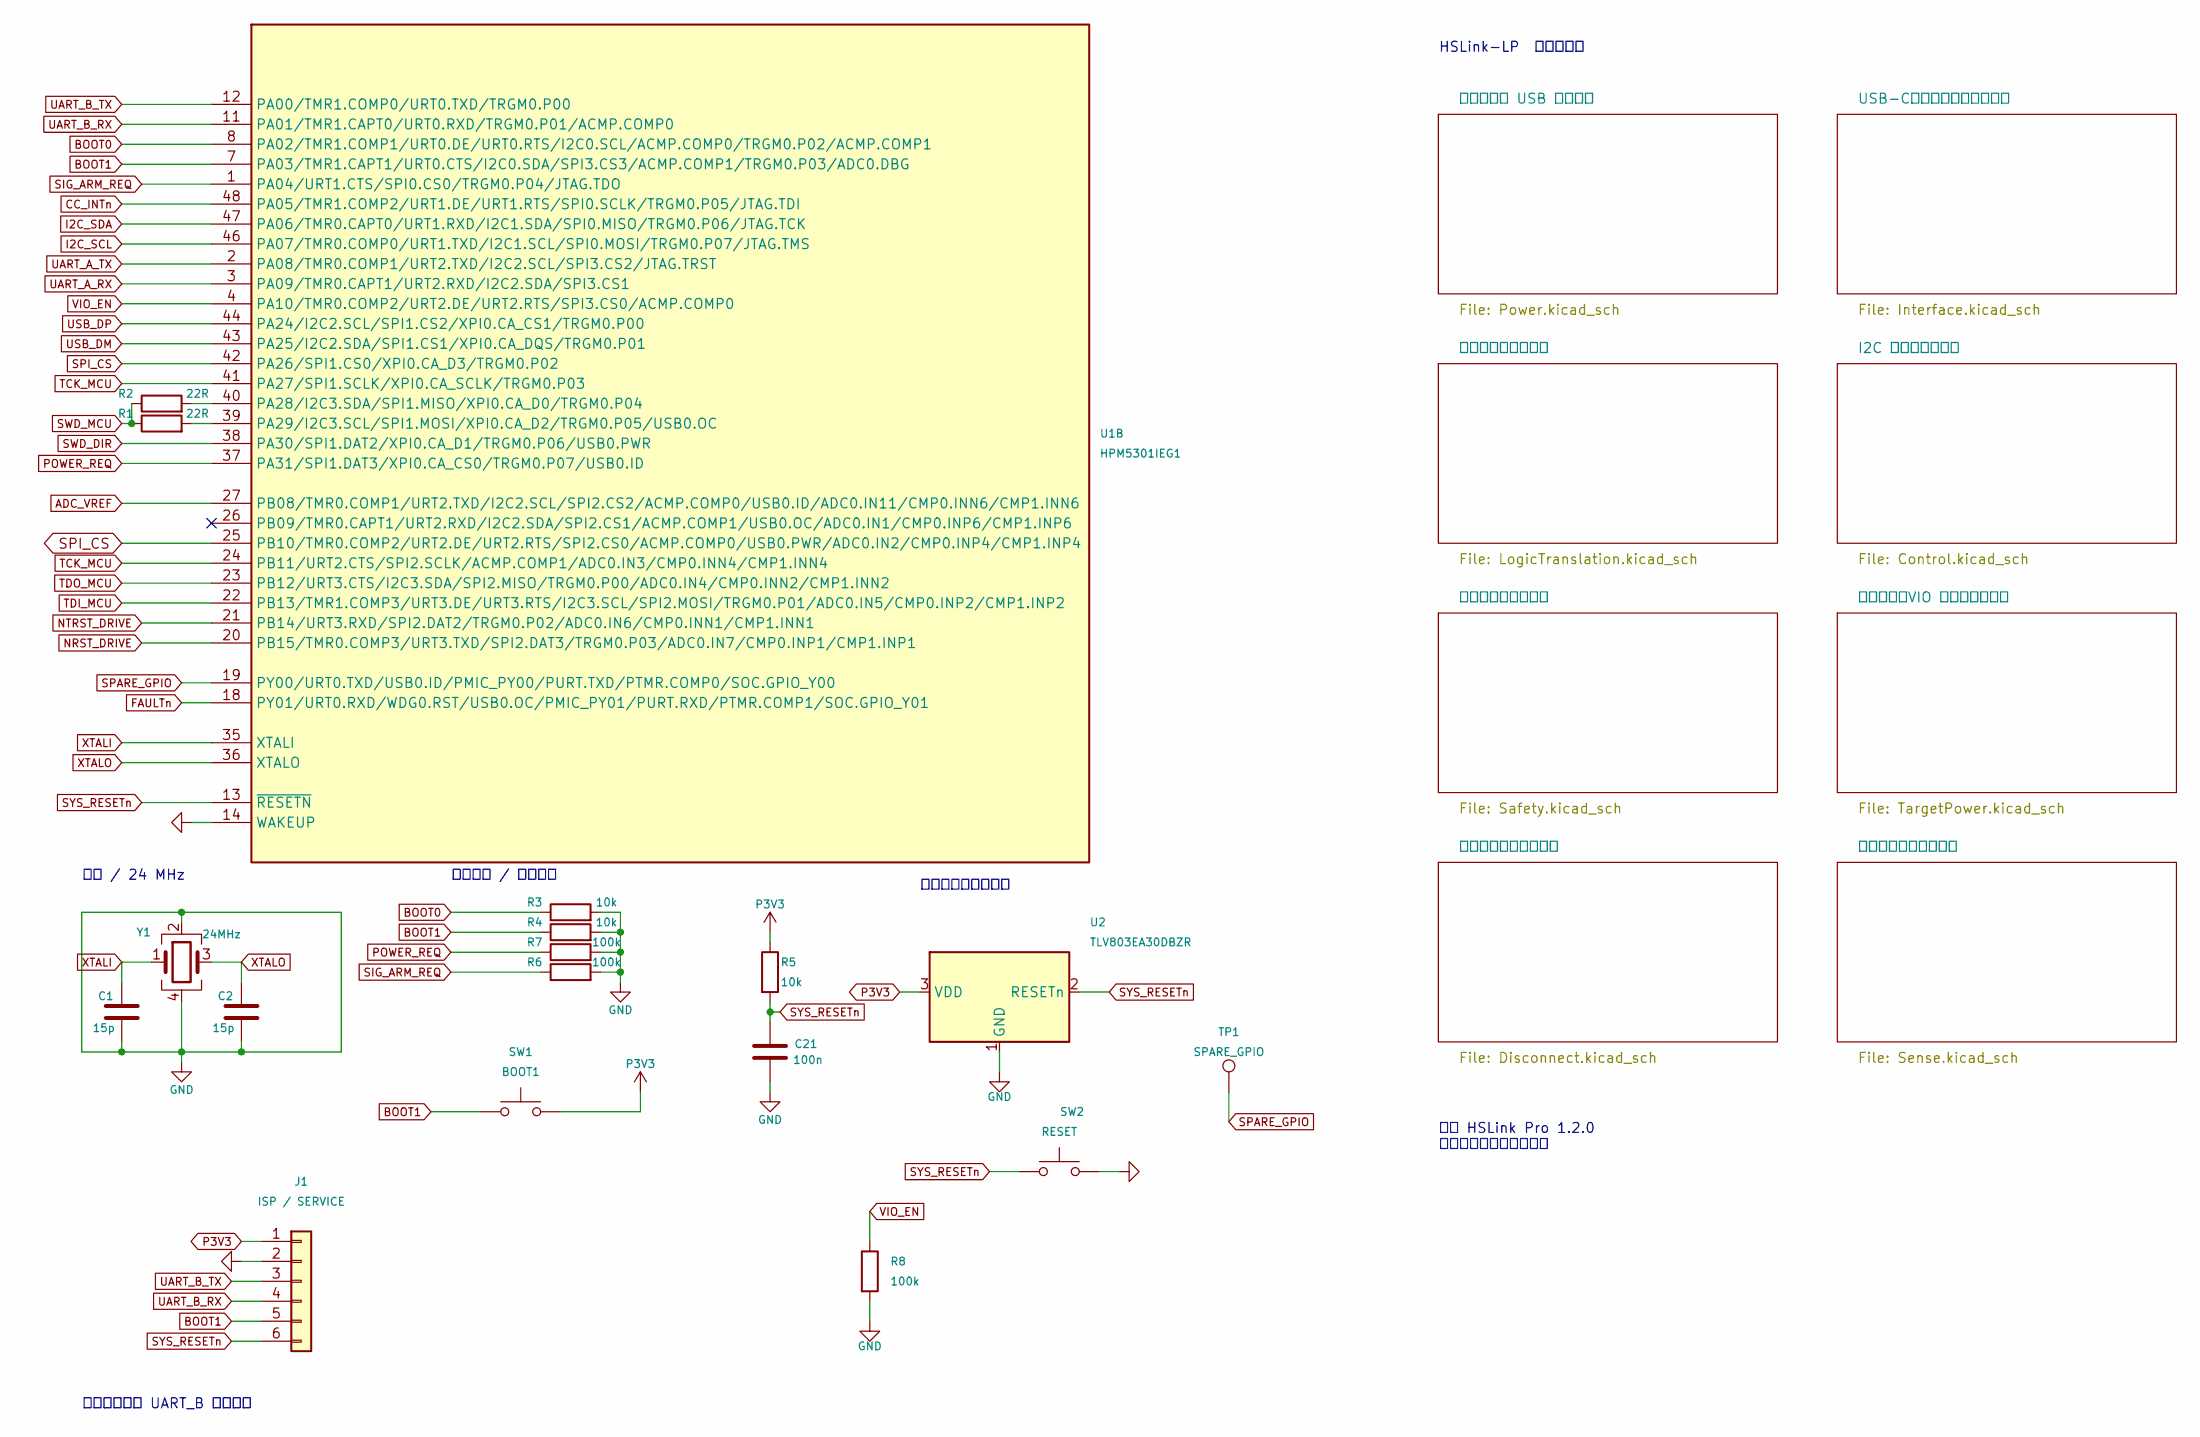
[picture p3: schematic HSLink-LP.kicad_sch, 主控与恢复接口]

Parts:
C1, C2: 15p; C_0603_1608Metric; MPN CL10C150JB8NNNC; LCSC C1644
C21: 100n; C_0603_1608Metric; MPN CC0603KRX7R9BB104; LCSC C14663
J1: ISP / SERVICE; PinHeader_1x06_P2.54mm_Vertical; MPN PZ254V-11-06P; LCSC C492405
R1, R2: 22R; R_0603_1608Metric; MPN 0603WAF220JT5E; LCSC C23345
R3, R4, R5: 10k; R_0603_1608Metric; MPN 0603WAF1002T5E; LCSC C25804
R6, R7, R8: 100k; R_0603_1608Metric; MPN 0603WAF1003T5E; LCSC C25803
SW1: BOOT1; SW_Push_1P1T_XKB_TS-1187A; MPN TS-1187A-B-A-B; LCSC C318884
SW2: RESET; SW_Push_1P1T_XKB_TS-1187A; MPN TS-1187A-B-A-B; LCSC C318884
TP1: SPARE_GPIO; TestPoint_Pad_D1.0mm; MPN PCB test pad
U1: HPM5301IEG1; QFN-48-1EP_6x6mm_P0.4mm_EP4.2x4.2mm
U2: TLV803EA30DBZR; SOT-23; MPN TLV803EA30DBZR; LCSC C5218924
Y1: 24MHz; Crystal_SMD_3225-4Pin_3.2x2.5mm; MPN X322524MOB4SI; LCSC C70590

Connections:
ADC_VREF: U1.27 (PB08/TMR0.COMP1/URT2.TXD/I2C2.SCL/SPI2.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); also elsewhere on the board
BOOT0: R3.1, U1.8 (PA02/TMR1.COMP1/URT0.DE/URT0.RTS/I2C0.S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)
BOOT1: J1.5, R4.1, SW1.1, U1.7 (PA03/TMR1.CAPT1/URT0.CTS/I2C0.SDA/SPI3.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)
CC_INTn: U1.48 (PA05/TMR1.COMP2/URT1.DE/URT1.RTS/SPI0.S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); also elsewhere on the board
FAULTn: U1.18 (PY01/URT0.RXD/WDG0.RST/USB0.OC/PMIC_PY0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); also elsewhere on the board
GND: C1.2, C2.2, C21.2, J1.2, R3.2, R4.2, R6.2, R7.2, R8.2, SW2.2, U1.14 (WAKEUP), U2.1 (GND), Y1.2, Y1.4; also elsewhere on the board
I2C_SCL: U1.46 (PA07/TMR0.COMP0/URT1.TXD/I2C1.SCL/SPI0.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); also elsewhere on the board
I2C_SDA: U1.47 (PA06/TMR0.CAPT0/URT1.RXD/I2C1.SDA/SPI0.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); also elsewhere on the board
NRST_DRIVE: U1.20 (PB15/TMR0.COMP3/URT3.TXD/SPI2.DAT3/TRGM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); also elsewhere on the board
NTRST_DRIVE: U1.21 (PB14/URT3.RXD/SPI2.DAT2/TRGM0.P02/ADC0.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); also elsewhere on the board
unnamed: R2.2, U1.40 (PA28/I2C3.SDA/SPI1.MISO/XPI0.CA_D0/TRGM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)
unnamed: R1.2, U1.39 (PA29/I2C3.SCL/SPI1.MOSI/XPI0.CA_D2/TRGM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)
P3V3: J1.1, R5.1, SW1.2, U2.3 (VDD); also elsewhere on the board
POWER_REQ: R7.1, U1.37 (PA31/SPI1.DAT3/XPI0.CA_CS0/TRGM0.P07/US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); also elsewhere on the board
SIG_ARM_REQ: R6.1, U1.1 (PA04/URT1.CTS/SPI0.CS0/TRGM0.P04/JTAG.T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); also elsewhere on the board
SPARE_GPIO: TP1.1, U1.19 (PY00/URT0.TXD/USB0.ID/PMIC_PY00/PURT.TX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)
SPI_CS: U1.25 (PB10/TMR0.COMP2/URT2.DE/URT2.RTS/SPI2.C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), U1.42 (PA26/SPI1.CS0/XPI0.CA_D3/TRGM0.P02)
SWD_DIR: U1.38 (PA30/SPI1.DAT2/XPI0.CA_D1/TRGM0.P06/USB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); also elsewhere on the board
SWD_MCU: R1.1, R2.1; also elsewhere on the board
SYS_RESETn: C21.1, J1.6, R5.2, SW2.1, U1.13 (~RESETN), U2.2 (RESETn); also elsewhere on the board
TCK_MCU: U1.24 (PB11/URT2.CTS/SPI2.SCLK/ACMP.COMP1/ADC0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), U1.41 (PA27/SPI1.SCLK/XPI0.CA_SCLK/TRGM0.P03); also elsewhere on the board
TDI_MCU: U1.22 (PB13/TMR1.COMP3/URT3.DE/URT3.RTS/I2C3.S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); also elsewhere on the board
TDO_MCU: U1.23 (PB12/URT3.CTS/I2C3.SDA/SPI2.MISO/TRGM0.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); also elsewhere on the board
UART_A_RX: U1.3 (PA09/TMR0.CAPT1/URT2.RXD/I2C2.SDA/SPI3.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); also elsewhere on the board
UART_A_TX: U1.2 (PA08/TMR0.COMP1/URT2.TXD/I2C2.SCL/SPI3.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); also elsewhere on the board
UART_B_RX: J1.4, U1.11 (PA01/TMR1.CAPT0/URT0.RXD/TRGM0.P01/ACMP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); also elsewhere on the board
UART_B_TX: J1.3, U1.12 (PA00/TMR1.COMP0/URT0.TXD/TRGM0.P00); also elsewhere on the board
USB_DM: U1.43 (PA25/I2C2.SDA/SPI1.CS1/XPI0.CA_DQS/TRGM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); also elsewhere on the board
USB_DP: U1.44 (PA24/I2C2.SCL/SPI1.CS2/XPI0.CA_CS1/TRGM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); also elsewhere on the board
VIO_EN: R8.1, U1.4 (PA10/TMR0.COMP2/URT2.DE/URT2.RTS/SPI3.C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); also elsewhere on the board
XTALI: C1.1, U1.35 (XTALI), Y1.1
XTALO: C2.1, U1.36 (XTALO), Y1.3

Notes on the sheet:
启动配置 / 默认关闭
HSLink-LP 设计审阅稿
基于 HSLink Pro 1.2.0 审阅稿；未完成硬件验证
复位监控与手动复位
晶振 / 24 MHz
服务口：禁止 UART_B 日志输出

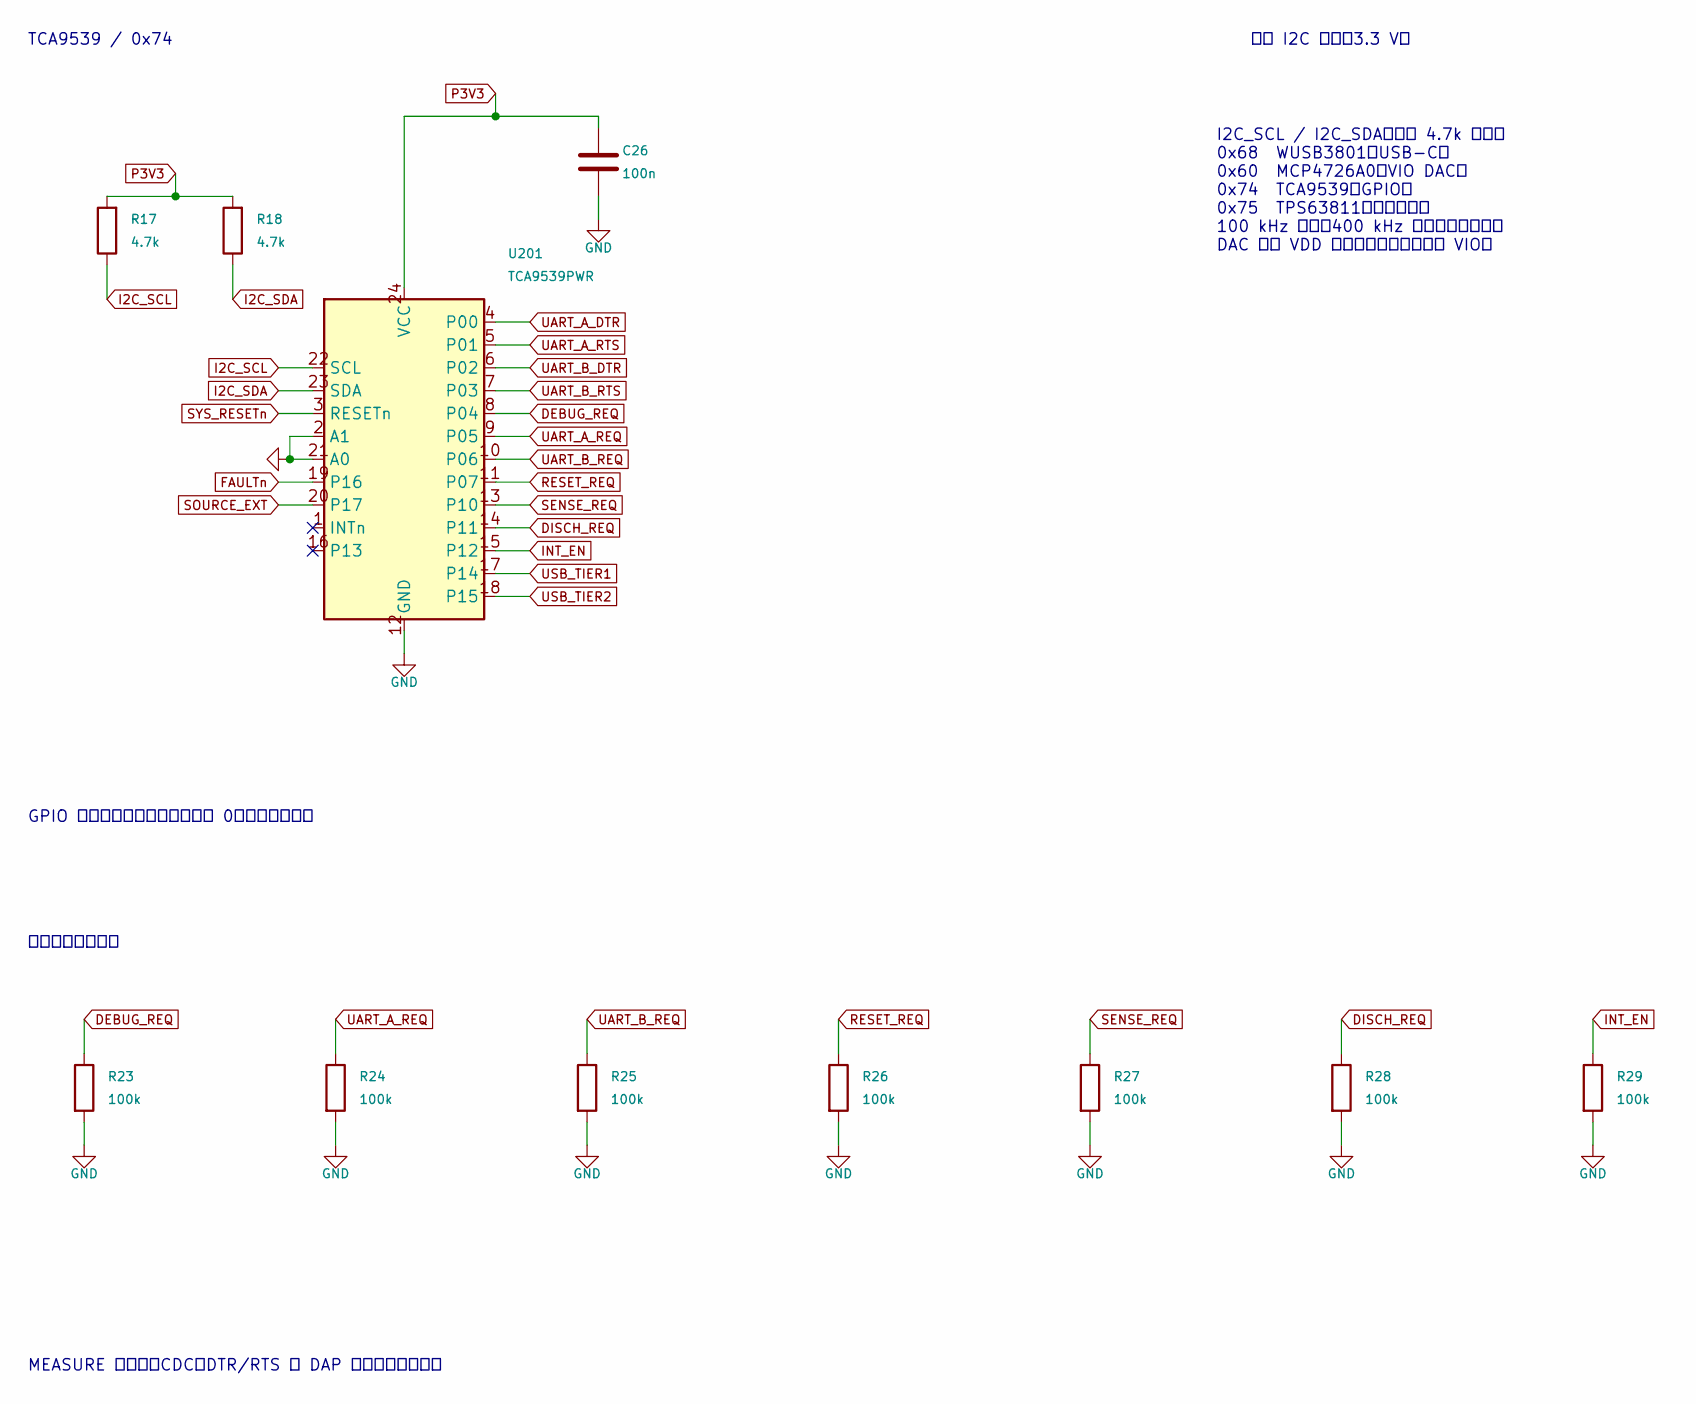
[picture p4: schematic Control.kicad_sch, I2C 扩展与电源配置]

Parts:
C26: 100n; C_0603_1608Metric; MPN CC0603KRX7R9BB104; LCSC C14663
R17, R18: 4.7k; R_0603_1608Metric; MPN 0603WAF4701T5E; LCSC C23162
R23, R24, R25, R26, R27, R28, R29: 100k; R_0603_1608Metric; MPN 0603WAF1003T5E; LCSC C25803
U201: TCA9539PWR; TSSOP-24_4.4x7.8mm_P0.65mm; MPN TCA9539PWR; LCSC C131972

Connections:
DEBUG_REQ: R23.1, U201.8 (P04); also elsewhere on the board
DISCH_REQ: R28.1, U201.14 (P11); also elsewhere on the board
FAULTn: U201.19 (P16); also elsewhere on the board
GND: C26.2, R23.2, R24.2, R25.2, R26.2, R27.2, R28.2, R29.2, U201.2 (A1), U201.12 (GND), U201.21 (A0); also elsewhere on the board
I2C_SCL: R17.1, U201.22 (SCL); also elsewhere on the board
I2C_SDA: R18.1, U201.23 (SDA); also elsewhere on the board
INT_EN: R29.1, U201.15 (P12); also elsewhere on the board
P3V3: C26.1, R17.2, R18.2, U201.24 (VCC); also elsewhere on the board
RESET_REQ: R26.1, U201.11 (P07); also elsewhere on the board
SENSE_REQ: R27.1, U201.13 (P10); also elsewhere on the board
SOURCE_EXT: U201.20 (P17); also elsewhere on the board
SYS_RESETn: U201.3 (RESETn); also elsewhere on the board
UART_A_DTR: U201.4 (P00); also elsewhere on the board
UART_A_REQ: R24.1, U201.9 (P05); also elsewhere on the board
UART_A_RTS: U201.5 (P01); also elsewhere on the board
UART_B_DTR: U201.6 (P02); also elsewhere on the board
UART_B_REQ: R25.1, U201.10 (P06); also elsewhere on the board
UART_B_RTS: U201.7 (P03); also elsewhere on the board
USB_TIER1: U201.17 (P14); also elsewhere on the board
USB_TIER2: U201.18 (P15); also elsewhere on the board

Notes on the sheet:
MEASURE 锁定后，CDC、DTR/RTS 与 DAP 均不得隐式重连。
共享 I2C 总线（3.3 V）
GPIO 默认输入：先写输出寄存器 0，再配置方向。
TCA9539 / 0x74
分组请求默认下拉
I2C_SCL / I2C_SDA：共用 4.7k 上拉。 0x68 WUSB3801（USB-C） 0x60 MCP4726A0（VIO DAC） 0x74 TCA9539（GPIO） 0x75 TPS63811（目标供电） 100 kHz 起步，400 kHz 须验证上升时间。 DAC 使用 VDD 参考，初始化后再使能 VIO。

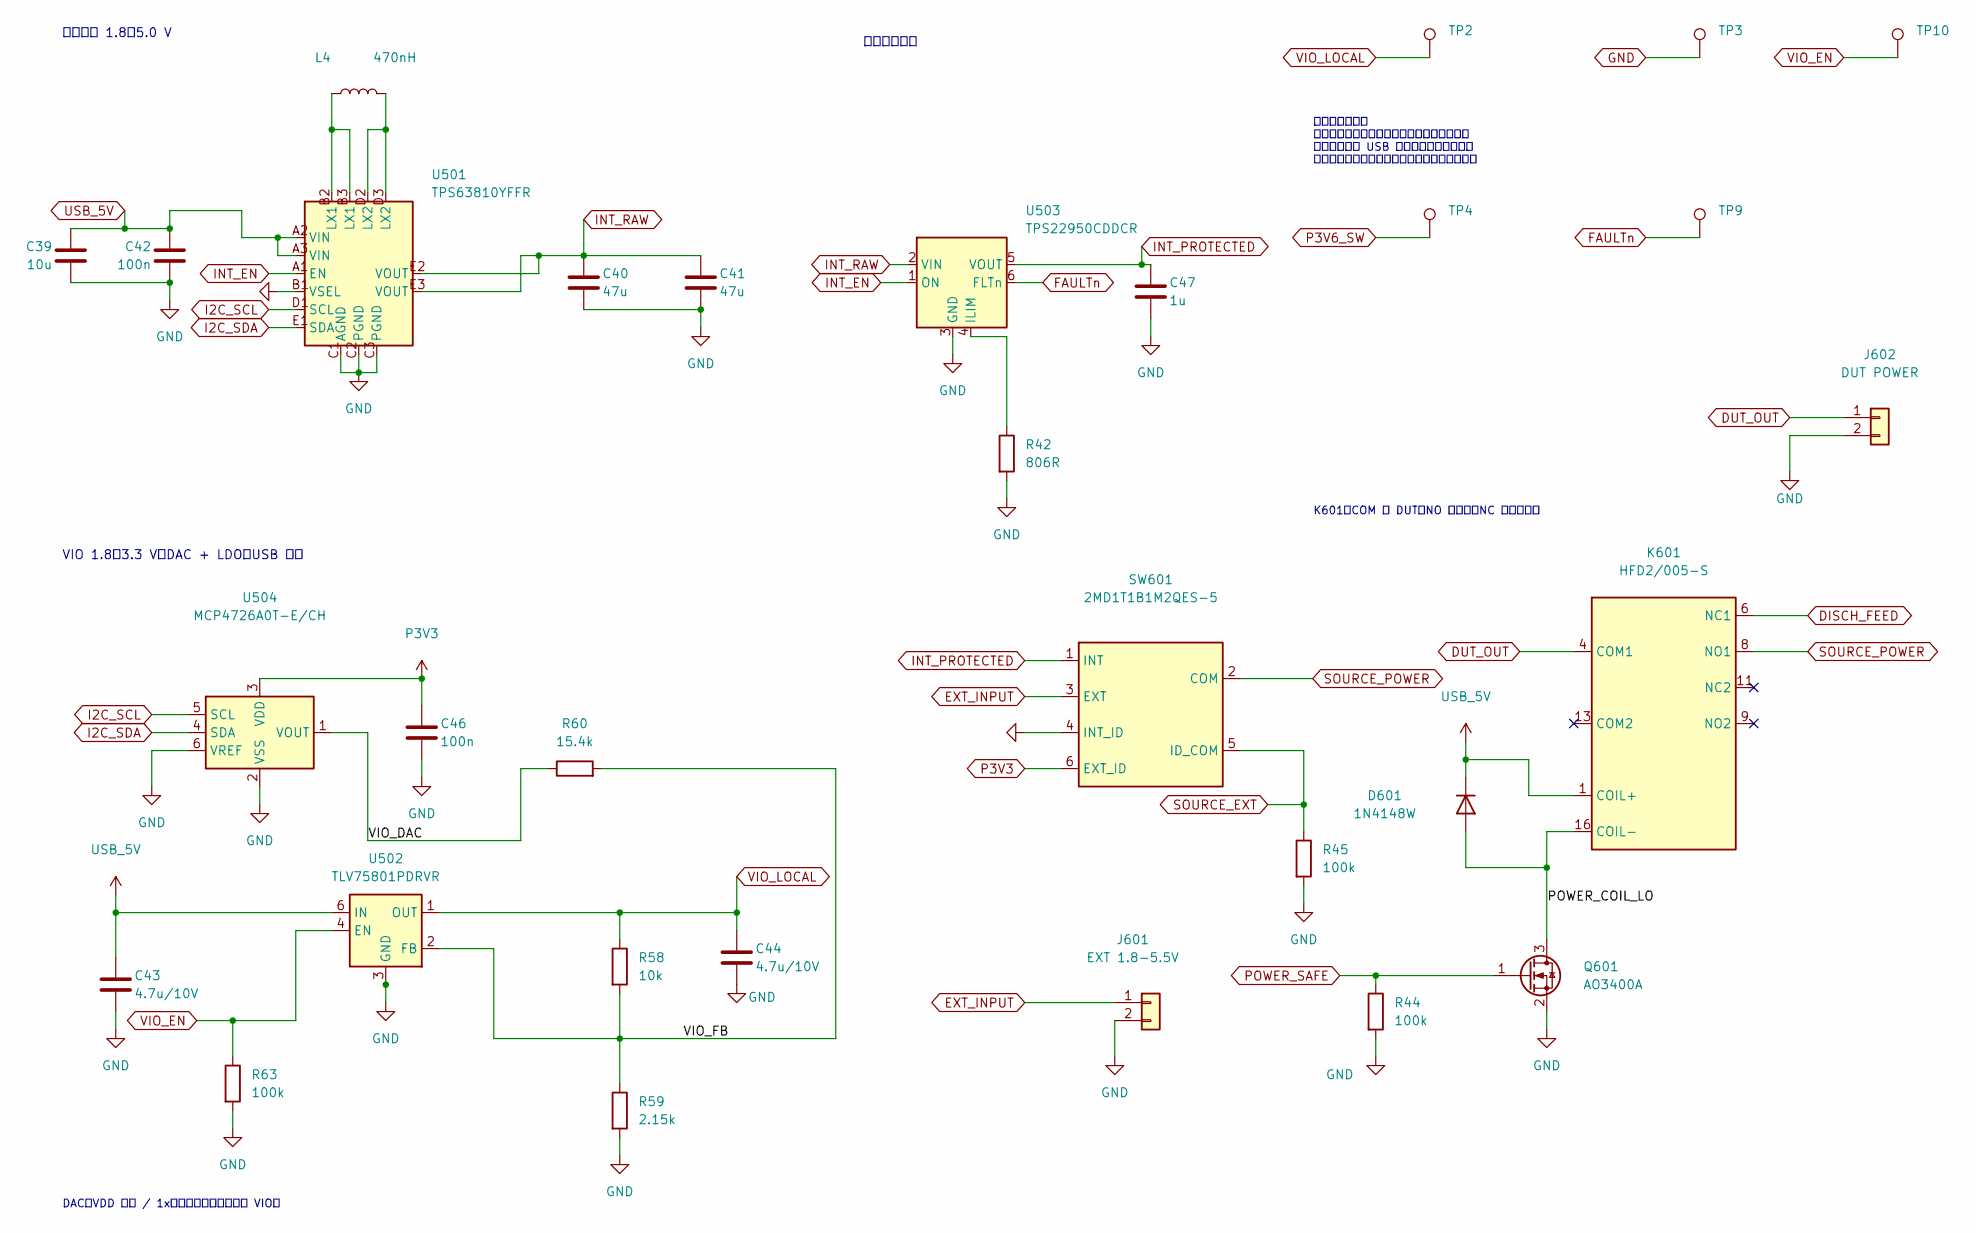
[picture p5: schematic TargetPower.kicad_sch, 可调输出、VIO 与电源选择]

Parts:
C39: 10u; C_0603_1608Metric; MPN CL10A106KP8NNNC; LCSC C19702
C40, C41: 47u; C_1206_3216Metric; MPN CL31A476MPHNNNE; LCSC C96123
C42, C46: 100n; C_0603_1608Metric; MPN CC0603KRX7R9BB104; LCSC C14663
C43, C44: 4.7u/10V; C_0603_1608Metric; MPN TCC0603X7R475K100CT; LCSC C18185770
C47: 1u; C_0603_1608Metric; MPN CL10B105KP8NNNC; LCSC C95843
D601: 1N4148W; D_SOD-123; MPN 1N4148W; LCSC C81598
J601: EXT 1.8-5.5V; TerminalBlock_KEFA_KF128_5.08_1x02; MPN KF128-5.08-2P-AA; LCSC C474952
J602: DUT POWER; TerminalBlock_KEFA_KF128_5.08_1x02; MPN KF128-5.08-2P-AA; LCSC C474952
K601: HFD2/005-S; Relay_Hongfa_HFD2; MPN HFD2/005-S; LCSC C42415145
L4: 470nH; L_Sunlord_MWSA0603S; MPN MWSA0603S-R47MT; LCSC C408439
Q601: AO3400A; SOT-23; MPN AO3400A; LCSC C20917
R42: 806R; R_0603_1608Metric; MPN RT0603BRD07806RL; LCSC C861567
R44, R45, R63: 100k; R_0603_1608Metric; MPN 0603WAF1003T5E; LCSC C25803
R58: 10k; R_0603_1608Metric; Tolerance 0.1%; MPN RT0603BRD0710KL; LCSC C95204
R59: 2.15k; R_0603_1608Metric; Tolerance 0.1%; MPN RT0603BRD072K15L; LCSC C861292
R60: 15.4k; R_0603_1608Metric; Tolerance 0.1%; MPN RT0603BRD0715K4L; LCSC C861142
SW601: 2MD1T1B1M2QES-5; SW_Dailywell_2MD1T1B1M2QES_5; MPN 2MD1T1B1M2QES-5; LCSC C908282
TP2: VIO_LOCAL; TestPoint_Pad_D1.5mm; MPN PCB test pad
TP3: GND; TestPoint_Pad_D1.5mm; MPN PCB test pad
TP4: P3V6_SW; TestPoint_Pad_D1.5mm; MPN PCB test pad
TP9: FAULTn; TestPoint_Pad_D1.5mm; MPN PCB test pad
TP10: VIO_EN; TestPoint_Pad_D1.5mm; MPN PCB test pad
U501: TPS63810YFFR; Texas_YFF0015_1.344x2.255mm_P0.4mm; MPN TPS63810YFFR; LCSC C1852139
U502: TLV75801PDRVR; WSON-6-1EP_2x2mm_P0.65mm_EP1x1.6mm; MPN TLV75801PDRVR; LCSC C2876308
U503: TPS22950CDDCR; SOT-23-6; MPN TPS22950CDDCR; LCSC C7587833
U504: MCP4726A0T-E/CH; SOT-23-6; MPN MCP4726A0T-E/CH; LCSC C191581

Connections:
/内置电源、VIO 与输出来源选择/POWER_COIL_LO: D601.2 (A), K601.16 (COIL-), Q601.3 (D)
/内置电源、VIO 与输出来源选择/VIO_DAC: R60.1, U504.1 (VOUT)
/内置电源、VIO 与输出来源选择/VIO_FB: R58.2, R59.1, R60.2, U502.2 (FB)
DISCH_FEED: K601.6 (NC1); also elsewhere on the board
DUT_OUT: J602.1, K601.4 (COM1)
EXT_INPUT: J601.1, SW601.3 (EXT)
FAULTn: TP9.1, U503.6 (FLTn); also elsewhere on the board
GND: C39.2, C40.2, C41.2, C42.2, C43.2, C44.2, C46.2, C47.2, J601.2, J602.2, Q601.2 (S), R42.2, R44.2, R45.2, R59.2, R63.2, SW601.4 (INT_ID), TP3.1, U501.B1 (VSEL), U501.C1 (AGND), U501.C2 (PGND), U501.C3 (PGND), U502.3 (GND), U502.7 (GND), U503.3 (GND), U504.2 (VSS), U504.6 (VREF); also elsewhere on the board
I2C_SCL: U501.D1 (SCL), U504.5 (SCL); also elsewhere on the board
I2C_SDA: U501.E1 (SDA), U504.4 (SDA); also elsewhere on the board
INT_EN: U501.A1 (EN), U503.1 (ON); also elsewhere on the board
INT_PROTECTED: C47.1, SW601.1 (INT), U503.5 (VOUT)
INT_RAW: C40.1, C41.1, U501.E2 (VOUT), U501.E3 (VOUT), U503.2 (VIN)
unnamed: L4.1, U501.B2 (LX1), U501.B3 (LX1)
unnamed: L4.2, U501.D2 (LX2), U501.D3 (LX2)
unnamed: R42.1, U503.4 (ILIM)
P3V3: C46.1, SW601.6 (EXT_ID), U504.3 (VDD); also elsewhere on the board
P3V6_SW: TP4.1; also elsewhere on the board
POWER_SAFE: Q601.1 (G), R44.1; also elsewhere on the board
SOURCE_EXT: R45.1, SW601.5 (ID_COM); also elsewhere on the board
SOURCE_POWER: K601.8 (NO1), SW601.2 (COM)
USB_5V: C39.1, C42.1, C43.1, D601.1 (K), K601.1 (COIL+), U501.A2 (VIN), U501.A3 (VIN), U502.6 (IN); also elsewhere on the board
VIO_EN: R63.1, TP10.1, U502.4 (EN); also elsewhere on the board
VIO_LOCAL: C44.1, R58.1, TP2.1, U502.1 (OUT); also elsewhere on the board

Notes on the sheet:
内置支路限流
内置输出 1.8～5.0 V
电源操作与验证 先关输出，再切来源；外部限流由仪器承担。 继电器线圈由 USB 供电，测量保持共地。 电流能力、触点压降及微小电流可靠性待实测。
DAC：VDD 参考 / 1x；写入并回读后再使能 VIO。
VIO 1.8～3.3 V：DAC + LDO（USB 侧）
K601：COM 接 DUT；NO 接来源；NC 接放电支路

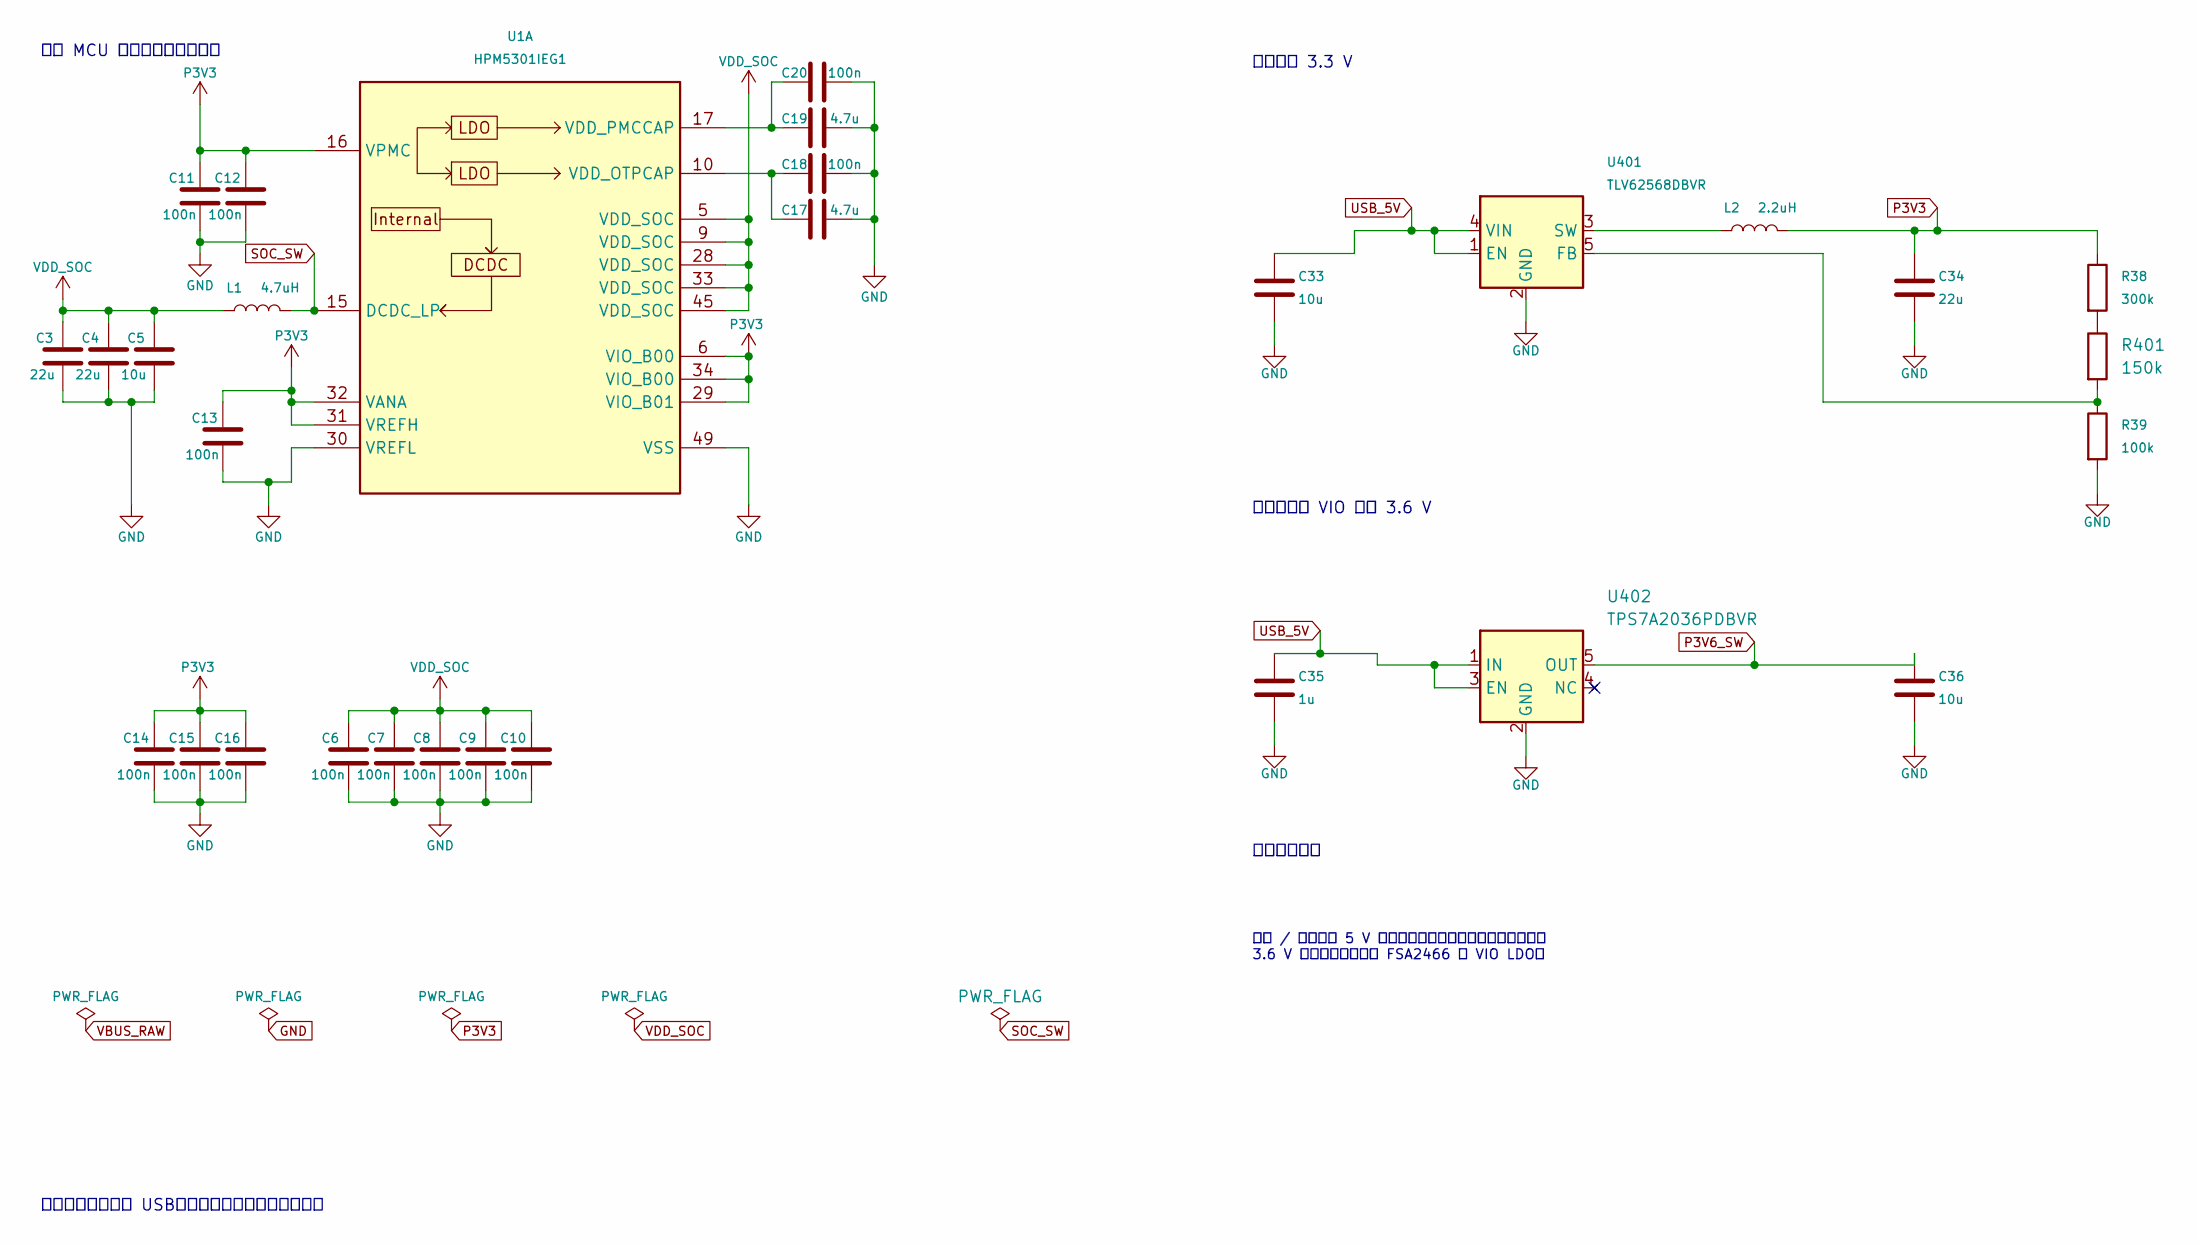
[picture p6: schematic Power.kicad_sch, 主控与 USB 辅助电源]

Parts:
C3, C4, C34: 22u; C_0603_1608Metric; MPN CL10A226MP8NUNE; LCSC C86295
C5, C33, C36: 10u; C_0603_1608Metric; MPN CL10A106KP8NNNC; LCSC C19702
C6, C7, C8, C9, C10, C11, C12, C13, C14, C15, C16, C18, C20: 100n; C_0603_1608Metric; MPN CC0603KRX7R9BB104; LCSC C14663
C17, C19: 4.7u; C_0603_1608Metric; MPN TCC0603X7R475K100CT; LCSC C18185770
C35: 1u; C_0603_1608Metric; MPN CL10B105KP8NNNC; LCSC C95843
L1: 4.7uH; L_Sunlord_SPH4018; MPN SPH4018H4R7MT; LCSC C98400
L2: 2.2uH; L_Sunlord_SPH4018; MPN SPH4018H2R2MT; LCSC C370436
R38: 300k; R_0603_1608Metric; MPN 0603WAF3003T5E; LCSC C23024
R39: 100k; R_0603_1608Metric; MPN 0603WAF1003T5E; LCSC C25803
R401: 150k; R_0603_1608Metric; MPN 0603WAF1503T5E; LCSC C22807
U1: HPM5301IEG1; QFN-48-1EP_6x6mm_P0.4mm_EP4.2x4.2mm; MPN HPM5301IEG1; LCSC C49451864
U401: TLV62568DBVR; SOT-23-5; MPN TLV62568DBVR; LCSC C163219
U402: TPS7A2036PDBVR; SOT-23-5; MPN TPS7A2036PDBVR; LCSC C2873626

Connections:
GND: C3.2, C4.2, C5.2, C6.2, C7.2, C8.2, C9.2, C10.2, C11.2, C12.2, C13.2, C14.2, C15.2, C16.2, C17.2, C18.2, C19.2, C20.2, C33.2, C34.2, C35.2, C36.2, R39.2, U1.30 (VREFL), U1.49 (VSS), U401.2 (GND), U402.2 (GND); also elsewhere on the board
unnamed: R38.2, R401.1
unnamed: C17.1, C18.1, U1.10 (VDD_OTPCAP)
unnamed: C19.1, C20.1, U1.17 (VDD_PMCCAP)
unnamed: R39.1, R401.2, U401.5 (FB)
unnamed: L2.1, U401.3 (SW)
P3V3: C11.1, C12.1, C13.1, C14.1, C15.1, C16.1, C34.1, L2.2, R38.1, U1.6 (VIO_B00), U1.16 (VPMC), U1.29 (VIO_B01), U1.31 (VREFH), U1.32 (VANA), U1.34 (VIO_B00); also elsewhere on the board
P3V6_SW: C36.1, U402.5 (OUT); also elsewhere on the board
SOC_SW: L1.2, U1.15 (DCDC_LP)
USB_5V: C33.1, C35.1, U401.1 (EN), U401.4 (VIN), U402.1 (IN), U402.3 (EN); also elsewhere on the board
VDD_SOC: C3.1, C4.1, C5.1, C6.1, C7.1, C8.1, C9.1, C10.1, L1.1, U1.5 (VDD_SOC), U1.9 (VDD_SOC), U1.28 (VDD_SOC), U1.33 (VDD_SOC), U1.45 (VDD_SOC)

Notes on the sheet:
上游 MCU 电源单元与去耦布局
控制电源 3.3 V
检测 / 放电改为 5 V 机械继电器，已删除本分区升压电路。 3.6 V 辅助电源同时供给 FSA2466 与 VIO LDO。
所有辅助电流取自 USB；不进入外部仪器测量路径。
辅助电源说明
信号开关与 VIO 前级 3.6 V

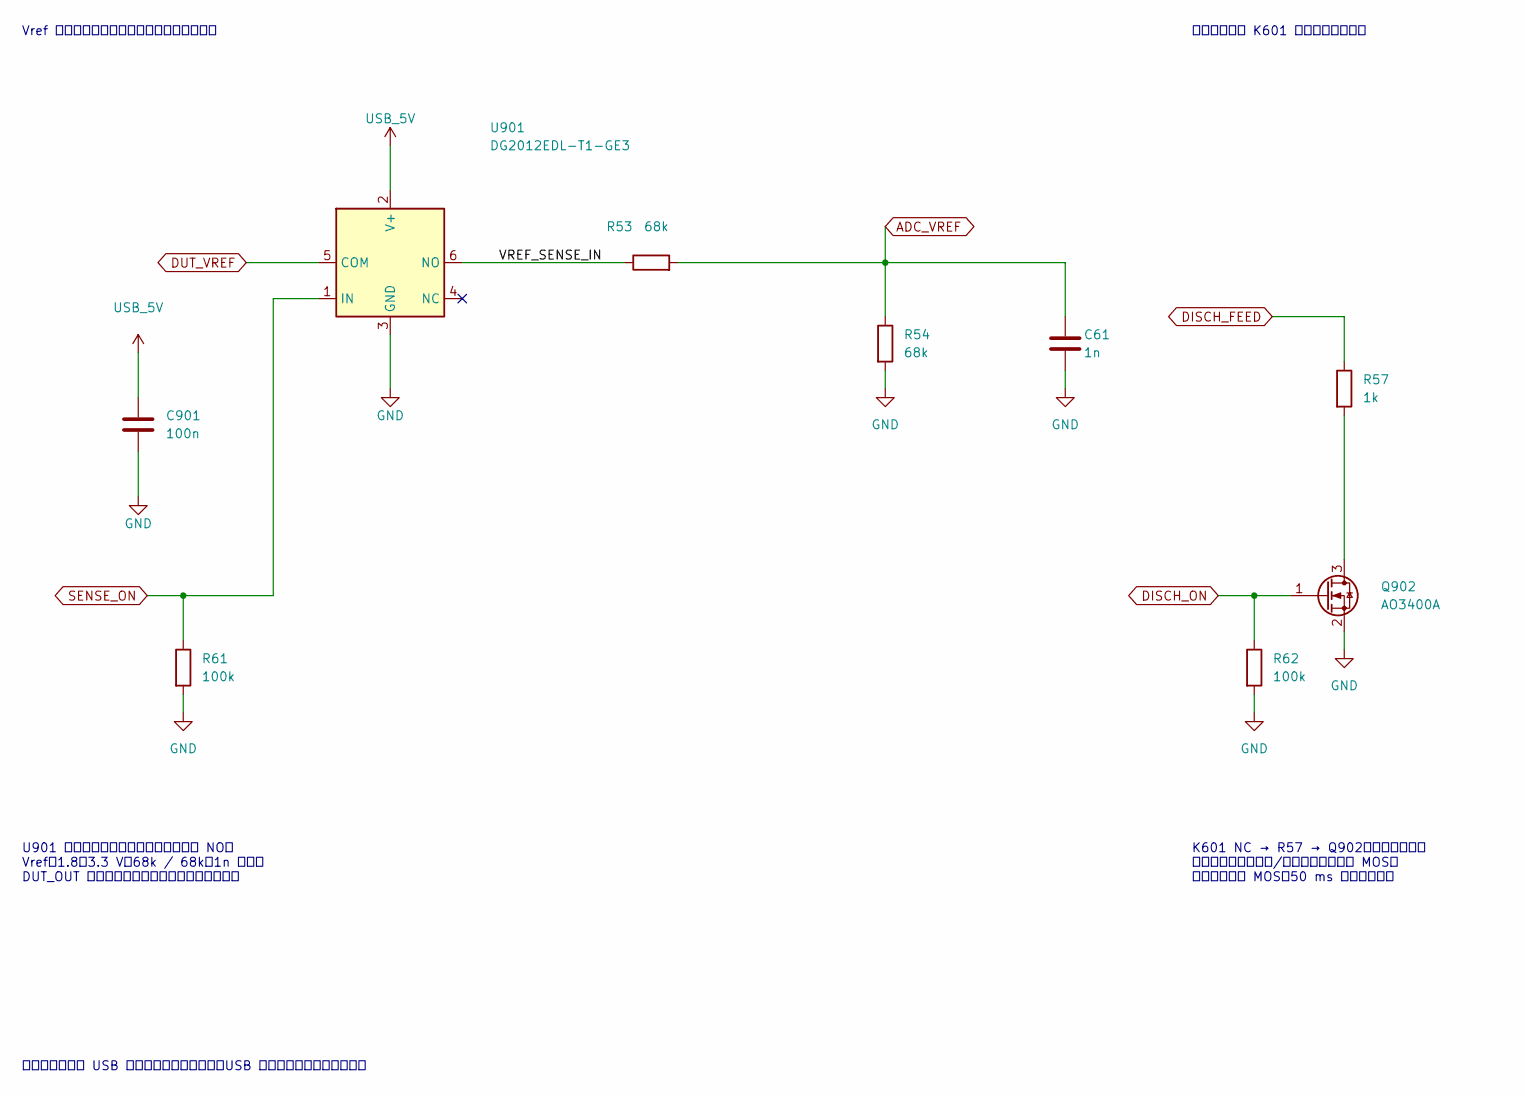
[picture p7: schematic Sense.kicad_sch, Vref 检测与受控放电]

Parts:
C61: 1n; C_0603_1608Metric; MPN CL10B102KB8NNNC; LCSC C1588
C901: 100n; C_0603_1608Metric; MPN CC0603KRX7R9BB104; LCSC C14663
Q902: AO3400A; SOT-23; MPN AO3400A; LCSC C20917
R53, R54: 68k; R_0603_1608Metric; Tolerance 0.1%; MPN RT0603BRD0768KL; LCSC C705793
R57: 1k; R_0603_1608Metric; MPN 0603WAF1001T5E; LCSC C21190
R61, R62: 100k; R_0603_1608Metric; MPN 0603WAF1003T5E; LCSC C25803
U901: DG2012EDL-T1-GE3; SOT-363_SC-70-6; MPN DG2012EDL-T1-GE3; LCSC C2673178

Connections:
/可断开检测与目标放电/VREF_SENSE_IN: R53.1, U901.6 (NO)
ADC_VREF: C61.1, R53.2, R54.1; also elsewhere on the board
DISCH_FEED: R57.1; also elsewhere on the board
DISCH_ON: Q902.1 (G), R62.1; also elsewhere on the board
DUT_VREF: U901.5 (COM); also elsewhere on the board
GND: C61.2, C901.2, Q902.2 (S), R54.2, R61.2, R62.2, U901.3 (GND); also elsewhere on the board
unnamed: Q902.3 (D), R57.2
SENSE_ON: R61.1, U901.1 (IN); also elsewhere on the board
USB_5V: C901.1, U901.2 (V+); also elsewhere on the board

Notes on the sheet:
Vref 检测：单通道模拟开关隔离完整采样支路
U901 默认断开；仅显式允许检测时接通 NO。 Vref：1.8～3.3 V；68k / 68k，1n 滤波。 DUT_OUT 电压回读已取消；设定值不是实测值。
开关与继电器由 USB 侧供电；地线保持共地。USB 掉电与整板漏电均待实测。
受控放电：由 K601 常闭触点机械隔离
K601 NC → R57 → Q902：仅显式放电。 先断供电，等待释放/抖动稳定，再使能 MOS。 恢复供电先关 MOS；50 ms 为待测初值。
