sanchuanhehe/HSLink-LP/(commit log)

2026-11-04 chore: initialize HSLink-LP project
    [candidates.csv]
2026-11-05 chore: preserve initial schematic draft in git history
    [01_mcu.kicad_sch, 02_mcu_power.kicad_sch, 03_usb.kicad_sch, 04_control.kicad_sch, 05_safety.kicad_sch, 06_aux_power.kicad_sch, 07_adjustable.kicad_sch, 08_target_power.kicad_sch]
2026-11-05 chore: consolidate KiCad project and clean workspace
    统一当前 KiCad 工程路径，旧版通过 Git 历史回溯；保存候选 BOM、设计说明和验证摘要。移除临时工具与缓存，补齐忽略规则，记录用户目录中的 MCP 安装。原理图源文件哈希不变，迁移后 ERC 与实际网表检查通过。
    [01_mcu.kicad_sch, 02_mcu_power.kicad_sch, 03_usb.kicad_sch, 04_control.kicad_sch, 05_safety.kicad_sch, 06_aux_power.kicad_sch, 07_adjustable.kicad_sch, 08_target_power.kicad_sch]
2026-11-05 fix: correct schematic label overlaps and symbol graphics
    [Control.kicad_sch, Disconnect.kicad_sch, HSLink-LP.kicad_sch, Interface.kicad_sch, LogicTranslation.kicad_sch, Power.kicad_sch, Safety.kicad_sch, Sense.kicad_sch]
2026-11-06 降低供电与检测电路成本并更新原理图验证记录
    [HSLink-LP.kicad_sch, Power.kicad_sch, Sense.kicad_sch, TargetPower.kicad_sch, candidates.csv]
2026-11-06 修正主控预算，移除 I2C 多路器并替换 VIO DAC
    [Control.kicad_sch, TargetPower.kicad_sch, candidates.csv]
2026-11-06 按嘉立创核价落实换料并记录电平转换时序边界
    [Control.kicad_sch, Disconnect.kicad_sch, HSLink-LP.kicad_sch, Interface.kicad_sch, LogicTranslation.kicad_sch, Power.kicad_sch, Safety.kicad_sch, Sense.kicad_sch]
2026-11-07 结合上游固件修正 SWD 采样窗口与电平转换降本评估
2026-11-07 Adopt twelve LVC1T45 translators and update prototype cost verification
    [LogicTranslation.kicad_sch, Safety.kicad_sch, candidates.csv]
2026-11-07 Complete JLC BOM pricing and adopt keyed ARM20 target interface
    [Disconnect.kicad_sch, HSLink-LP.kicad_sch, Interface.kicad_sch, Power.kicad_sch, Sense.kicad_sch, TargetPower.kicad_sch, accessories.csv, candidates.csv]
2026-11-07 Reuse power relay NC contact for controlled discharge and document sensing tradeoffs
    [Sense.kicad_sch, TargetPower.kicad_sch, candidates.csv]
2026-11-07 Isolate Vref with DG2012E and remove DUT voltage readback
    [HSLink-LP.kicad_sch, Sense.kicad_sch, candidates.csv]
2026-11-07 Normalize project to KiCad 10 and verify unchanged connectivity
    [Control.kicad_sch, Disconnect.kicad_sch, HSLink-LP.kicad_sch, Interface.kicad_sch, LogicTranslation.kicad_sch, Power.kicad_sch, Safety.kicad_sch, Sense.kicad_sch]
2026-11-07 Sync accepted support limits and document open electrical margins
    [Control.kicad_sch, Disconnect.kicad_sch, Power.kicad_sch, accessories.csv, candidates.csv]
2026-11-07 Improve VIO adjustment headroom and document calibrated accuracy target
    [TargetPower.kicad_sch, candidates.csv]
2026-11-07 Adopt 806-ohm R42 prototype with mandatory load and protection qualification
    [TargetPower.kicad_sch, candidates.csv]
2026-11-08 Refactor schematic components and update properties in Sense and TargetPower designs
    - Adjusted wire connections in Sense schematic for improved clarity.
    - Updated descriptions and properties in TargetPower schematic for accuracy, including voltage and current specifications.
    - Removed redundant junctions and wires to streamline the design.
    - Corrected component values, MPNs, and LCSC codes for several resistors and capacitors.
    - Enhanced documentation with clearer descriptions and specifications for components.
    [Control.kicad_sch, Disconnect.kicad_sch, HSLink-LP.kicad_sch, Interface.kicad_sch, LogicTranslation.kicad_sch, Power.kicad_sch, Safety.kicad_sch, Sense.kicad_sch]
2026-11-11 Restore power margins and add scoped SPICE functional validation
    [HSLink-LP.kicad_sch, TargetPower.kicad_sch]
2026-11-11 Establish four-layer PCB placement and critical power routing
    [HSLink-LP.kicad_pcb]
2026-11-11 Reorganize PCB placement and add structure C engineering models
    [HSLink-LP.kicad_pcb, hslink_lp_base.step, hslink_lp_base.stl, hslink_lp_lid.dxf, hslink_lp_lid.step, hslink_lp_lid.stl, mechanical.csv]
2026-11-11 Add calibration and interlock test points with validation plan
    [HSLink-LP.kicad_sch, Safety.kicad_sch, TargetPower.kicad_sch, candidates.csv, pcb-features.csv]
2026-11-11 Align front interfaces and place calibration test pads
    [HSLink-LP.kicad_pcb, pcb-features.csv]
2026-11-12 Define four-layer stackup and complete local ground returns
    [HSLink-LP.kicad_pcb]
2026-11-12 Route core and auxiliary supplies, crystal and controlled USB pair
    [HSLink-LP.kicad_pcb]
2026-11-12 Refine enclosure clearance, USB relief and lid geometry
    [hslink_lp_base.step, hslink_lp_base.stl, hslink_lp_lid.dxf, hslink_lp_lid.step, hslink_lp_lid.stl, mechanical.csv]
2026-11-12 Add C-style SVG panel artwork and assembly print layer
2026-11-12 Round lid notch entrances with tangent outline corners
    [hslink_lp_lid.dxf, hslink_lp_lid.step, hslink_lp_lid.stl]
2026-11-12 Preserve panel print colors in FreeCAD STEP import
2026-11-12 Rework U1 staggered I/O fanout with scoped signal vias
    [HSLink-LP.kicad_pcb]
2026-11-12 Route debug signal paths and reset driver with verified returns
    [HSLink-LP.kicad_pcb]
2026-11-12 Route target reset and dual UART paths with local ground returns
    [HSLink-LP.kicad_pcb]
2026-11-12 Route USB control and partial I2C with checked ground returns
    [HSLink-LP.kicad_pcb]
2026-11-12 Route boot, reset and analog controls with checked MCU exits
    [HSLink-LP.kicad_pcb]
2026-11-12 Route interlock controls and refine MCU exits with checked returns
    [HSLink-LP.kicad_pcb]
2026-11-12 Complete MCU power and VIO controls with scoped via checks
    [HSLink-LP.kicad_pcb]
2026-11-12 Route UART A MCU sources with scoped signal vias and checked returns
    [HSLink-LP.kicad_pcb]
2026-11-12 Complete UART B MCU routing and restore local ground returns
    [HSLink-LP.kicad_pcb]
2026-11-12 Connect maintenance RX and power interlock branches with checked returns
    [HSLink-LP.kicad_pcb]
2026-11-13 Normalize signal routing to 45 degrees and connect local controls
    [HSLink-LP.kicad_pcb]
2026-11-13 Complete Vref and control routing with zero unconnected nets
    Preserve protected signal and power geometry, verify pad-net parity and GND returns, refresh structure C assembly envelopes and validation evidence.
    [HSLink-LP.kicad_pcb]
2026-11-13 Fix manufacturing placement metadata and strengthen mechanical checks
    [HSLink-LP.kicad_pcb]
2026-11-14 Constrain PA28 and PA29 netclass patterns across KiCad saves
2026-11-14 Record cable geometry gaps and qualified replacement limits
